EnesAyaz/WPTMotor/Thesis/Visio/chapter-3/MotorDrive.pptx

Drive

Sensor

Electrical
Source

Power
Converter

Controller

Load

## Slide 2

Motor Drive

Measurement Unit

DC
Source

Converter
(DC/DC) (DC/AC)

Controller

Load

## Slide 3

+

DC

DC/DC
Converter

ωref

+

Speed Controller

+

Current Controller

D

Load

IA

ω

+-

## Slide 4

Voltage
Source

DC/DC
Converter

ωref

+

Speed Controller

+

Current Controller

D

Load

IA

ω

## Slide 5

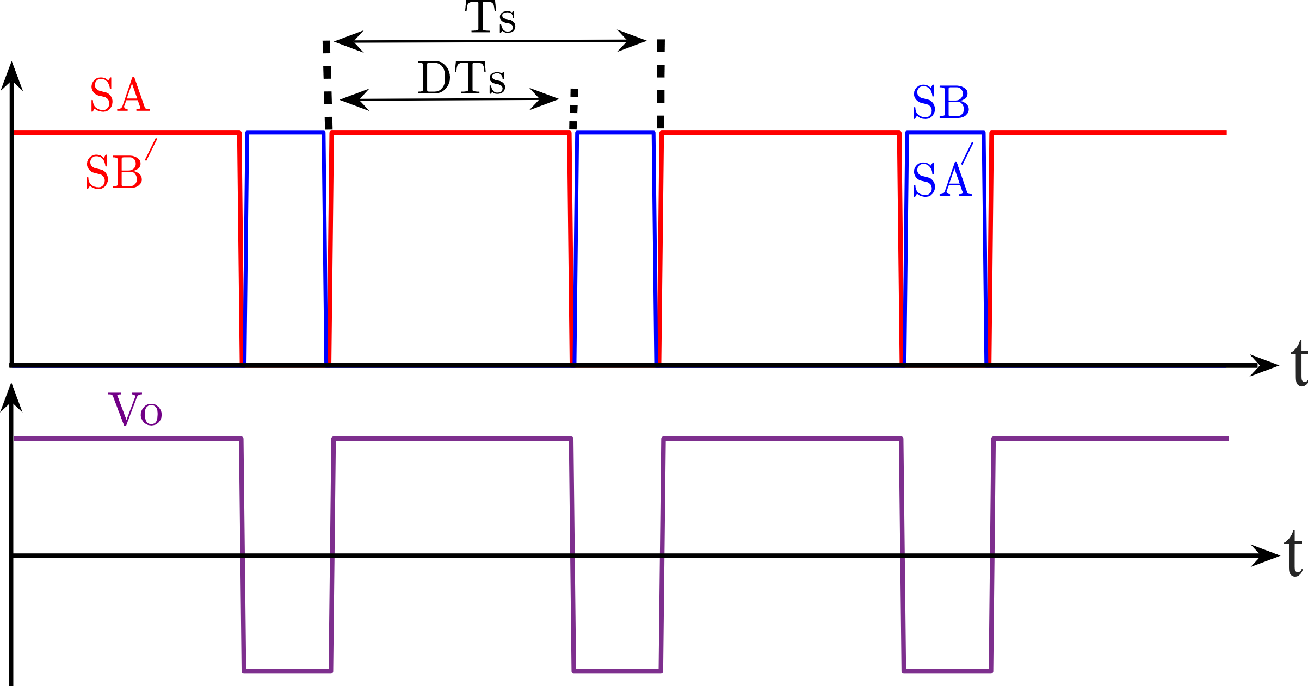
[picture p9: figure]

## Slide 6

Idref

+

Iqref

DC

DC/AC
Converter

ωeref

+

Speed Controller

+

Current Controller

Modulator

Load

Id

Iq

abc/dq

Ia

Ib

d/dt

Ic

ωe

θe

p

θm

## Slide 7

Idref

+

Iqref

Voltage
Source

ωeref

+

Speed Controller

+

Current Controller

Modulator

DC/AC
Converter

Load

Id

Iq

abc/dq

Ia

Ib

d/dt

Ic

ωe

θe

p

θm

## Slide 8

Constant T

T

Constant P

P

ωbase

ωmax

[rad/sec]

## Slide 9

T

T

Constant T

Constant P

P

ωs

[rad/sec]

## Slide 10

T

T

Constant T

Constant P

Increasing ωs

P

[rad/sec]

## Slide 11

[kW]

[kHz]

## Slide 12

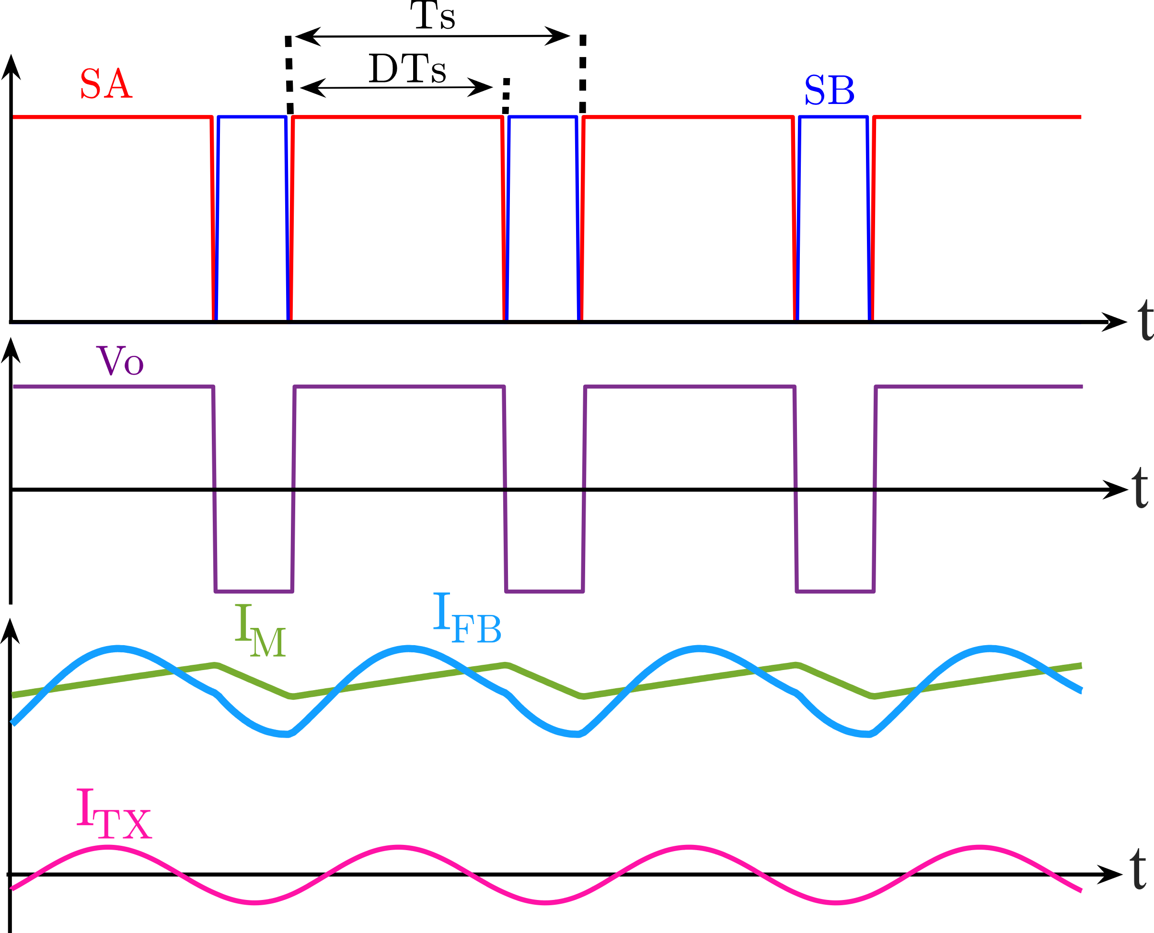
[picture p10: figure]

Switching
States

Output Voltage

Currents
