EnesAyaz/WPTMotor/Monthly-Presentation/2023.01.09.pptx

A set of Wireless and Wired Power Transfer Systems
Studies

Enes Ayaz
10/01/2023

## Previously on the 30-min Presentation

Motor drives have more than 2 wires
Conventional WPT systems have 2 wires input

Multi-phase WPT systems

Motivations:
1. To increase DC-link utilization rate
2. To increase power
3. To break the restrictions

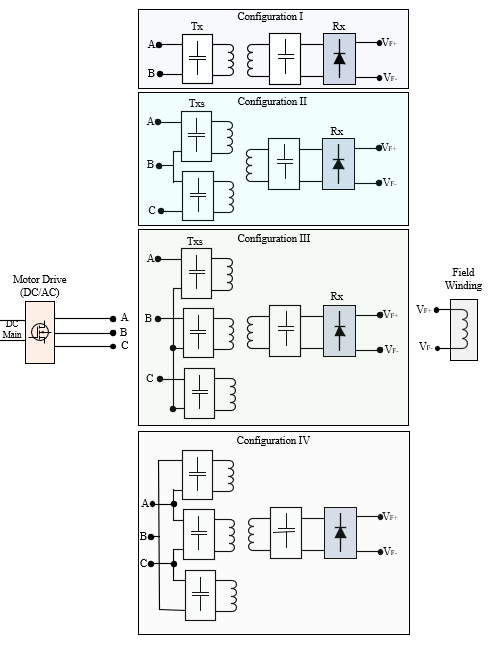
[picture p46: figure]

Notes: The WPT system is connected between phase-A and phase B.

By carrier phase shift to phase B, we achieve this contour of the magnitude of the switching frequency.

We can observe that we can have a constant gain for any modulation.

The constant gain is between 0.25 and 0.45 over a DC-link voltage.

The control diagram is shown.

We adjust the carrier phase shift according to modulation to control the WPT power.

## Future Works

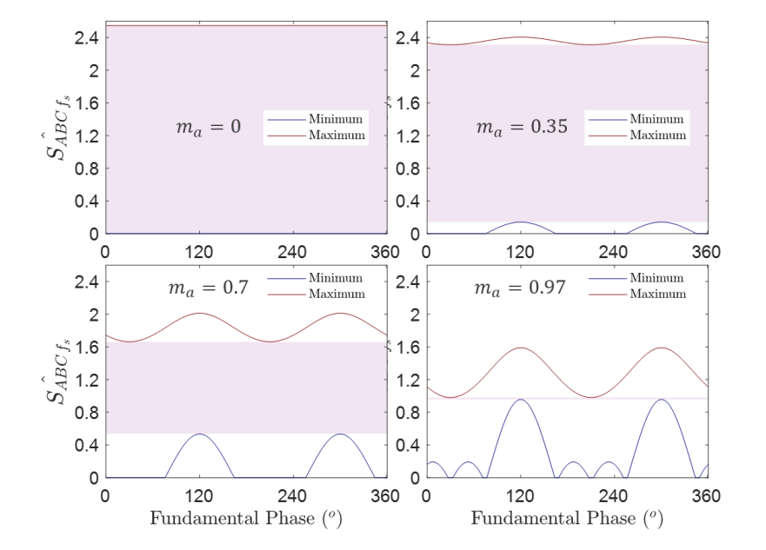
[picture p47: figure]
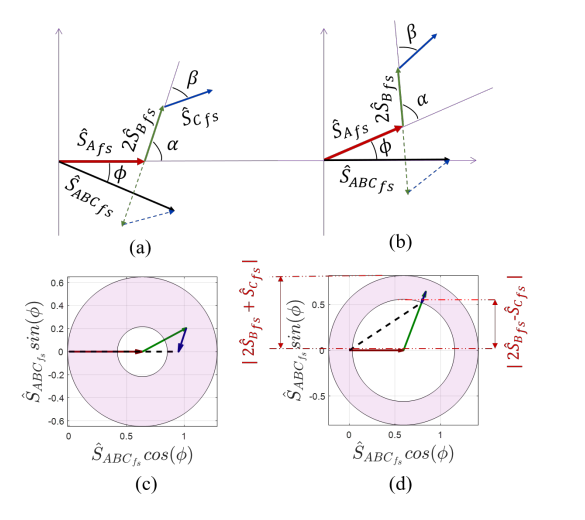
[picture p48: figure]

Notes: The WPT system is connected between phase-A and phase B.

By carrier phase shift to phase B, we achieve this contour of the magnitude of the switching frequency.

We can observe that we can have a constant gain for any modulation.

The constant gain is between 0.25 and 0.45 over a DC-link voltage.

The control diagram is shown.

We adjust the carrier phase shift according to modulation to control the WPT power.

## Challenge- Calculation Burden!

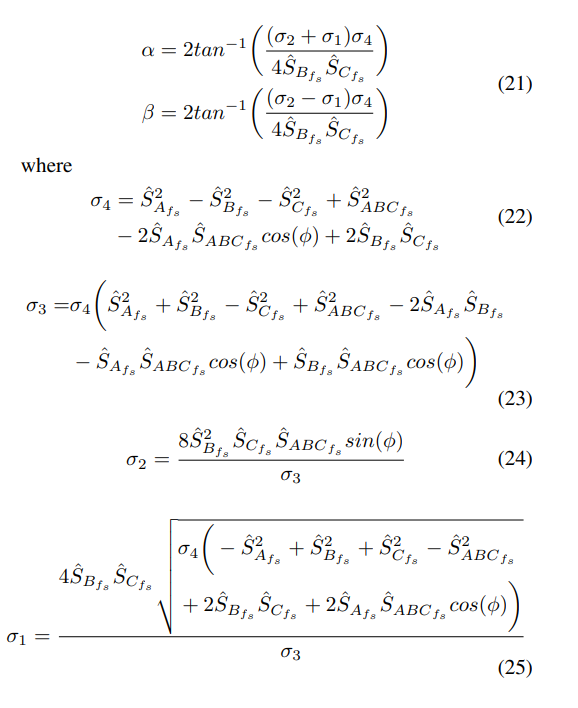
[picture p49: figure]
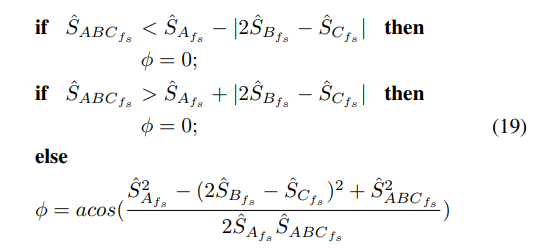
[picture p50: figure]

Notes: The WPT system is connected between phase-A and phase B.

By carrier phase shift to phase B, we achieve this contour of the magnitude of the switching frequency.

We can observe that we can have a constant gain for any modulation.

The constant gain is between 0.25 and 0.45 over a DC-link voltage.

The control diagram is shown.

We adjust the carrier phase shift according to modulation to control the WPT power.

## Variable Carrier Phase Shift Method for Integrated Contactless Field Excitation System of Electrically Excited Synchronous Motors

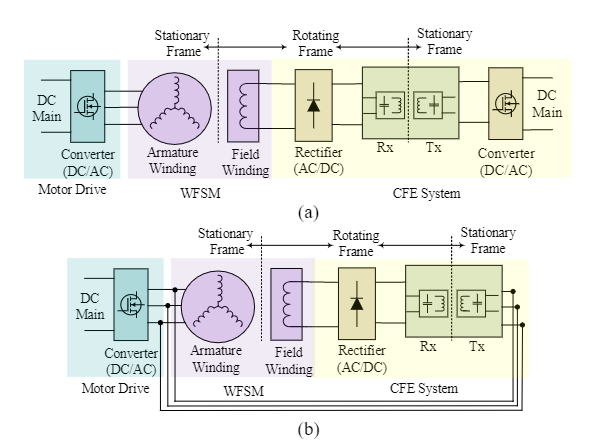
[picture p51: figure]

The circuit diagram of a conventional and proposed CFE based on a WPT system for EESMs.
a) The conventional system. b) The proposed system.

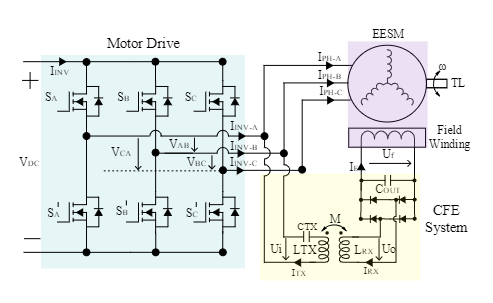
[picture p52: figure]

The circuit diagram of the proposed system

Notes: The WPT system is connected between phase-A and phase B.

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

We can observe that we can have a constant gain for any modulation.

The constant gain is between 0.25 and 0.45 over a DC-link voltage.

The control diagram is shown.

We adjust the carrier phase shift according to modulation to control the WPT power.

## Variable Carrier Phase Shift- Time Domain Analysis

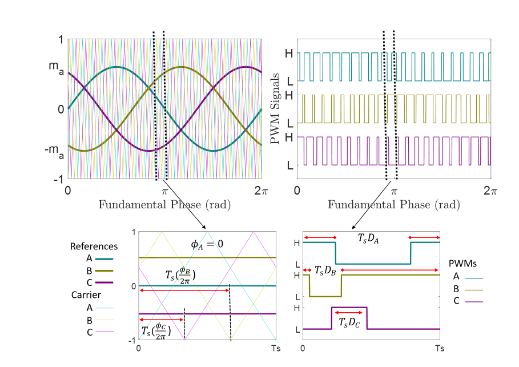
[picture p53: figure]
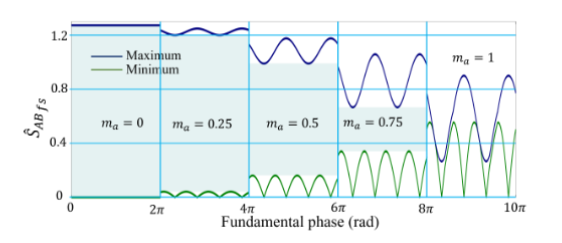
[picture p54: figure]
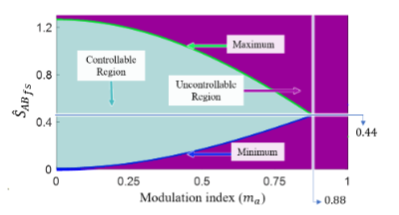
[picture p55: figure]
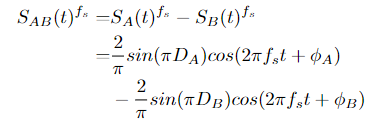
[picture p56: figure]

## Multifrequency IPT Systems

Standards:
- Wireless Power Consortium (WPC)
- Power Matters Alliance (PMA)
- Alliance for Wireless Power (A4WP)

100 - 205/300 kHz for magnetic resonant and induction technology for mobile devices; WPT systems for consumer devices, power transfer typically < 200 W; plan to be used worldwide

6765 - 6795 kHz for magnetic resonant technology for mobile devices; WPT systems for consumer devices, power transfer typically < 30 W; plan to be used.

300 - 500 kHz: WPT systems for consumer devices, power transfer typically < 5 W; plan to be used for smaller devices.

900 - 1 000 kHz: WPT systems for consumer devices, power transfer typically < 5 W; plan to be used for smaller devices.

Motivations:
1. To Increase power
2. To reduce switching components
3. To increase DC-link utilization rate
4. To provide operation for more than one standards
Some Topologies:
1. Multi-converter and multi-resonant
2. Single-converter and multi-resonant
3. Single-converter and multi-load

Notes: The WPT system is connected between phase-A and phase B.

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

We can observe that we can have a constant gain for any modulation.

The constant gain is between 0.25 and 0.45 over a DC-link voltage.

The control diagram is shown.

We adjust the carrier phase shift according to modulation to control the WPT power.

## Narrowband Concurrent Wireless Power Transfer (For use of single standard range)

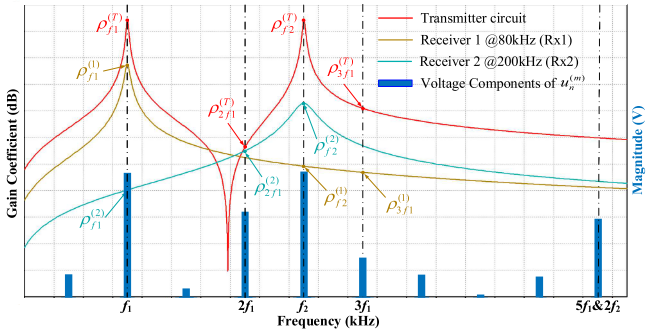
[picture p57: figure]
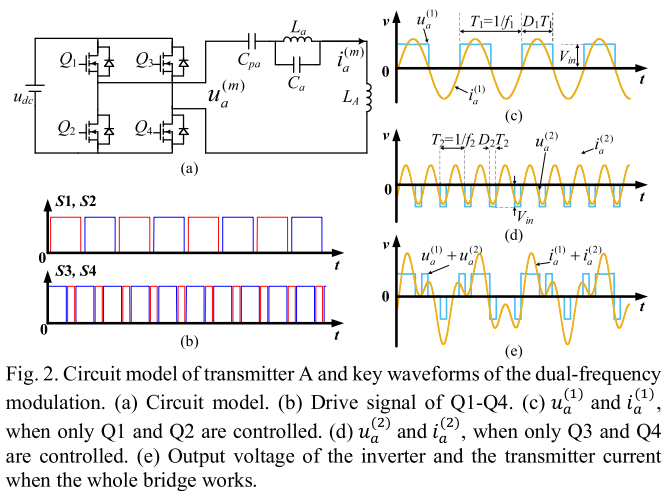
[picture p58: figure]

A Dual-Frequency Three-Dimensional WPT System with Directional Power Transfer
Capability at Two Separately Regulated Outputs

Notes: The WPT system is connected between phase-A and phase B.

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

We can observe that we can have a constant gain for any modulation.

The constant gain is between 0.25 and 0.45 over a DC-link voltage.

The control diagram is shown.

We adjust the carrier phase shift according to modulation to control the WPT power.

## Narrowband Concurrent Wireless Power Transfer (For use of single standard range)

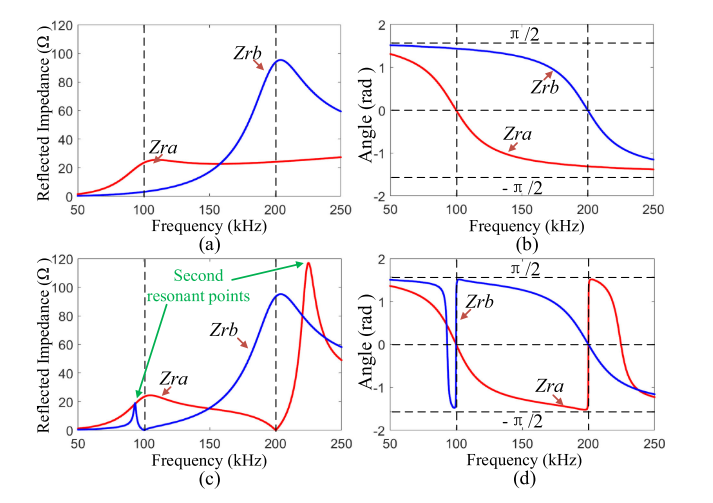
[picture p59: figure]
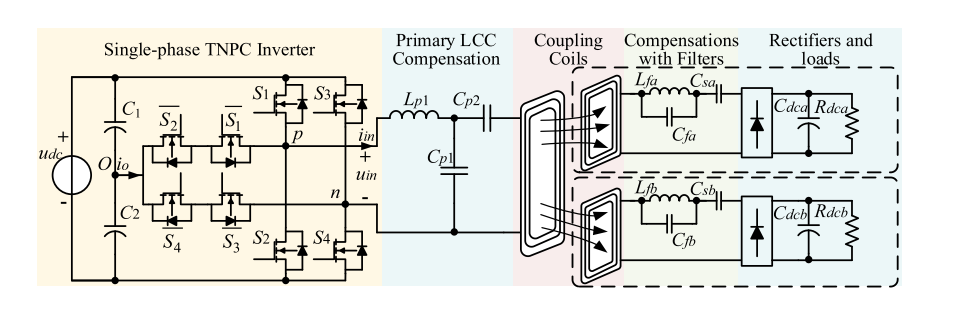
[picture p60: figure]

Design and Control of a Decoupled Multichannel Wireless Power Transfer System Based on Multilevel Inverters

## Narrowband Concurrent Wireless Power Transfer

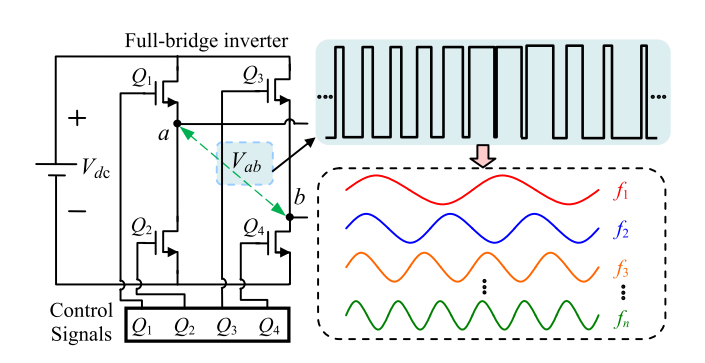
[picture p61: figure]

Multi-Frequency Multi-Amplitude Superposition Modulation Method With Phase Shift Optimization for Single Inverter of Wireless Power Transfer System

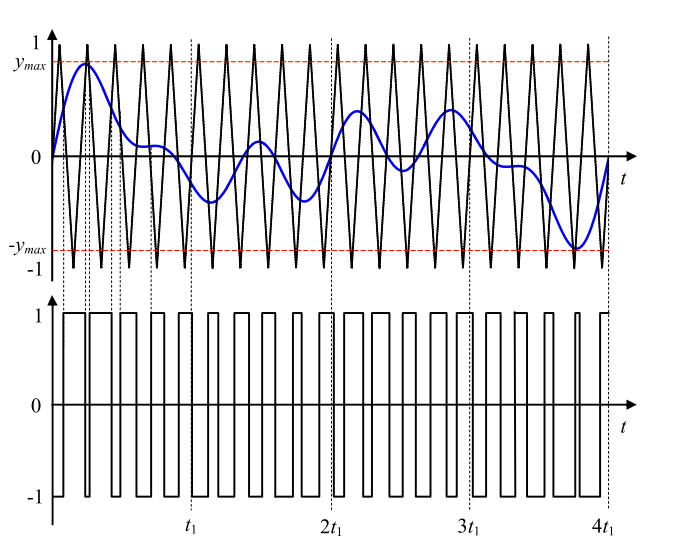
[picture p62: figure]

## Wideband Concurrent Wireless Power Transfer

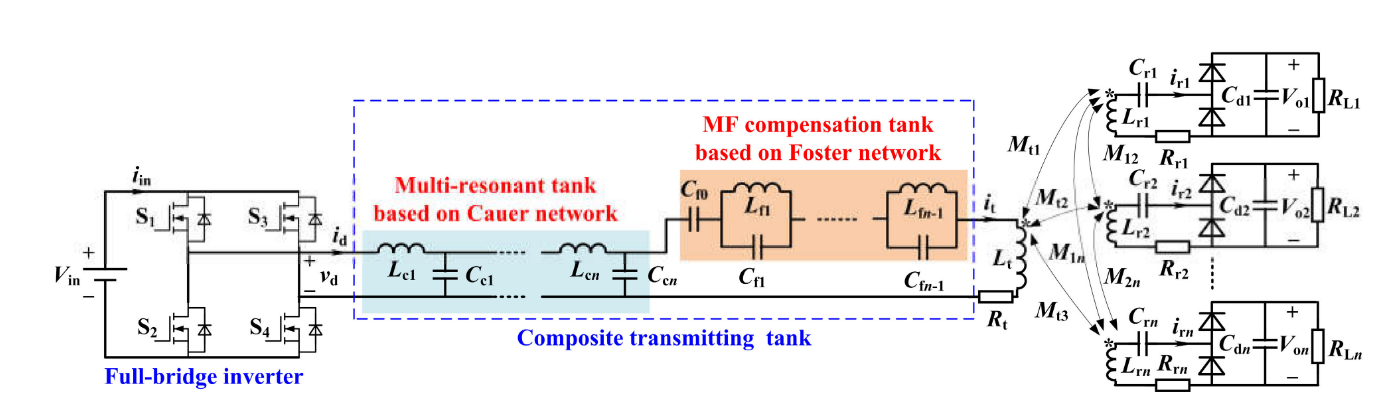
[picture p63: figure]

Multi-Frequency Multi-Amplitude Superposition Modulation Method With Phase Shift Optimization for Single Inverter of Wireless Power Transfer System

## Narrowband / Wideband Concurrent Wireless Power Transfer

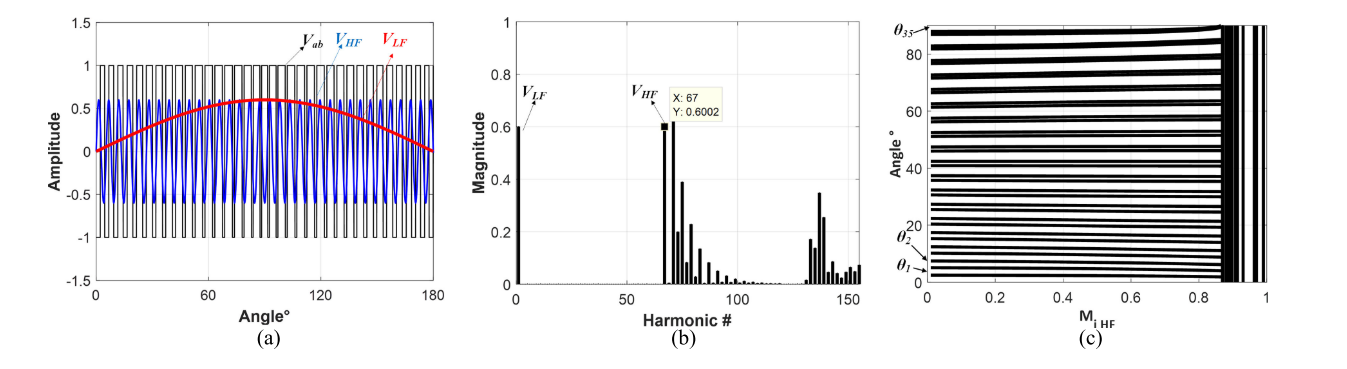
[picture p64: figure]
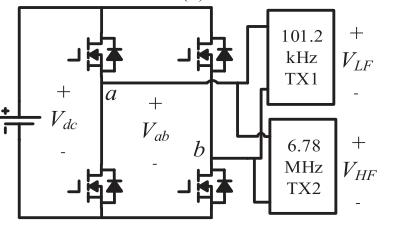
[picture p65: figure]
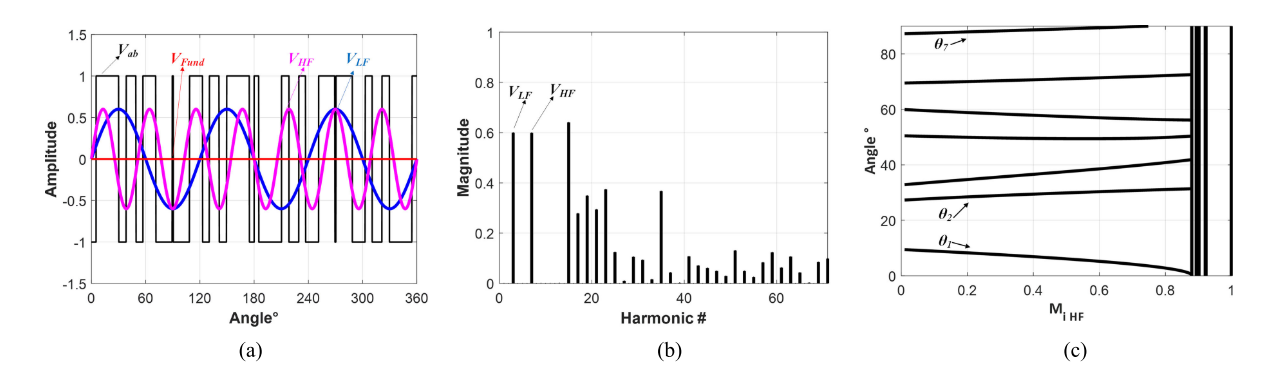
[picture p66: figure]

GaN-Based Dual-Mode Wireless Power Transfer Using Multifrequency Programmed Pulse Width Modulation

## Narrowband and Wideband Concurrent Wireless Power Transfer using a Single Transmitter

SPWM

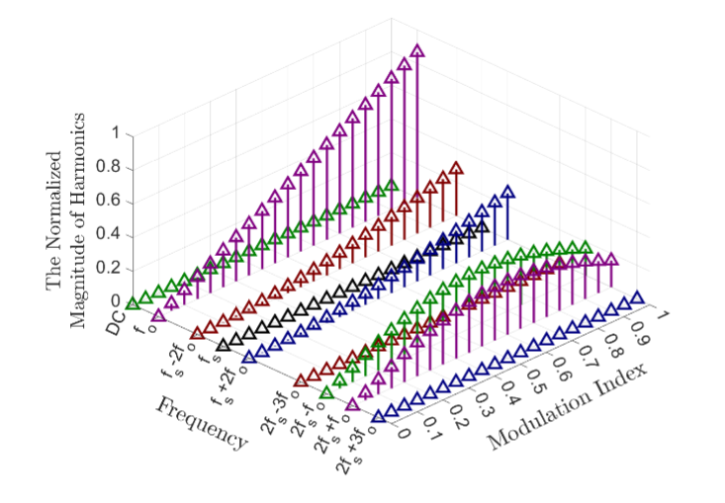
[picture p67: figure]
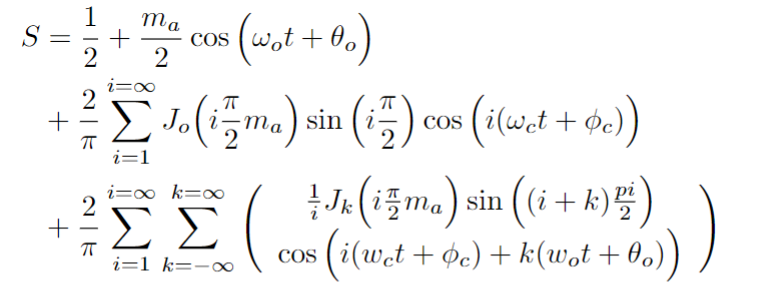
[picture p68: figure]

Notes: The WPT system is connected between phase-A and phase B.

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

We can observe that we can have a constant gain for any modulation.

The constant gain is between 0.25 and 0.45 over a DC-link voltage.

The control diagram is shown.

We adjust the carrier phase shift according to modulation to control the WPT power.

## Slide 14

Wideband Concurrent Wireless Power

f_(sh) =6980 kHz

f_(sl) =6580 kHz

f_(sw) =6780 kHz

Control parameters :
- Modulation index
- Carrier phase shift

f_o =100 kHz

f_0

f_(sl)

f_(sw)

f_(sh)

V_(f_0) =m_a

V_(f_(sw)) =2/πJ_o ((m_a π)/2)√(1−cos⁡(Δφ_(carrier) ))

## Slide 15

Narrowband Concurrent Wireless Power

f_o =120 kHz

f_o =80 kHz

f_o =160 kHz

Control parameters :
- Modulation index
- Carrier phase shift
- Fundamental phase shift

f_o =20 kHz

f_0

f_(sl)

f_(sw)

f_(sh)

f_0 =20 kHz

f_(sh) =160 kHz

V_(f_(sw)) =2/πJ_o ((m_a π)/2)√(1−cos⁡(Δφ_(carrier) ))

V_(f_(sl)) =2/πJ_o ((m_a π)/2)√(1−cos⁡(Δφ_(carrier) +Δφ_(fundamental) ))

f_(sl) =80 kHz

f_(sw) =120 kHz

## Slide 16

Additional Narrowband/Wideband Concurrent Wireless Power for HB configuration

f_0

f_(sw)

120
kHz

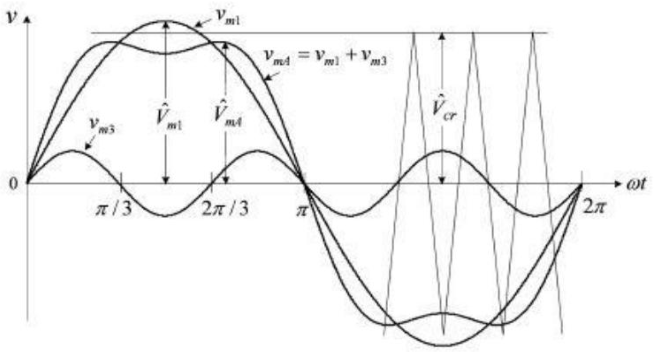
[picture p69: figure]

3f_0

60
kHz

f_(sl)

80
kHz

f_(sh)

160
kHz

20
kHz

Narrow Band

HB:
It is not possible to introduce carrier or fundamental phase shifts

Control parameters :
- Fundamental modulation index
- Harmonic modulation index (3rd , 5th , 7th )

100
kHz

300
kHz

6680
kHz

6780
kHz

6880
kHz

Wide Band

## Balancing with Soft-Magnetic Material based Inductors

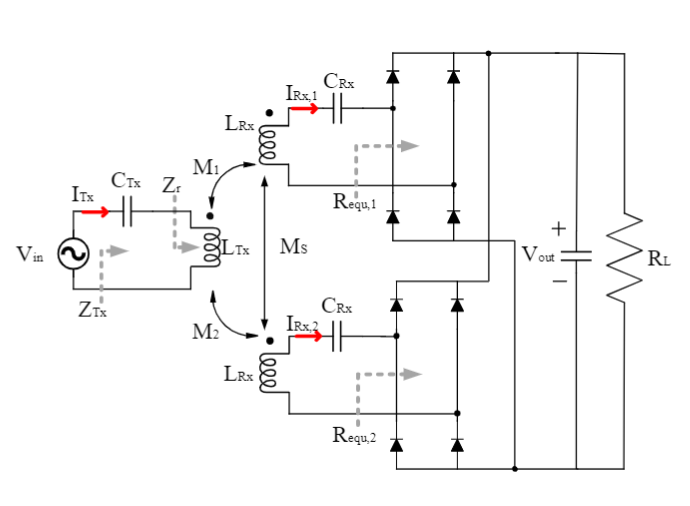
[picture p70: figure]
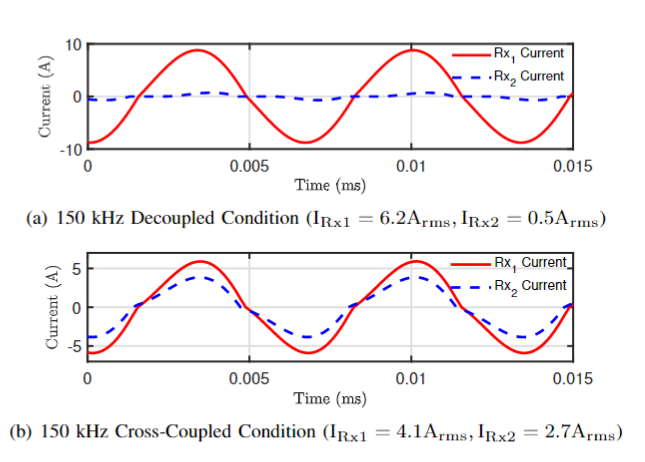
[picture p71: figure]
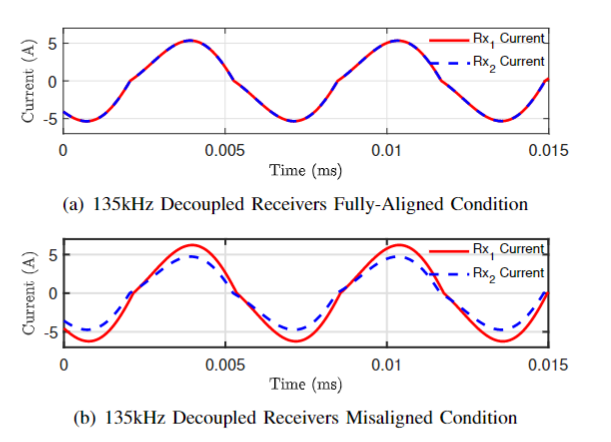
[picture p72: figure]

Intentional de-tuning of the receiver resonant tank for unbalanced modules

Notes: The WPT system is connected between phase-A and phase B.

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

We can observe that we can have a constant gain for any modulation.

The constant gain is between 0.25 and 0.45 over a DC-link voltage.

The control diagram is shown.

We adjust the carrier phase shift according to modulation to control the WPT power.

## Balancing with Soft-Magnetic Material based Inductors

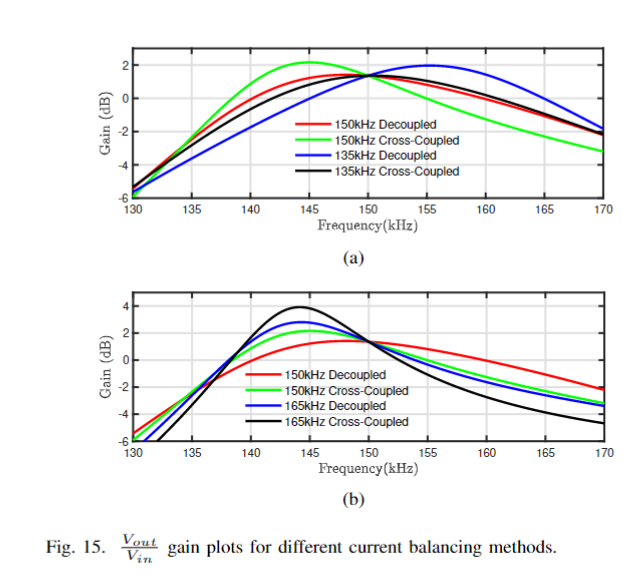
[picture p73: figure]
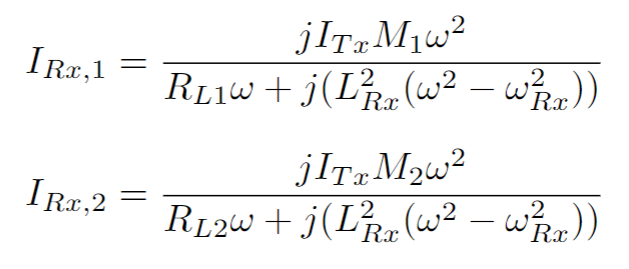
[picture p74: figure]

Notes: The WPT system is connected between phase-A and phase B.

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

We can observe that we can have a constant gain for any modulation.

The constant gain is between 0.25 and 0.45 over a DC-link voltage.

The control diagram is shown.

We adjust the carrier phase shift according to modulation to control the WPT power.

## Slide 19

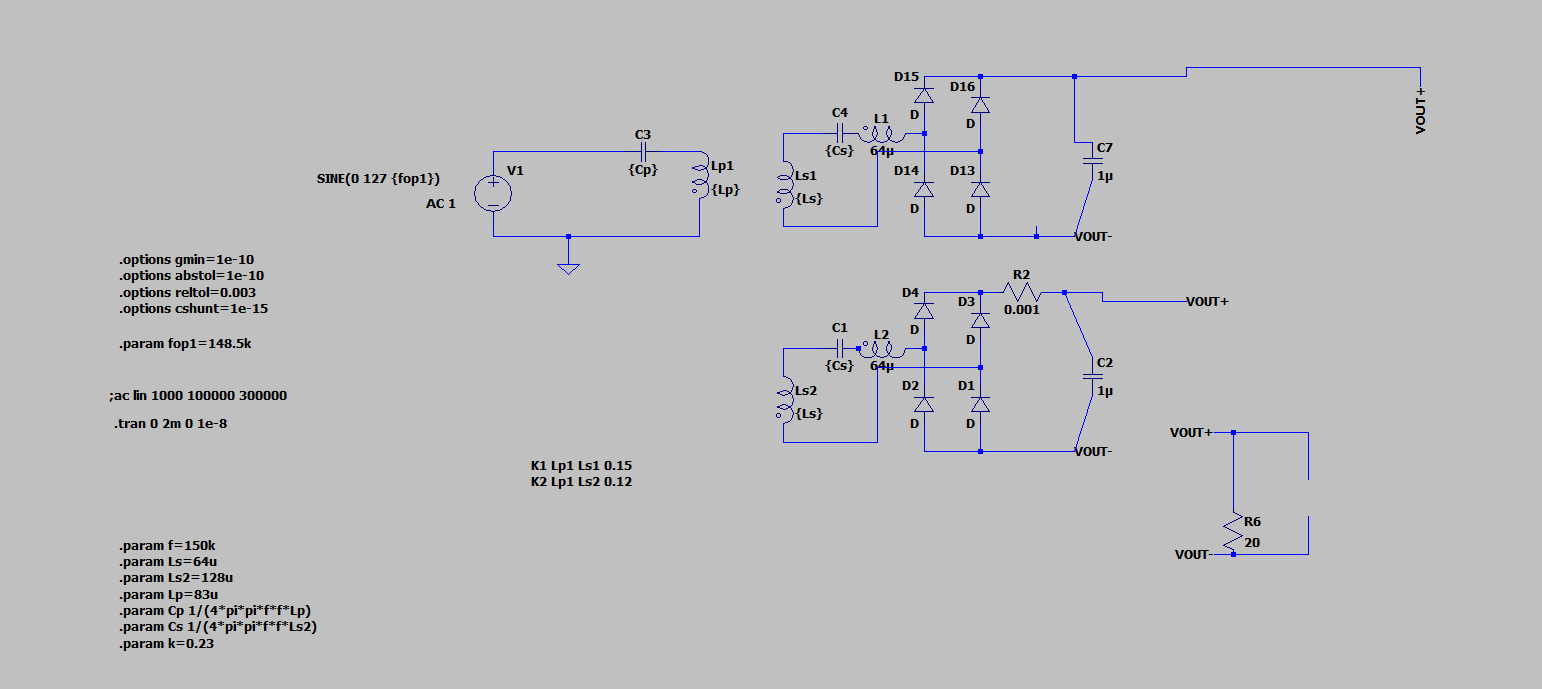
[picture p75: figure]
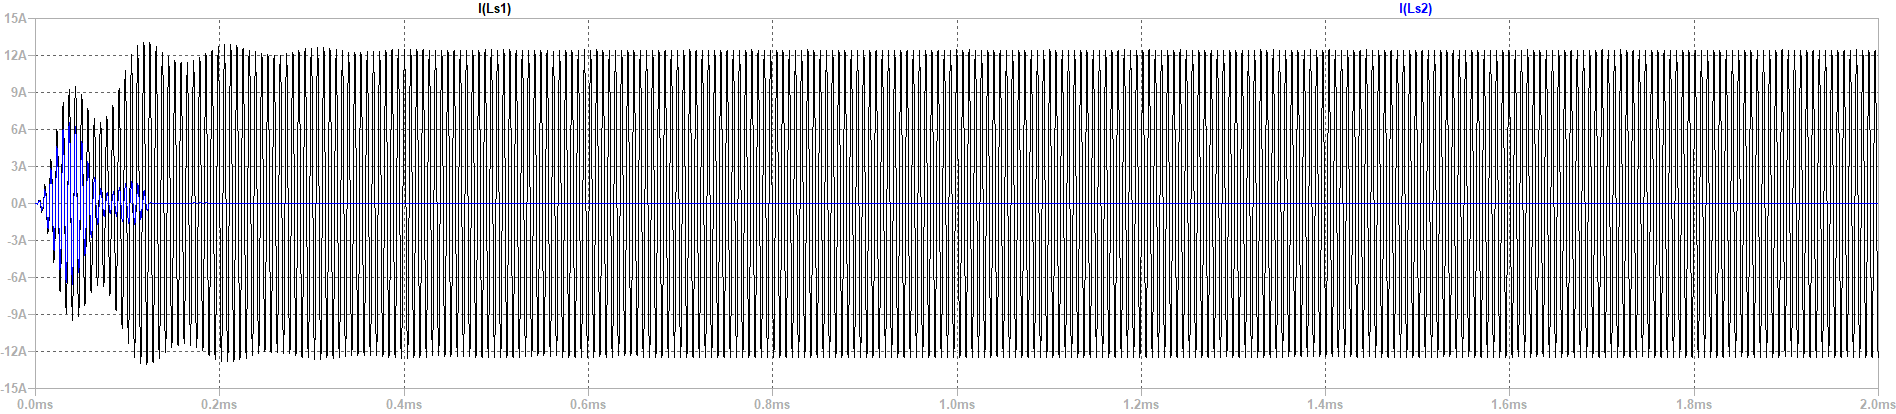
[picture p76: figure]

## Slide 20

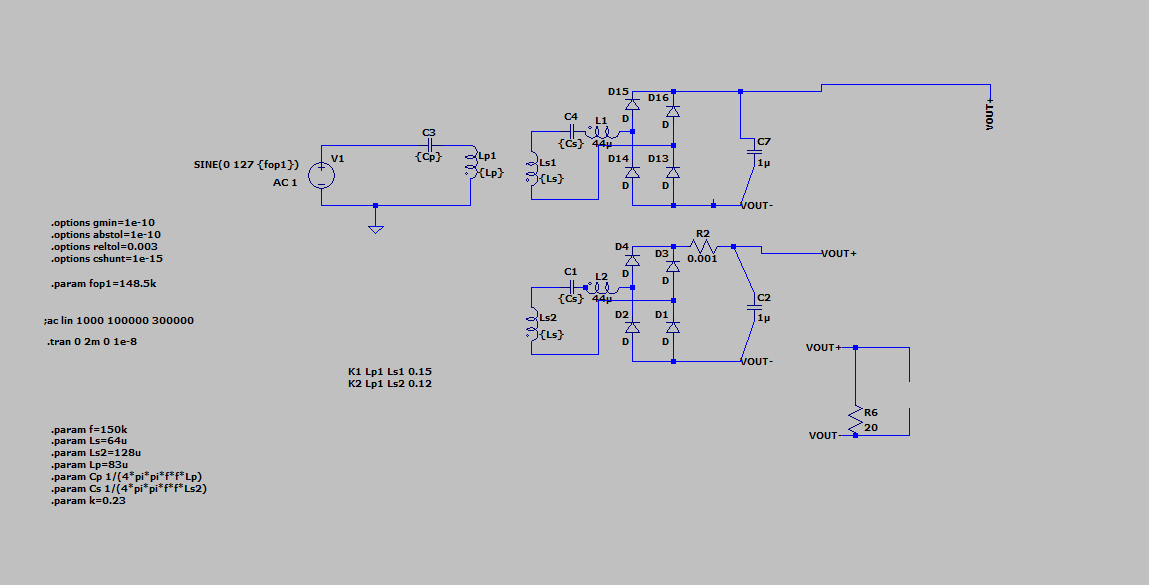
[picture p77: figure]
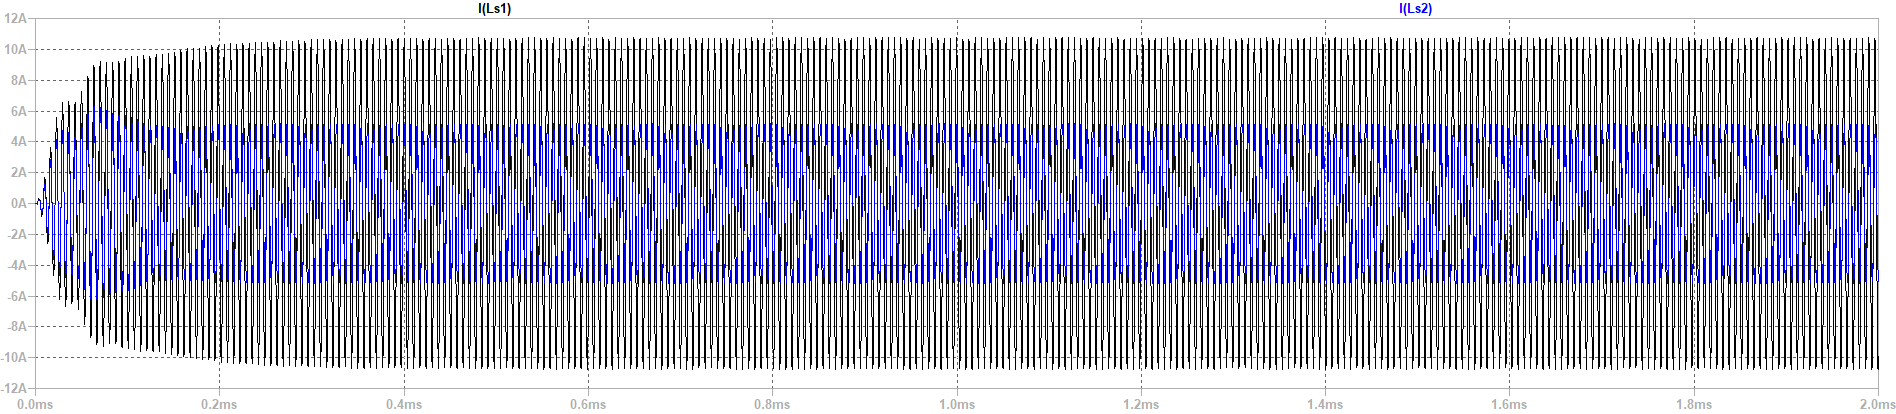
[picture p78: figure]

## Soft-Magnetic Material based Inductors

Requirement
  - Saturable Core
  - Excitation Circuit
  - Trap Filter

Cost, Size comparison

Notes: The WPT system is connected between phase-A and phase B.

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

We can observe that we can have a constant gain for any modulation.

The constant gain is between 0.25 and 0.45 over a DC-link voltage.

The control diagram is shown.

We adjust the carrier phase shift according to modulation to control the WPT power.

## Slide 22

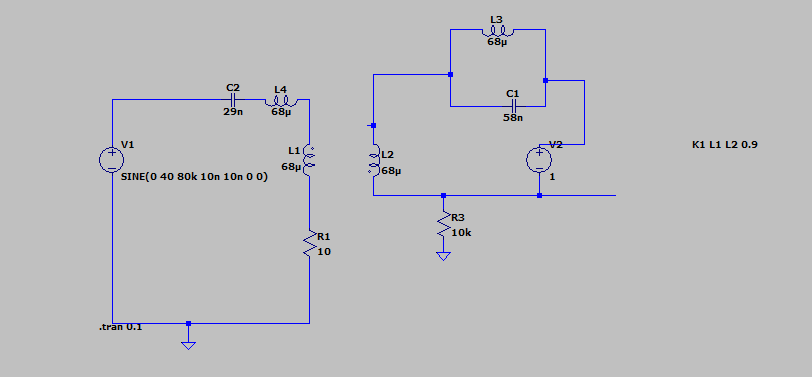
[picture p79: figure]
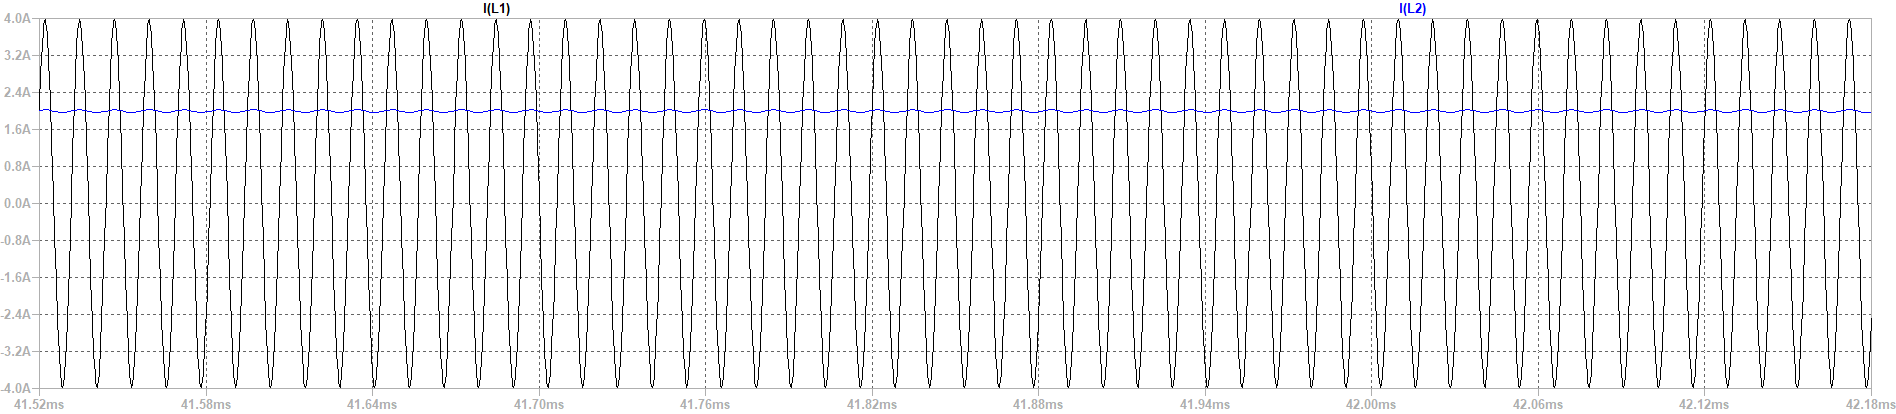
[picture p80: figure]

## Soft-Magnetic Material based Inductors without additional converter

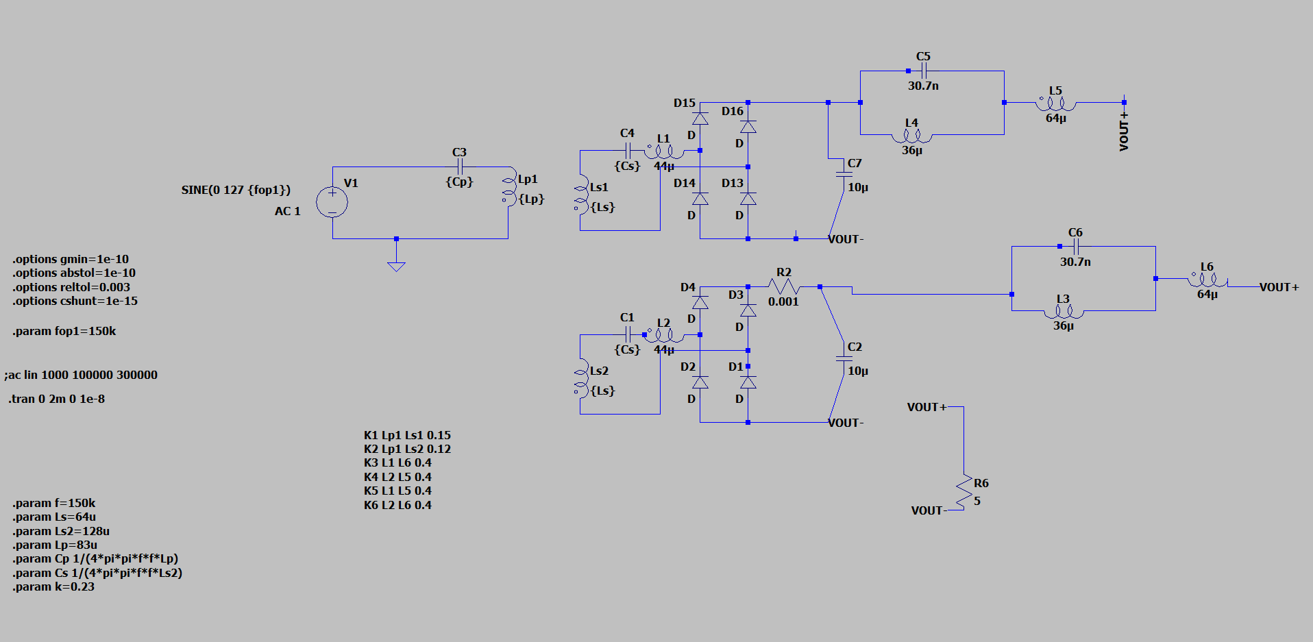
[picture p81: figure]

## Slide 24

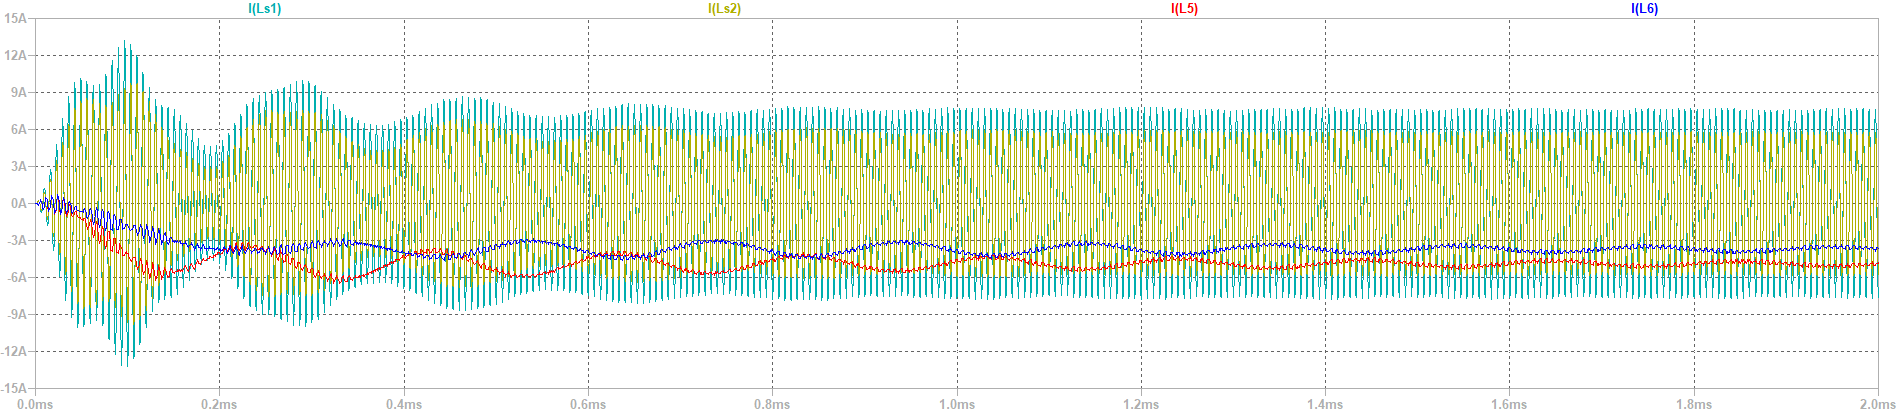
[picture p82: figure]

## Future Works

1- Synchronous motor journal : Written, but some experimental results are needed.
2- Preparing Wide/narrow bandgap wireless power transfer journal draft :
  - Literature Review (almost made)
  - Analytic modelling :
    - SPWM is ready
    - SPWM with additional harmonic is standing
  - Experimental setup:
    - Find Of-the-shelf inductance for the story
    - Power is about 30W to 5W
    - 6.78 MHz with 80kHz-200kHz or 900kHz-1000kHz with 80kHz-200KHz
3-Preparing Balancing journal draft ( we can focus TPEL special section about high power and misalingment)
- Discussions to get into focus
    - High power, series/parallel connection
    - Cost and feasibility

Notes: The WPT system is connected between phase-A and phase B.

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

We can observe that we can have a constant gain for any modulation.

The constant gain is between 0.25 and 0.45 over a DC-link voltage.

The control diagram is shown.

We adjust the carrier phase shift according to modulation to control the WPT power.

## Slide 26

Thanks!
