EnesAyaz/WPTMotor/Presentation/New Microsoft PowerPoint Presentation.pptx

Wireless Power Transfer Embedded in motor drives for contactless slip ring applications

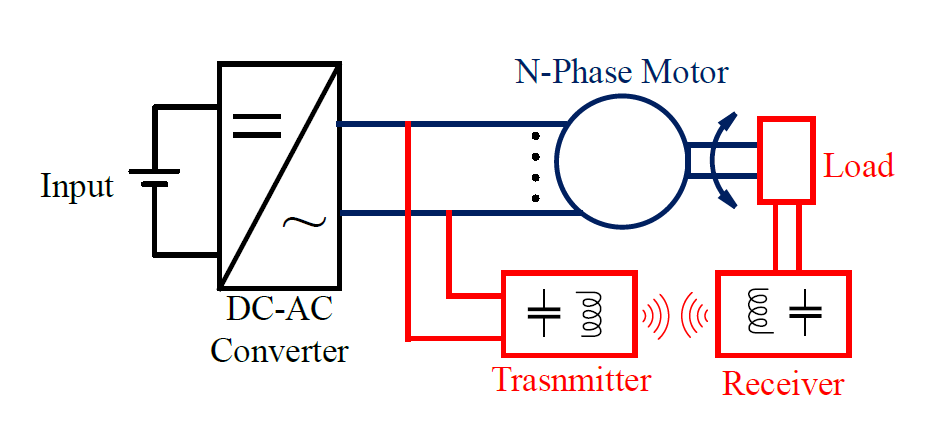
[picture p83: figure]

## Slide 2

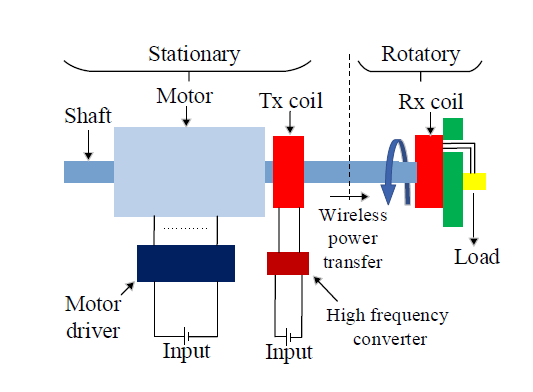
[picture p84: figure]
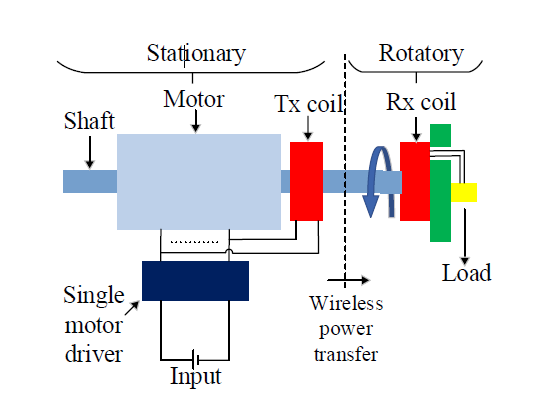
[picture p85: figure]

Advantages
- Aa
- Aaa
- Aaa
- Aaa
- aaa

Trade-offs
- Aa
- Aaa
- Aaa
- Aaa
- aaa

## Slide 3

Literature

Simultaneous
power transfer

1. Simultaneous Wireless Information and Power Transfer (SWIPT): Recent Advances and Future Challenges (2018)
2. Integrated Resonant Structure for Simultaneous Wireless Power Transfer and Data Telemetry(2012)
3. A Generalized Methodology to Generate, Amplify and Compensate Multi-Frequency Power for a Single-Inverter-Based MF-MR-S-WPT System(2020)
4. A Simultaneous Wireless Power and Data Transmission Method for Multi-Output WPT Systems: Analysis, Design, and Experimental Verification (2020)
5. Single-Inductor Multiple-Output (SIMO) Buck Hybrid Converter for Simultaneous Wireless and Wired Power Transfer(2020)
6. Cross Interference Minimization and Simultaneous Wireless Power Transfer to Multiple Frequency Loads Using Frequency Bifurcation Approach(2019)

Selective
Power Transfer

1. Selective Omnidirectional Magnetic Resonant Coupling Wireless Power Transfer With Multiple-Receiver System(2018)
2. Design and Analysis of Wireless Switched Reluctance Motor Drives(2019)
3. Frequency Splitting-Based Wireless Power Transfer and Simultaneous Propulsion Generation to Multiple Micro-Robots(2018)
4. Comparative Analysis of Frequency-Selective Wireless Power Transfer for Multiple-Rx Systems(2020)
5. A Frequency-Selective EMI Reduction Method for Tightly Coupled Wireless Power Transfer Systems Using Resonant Frequency Control of a Shielding Coil in Smartphone Application(2020)
6. Selective Wireless Power Transfer for Smart Power Distribution in a Miniature-Sized Multiple-Receiver System(2016)
7. A Multifrequency Superposition Methodology to Achieve High Efficiency and Targeted Power Distribution for a Multiload MCRWPT System(2018)
8. Cross Interference Minimization and Simultaneous Wireless Power Transfer to Multiple Frequency Loads Using Frequency Bifurcation Approach

Look at Mendeley : PowerLab/Enes/WPT-Motor

Slip-Ring Applications

1. A Primary-Side Control Method of Wireless Power Transfer for Motor Electric Excitation(2019)
2. Wireless DC Motor Drives with Selectability and Controllability(2017)
3. An Airborne Radar Power Supply With Contactless Transfer of Energy—Part I: Rotating Transformer (2007)
4. Aerodynamic Fluid Bearings for Translational and Rotating Capacitors in Noncontact Capacitive Power Transfer Systems(2014)
5. Synchronous Generator Brushless Field Excitation and Voltage Regulation via Capacitive Coupling Through Journal Bearings(2017)
6. Operation of an Electrical Excited Synchronous Machine by Contactless Energy Transfer to the Rotor(2018)
7. A Rotation-Lightweight Wireless Power Transfer System for Solar Wing Driving(2019)
8. Wireless Power Transfer for Smart Industrial and Home Applications(2019)

Single-Stage
Power Transfers

1. A High-Efficiency GaN-Based Single-Stage 6.78 MHz Transmitter for Wireless Power Transfer Applications(2019)
2. Cooperative Integration of RF Energy Harvesting and Dedicated WPT for Wireless Sensor Networks(2019)
3. A Three-Phase Single-Stage AC–DC Wireless-Power-Transfer Converter With Power Factor Correction and Bus Voltage Control(2020)
4. Individually Regulated Multiple-Output WPT System With a Single PWM and Single Transformer (2020)

## Slide 4
