EnesAyaz/WPTMotor/Presentation/2021.10.04.pptx

## Slide 2

## Slide 3

| Comments
[1] (2014) | Multiple frequency, Inverter losses and emitted field strength comparison Increasing power of load using 1st and 3rd harmonic Dual frequency system : cauer

## Slide 4

- [1] Multifrequency Inductive Power Transfer
