EnesAyaz/WPTMotor/Presentation/2021.03.14.pptx

Fundamental
Component

Bessel function ( 0 order)

Switching
Harmonics

Parameters:
M => modulation index
ω_o => output(fundamental) frequency
ω_c => carrier(switching) frequency
θ_o => output phase
θ_c => carrier phase

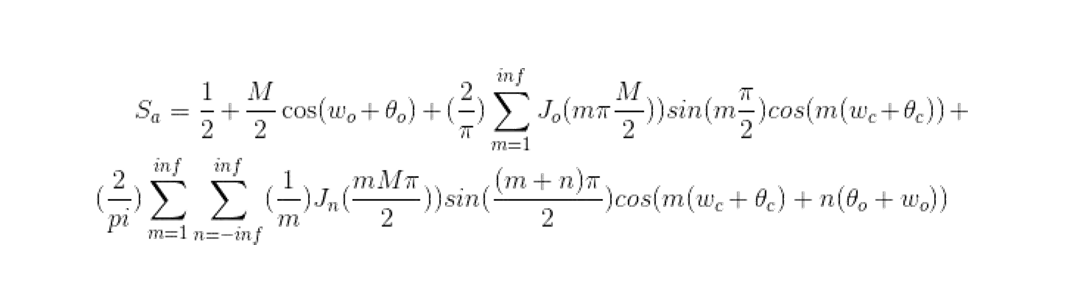
[picture p93: figure]

Side Band harmonics

Bessel function ( n^(th) order)

Deductions
- Fundamental component is independent from carrier(switching) frequency and phase
- There is no even harmonics of the switching and the sign of the odd harmonics is alternated.
- The switching harmonics are independent from fundamental frequency and phase.
- The side band harmonics are affected by all fundamental and carrier frequency and phases.

## Slide 2

Sequences of the Switching Harmonics and Side Bands

Frequency | Phase A | Phase B | Phase C
f_o | θ_o =0^o | θ_o =120^o | θ_o =−120^o
f_s −4f_o | 0^o | 240^o | 120^o
f_s −2f_o | 180^o | 300^o | 60^o
f_s | 0^o | 0^o | 0^o
f_s +2f_o | 180^o | 60^o | 300^o
f_s +4f_o | 0^o | 120^o | 240^o

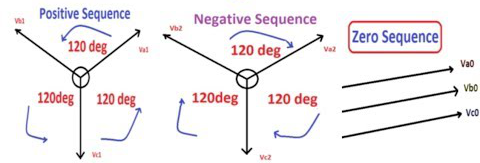
[picture p94: figure]
Positive sequence Negative sequence Zero sequence Symmetrical components in tamil - YouTube

If the fundamental is positive sequences

## Slide 3

Switching Harmonics

Max = 0.6366 (ma=0 for 1st)
Min = 0.3005 (ma=1 for 1st)

It is very promising if we think the duty cycle control of DC motor

## Slide 4

Side Band Harmonics

0.075

## Slide 5

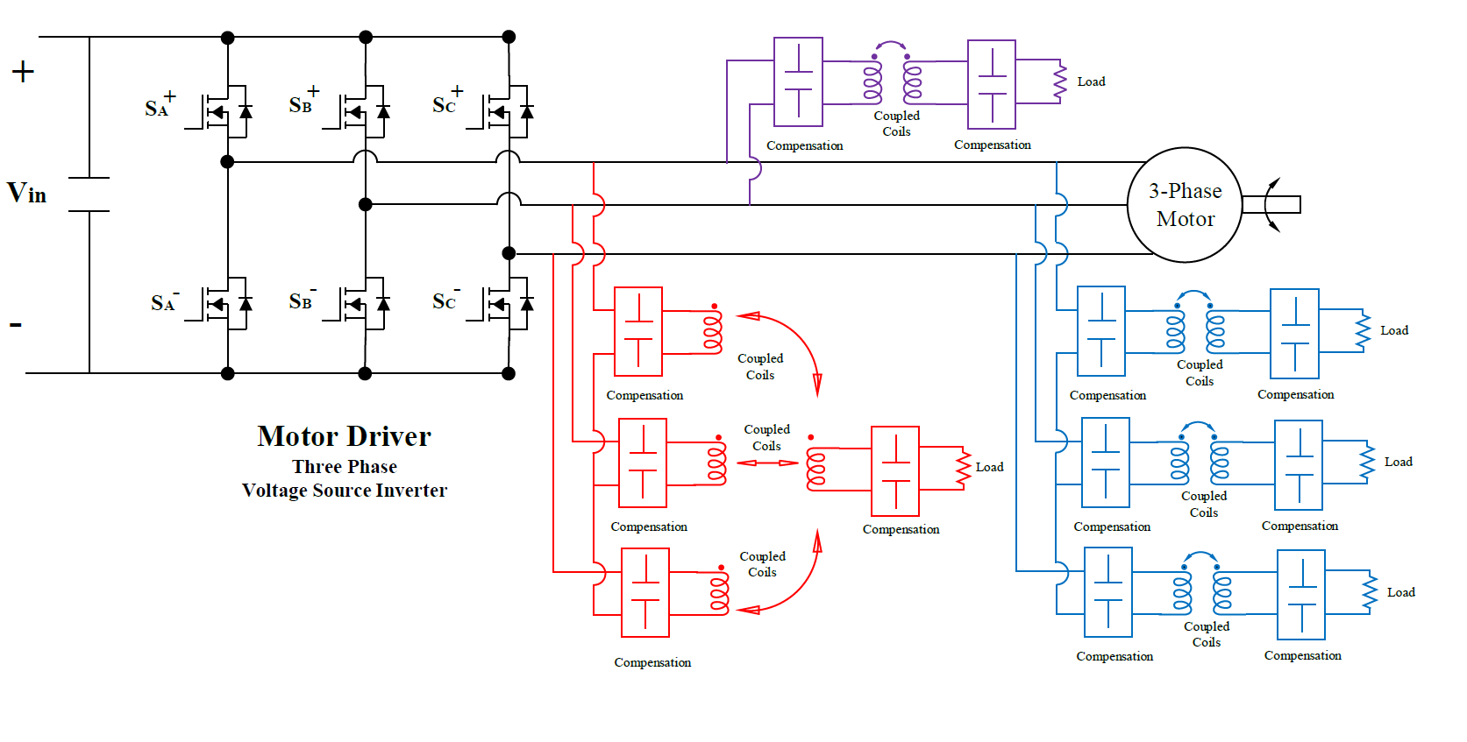
[picture p95: figure]

Single Leg having higher switching frequency

Removed side-bands (positive, negative sequences)

Having side-bands

## Slide 6

ma=0.5

ma=0.9

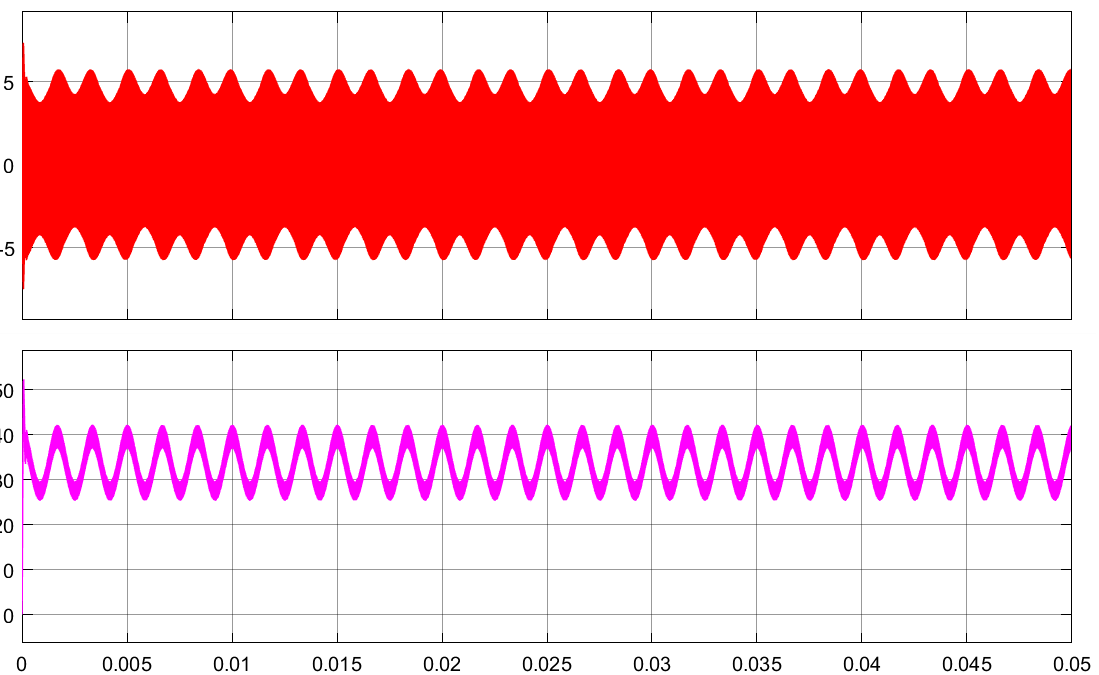
[picture p96: figure]
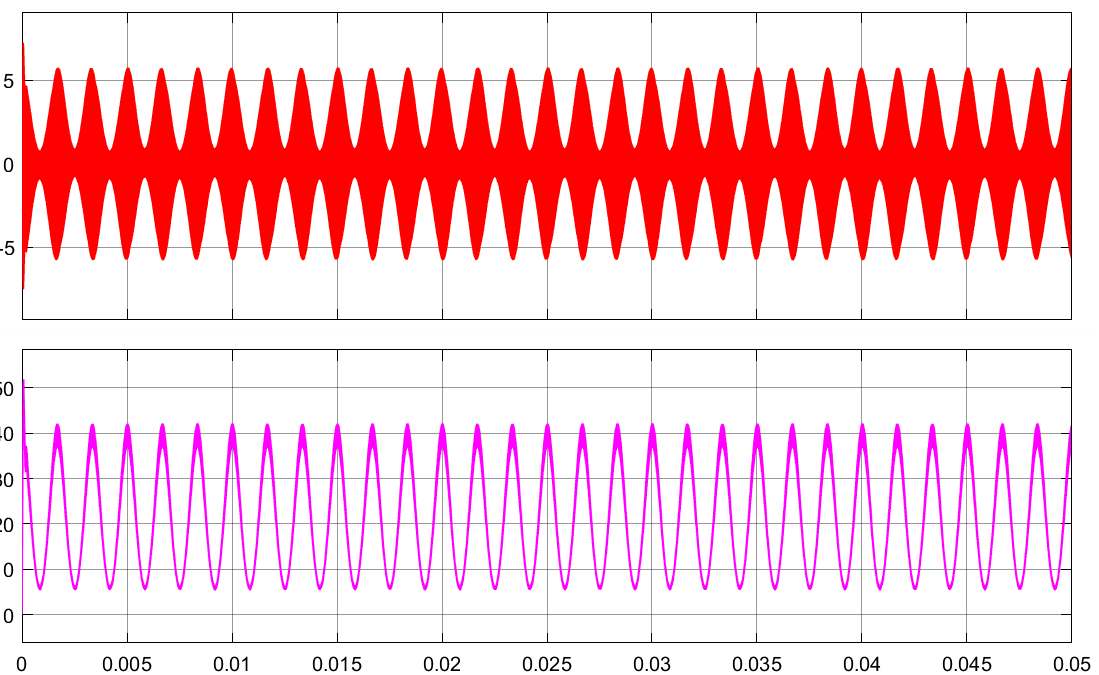
[picture p97: figure]

## Slide 7

Side-Bands create the envelopes

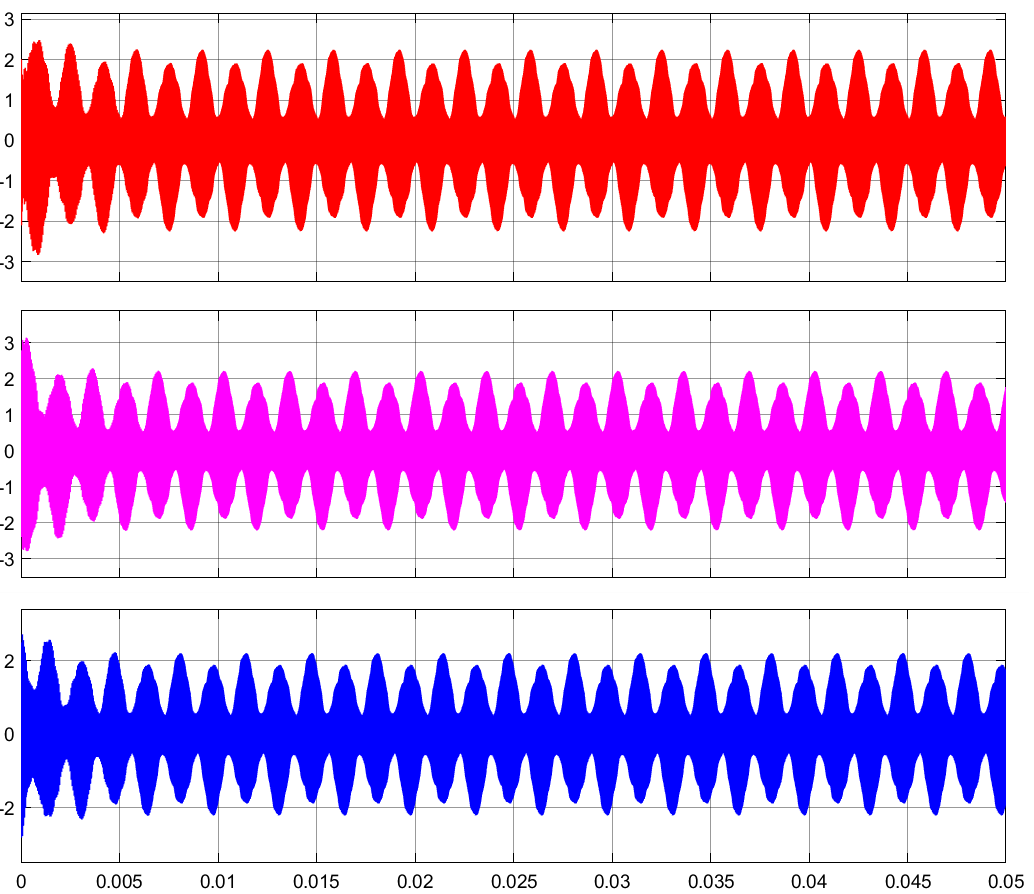
[picture p98: figure]
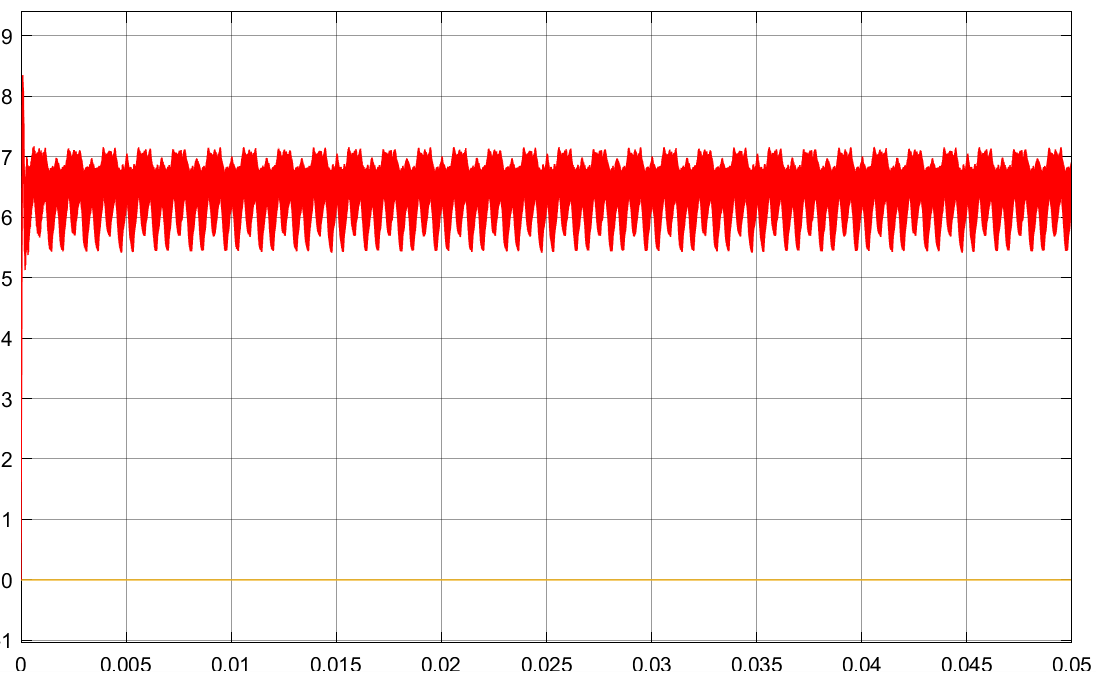
[picture p99: figure]

Tx Currents

Output has only switching harmonics

## Slide 8

Side-Bands create the envelopes

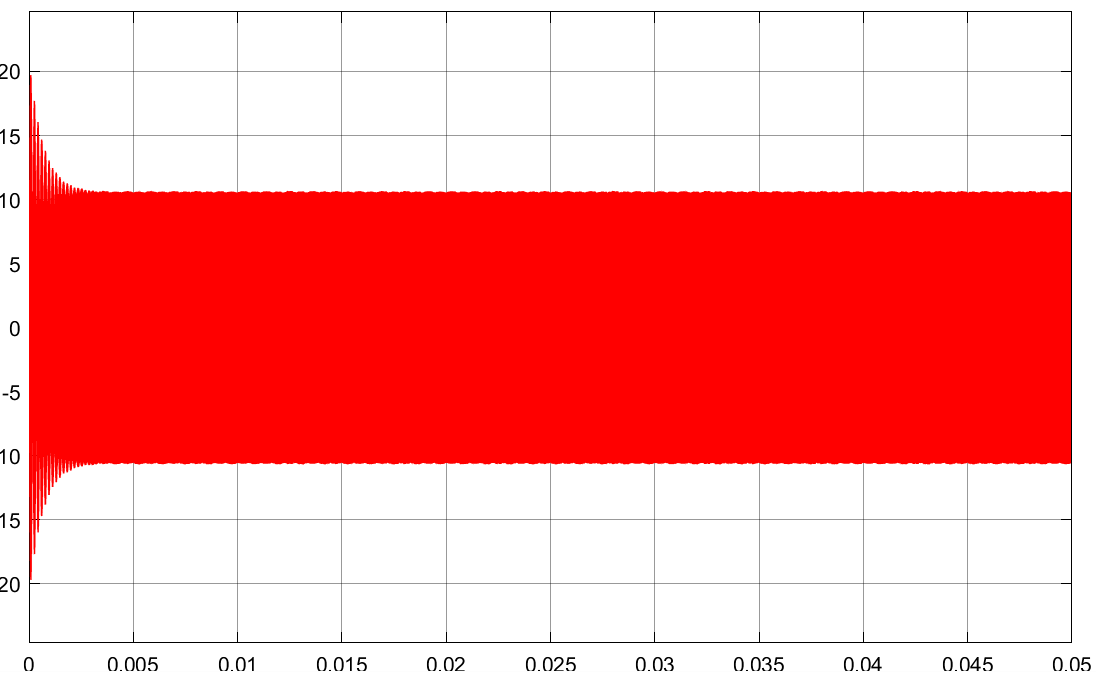
[picture p100: figure]
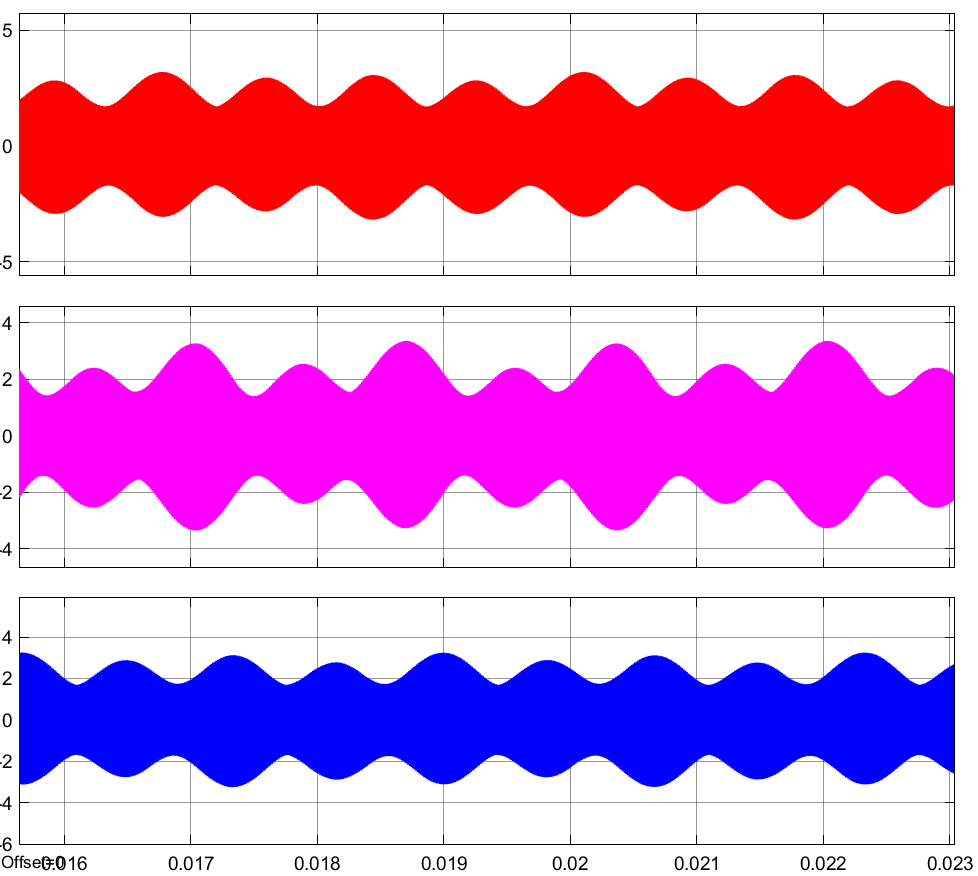
[picture p101: figure]

Output has only switching harmonics

Tx Currents
