EnesAyaz/WPTMotor/Presentation/2021.07.06.pptx

Fundamental
Component

Bessel function ( 0 order)

Switching
Harmonics

Parameters:
M => modulation index
ω_o => output(fundamental) frequency
ω_c => carrier(switching) frequency
θ_o => output phase
θ_c => carrier phase


Side Band harmonics

Bessel function ( n^(th) order)

Deductions
- Fundamental component is independent from carrier(switching) frequency and phase
- There is no even harmonics of the switching and the sign of the odd harmonics is alternated.
- The switching harmonics are independent from fundamental frequency and phase.
- The side band harmonics are affected by all fundamental and carrier frequency and phases.

## Slide 2

Sequences of the Switching Harmonics and Side Bands

Frequency | Phase A | Phase B | Phase C
f_o | θ_o =0^o | θ_o =120^o | θ_o =−120^o
f_s −4f_o | 0^o | 240^o | 120^o
f_s −2f_o | 180^o | 300^o | 60^o
f_s | 0^o | 0^o | 0^o
f_s +2f_o | 180^o | 60^o | 300^o
f_s +4f_o | 0^o | 120^o | 240^o

Positive sequence Negative sequence Zero sequence Symmetrical components in tamil - YouTube

If the fundamental is positive sequences

## Slide 3


Single Leg having higher switching frequency

Removed side-bands (positive, negative sequences)

Having side-bands

## Slide 4

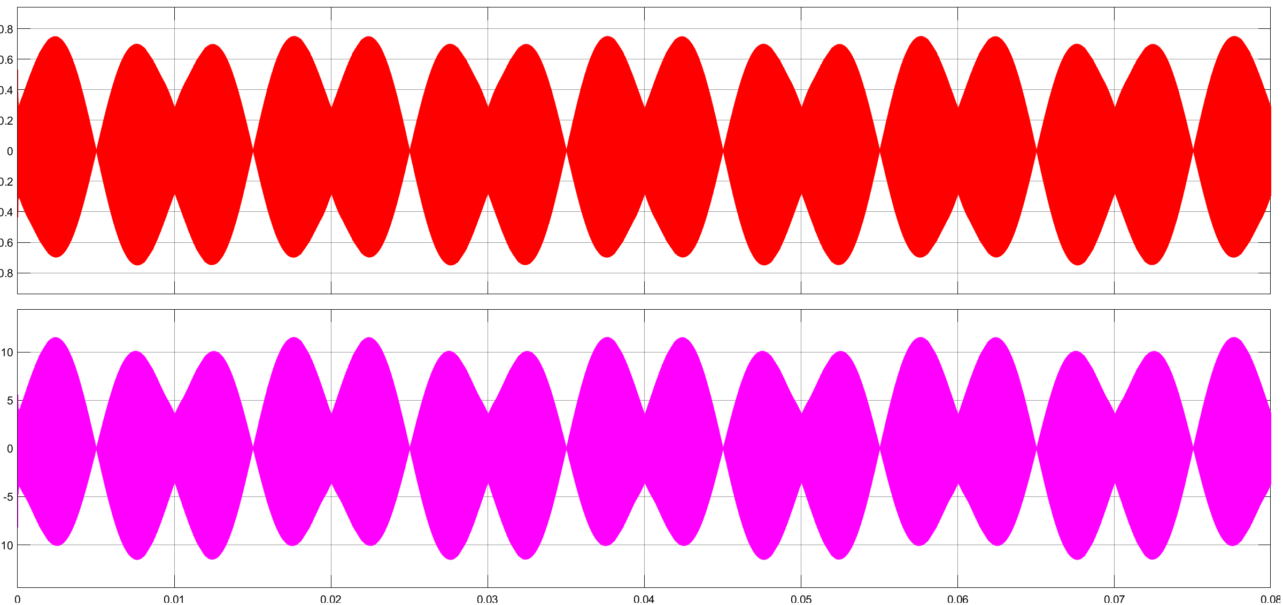
[picture p102: figure]
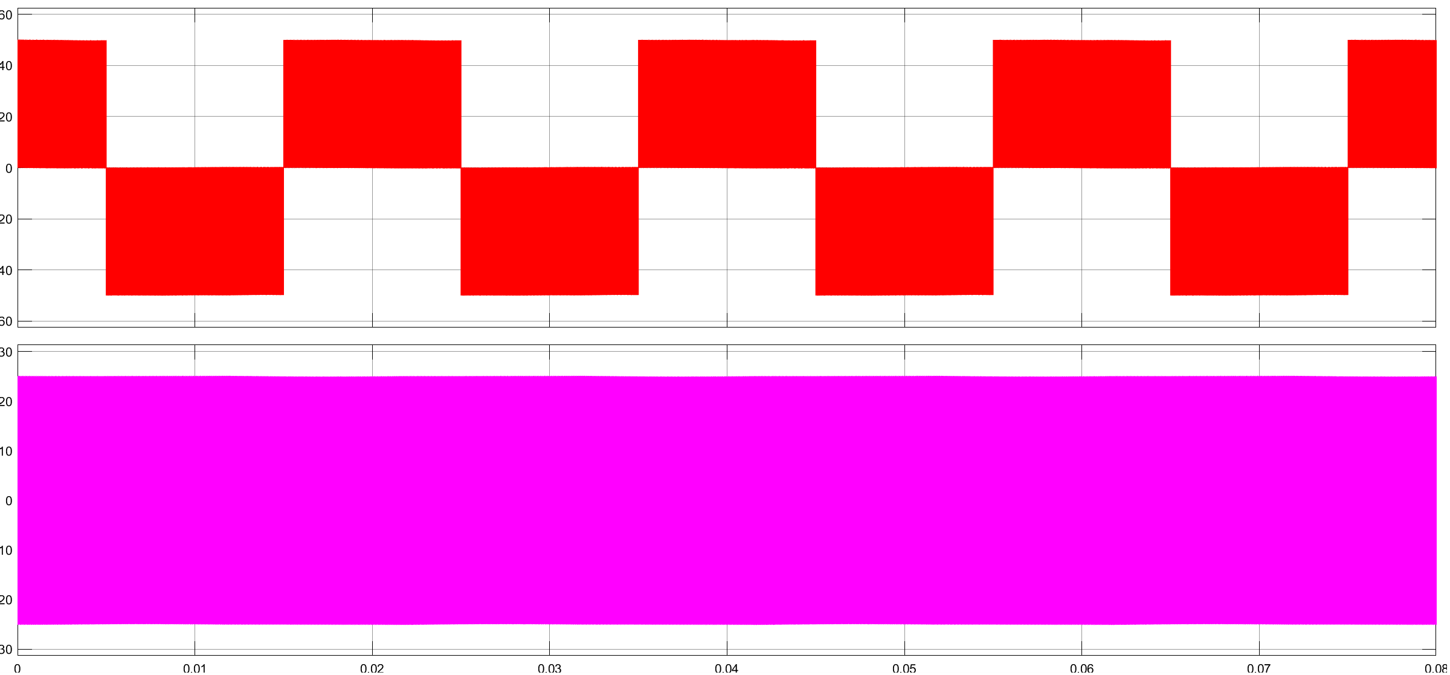
[picture p103: figure]

## Slide 5

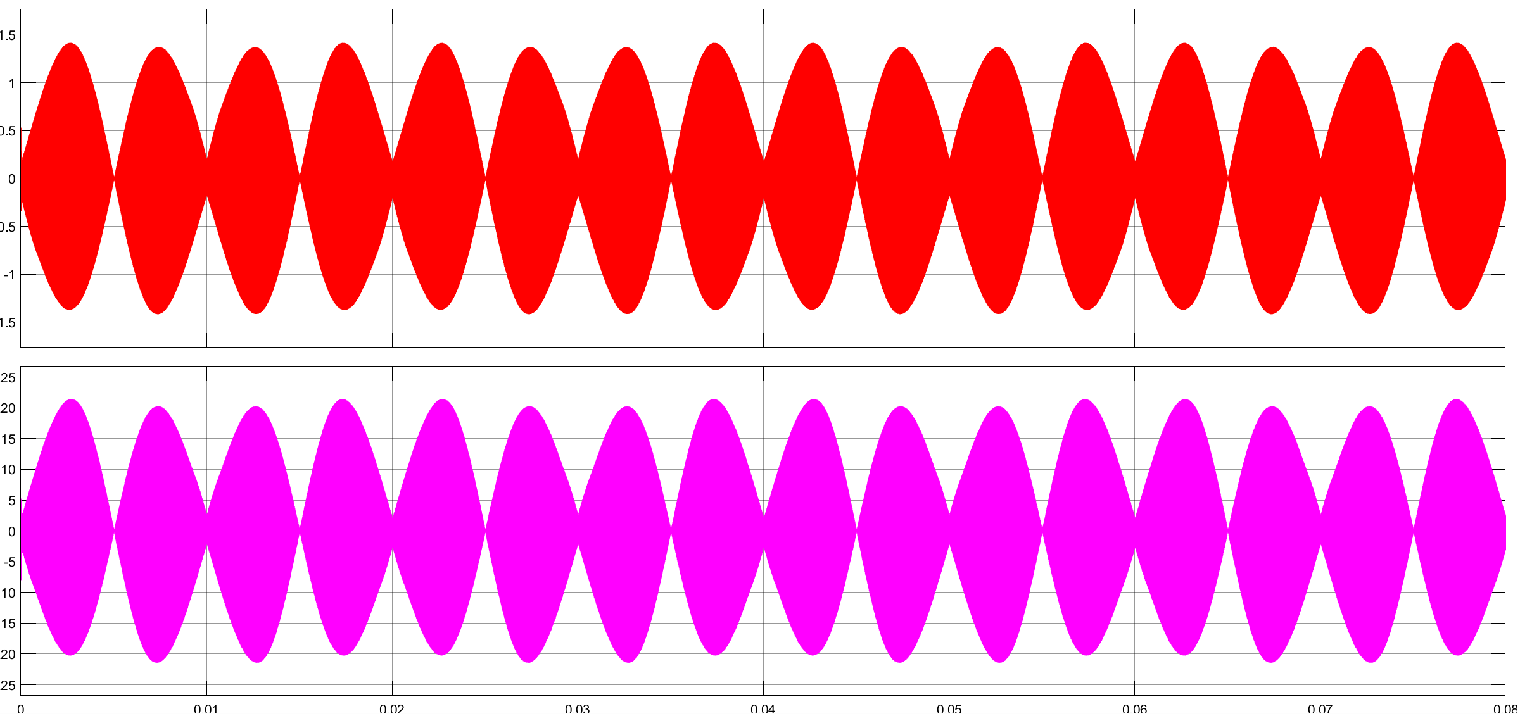
[picture p104: figure]

## Slide 6

Sequences of the Switching Harmonics and Side Bands

Frequency | Phase A | Phase B | Phase C
f_o | θ_o =0^o | θ_o =120^o | θ_o =−120^o
f_s −4f_o | 0^o | 0^o | 0^o
f_s −2f_o | 0^o | −120^o | 120^o
f_s | 0^o | 120^o | −120^o
f_s +2f_o | 0^o | 0^o | 0^o
f_s +4f_o | 0^o | −120^o | 120^o

If the fundamental is positive sequences

## Slide 7

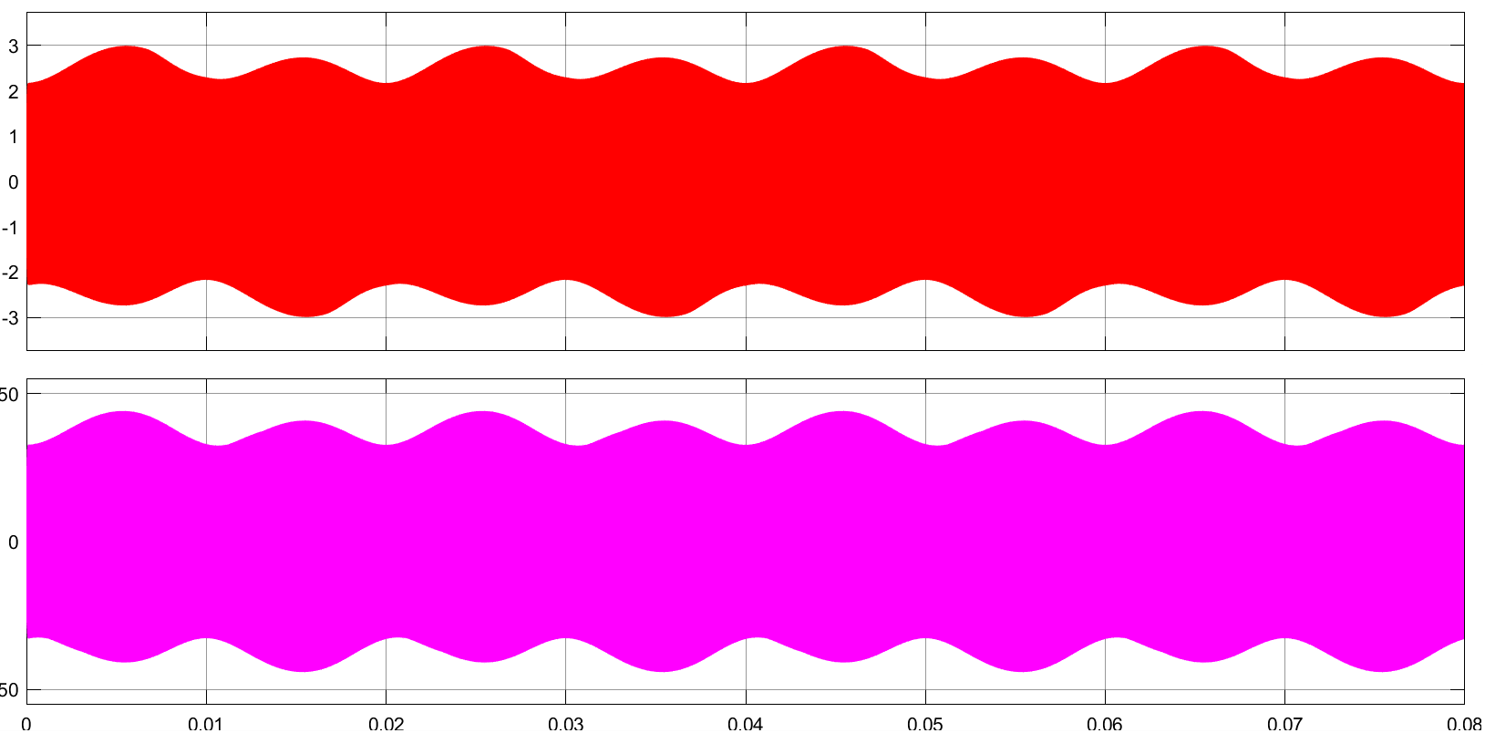
[picture p105: figure]
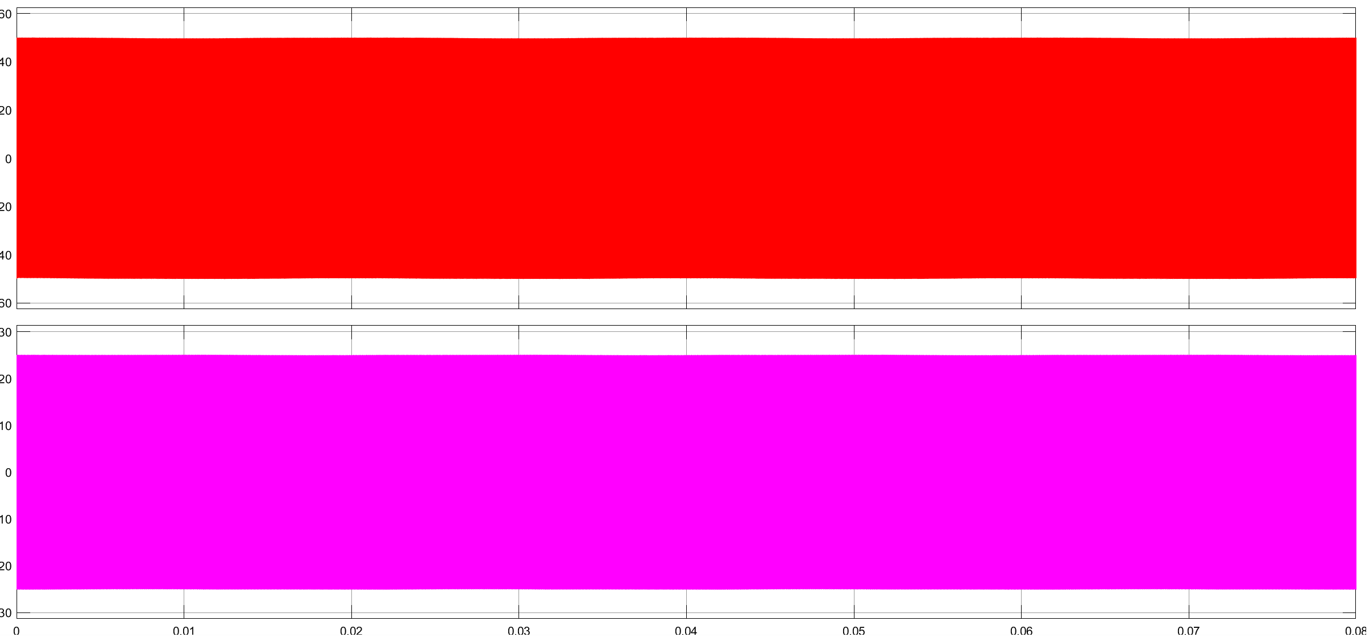
[picture p106: figure]

## Slide 8

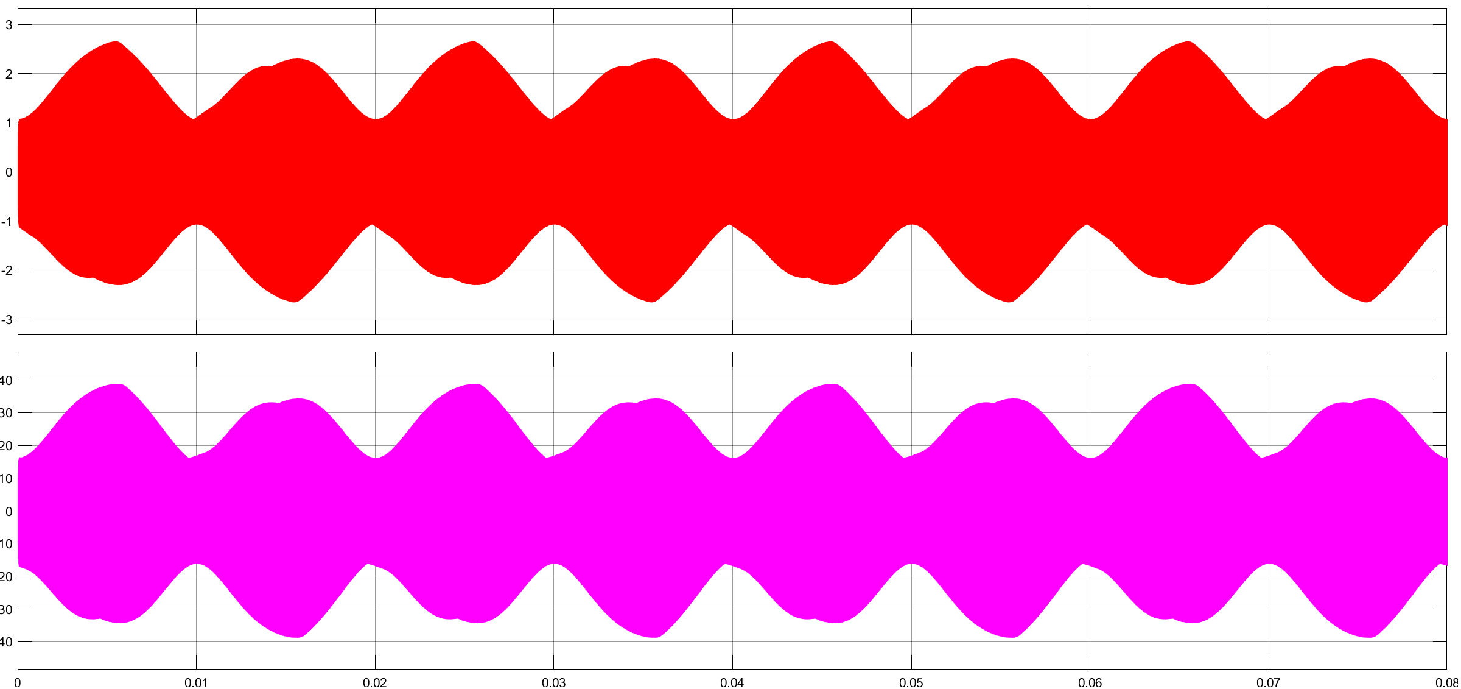
[picture p107: figure]
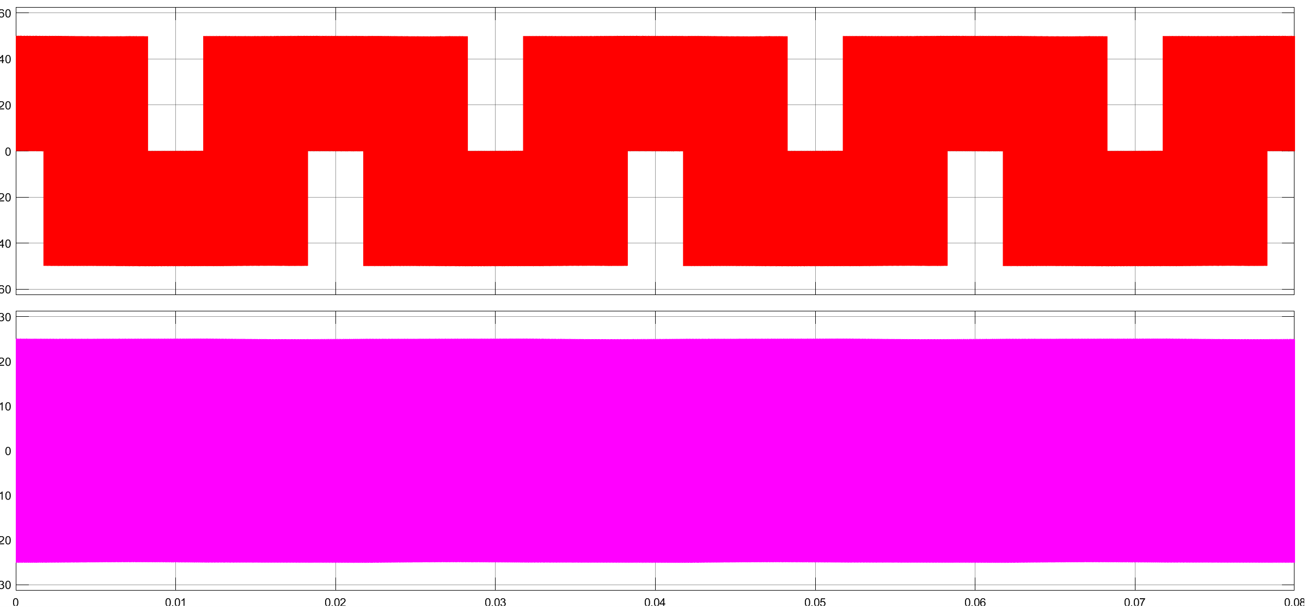
[picture p108: figure]
