EnesAyaz/WPTMotor/Presentation/2021.04.05.pptx

## Slide 2

Frequency | Phase A | Phase B | Phase C | For A-C
f_o | θ_o =0^o | θ_o =120^o | θ_o =−120^o | V √3 (30^o )
f_s −4f_o | 0^o | 240^o | 120^o | V √3 (−30^o )
f_s −2f_o | 180^o | 300^o | 60^o | V √3 (210^o )
f_s | 0^o | 0^o | 0^o | 0
f_s +2f_o | 180^o | 60^o | 300^o | V √3 (−210^o )
f_s +4f_o | 0^o | 120^o | 240^o | V √3 (30^o )

## Slide 3

WPT

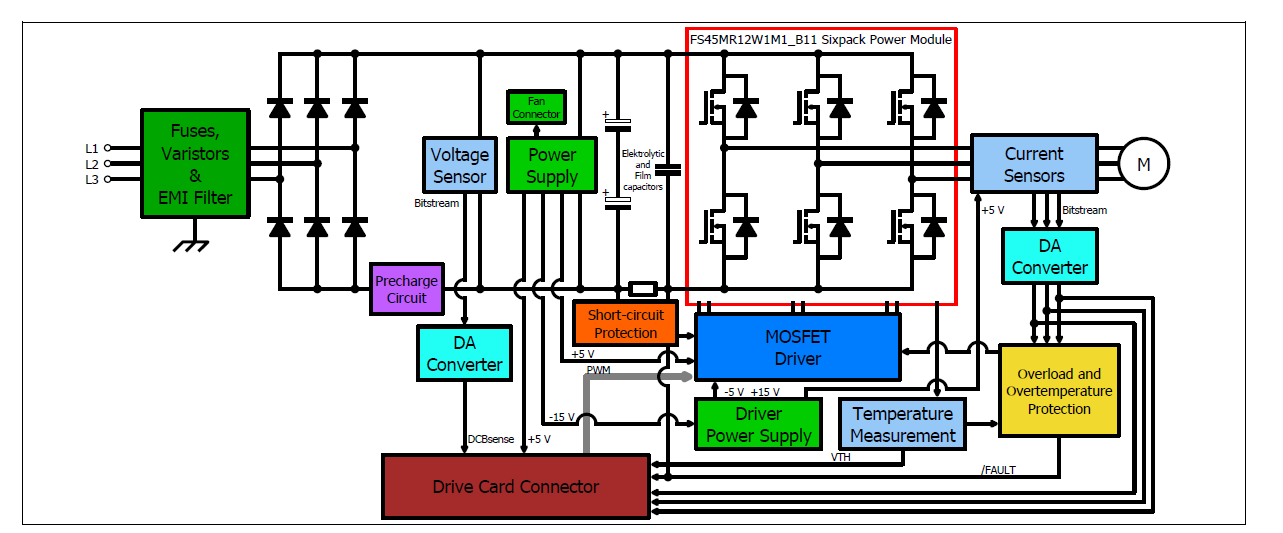
[picture p109: figure]

## Slide 4

Converter currents

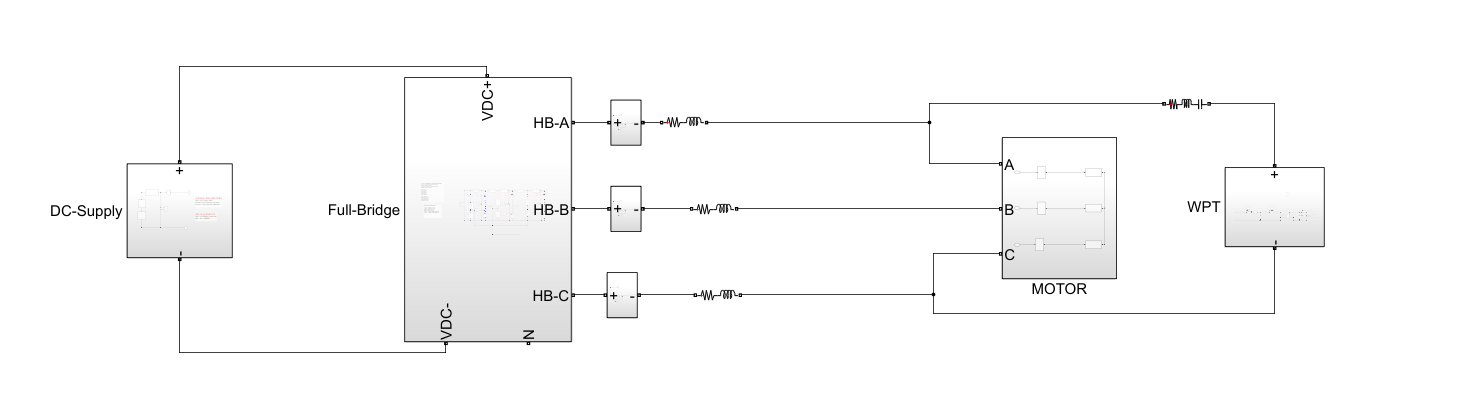
[picture p110: figure]
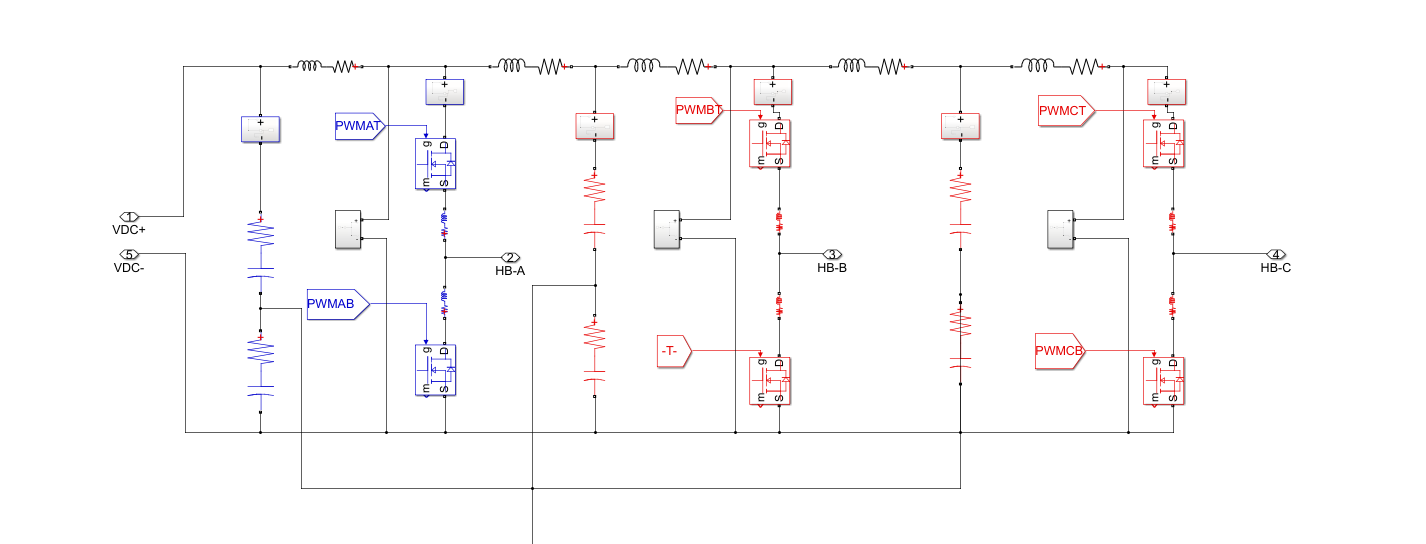
[picture p111: figure]

Problems
- Uneven current distribution
- Uneven DC link capacitor ripple distribution

## Slide 5

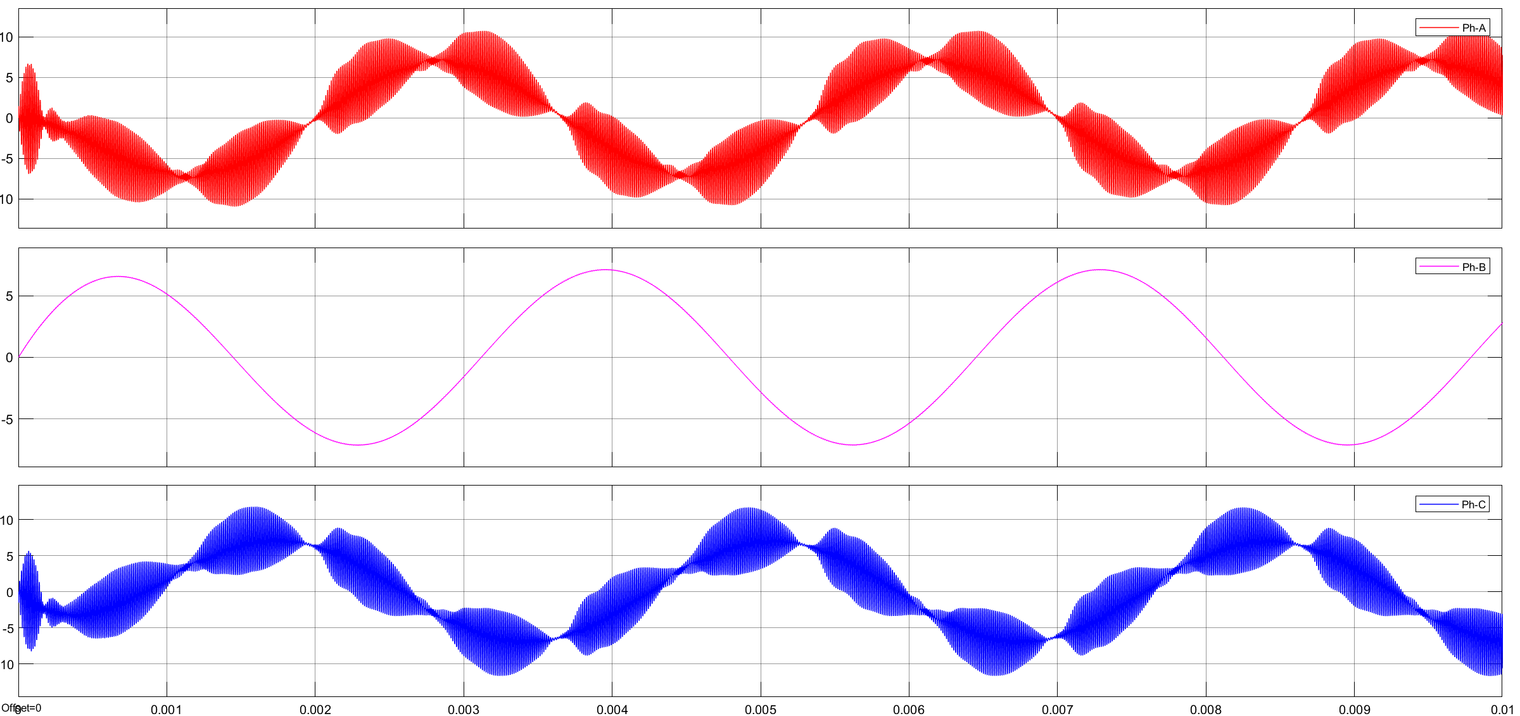
[picture p112: figure]

## Slide 6

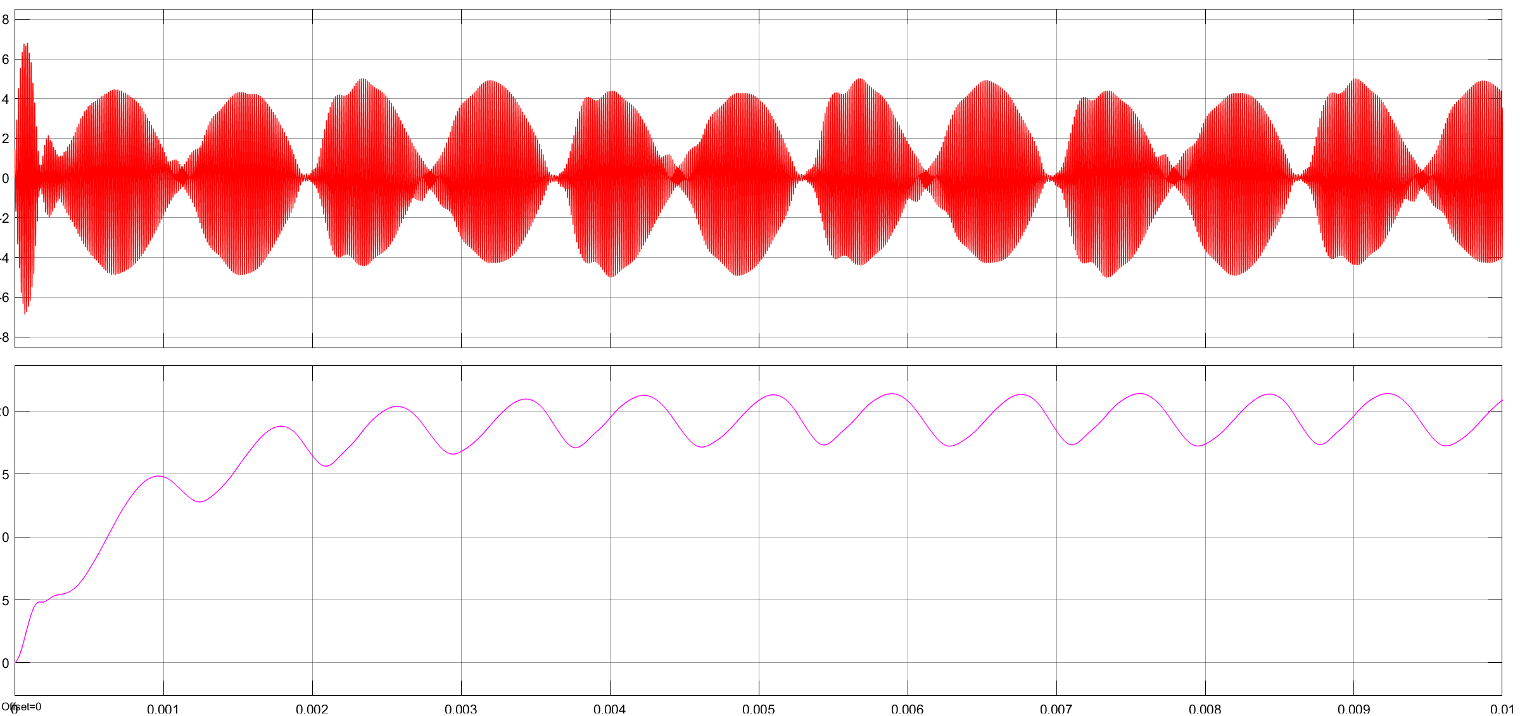
[picture p113: figure]

## Slide 7

80kHz

## Slide 8

Side-band

10 kHz sampling

harmonic

## Slide 9

Fundemental

Bu dq frame de sorun çıkarmaz
- hatta Tx akımı da daha switching frequeny de bir dq ya sokulabilir

Side Band

## Slide 10

Double fundamental ???

Bu motor controlünü kötü etkilemez mi?
