EnesAyaz/WPTMotor/Presentation/2021.02.21.pptx

Tests

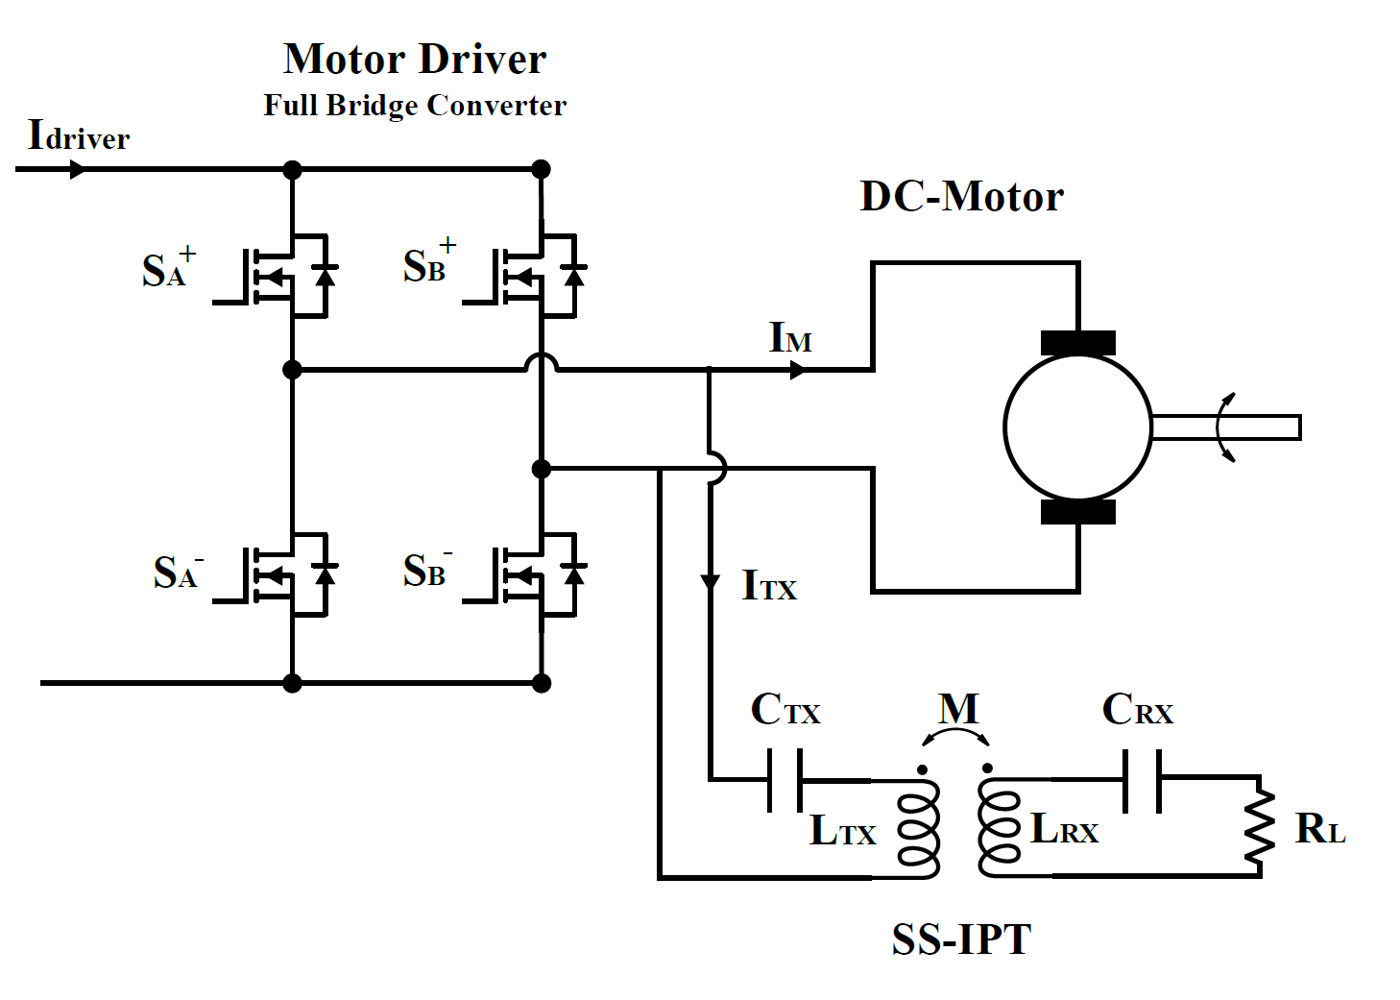
[picture p119: figure]

- Only SS-IPT Tests
  - Frequency Control
  - Duty Cycle Control
- Only motor Tests
  - Duty Cycle Control
  - Frequency ripple control
- IPT and Motor Tests
  - Isohips line

## Slide 2

Parameters | Values
L_p | 205 μH
L_s | 51 μH
M | 37.5 μH
C_p | 28nF
C_s | 116.5nF
R_L | 8.554 Ω

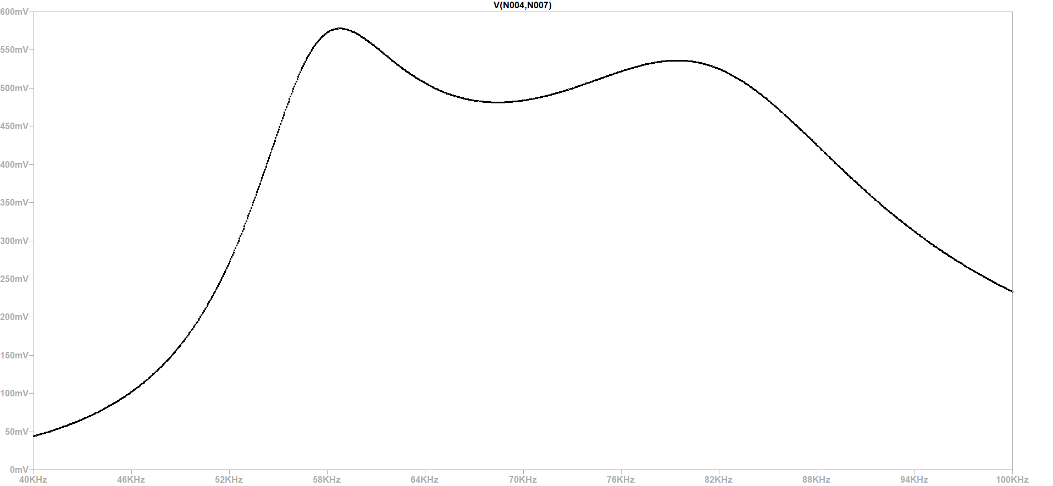
[picture p120: figure]

Frequency

Duty

## Slide 3

IPT-Tests

Frequency

Duty

## Slide 4

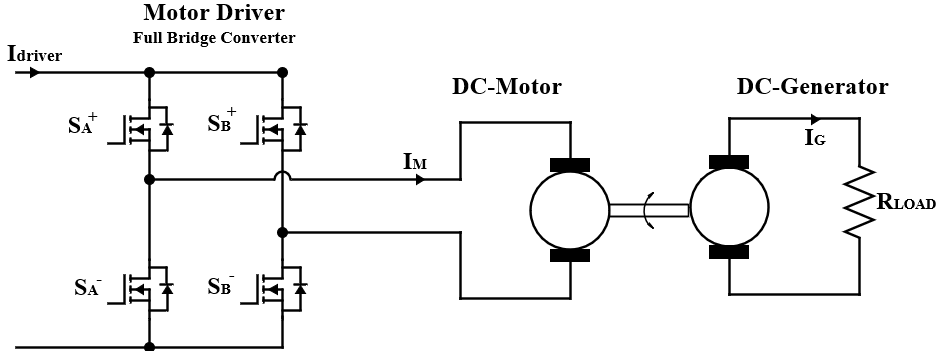
[picture p121: figure]
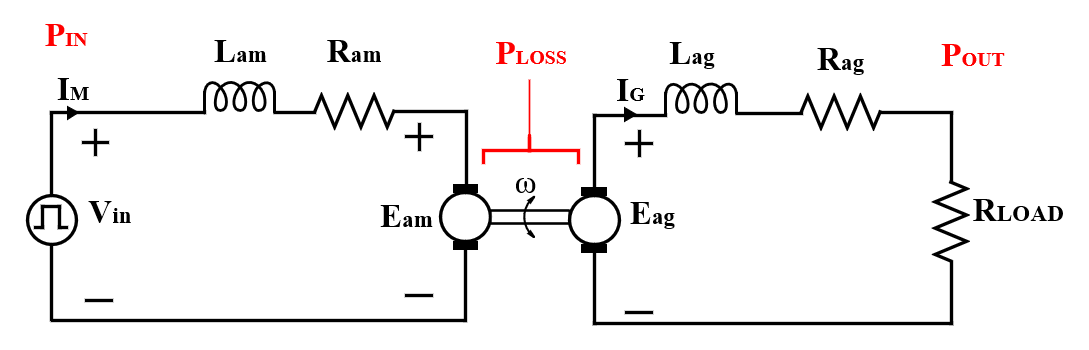
[picture p122: figure]

## Slide 5

Motor and Generator Parameters | Values
Ram | 2 Ω
Lam | 7 mH
Kam | 0.1173 V/rpm
Rag
Lag
Kag

No Interpole

## Slide 6

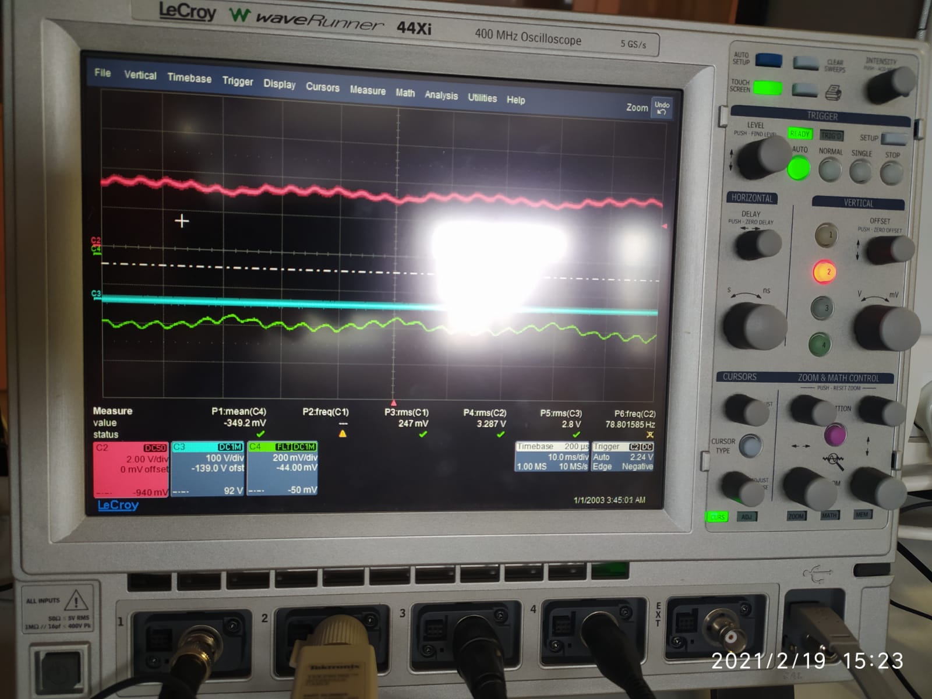
[picture p123: figure]

Agilent, No driver

Commutator number 80-90
Brush ?

375 rpm → 180 Hz
503 rpm → 250 Hz

## Slide 7

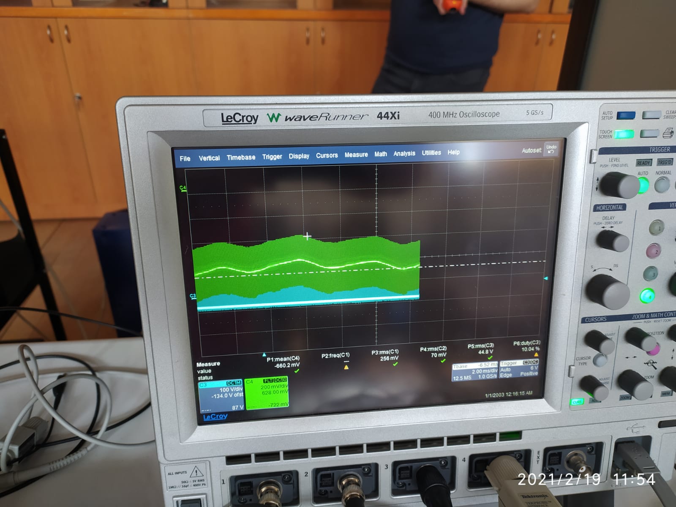
[picture p124: figure]

Low frequency are still present.

Also, we observe switching harmonics ?? Why
