EnesAyaz/WPTMotor/Presentation/2020.02.01.pptx

- Input Voltage: 50
- Duty Cycle : 0.5
- Switching Frequency: 80kHz
- WPT-Load: 8.4 Ω

x1.27=63.66V

Output Power: 74 W

## Slide 2

D=0.8
- DC= 0.6
- 1st =0.75
- 2nd =0.60
- 3rd = 0.40
- 4th =0.18

- Input Voltage: 70
- Duty Cycle : 0.8
- Switching Frequency: 80kHz
- WPT-Load: 8.4 Ω
- RL-Load= 14.5 Ω
- RL-Inductance: 5mH

Primary Side having 2nd harmonic

RL-Load Filters ??

## Slide 3

- Input Voltage: 100
- Duty Cycle : 0.8
- Switching Frequency: 80kHz
- WPT-Load: 8.4 Ω
- Motor-Load
