EnesAyaz/WPTMotor/Synhronous motor/Matlab/Time_Domain_Carrier_phase_shift/CPS.pptx

| 2S_B _(fs) +S_C _(fs) |

| 2S_B _(fs) - S_C _(fs) |

S_(ABC) _(fs)

2S_B _(fs)

φ

α

S_A _(fs)

β

S_C _(fs)

(a)

(b)

(c)

β=φ_(C−C) −φ_(C−B)

α=φ_(C−B) −φ_(C−A)

## Slide 2

m_a =0

m_a =0.3

m_a =0.6

m_a =0.9

## Slide 3

m_a =0

m_a =0.3

m_a =0.6

m_a =0.9

m_a =0.95

m_a =1

## Slide 4

(a)

(b)

## Slide 5

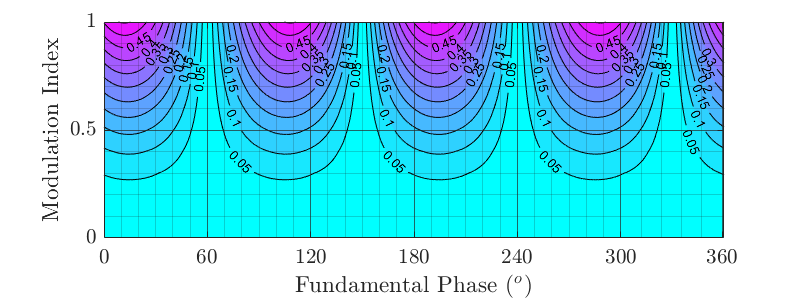
[picture p132: figure]

(a)

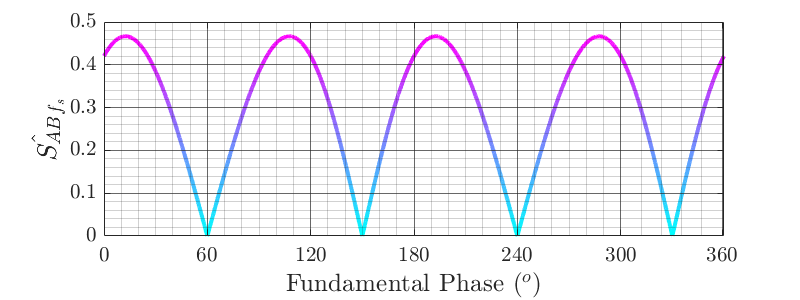
[picture p133: figure]

m_a =0.9

(b)

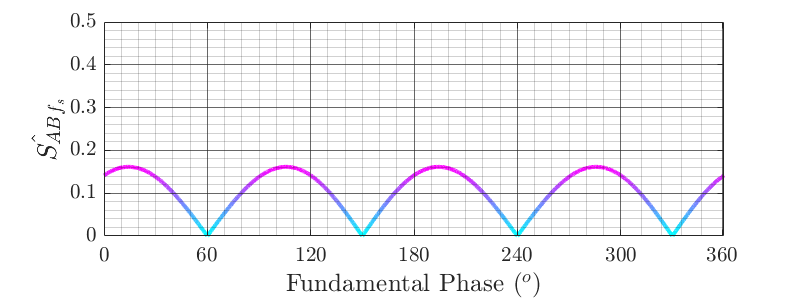
[picture p134: figure]

(c)

m_a =0.5

## Slide 6

Q_A

Q_B

## Slide 7

V_(Ref_A) =m_a sin(θ_f )

V_(Ref_B) =m_a sin(θ_f −120^o )

V_(Ref_C) =m_a sin(θ_f +120^o )

Q_A

Q_B

Fundamental Phase (° )

Fundamental Phase (° )

Modulation Index

Digital Gate Signals

Notes: Fundamental Phase

## Slide 8

V_(Ref_A) =0.8660 m_a = 0.5196

V_(Ref_B) =0

V_(Ref_C) =−0.8660 m_a =0.5196

Q_B =(θ_f =180^o )

V_(Ref_A) =0 m_a = 0

V_(Ref_B) =1 m_a =0.6

V_(Ref_C) =−0.8660 m_a =0.5196

Q_A (θ_f =120^o )

## Slide 9

V_(Ref_A) =0.8660 m_a = 0.5196

V_(Ref_B) =0

V_(Ref_C) =−0.8660 m_a =0.5196

Q_A

Q_B

V_(Ref_A) =0 m_a = 0

V_(Ref_B) =1 m_a =0.6

V_(Ref_C) =−0.8660 m_a =0.5196

## Slide 10

Q_A (θ_f =120^o )

Q_B =(θ_f =180^o )

## Slide 11

## Slide 12

## Slide 13

A WPT system is connected between leg-A and leg-B, and the WPT system is supposed to be excited by the switching harmonic.
For each switching interval, the duty cycle of leg-A and leg-B varies, and their average values equal the corresponding reference voltages at each time interval.
Thus, varying duty cycles follow a sinusoidal reference signal, which drives the motor. However, the changing duty cycles cause a fluctuation in the magnitude of the switching component.
The fluctuation can also be analyzed in the frequency domain and modeled as sideband harmonics.
Due to this fluctuation, the input voltage of the WPT system changes over the fundamental period.
This input voltage fluctuation also echoes the output voltage of the WPT system, and it should be mitigated.
The first solution is using an active converter at the output side, which increases the cost and complexity of the system.
Besides, it increases the weight of the rotating side.
The second solution is connecting bulky capacitance to the output in parallel, increasing the weight and creating a point of failure.
The third solution is using a control method such as frequency detuning. However, the output current is measured and controlled in the field excitation system.
A lag exists due to the high inductance of the field, and the frequency control cannot deal with the fluctuation if phase compensation circuits or algorithms are not applied.
Instead of solving this fluctuation on the output side, the input side solutions can be proposed.
However, these solutions should not affect the average value, which follows the reference signal.
