EnesAyaz/WPTMotor/Thesis/Visio/chapter-3/Controller3AC_v2.pdf

# VRX(ref) ω(ref) T(ref)

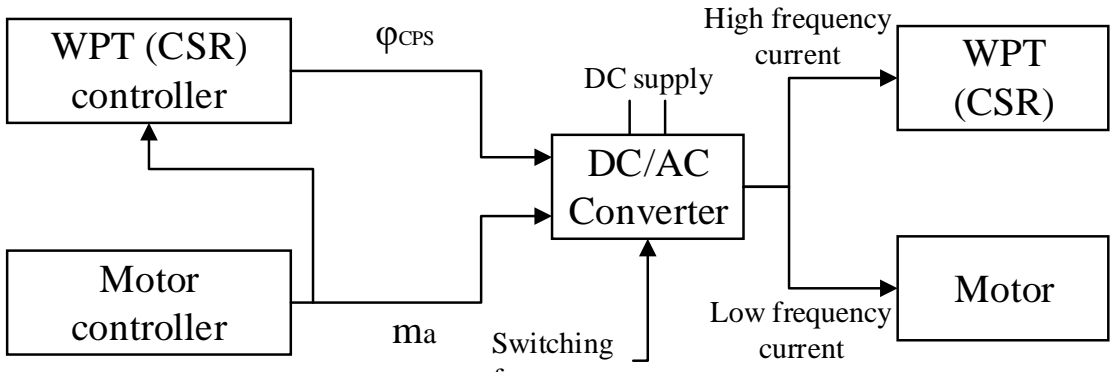
[picture p135: figure]
WPT (CSR) controller; Motor controller; DC/AC Converter; WPT (CSR); Motor; High frequency current; Low frequency current; φCPS; Switching; DC supply

frequency
