EnesAyaz/WPTMotor/Thesis/Visio/chapter-3/Controller3DC_v2.pdf

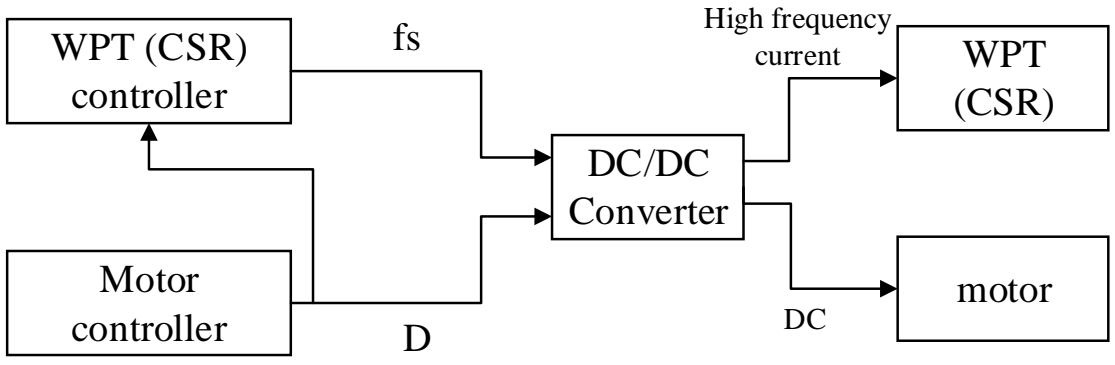
[picture p136: figure]
WPT (CSR) controller; Motor controller; DC/DC Converter; WPT (CSR); motor; High frequency; current

# VRX(ref) ω(ref) T(ref)
