EnesAyaz/WPTMotor/Monthly-Presentation/2022.10.19.pdf

METU | G. Cakal, September 2020 | 0/24

# Concurrent Operation of Wireless and Wired Power Transfer System with a Single Converter/Inverter

# Enes Ayaz

20/10/2022

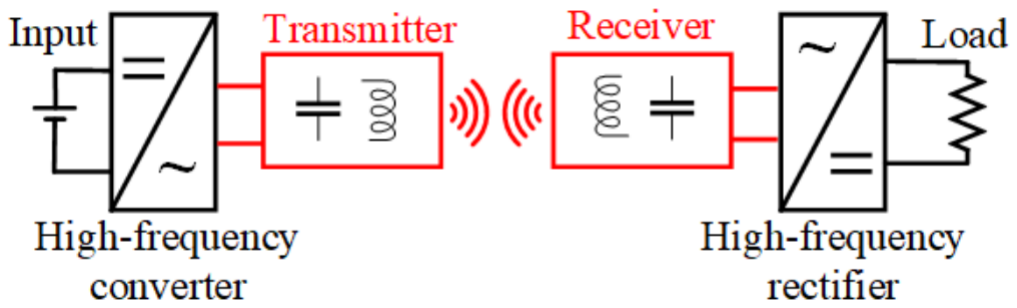
[picture p137: figure]
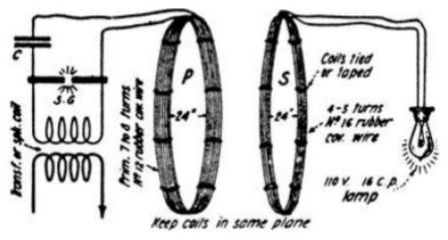
[picture p138: figure]

METU | 1 | E. Ayaz, 2022

# Wireless Power Transfer

# 1. DC/AC Converter 2. Compensation Circuits 3. Transmitter/Receiver Coils 4. AC/DC Rectifiers

# Tesla’s WPT System

| Inductive Power Transfer | Capacitive Power Transfer
Transfer Type | Varying MF | Varying EF
Power Ratings | High | Low
Frequencies | Low | High
Efficiency | High | High
Distance | Moderate | Low

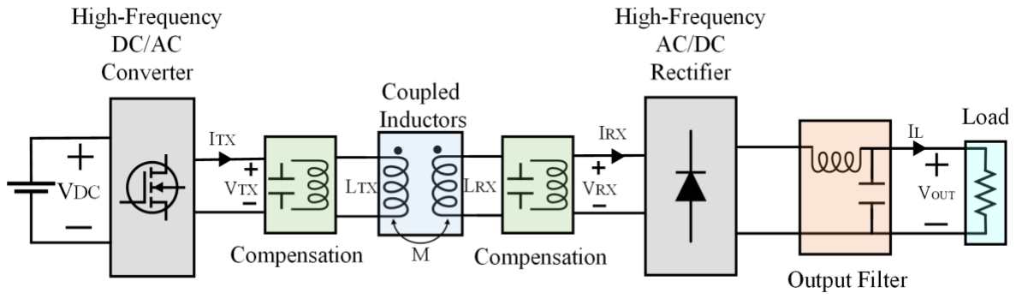
[picture p139: figure]

METU | 2 | E. Ayaz, 2022

# Inductive Power Transfer System

METU | 3 | E. Ayaz, 2022

# Simultaneous Information/ Power Transfer

# Selective Power Transfer

# Slip-Ring Applications

# Single-Stage Power Transfers

### Look at Mendeley : PowerLab/Enes/WPT-Motor

1. Simultaneous Wireless
Information and Power Transfer (SWIPT): Recent Advances and Future Challenges (2018)
2. Integrated Resonant Structure for Simultaneous Wireless
Power Transfer and Data
Telemetry(2012)
3. A Simultaneous Wireless Power and Data Transmission Method for Multi-Output WPT Systems: Analysis, Design, and
Experimental Verification
(2020)
1. Selective Omnidirectional Magnetic Resonant Coupling Wireless Power Transfer With Multiple-Receiver System(2018)
2. Design and Analysis of Wireless Switched Reluctance Motor
Drives(2019)
3. Frequency Splitting-Based Wireless Power Transfer and Simultaneous Propulsion Generation to Multiple Micro-Robots(2018)
4. Comparative Analysis of Frequency-Selective Wireless Power Transfer for Multiple-Rx Systems(2020)
5. A Frequency-Selective EMI Reduction Method for Tightly Coupled Wireless Power Transfer Systems Using Resonant Frequency Control of a Shielding Coil in Smartphone Application(2020)
6. Selective Wireless Power Transfer for Smart Power Distribution in a Miniature-Sized Multiple-Receiver System(2016)
7. A Multifrequency Superposition Methodology to Achieve High Efficiency and Targeted Power Distribution for a Multiload
MCRWPT System(2018)
8. Cross Interference Minimization and Simultaneous Wireless Power Transfer to Multiple Frequency Loads Using Frequency Bifurcation Approach
1. A Primary-Side Control Method of Wireless Power Transfer for Motor Electric Excitation(2019)
2. Wireless DC Motor Drives with Selectability and
Controllability(2017)
3. An Airborne Radar Power Supply With Contactless Transfer of Energy—Part I: Rotating
Transformer (2007)
4. Aerodynamic Fluid Bearings for Translational and Rotating Capacitors in Noncontact
Capacitive Power Transfer
Systems(2014)
5. Synchronous Generator Brushless Field Excitation and Voltage Regulation via Capacitive Coupling Through Journal Bearings(2017)
6. Operation of an Electrical Excited Synchronous Machine by
Contactless Energy Transfer to the Rotor(2018)
7. A Rotation-Lightweight Wireless Power Transfer System for Solar Wing Driving(2019)
8. Wireless Power Transfer for Smart Industrial and Home
Applications(2019)
9. Use of the Rotating Rectifier Board as a Capacitive Power Coupler for Brushless Wound Field Synchronous
Machines(2022)
1. A High-Efficiency GaN-Based Single-Stage 6.78 MHz Transmitter for Wireless Power Transfer Applications(2019)
2. Cooperative Integration of RF Energy Harvesting and Dedicated WPT for Wireless Sensor
Networks(2019)
3. A Three-Phase Single-Stage AC–DC Wireless-Power-Transfer Converter With Power Factor Correction and Bus Voltage Control(2020)
4. Individually Regulated Multiple-Output WPT System With a Single PWM and Single Transformer (2020)

# Concurrent Power Transfer

1. Multifrequency Inductive Power Transfer(2014)
2. Wireless Power Transfer With Concurrent 200-kHz and 6.78-MHz Operation in a Single-Transmitter Device (2016)
3. Gan-Based Dual-Mode Wireless Power Transfer Using Multifrequency Programmed Pulse Width Modulation (2017)
4. A Multifrequency Superposition Methodology to Achieve High Efficiency and Targeted Power Distribution for a Multiload MCRWPT System (2018)
5. Cross Interference Minimization and Simultaneous Wireless Power Transfer to Multiple Frequency Loads Using Frequency Bifurcation Approach(2019)
6. A Gallium Nitride (GaN)-Based Single-Inductor Multiple-Output (SIMO) Inverter With Multi-Frequency AC Outputs (2019)
7. Single-Inductor Multiple-Output (SIMO) Buck Hybrid Converter for Simultaneous Wireless and Wired Power Transfer(2020)
8. Generalized methodology to generate, amplify and compensate multi-frequency power for a single-inverter-based MF-MR-S-WPT system (2020)
9. Concurrent Wireless Power Transfer to Multiple Receivers With Additional Resonant Frequencies and Reduced Power Switches (2020)
10. Multifrequency and Multiload MCR-WPT System Using Hybrid Modulation Waves SPWM Control Method (2021)
11. Multi-Frequency Multi-Amplitude Superposition Modulation Method With Phase Shift Optimization for Single Inverter of Wireless Power Transfer System (2021)
12. Design and Control of a Decoupled Multichannel Wireless Power Transfer System Based on Multilevel Inverters (2022)
13. A Dual-Frequency Three-Dimensional WPT System with Directional Power Transfer Capability at Two Separately Regulated Outputs (2022)

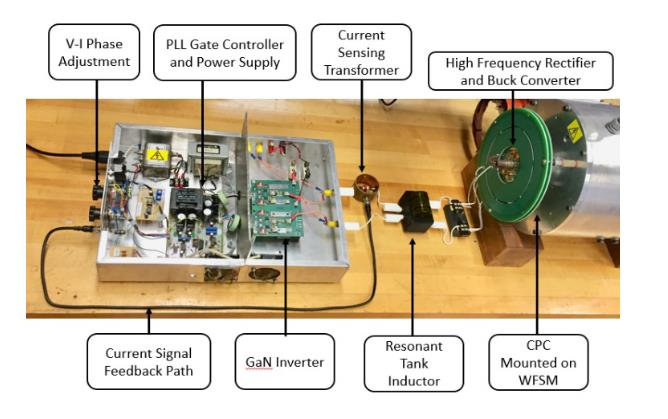
[picture p140: figure]

METU | 4 | E. Ayaz, 2022

# Topologies:

# 1. Multi-converter and multi-resonant 2. Single-converter and multi-resonant

# 3. Single-converter and multi-load

# Contactless Slip Rings

# Motivations:

# 1. To increase power 2. To reduce switching components

# 3. To increase DC-link utilization rate

# 4. To provide operation for more than one standards

# Aim : Merging Concurrent Power Transfer System with Slip Ring Applications

# Concurrent Power Transfer

# Motivations: 1. To eliminate carbon brushes requiring periodic maintenance

# 2. To eliminate brushless exciters that are not suitable for variable speed drives

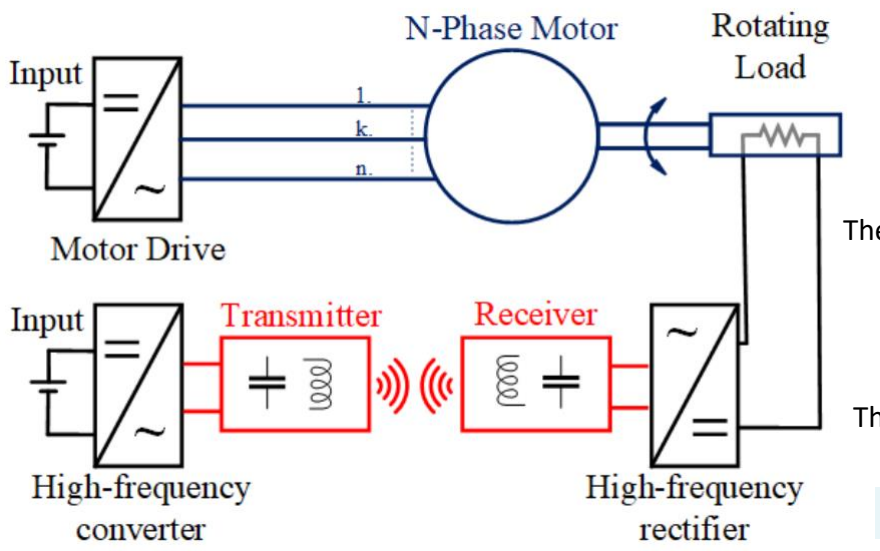
[picture p141: figure]
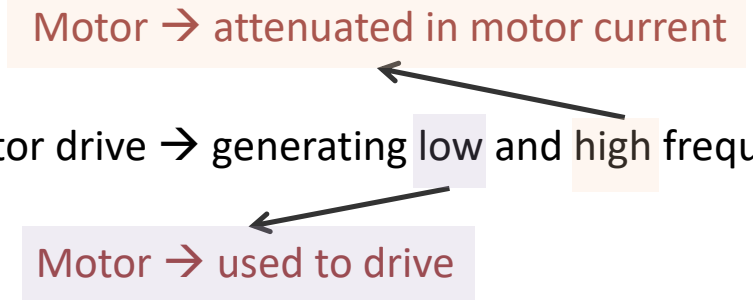
[picture p142: figure]
Motor → attenuated in motor current; Motor → used to drive

METU | 5 | E. Ayaz, 2022

# Conventional Inductive Power Transfer Based Contactless Slip Ring

# Two converters: 1. To drive the motor 2. To excite the Tx coil

# The WPT converter → generating high frequency

# The motor drive → generating low and high frequencies

# The WPT system →behaves like band-pass filter

# Proposed Inductive Power Transfer Based Contactless Slip Ring

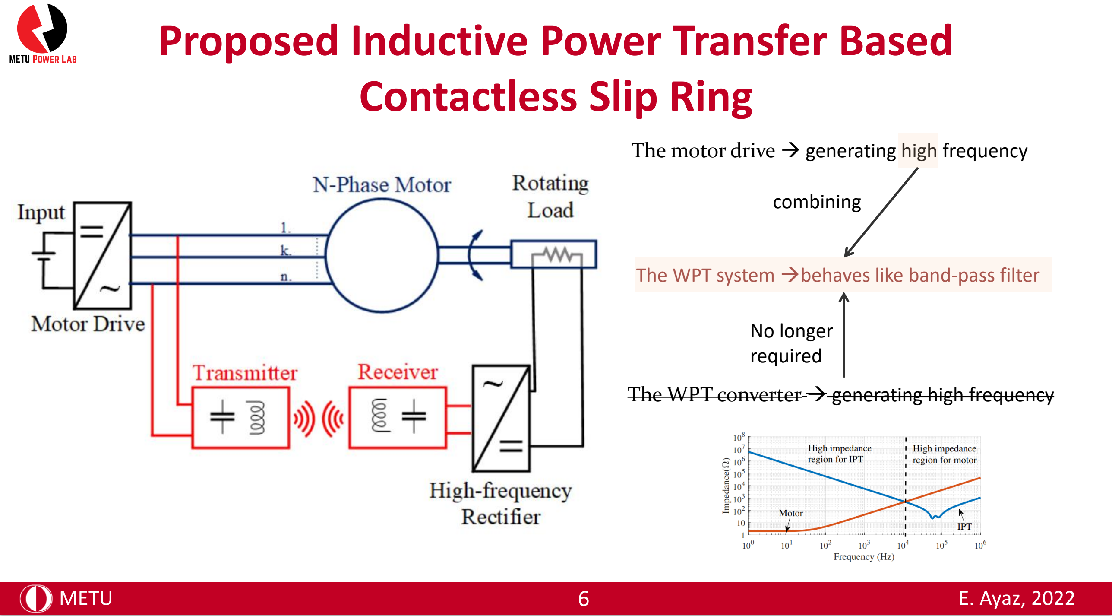
[picture p143: page 7]

METU | 6 | E. Ayaz, 2022

# The WPT converter → generating high frequency

# The motor drive → generating high frequency

# The WPT system →behaves like band-pass filter

# combining

# No longer required

# Challenge: Independent Control of Motor and Contactless Slip Ring Power

# Motor:

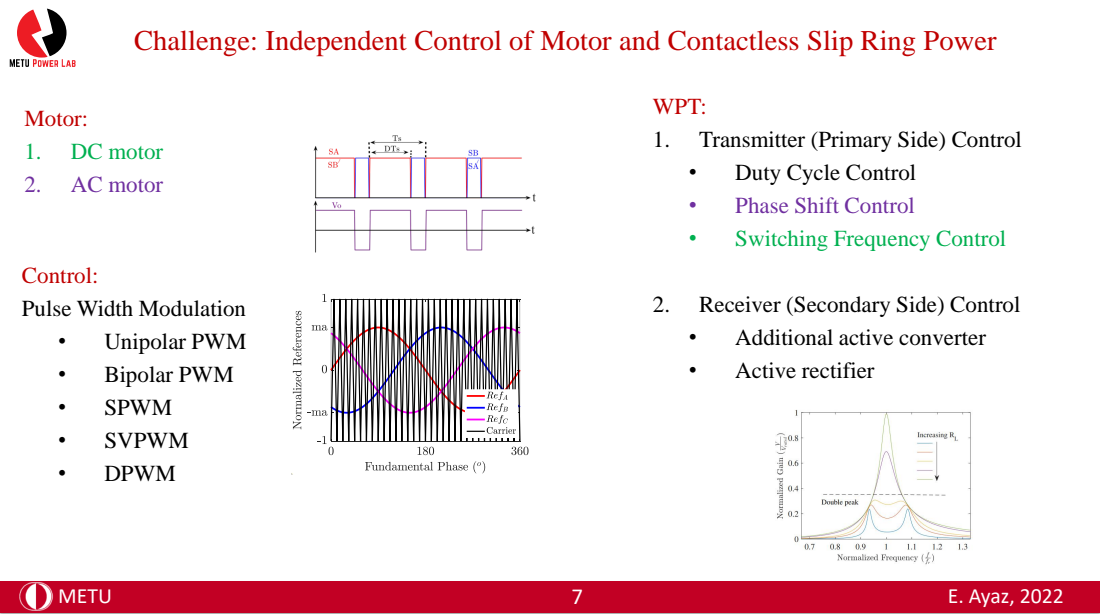
[picture p144: page 8]
METU; E. Ayaz, 2022; 1. DC motor; 2. AC motor

WPT:
1. Transmitter (Primary Side) Control
• Duty Cycle Control
• Phase Shift Control
• Switching Frequency Control

Control:
Pulse Width Modulation
• Unipolar PWM
• Bipolar PWM
• SPWM
• SVPWM
• DPWM

2. Receiver (Secondary Side) Control
• Additional active converter
• Active rectifier

# DC Motor Drives

# SA = SB

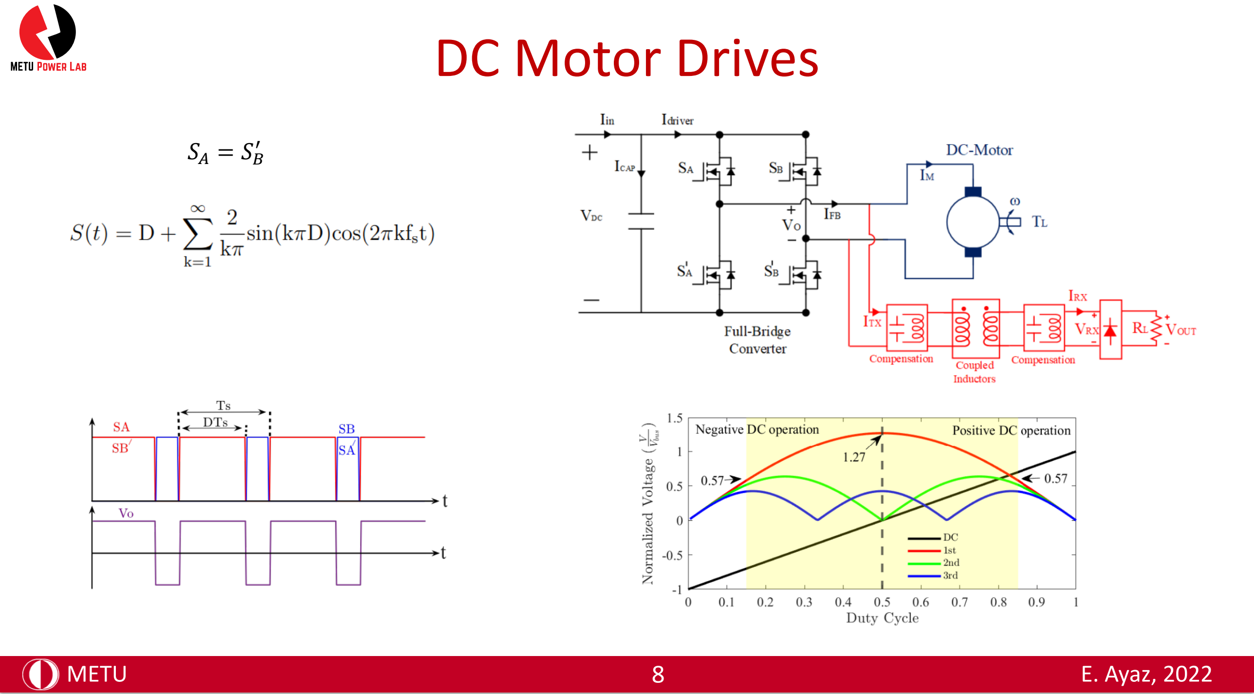
[picture p145: page 9]

METU | 8 | E. Ayaz, 2022

′

# Control Method

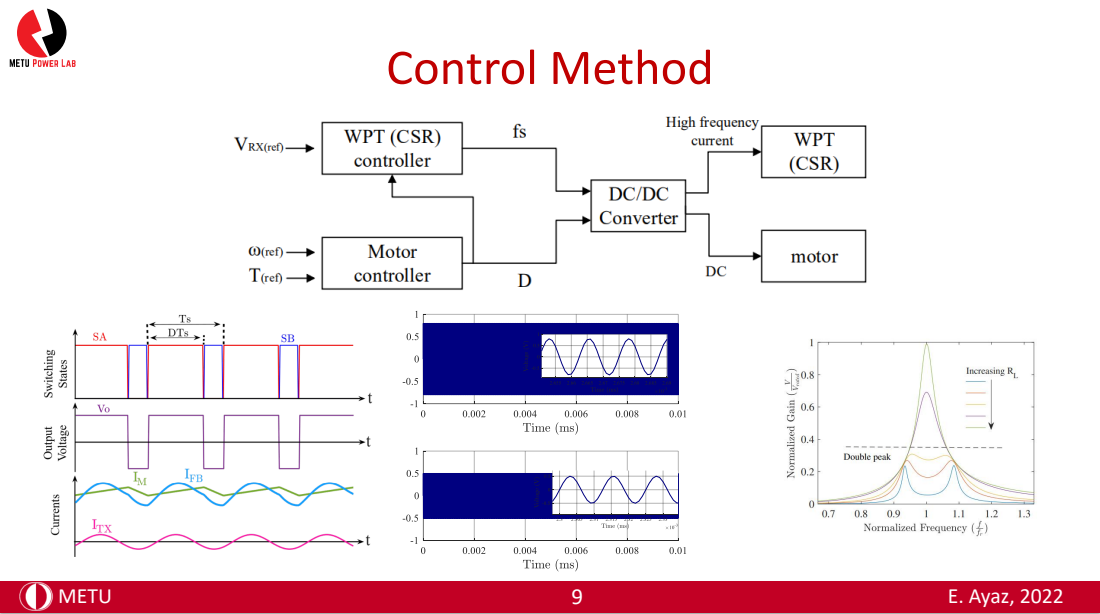
[picture p146: page 10]
METU; E. Ayaz, 2022

# Concurrent Operation

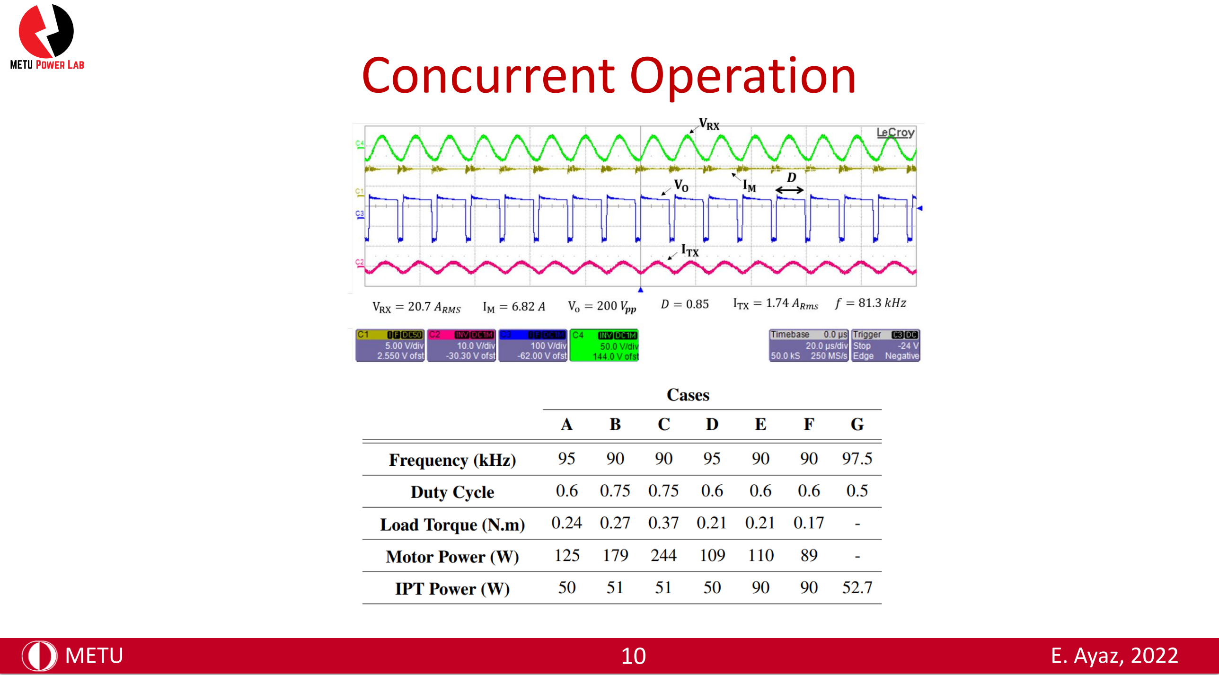
[picture p147: page 11]

METU | 10 | E. Ayaz, 2022

# AC Motor Drives

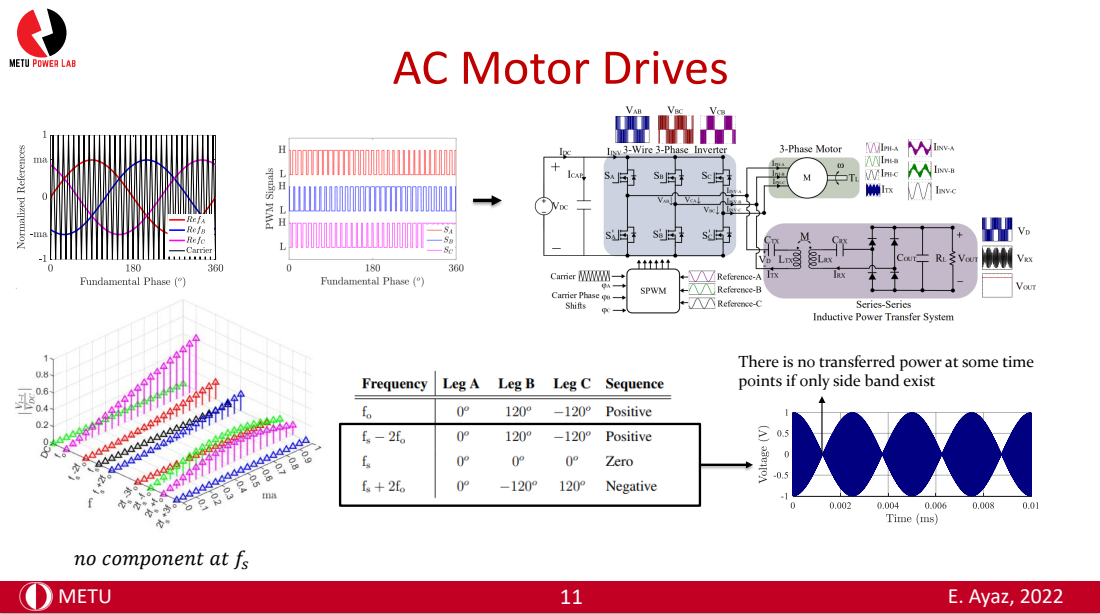
[picture p148: page 12]
METU; E. Ayaz, 2022

There is no transferred power at some time
points if only side band exist

no component at fs

# Carrier Phase Shift

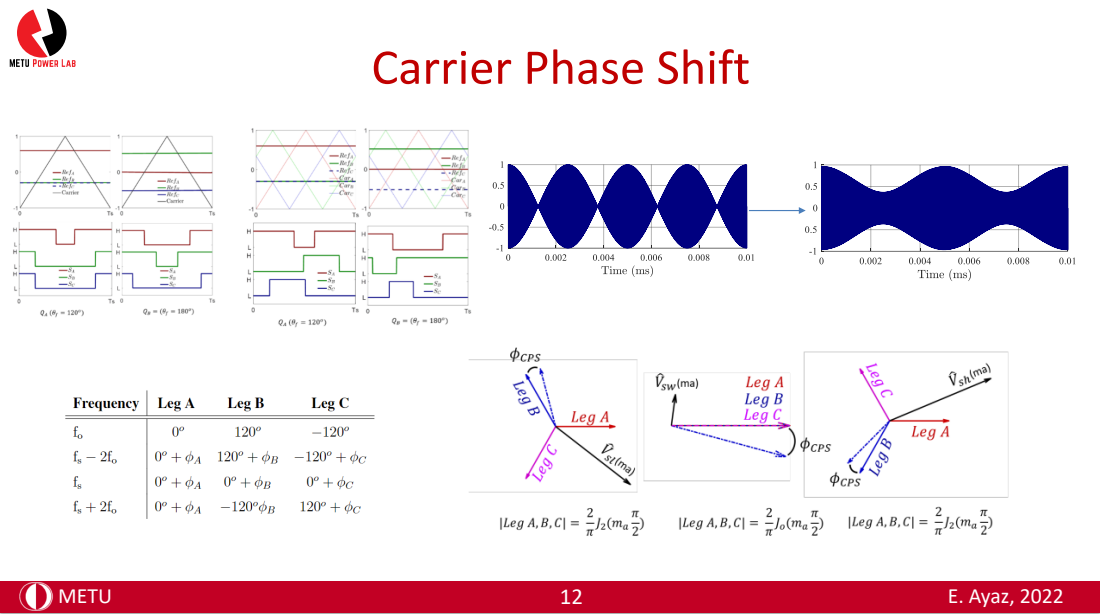
[picture p149: page 13]
METU; E. Ayaz, 2022

# Primary Side Voltage Control

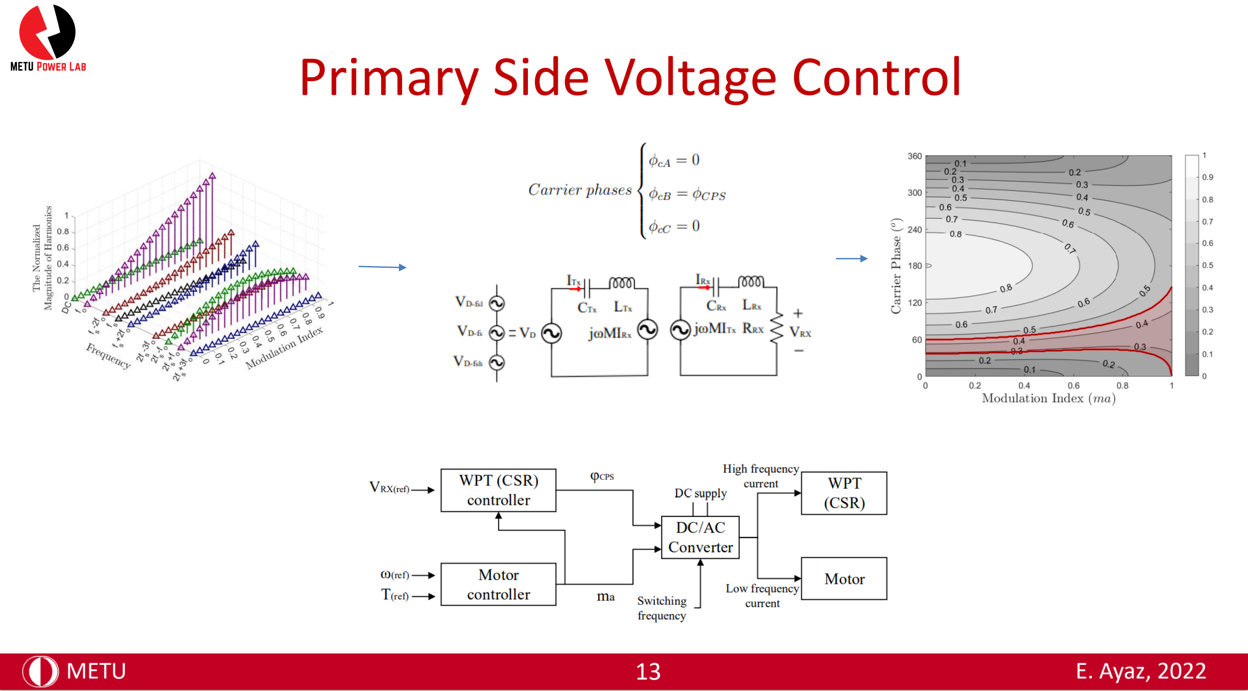
[picture p150: page 14]

METU | 13 | E. Ayaz, 2022

# Output Voltage Regulation

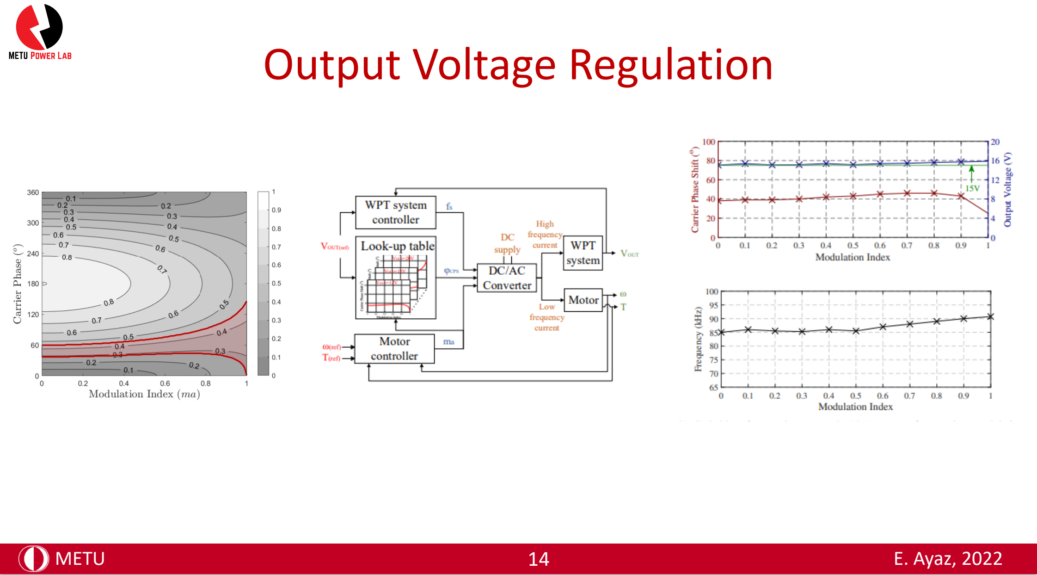
[picture p151: page 15]

METU | 14 | E. Ayaz, 2022

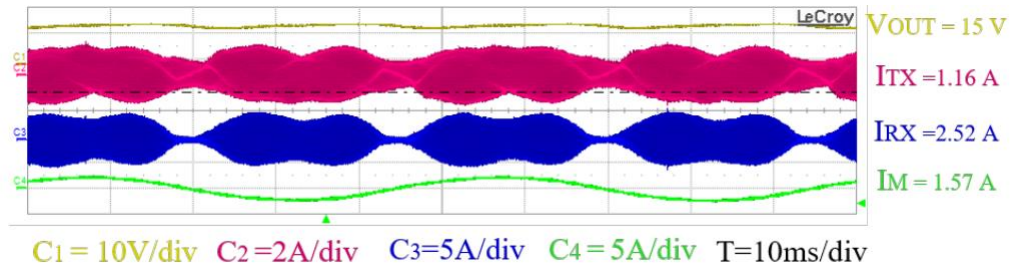
[picture p152: figure]
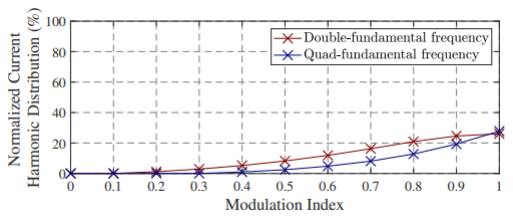
[picture p153: figure]

METU | 15 | E. Ayaz, 2022

# Low-frequency Ripple at the Output Voltage

# Real-time algorithm

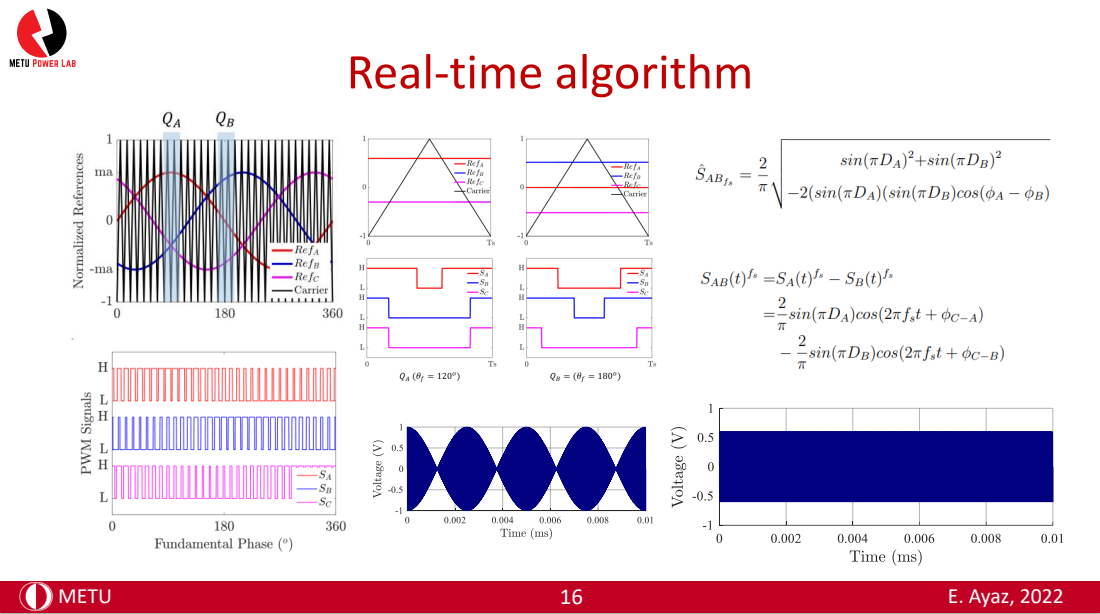
[picture p154: page 17]
METU; E. Ayaz, 2022

# Restrictions

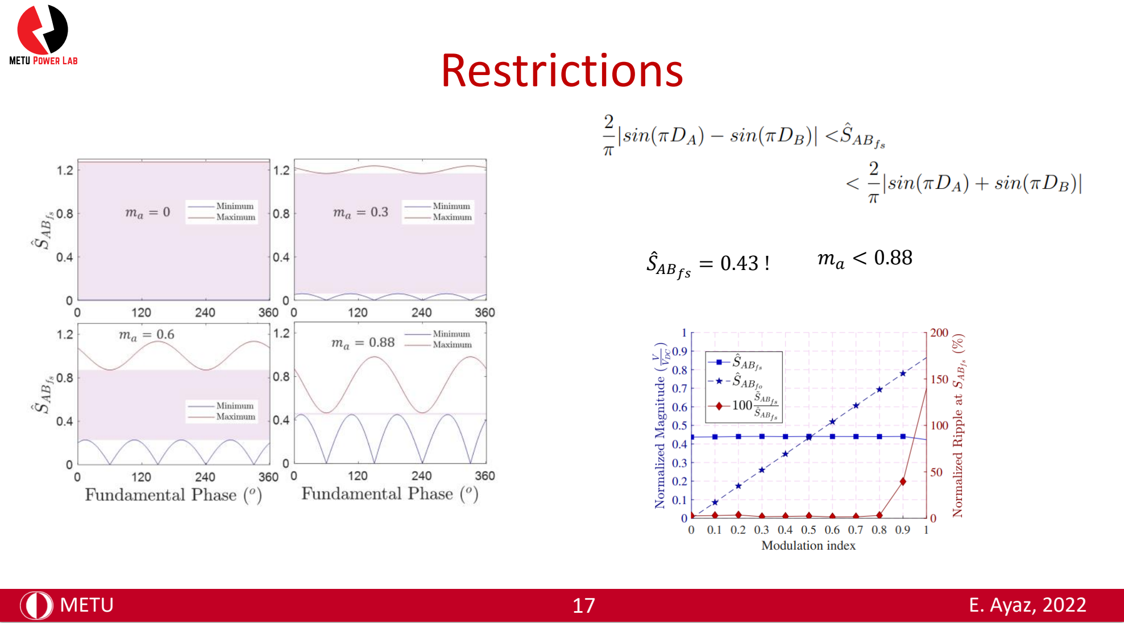
[picture p155: page 18]

METU | 17 | E. Ayaz, 2022

Sመ

## ABfs

= 0.43 ! ma < 0.88

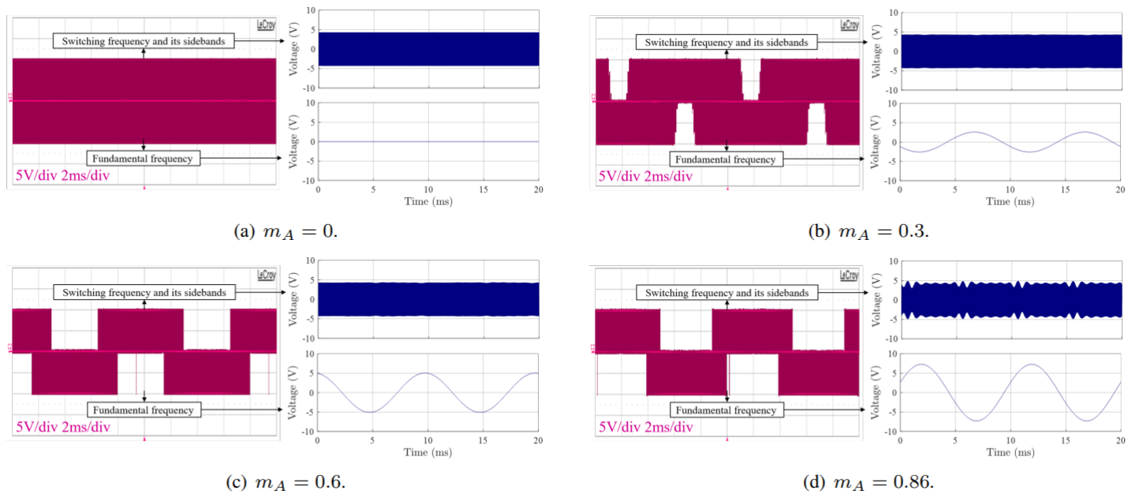
[picture p156: figure]

METU | 18 | E. Ayaz, 2022

# Experimental Validation

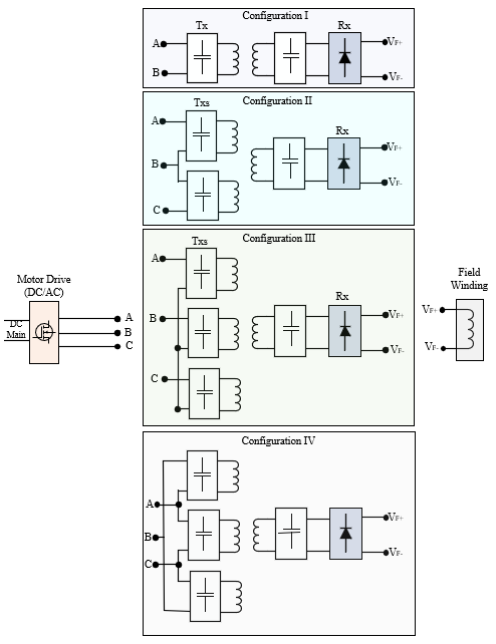
[picture p157: figure]

METU | 19 | E. Ayaz, 2022

# Future Works

# Motivations:

# 1. To increase DC-link utilization rate

# 2. To increase power 3. To break the restrictions

# - Motor drives have more than 2 wires - Conventional WPT systems have 2 wires input

# - Multi-phase WPT systems

# Future Works

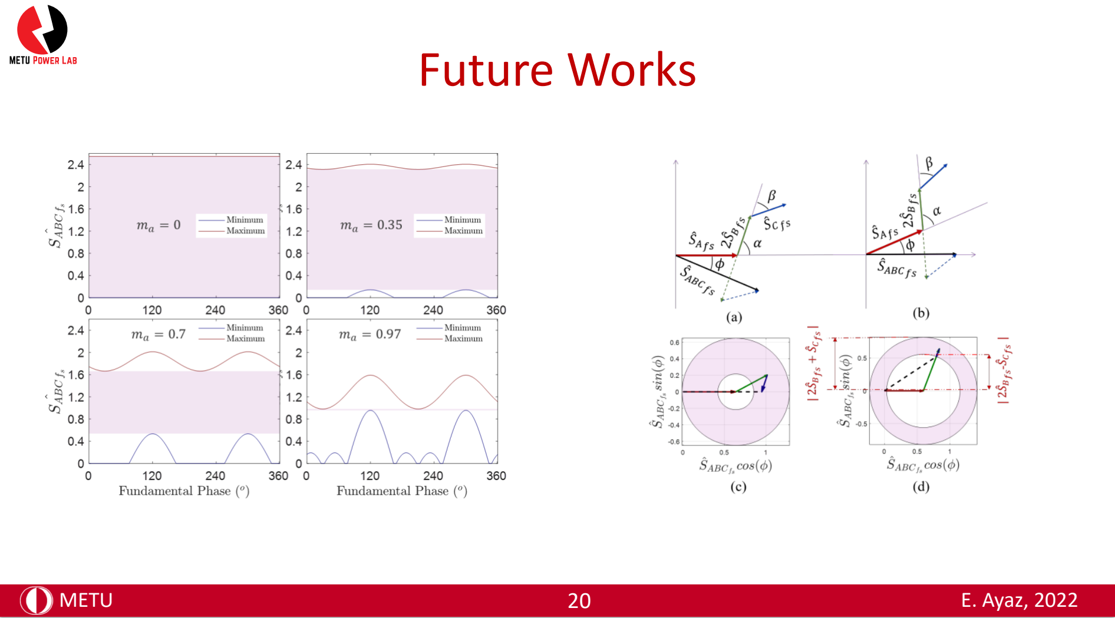
[picture p158: page 21]

METU | 20 | E. Ayaz, 2022

# Challenge- Calculation Burden!

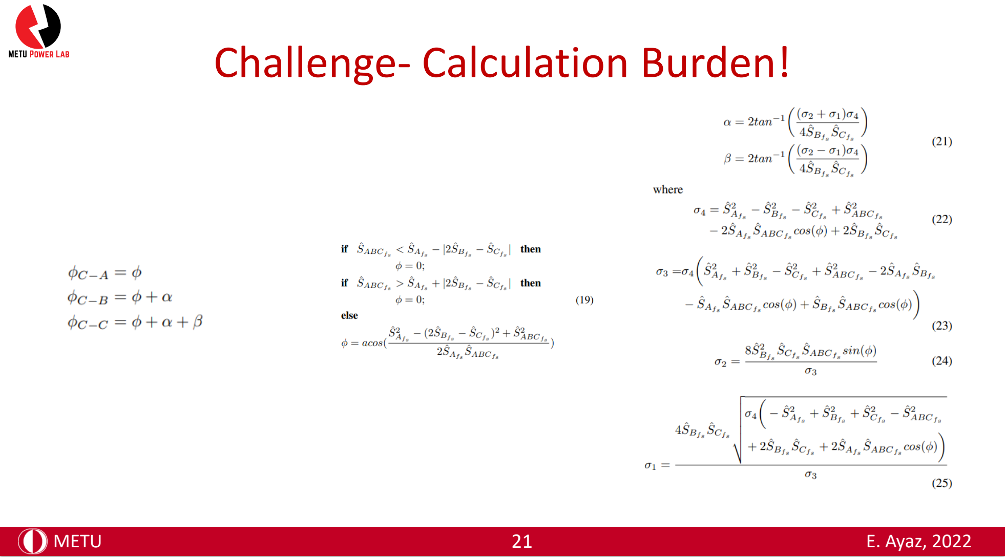
[picture p159: page 22]

METU | 21 | E. Ayaz, 2022

METU | 22 | E. Ayaz, 2022

# Thanks!

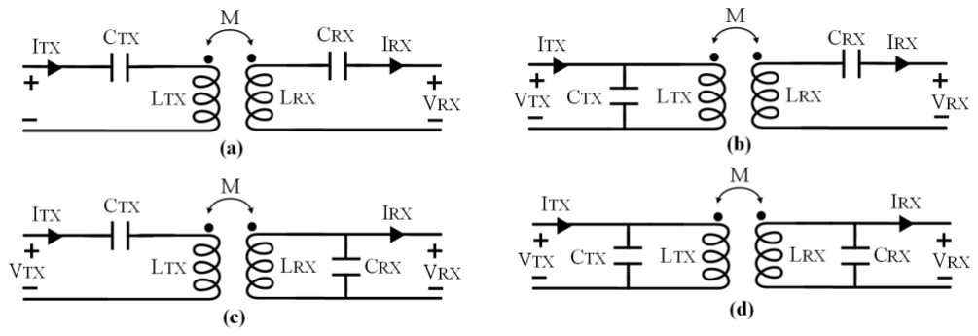
[picture p160: figure]

METU | 23 | E. Ayaz, 2022

# Compensation Topologies

# a) Series-series b) Parallel-series c) Series-parallel d) Parallel-parallel

# Series-Series Compensation

Source Type | Voltage Source
Resonant frequency | Load Independent
Resonant frequency | Coupling Independent
No load operation | Short Circuit
Capacitor Size | Large

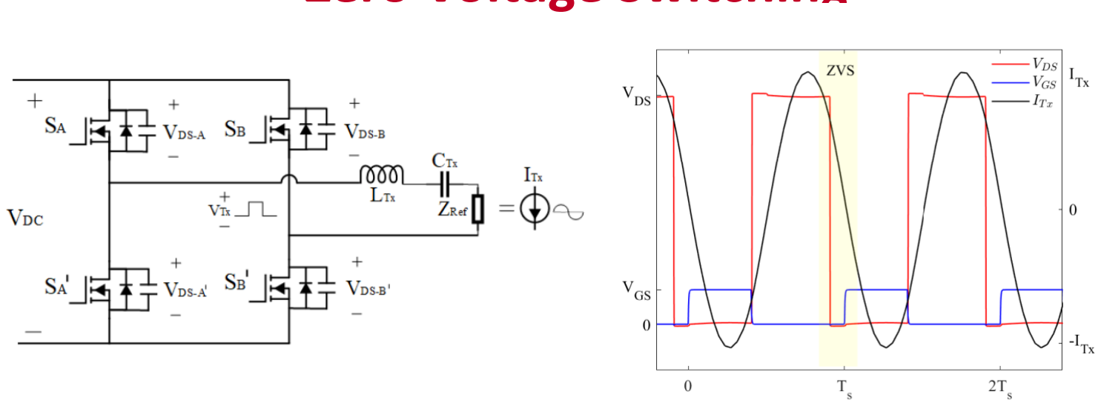
[picture p161: figure]

METU | 24 | E. Ayaz, 2022

# Zero Voltage Switching

Inductive region → The capacitance of the switches discharges by the load current during dead time.

# Bifurcation Phenomenon

# Double-peak

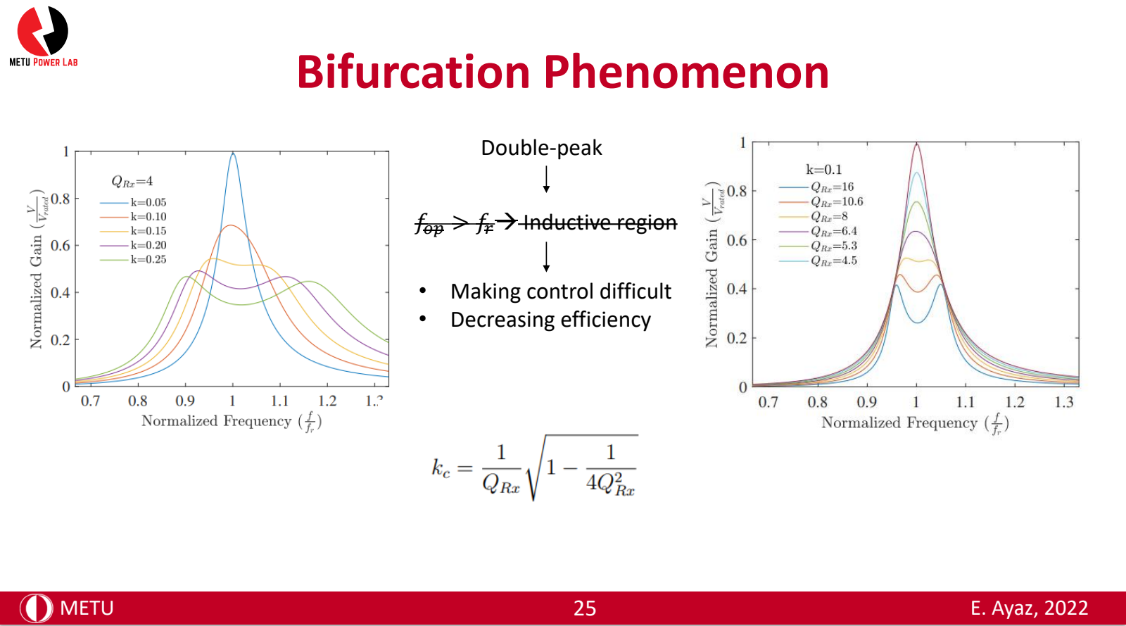
[picture p162: page 26]

METU | 25 | E. Ayaz, 2022

# - Making control difficult - Decreasing efficiency

# fop > fr→ Inductive region

# Wireless Power Transfer System Design Procedure

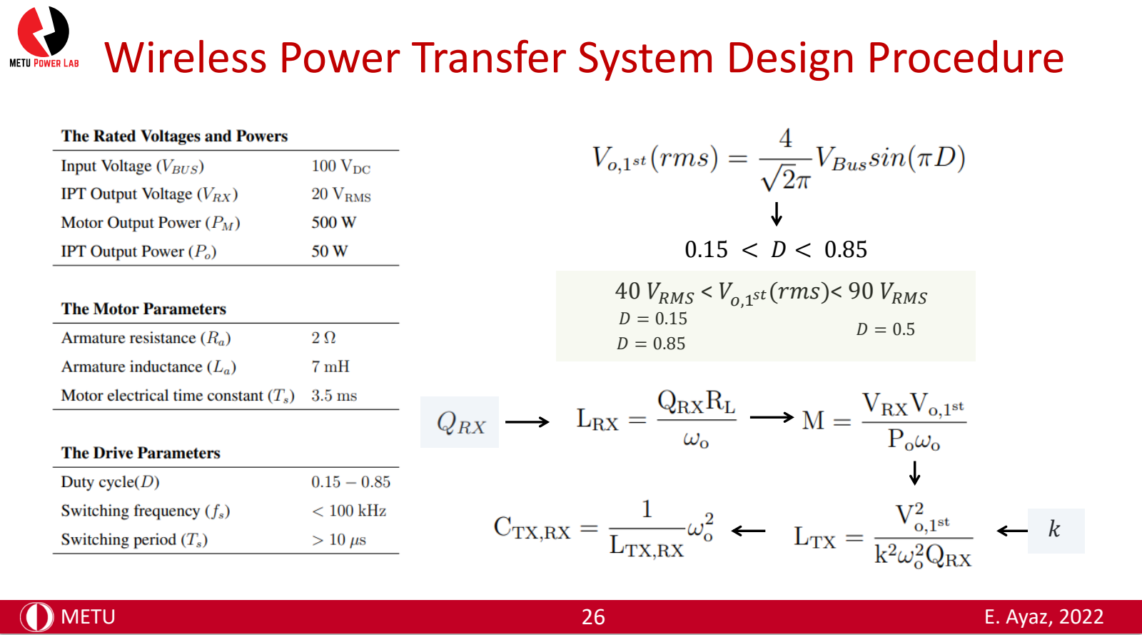
[picture p163: page 27]

METU | 26 | E. Ayaz, 2022

0.15 < D < 0.85

## 40 VRMS < Vo,1

# st(rms)< 90 VRMS

k

D = 0.15
D = 0.85

D = 0.5

# Wireless Power Transfer System Design

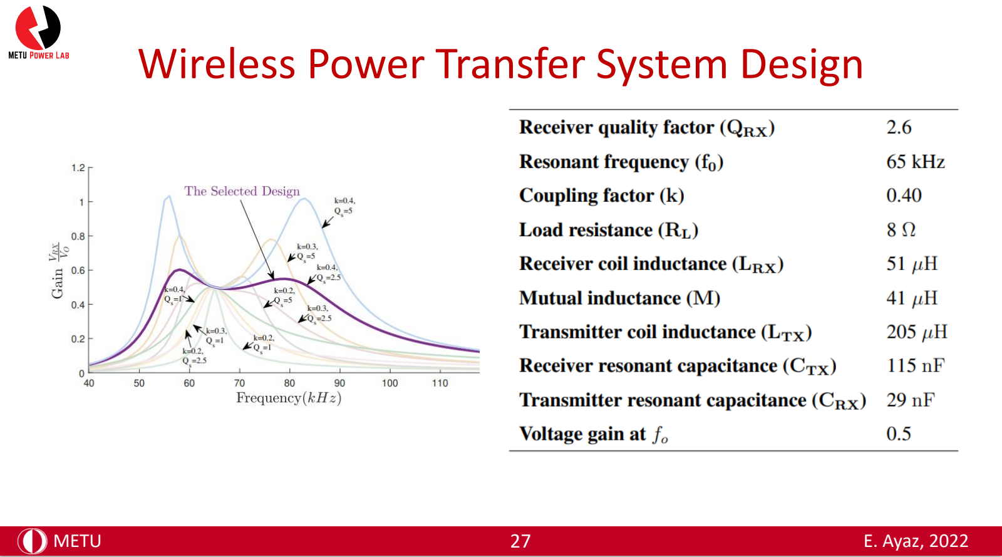
[picture p164: page 28]

METU | 27 | E. Ayaz, 2022

# Wireless Power Transfer System Design

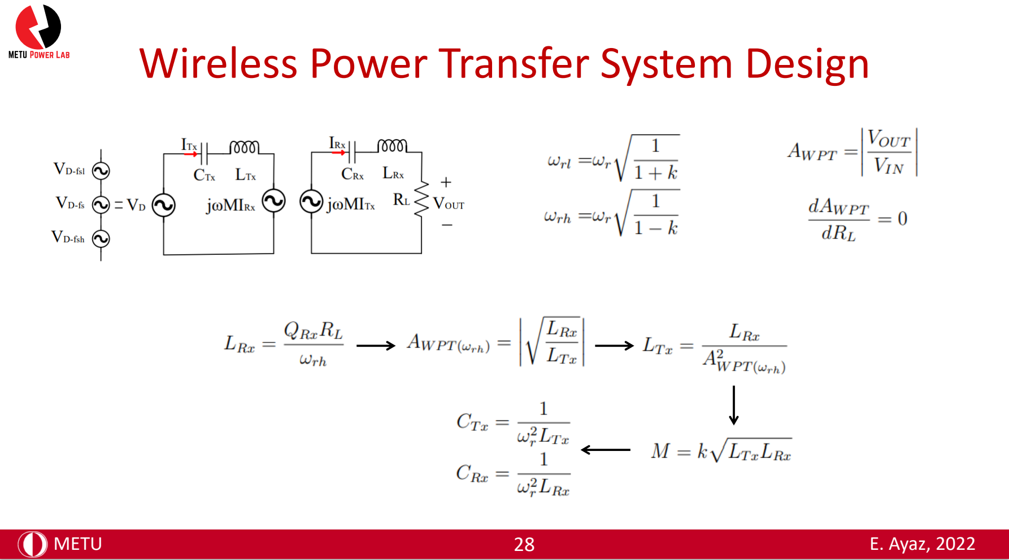
[picture p165: page 29]

METU | 28 | E. Ayaz, 2022

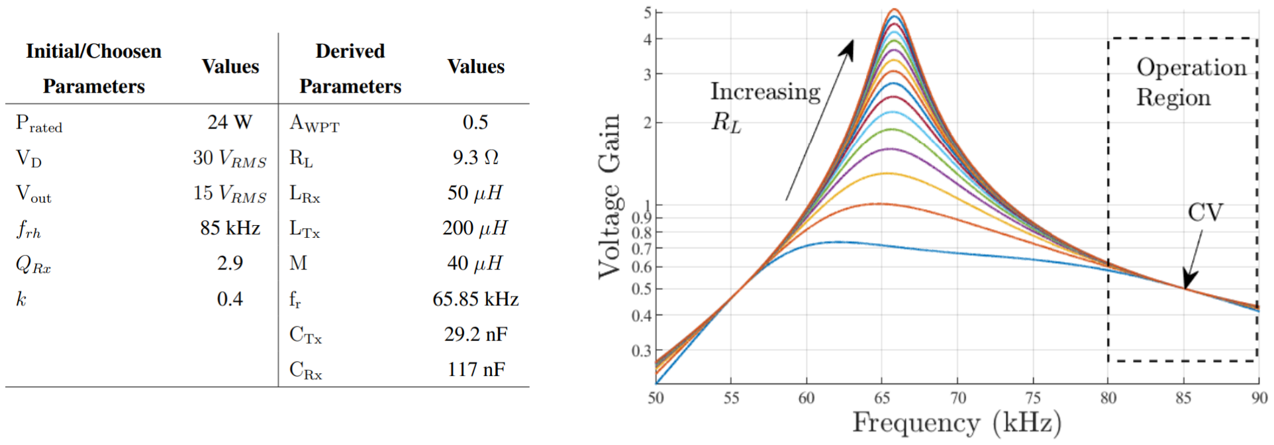
[picture p166: figure]

METU | 29 | E. Ayaz, 2022

# Wireless Power Transfer System Design

# Experimental Results- WPT System Validation

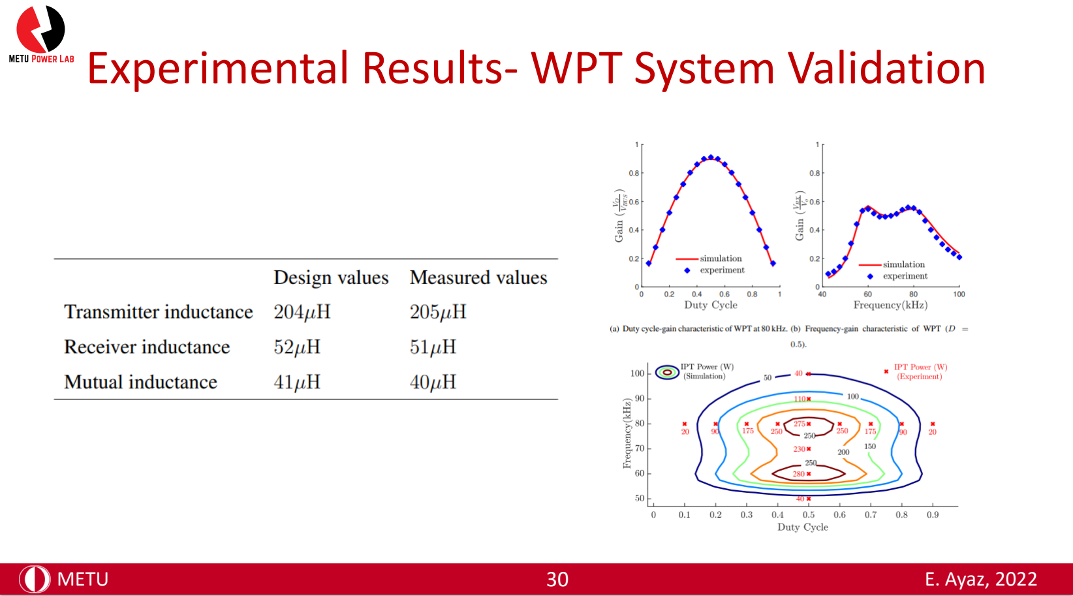
[picture p167: page 31]

METU | 30 | E. Ayaz, 2022

# Wireless Power Transfer System Design

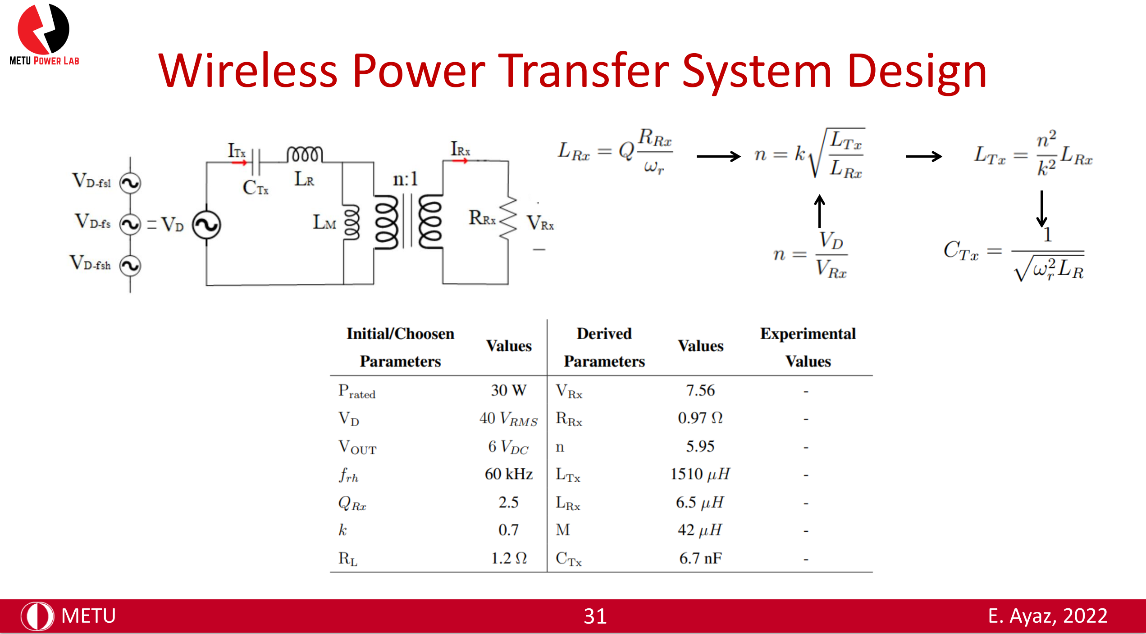
[picture p168: page 32]

METU | 31 | E. Ayaz, 2022
