EnesAyaz/WPTMotor/Presentation/2020.02.08-v2.pdf

Parameters:

M => modulation index
ωo=> output(fundamental) frequency ωc => carrier(switching) frequency θo => output phase
θc => carrier phase

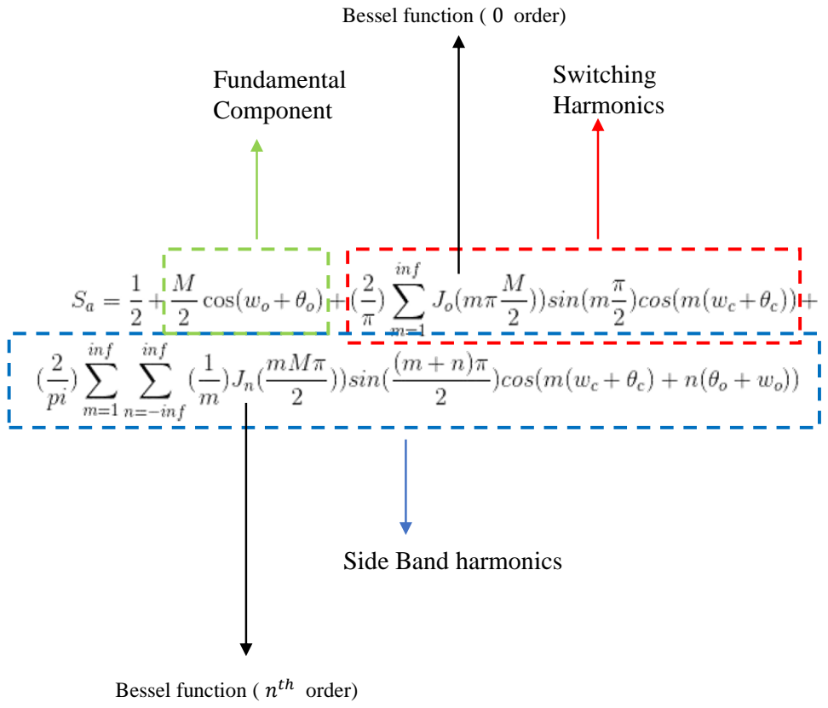
[picture p169: figure]
Side Band harmonics; Fundamental Component; Switching Harmonics; Bessel function ( n; tℎ order); Bessel function ( 0 order)

### Deductions

- Fundamental component is independent from carrier(switching) frequency and phase
- There is no even harmonics of the switching and the sign of the odd harmonics is alternated.
- The switching harmonics are independent from fundamental frequency and phase.
- The side band harmonics are affected by all fundamental and carrier frequency and phases.

## Sequences of the Switching Harmonics and Side Bands

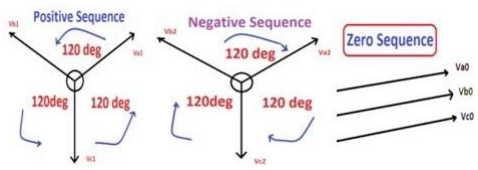
[picture p170: figure]

## If the fundamental is positive sequences

Frequency | Phase A | Phase B | Phase C
fo | o θo = 0 | θo= 120 o | θo = −120 o
fs − 4fo | o 0 | 240o | 120o
fs − 2fo | 180o | 300o | 60o
fs | o 0 | 0 o | 0 o
fs + 2fo | 180o | 60o | 300o
fs + 4fo | o 0 | 120o | 240o

## Switching Harmonics

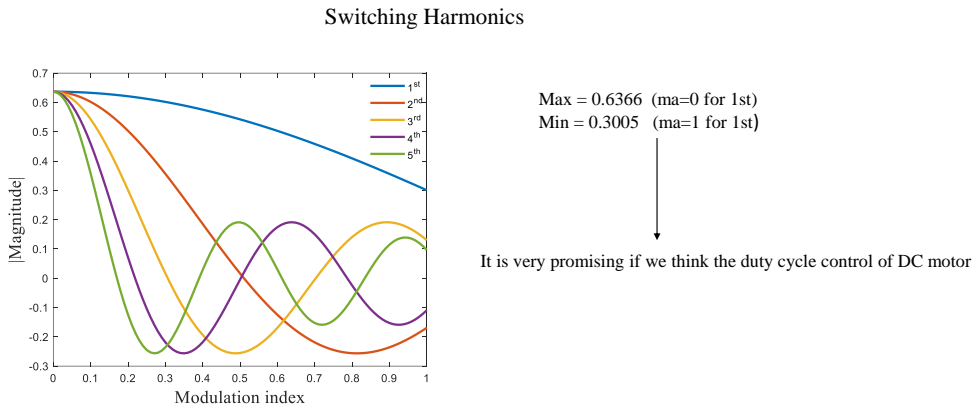
[picture p171: page 3]

Max = 0.6366 (ma=0 for 1st)
Min = 0.3005 (ma=1 for 1st)

It is very promising if we think the duty cycle control of DC motor

## Side Band Harmonics

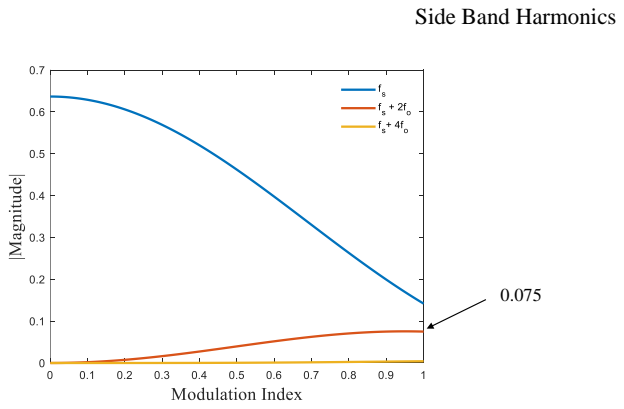
[picture p172: page 4]

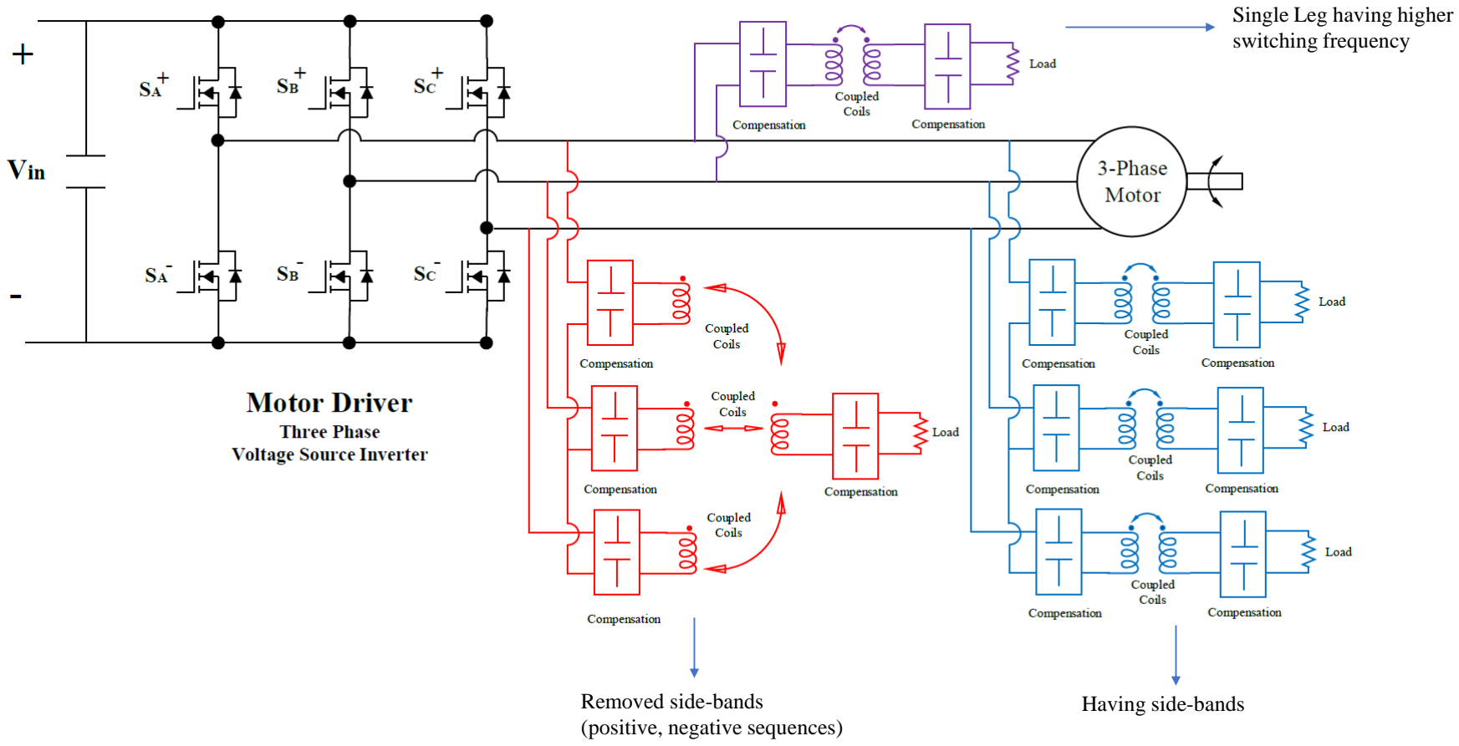
[picture p173: page 5]

Single Leg having higher
switching frequency
Removed side-bands | Having side-bands
(positive, negative sequences)

ma=0.5 | ma=0.9

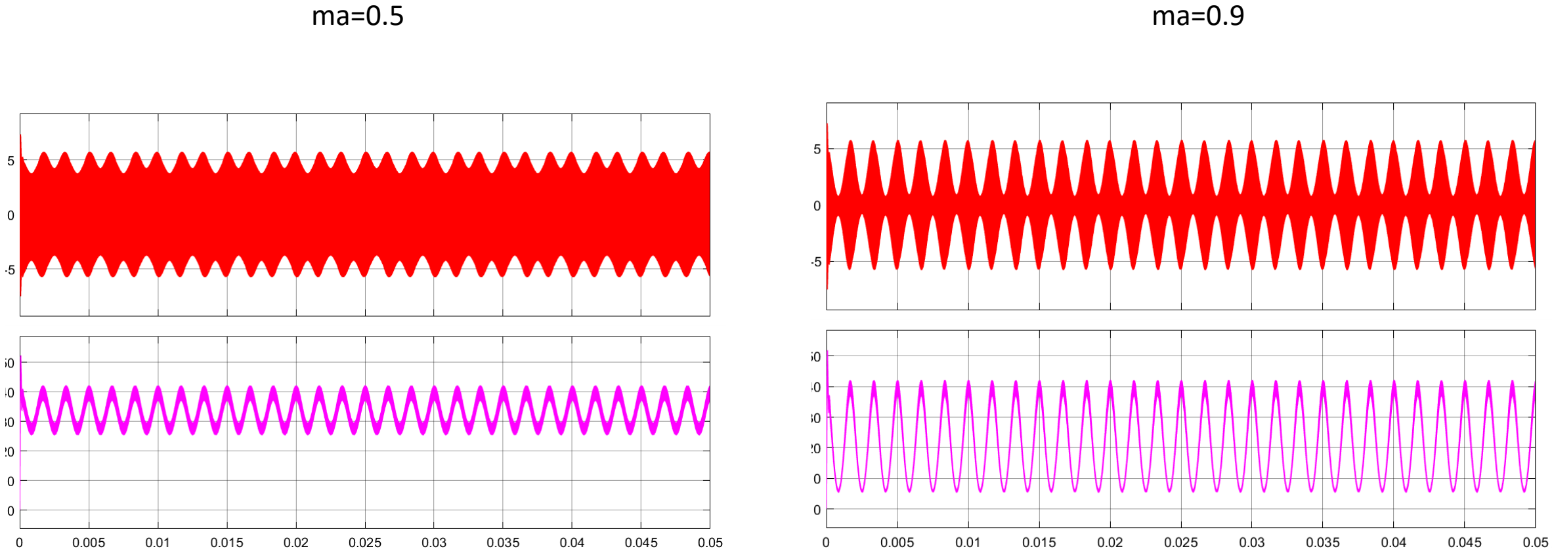
[picture p174: page 6]
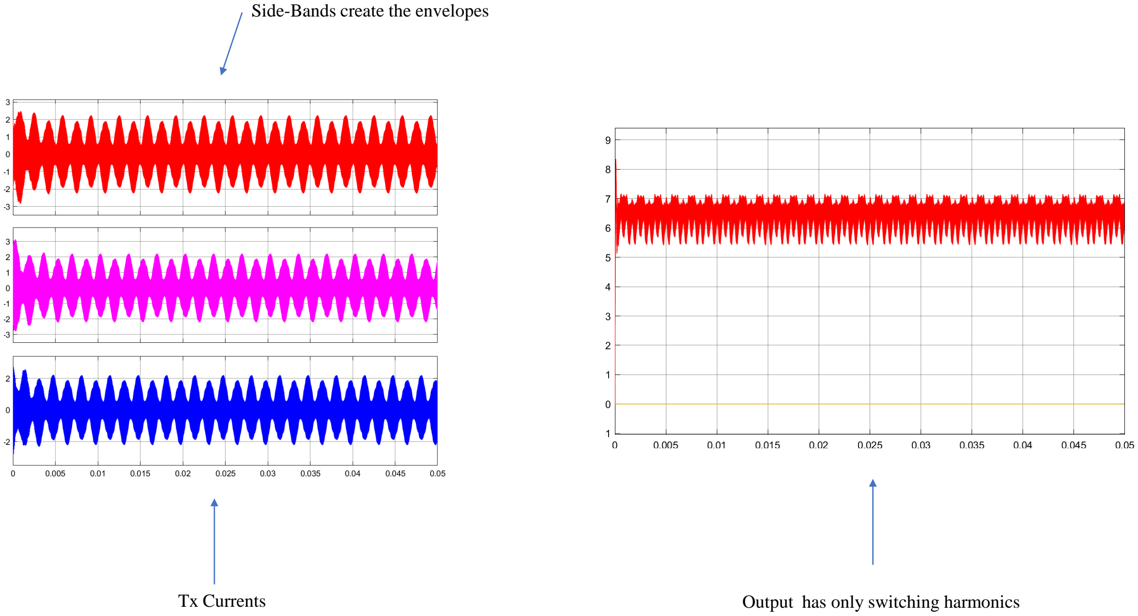
[picture p175: page 7]

Tx Currents

Side-Bands create the envelopes

Output has only switching harmonics

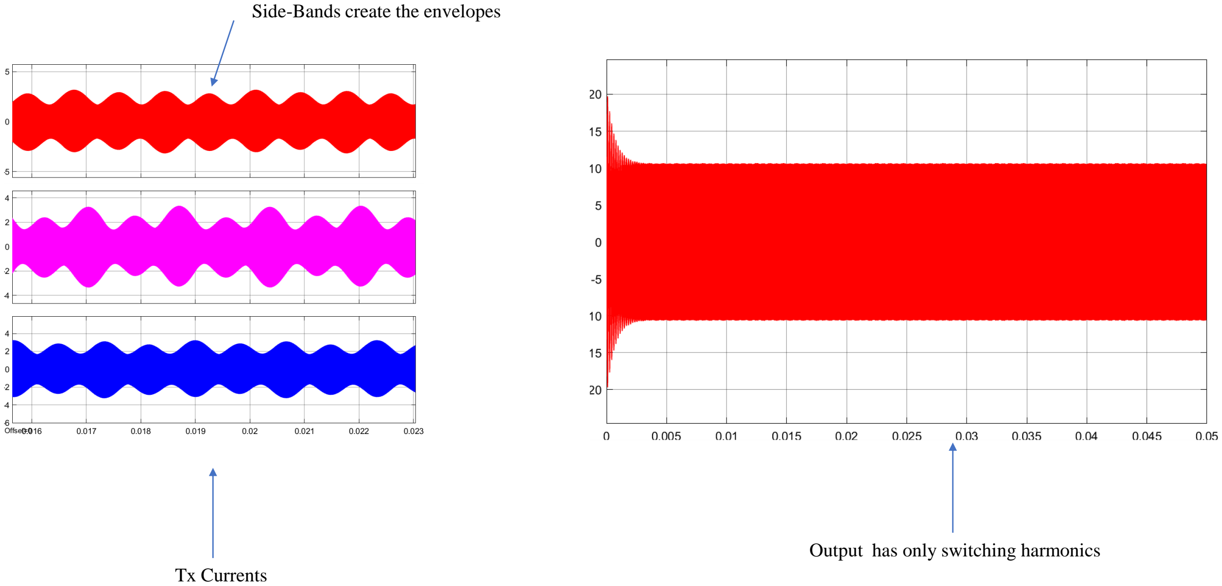
[picture p176: page 8]

Tx Currents

Side-Bands create the envelopes

Output has only switching harmonics
