EnesAyaz/WPTMotor/Narrowband-Wideband/Drawings/SPWM-first.pdf

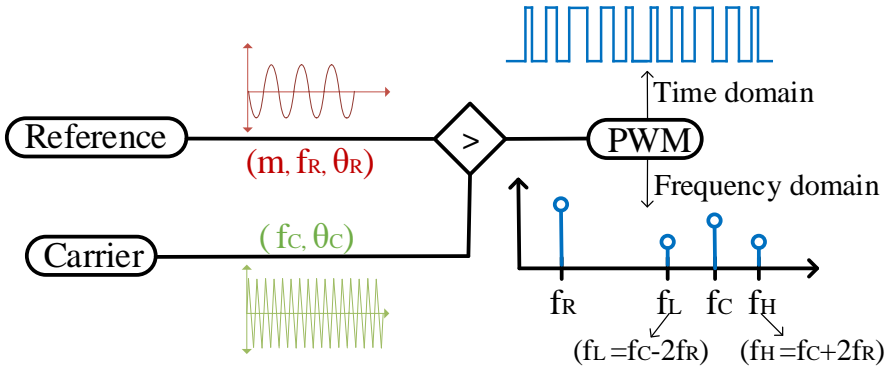
[picture p177: figure]
Time domain; Frequency domain; Reference; PWM; Carrier
