EnesAyaz/WPTMotor/Synhronous motor/TPEL-Journal-version-2/Time-domain-problem definitions/New Microsoft PowerPoint Presentation.pptx

m_a =0

U_i

Zero
Excitation

U_i^f

m_a =0.25

m_a =0.50

m_a =0.75

m_a =1

U_i / U_i^f (p.u)

Fundamental phase (rad)

## Slide 2

φ_B =41^o

m_a =0

m_a =0.25

φ_B =43^o

m_a =0.50

φ_B =48^o

m_a =0.75

φ_B =53^o

φ_B =50^o

m_a =1

U_i

U_i / U_i^f (p.u)

U_i^f

Fundamental phase (rad)

## Slide 3

U_i

Zero
Excitation

U_i^f

m_a =0

m_a =0.25

m_a =0.50

m_a =0.75

m_a =1

## Slide 4

φ_B =46^o

U_i^f

φ_B =48^o

φ_B =53^o

φ_B =62^o

φ_B =74^o

U_i

m_a =0

m_a =0.25

m_a =0.50

m_a =0.75

m_a =1

## Slide 5

φ_B =41^o

U_i^f

φ_B =43^o

φ_B =48^o

φ_B =53^o

φ_B =50^o

U_i

m_a =0

m_a =0.25

m_a =0.50

m_a =0.75

m_a =1

## Slide 6

Zero excitation

Zero excitation

Zero excitation

Zero excitation

Zero excitation

Zero excitation

m_a =0.25

Zero excitation

m_a =0.50

Zero excitation

m_a =0.75

Zero excitation

m_a =1

m_a =0

## Slide 7
