EnesAyaz/WPTMotor/Thesis/Visio/chapter4/Ansys.pptx

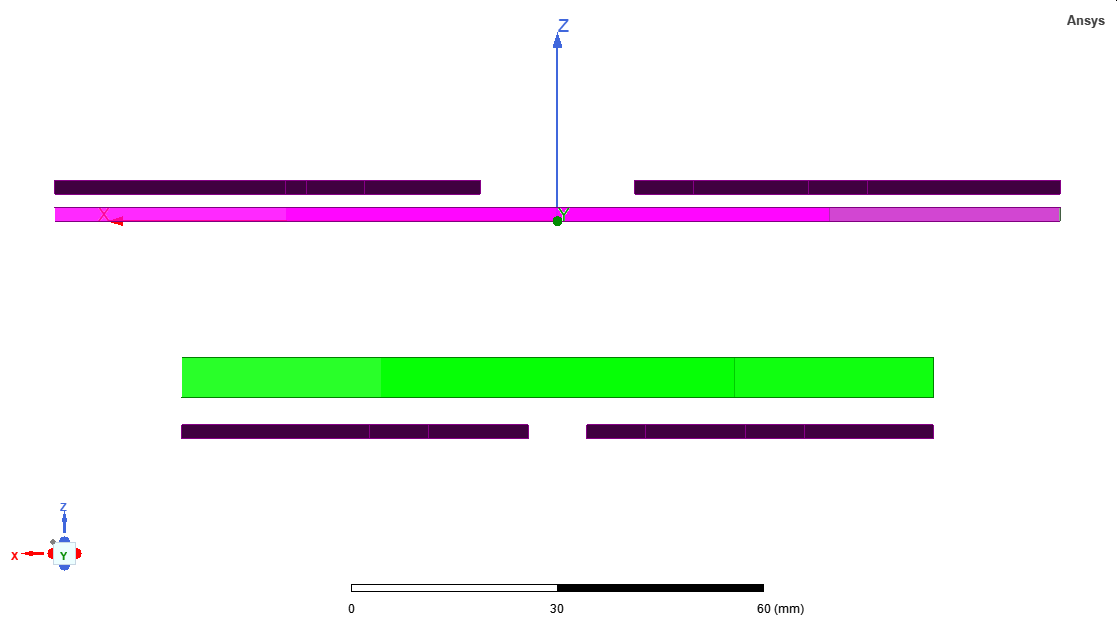
[picture p191: figure]
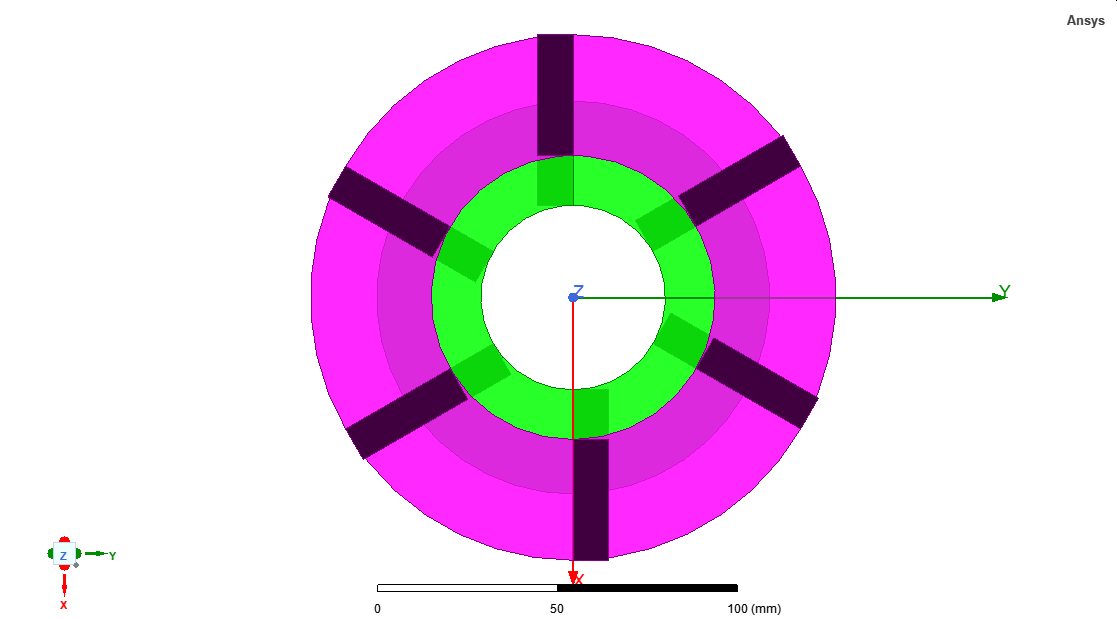
[picture p192: figure]
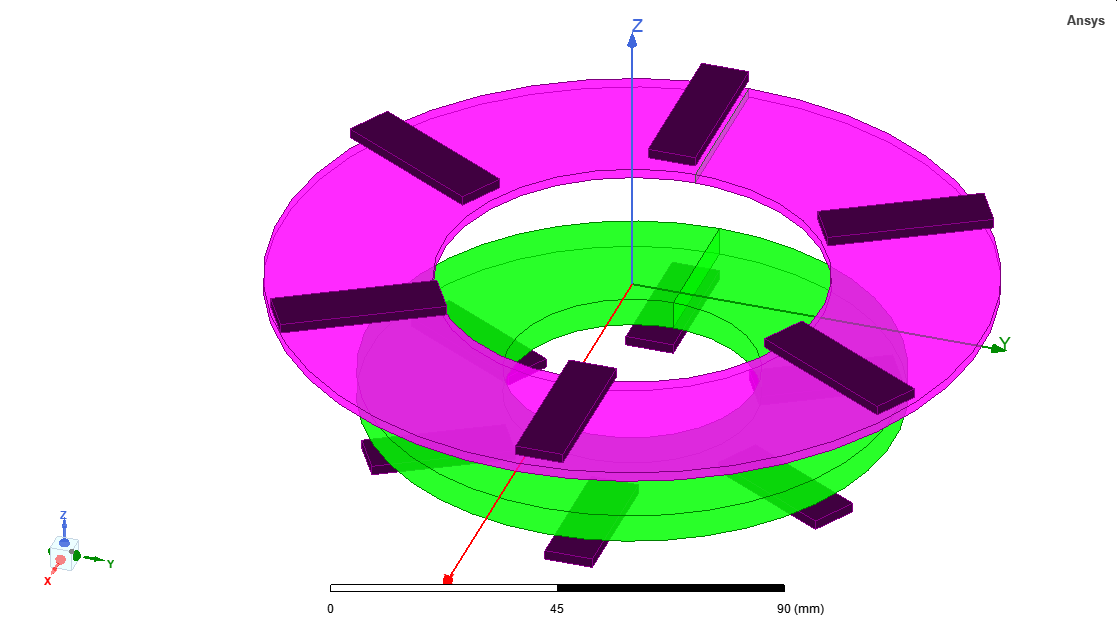
[picture p193: figure]

## Slide 2

## Slide 3

## Slide 4

## Slide 5

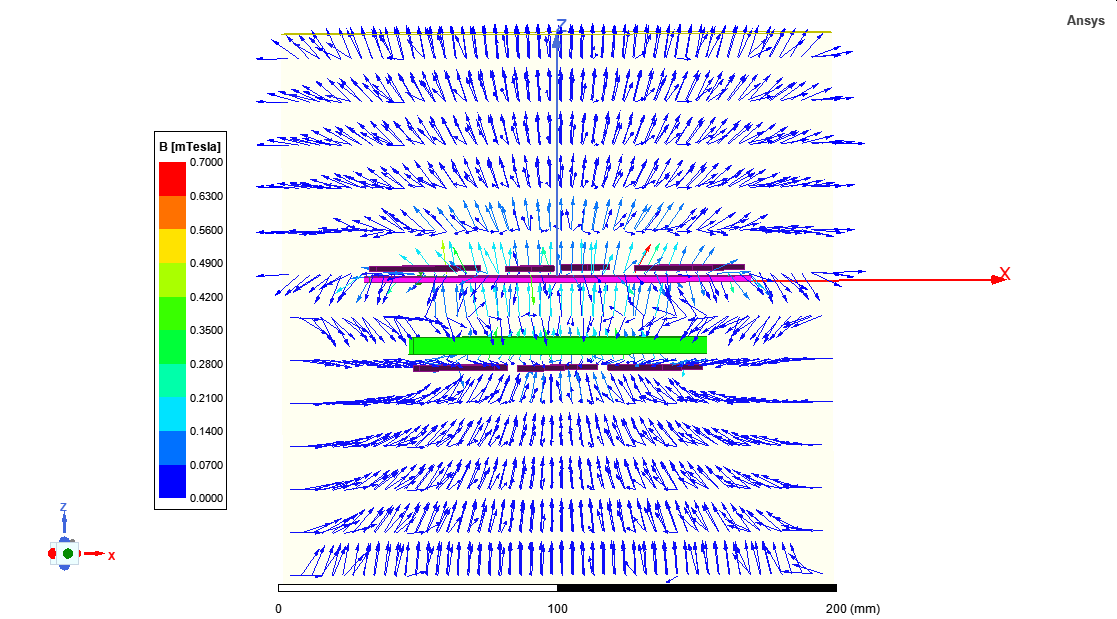
[picture p194: figure]
