EnesAyaz/WPTMotor/Presentation/2020.01.25.pptx

The same phenomena for load change

Bifurcation → 0.39

Lp= 1.9 mH
Lp=0.84 mH
Lp=0.47 mH
Lp=0.36 mH
Lp=0.21 mH
Lp=0.11 mH
Lp=0.07 mH
