EnesAyaz/WPTMotor/Narrowband-Wideband/Matlab/New Microsoft PowerPoint Presentation.pptx

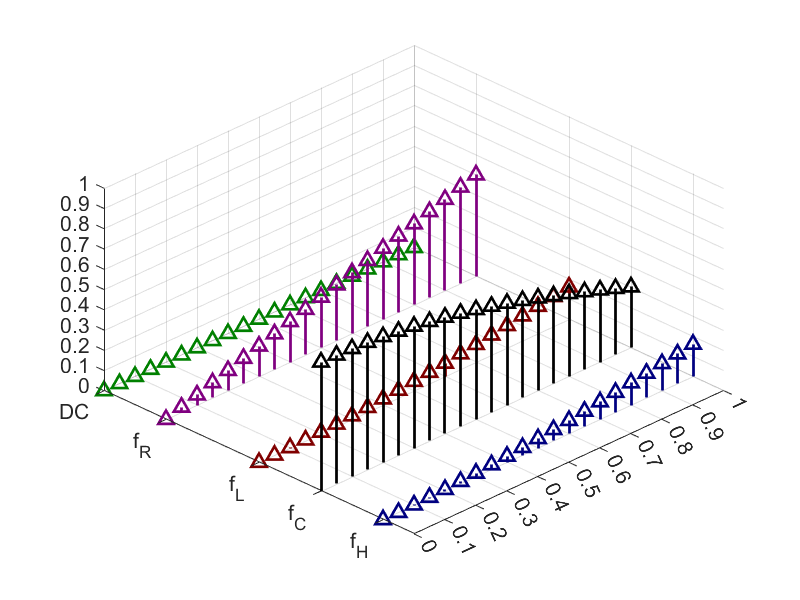
[picture p195: figure]
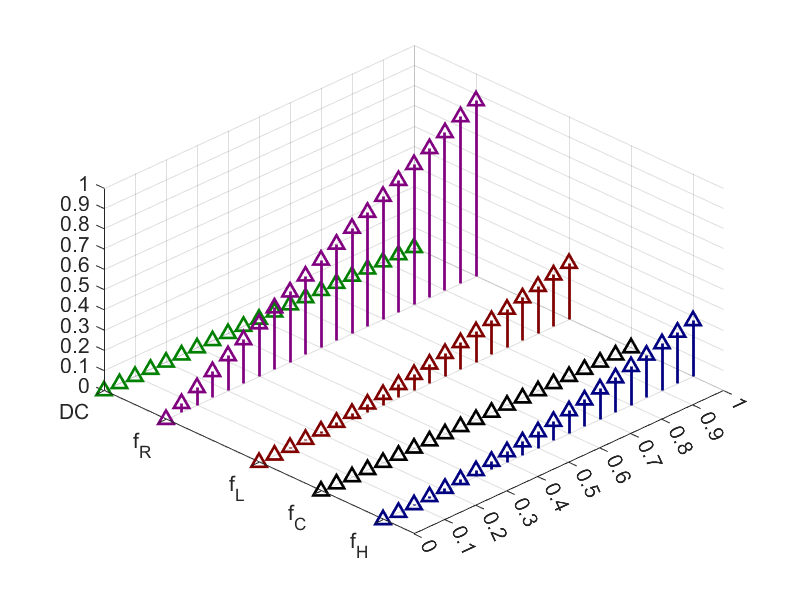
[picture p196: figure]

Modulation Index

Frequency

Modulation Index

Frequency

(a)

(b)

## Slide 2

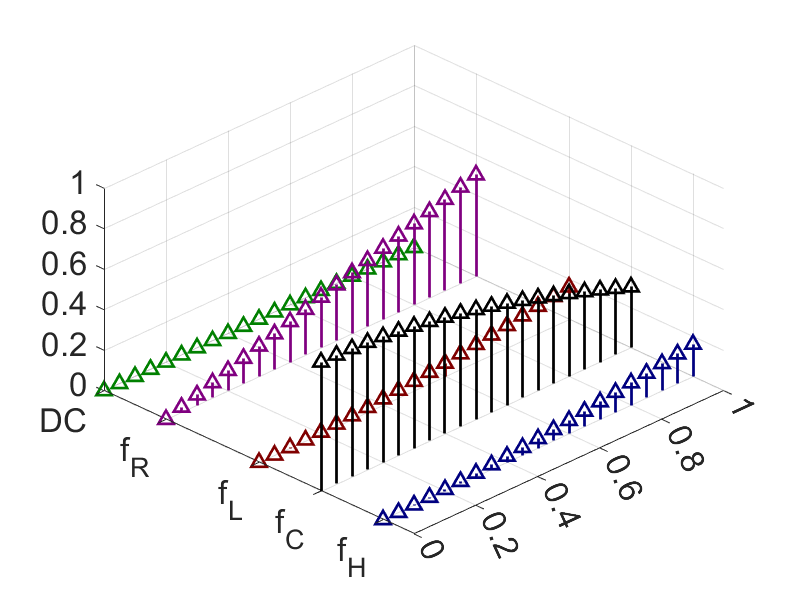
[picture p197: figure]
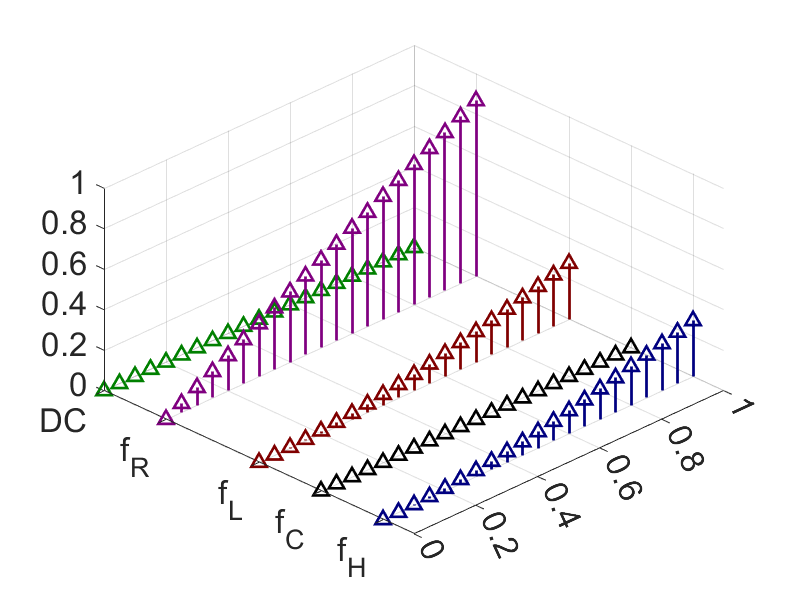
[picture p198: figure]

Modulation
Index

Modulation
Index

Frequency

(a)

Frequency

(b)
