EnesAyaz/WPTMotor/Narrowband-Wideband/Figures-pptx/Narrow-Wide.pptx

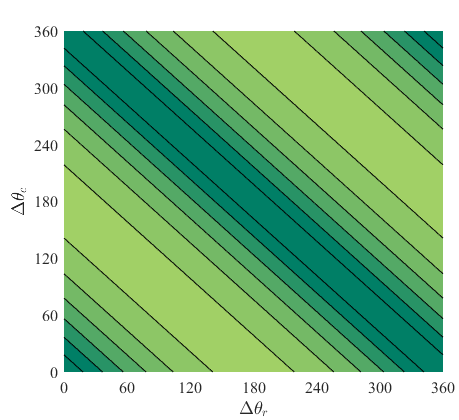
[picture p199: figure]

(a)

(b)

## Slide 2

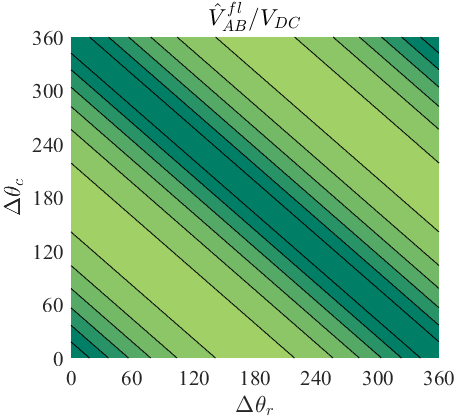
[picture p200: figure]

(a)

(b)

## Slide 3

(a)

(b)

## Slide 4

(a)

(b)
