EnesAyaz/WPTMotor/Synhronous motor/Matlab/New Microsoft PowerPoint Presentation.pptx

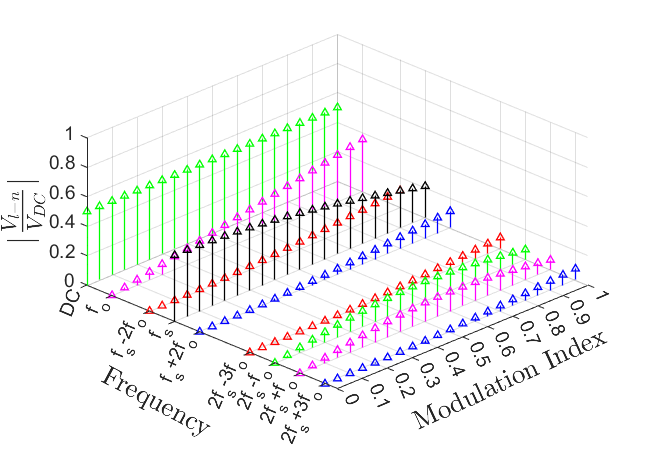
[picture p201: figure]
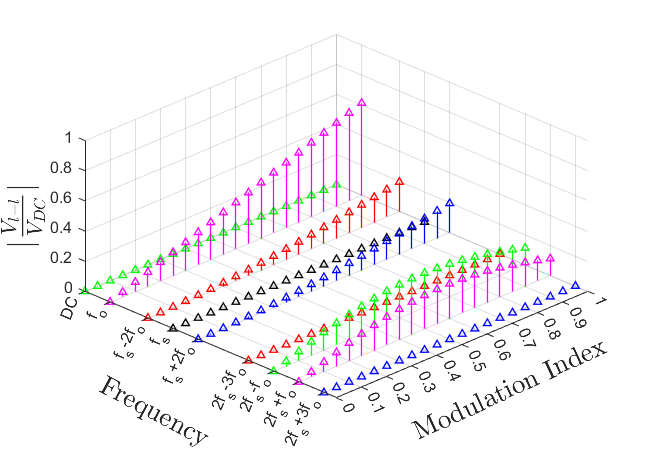
[picture p202: figure]

(a)

(b)

## Slide 2

(a)

(b)
