EnesAyaz/WPTMotor/Synhronous motor/TPEL-Journal-version-2/WPT-Design/FHA.pdf

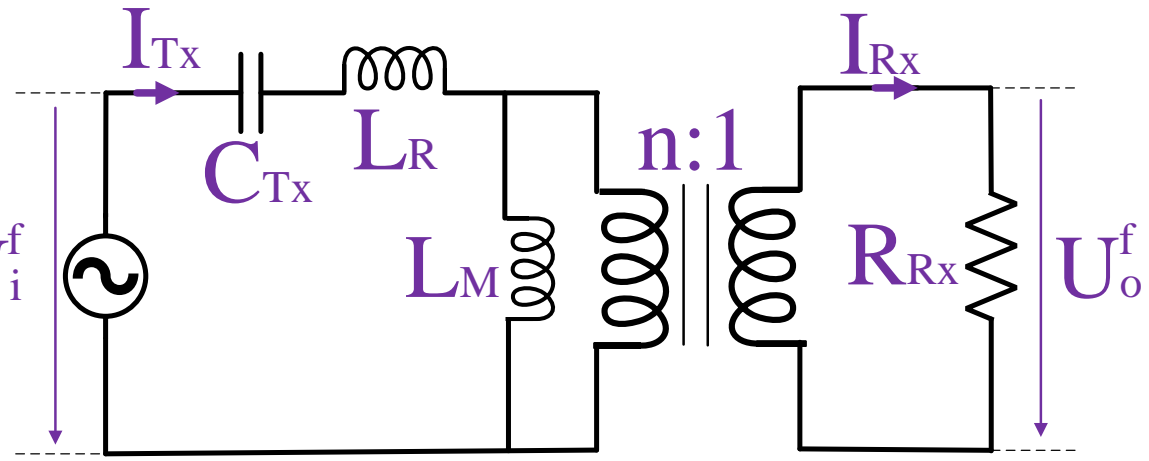
[picture p203: figure]
RRx; CTx; ITx; IRx

U
