EnesAyaz/WPTMotor/Thesis/Visio/chapter-3/SM_electric_circuit_v2.pdf

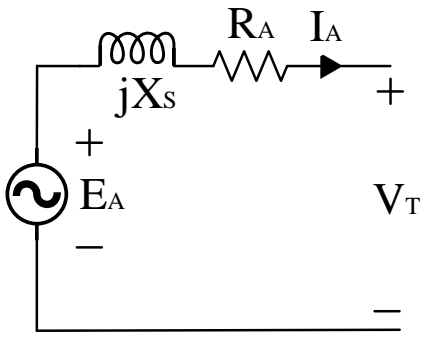
[picture p204: figure]
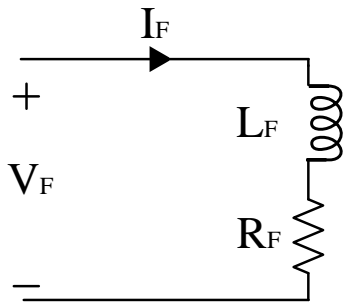
[picture p205: figure]
