EnesAyaz/WPTMotor/Journal-DC-Motor/v1.0/Design_consideration/gain.pptx

## Slide 2

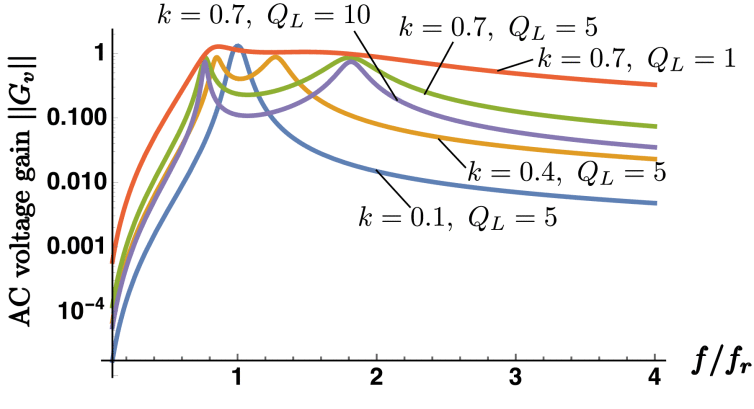
[picture p209: figure]
