EnesAyaz/WPTMotor/Journal-DC-Motor/v1.0/Design_consideration/Capacitor_current.xlsx

 | Duty
 | 0.5 |  | 0.6 |  | 0.7 |  | 0.8 |  | 0.9
Harmonic | Im | Itx | Im | Itx | Im | Itx | Im | Itx | Im | Itx
1 | 6.366 | 0 | 6.055 | 0.0968 | 5.198 | 0.4765495 | 3.742 | 1.51 | 1.967 | 3.07
2 | 0 | 2.150829 | 1.870995 | 2.404875 | 2.999246 | 2.88267 | 3.027278 | 2.869 | 1.86865 | 1.838623
3 | 2.10078 | 0 | 1.24733 | 0.18755 | 0.576978 | 1.002442 | 2.016938 | 1.9781 | 1.715224 | 1.6885
4 | 0 | 0.435249 | 1.51375 | 0.62315 | 1.000615 | 0.347998 | 0.9355 | 1.01019 | 1.5122296 | 1.491406
5 | 1.2732 | 0 | 0 | 0.255915 | 1.27351 | 0.7791 | 0 | 0.162778 | 1.2714688 | 1.258086
6 | 0 | 0.193797 | 1.011185 | 0.2662 | 0.556186 | 0.457072 | 0.624914 | 0.43488 | 1.007104 | 1.001434
7 | 0.910338 | 0 | 0.5370785 | 0.27225 | 0.3576224 | 0.114268 | 0.8692666 | 0.692788 | 0.7338877 | 0.735879
8 | 0 | 0.1127835 | 0.471079 | 0.0741125 | 0.7828188 | 0.44149 | 0.7618712 | 0.6342 | 0.466179 | 0.475543
0 |  | 3.177 |  | 3.025 |  | 2.597
