EnesAyaz/WPTMotor/BLDC-whatever/system_proposal_3VSC2.png

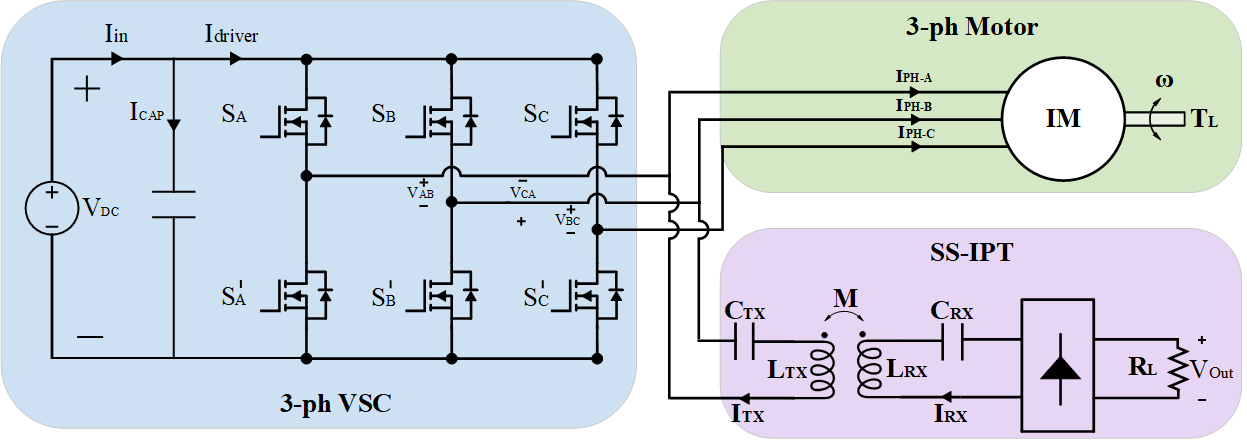
BLDC-whatever/system_proposal_3VSC2.png
