EnesAyaz/WPTMotor/BLDC-whatever/system_proposal_3VSC.png

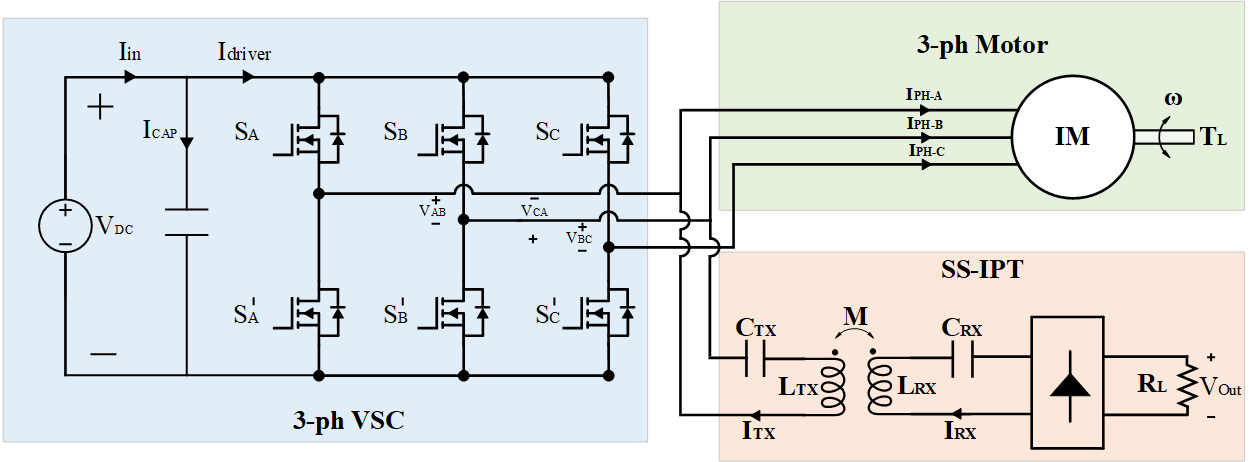
BLDC-whatever/system_proposal_3VSC.png
