EnesAyaz/WPTMotor/Journal-3-phase/eski/System Proposal/system_proposal_3VSC2.png

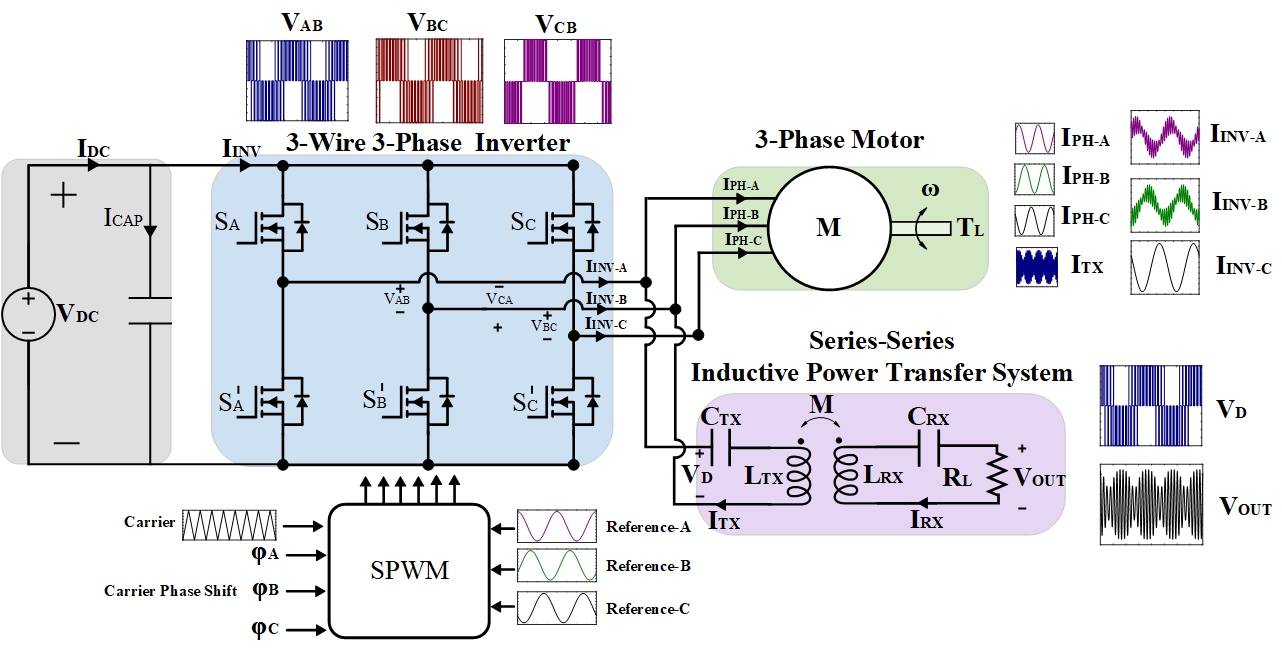
Journal-3-phase/eski/System Proposal/system_proposal_3VSC2.png
