EnesAyaz/WPTMotor/Narrowband-Wideband/Figures-pptx/narrow_band_control.png

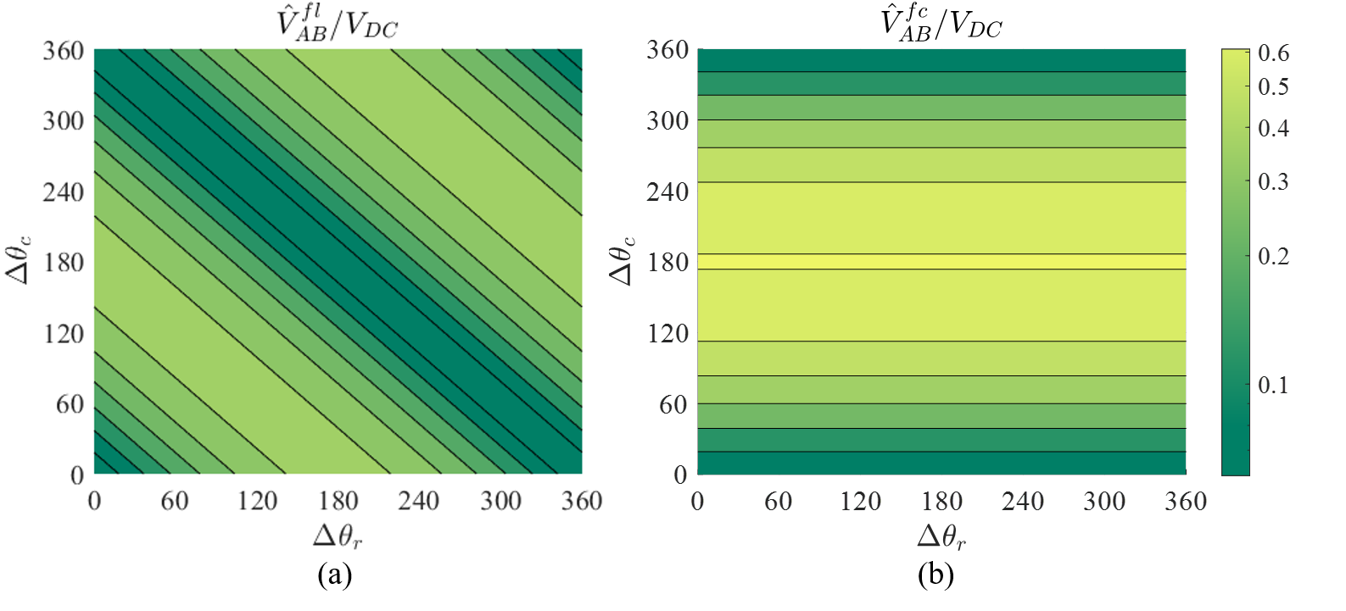
Narrowband-Wideband/Figures-pptx/narrow_band_control.png
