EnesAyaz/WPTMotor/Narrowband-Wideband/Figures-pptx/wide_band_control.png

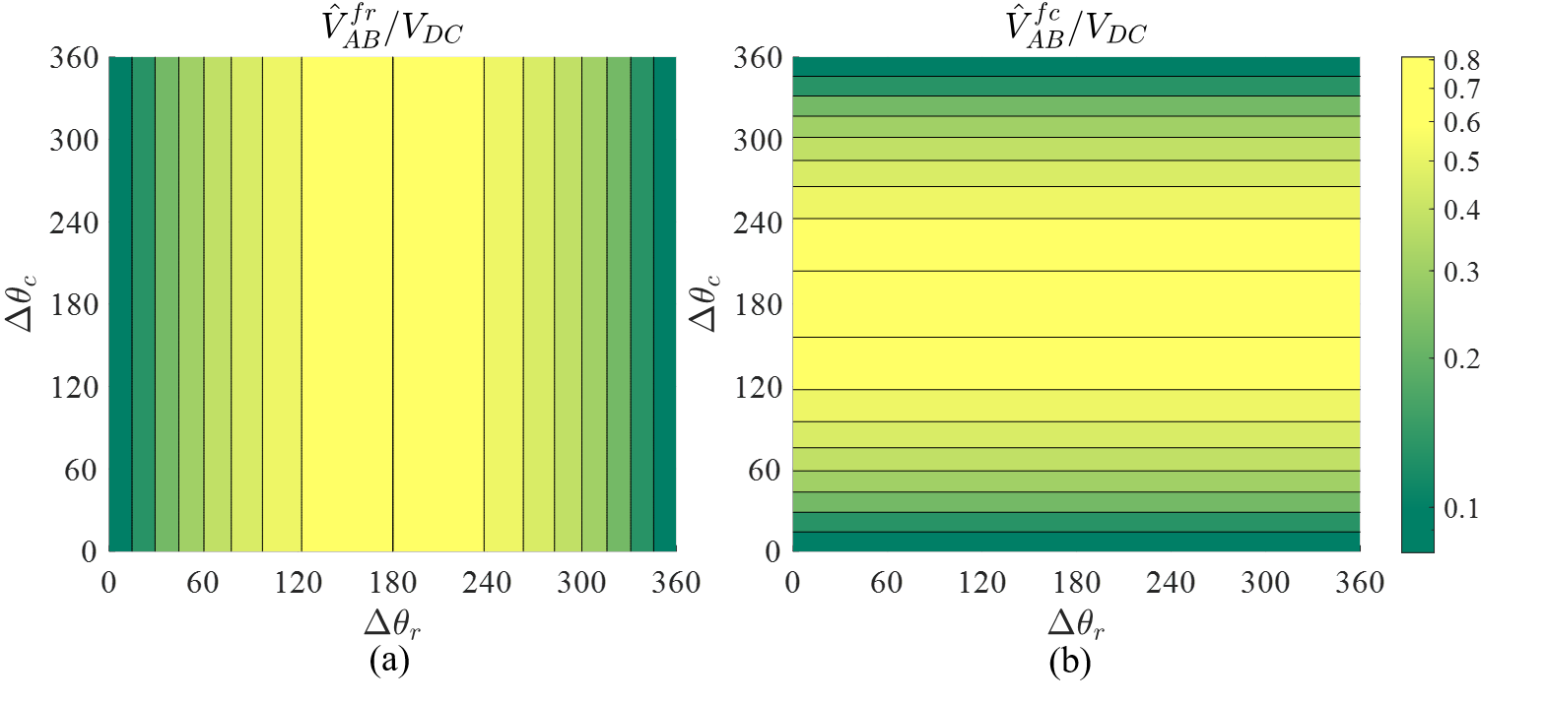
Narrowband-Wideband/Figures-pptx/wide_band_control.png
