EnesAyaz/WPTMotor/Narrowband-Wideband/Matlab/harmonic_dist_inv.png

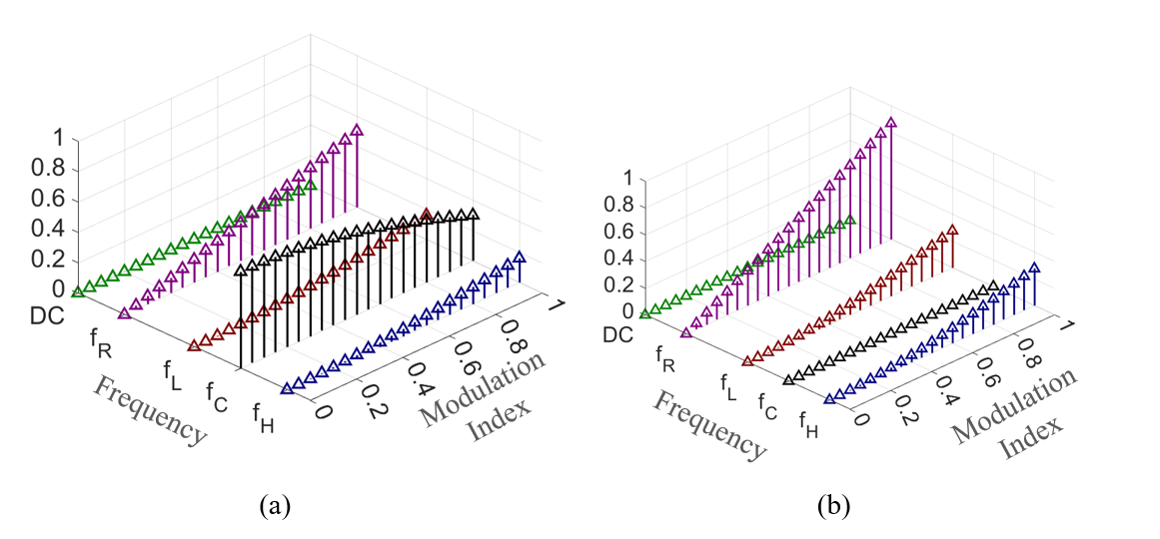
Narrowband-Wideband/Matlab/harmonic_dist_inv.png
