EnesAyaz/WPTMotor/Synhronous motor/Matlab/line-to-nl.PNG

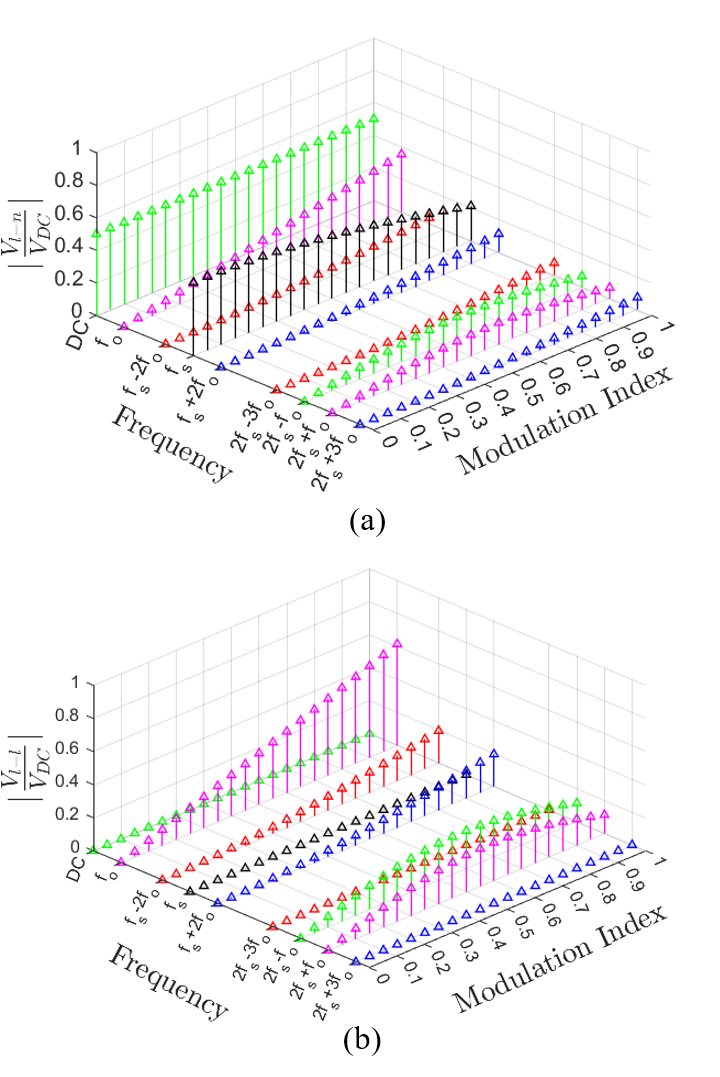
Synhronous motor/Matlab/line-to-nl.PNG
