EnesAyaz/WPTMotor/Synhronous motor/Matlab/SVPWM.PNG

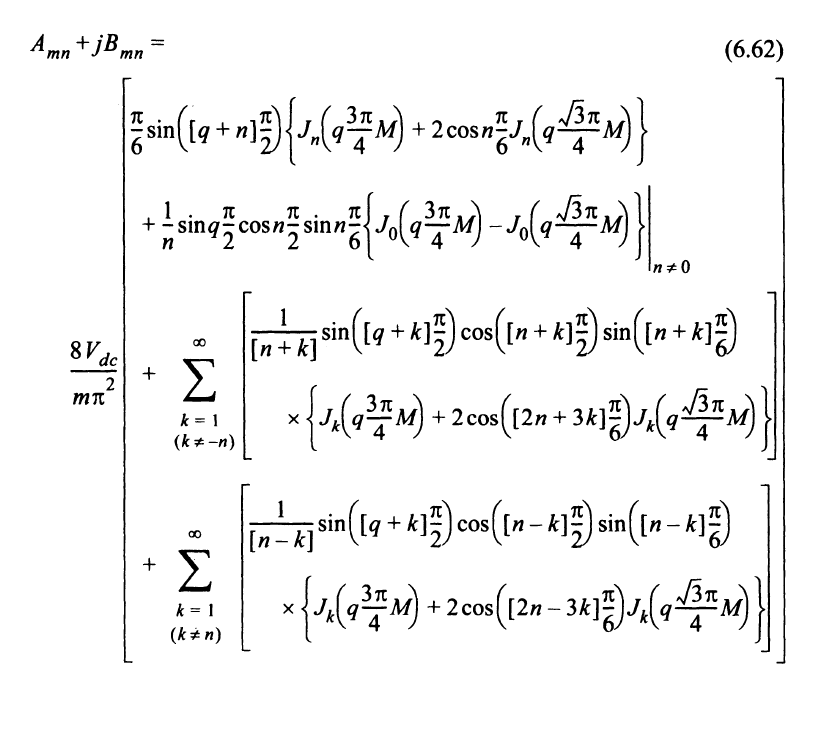
Synhronous motor/Matlab/SVPWM.PNG
