EnesAyaz/WPTMotor/Synhronous motor/TPEL-Journal-version-2/Time-domain-problem definitions/constant_carrier_modulation_sweep.png

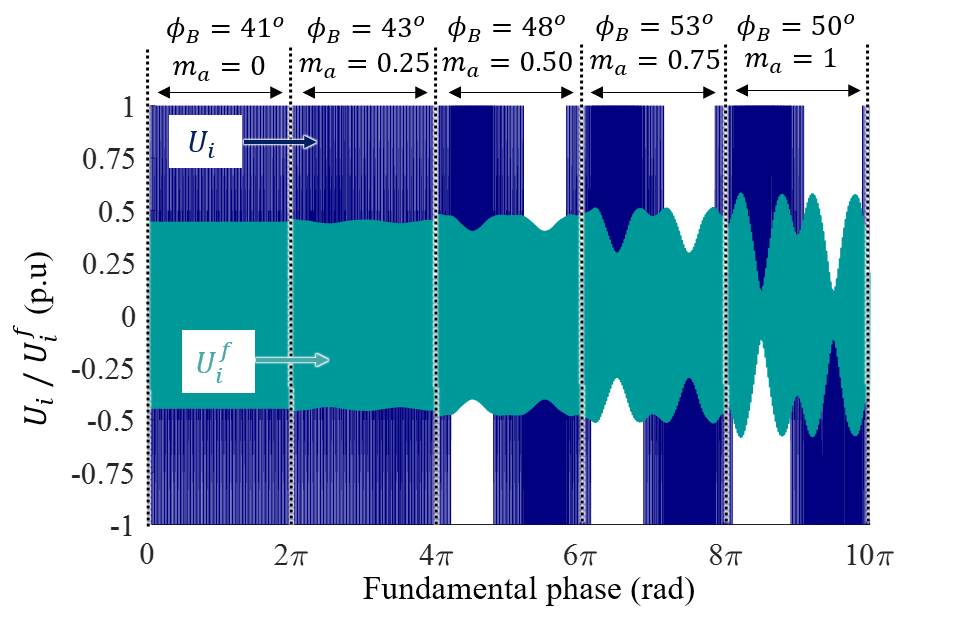
Synhronous motor/TPEL-Journal-version-2/Time-domain-problem definitions/constant_carrier_modulation_sweep.png
