EnesAyaz/WPTMotor/Synhronous motor/TPEL-Journal-version-2/Time-domain-problem definitions/without_carrier_modulation_sweep.png

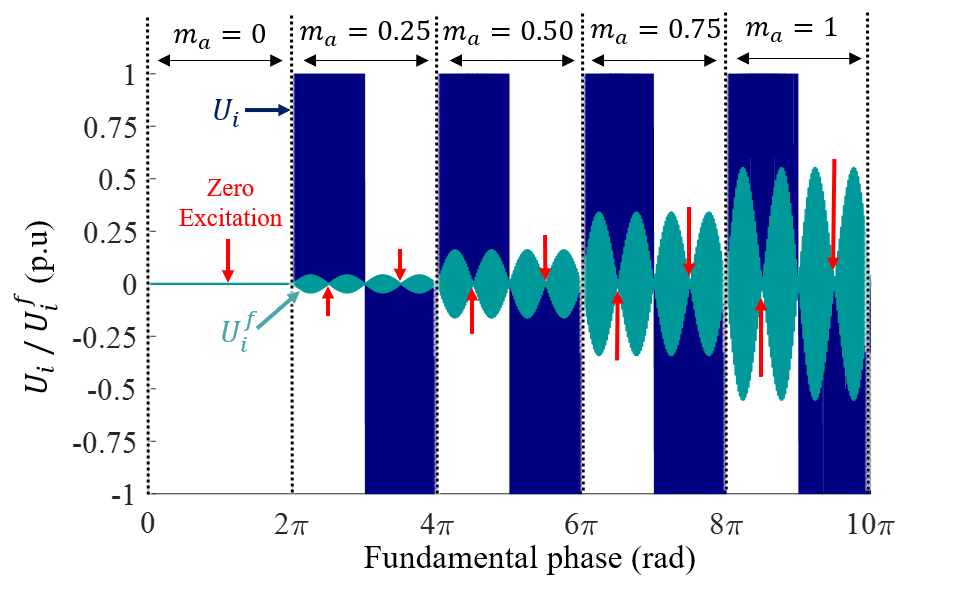
Synhronous motor/TPEL-Journal-version-2/Time-domain-problem definitions/without_carrier_modulation_sweep.png
