EnesAyaz/WPTMotor/Synhronous motor/TPEL-Journal-version-2/WPT-Design/FHA -SN - Copy.png

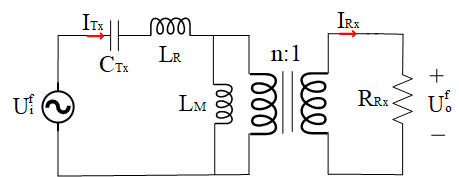
Synhronous motor/TPEL-Journal-version-2/WPT-Design/FHA -SN - Copy.png
