EnesAyaz/WPTMotor/Synhronous motor/TPEL-major-revision/Figures/SN-WPT/capacitance.png

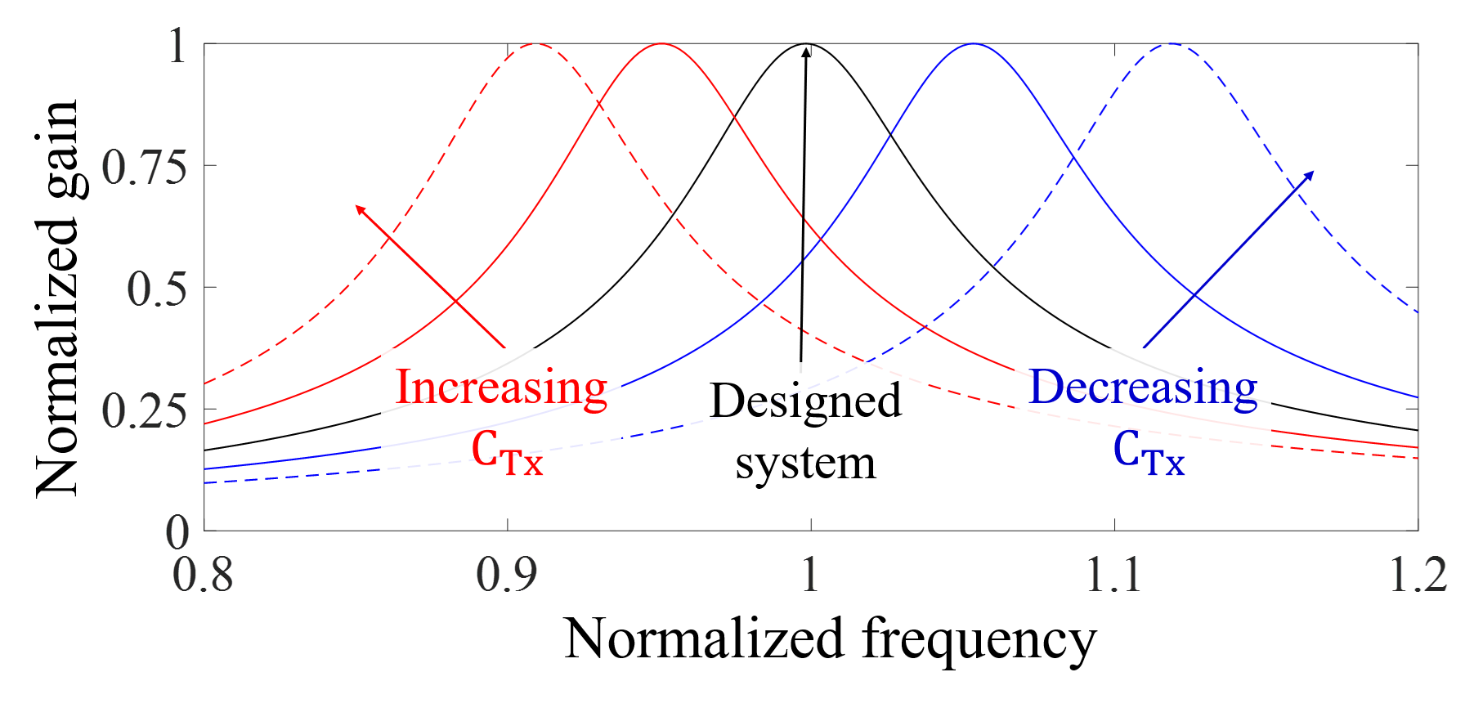
Synhronous motor/TPEL-major-revision/Figures/SN-WPT/capacitance.png
