EnesAyaz/WPTMotor/Synhronous motor/Visio/block_combined.PNG

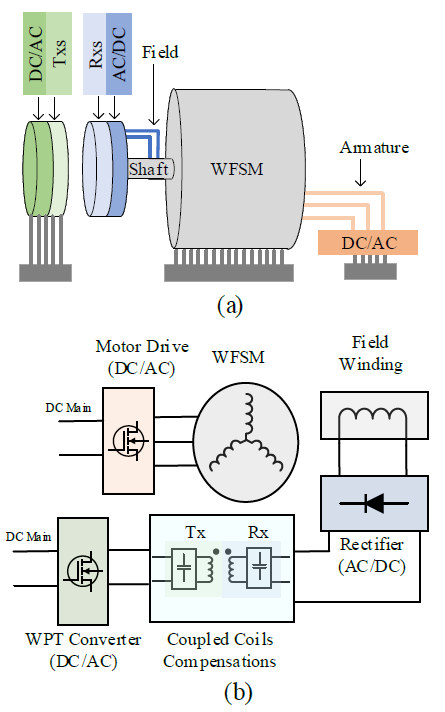
Synhronous motor/Visio/block_combined.PNG
