EnesAyaz/WPTMotor/Synhronous motor/Visio/block_conventional_combined.png

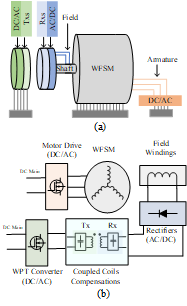
Synhronous motor/Visio/block_conventional_combined.png
