EnesAyaz/WPTMotor/Synhronous motor/Visio/block_diagram_v2.PNG

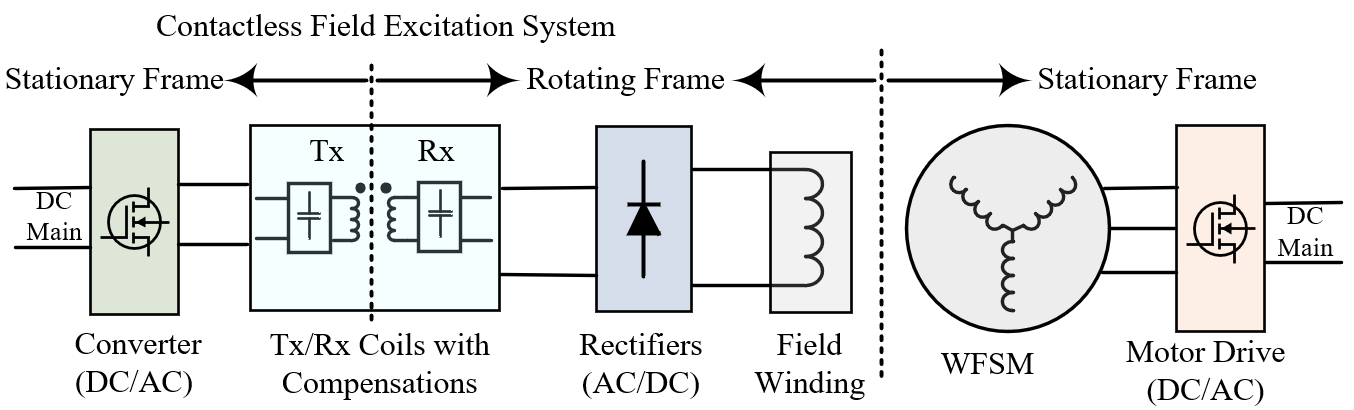
Synhronous motor/Visio/block_diagram_v2.PNG
