EnesAyaz/WPTMotor/Synhronous motor/Visio/block_proposed.PNG

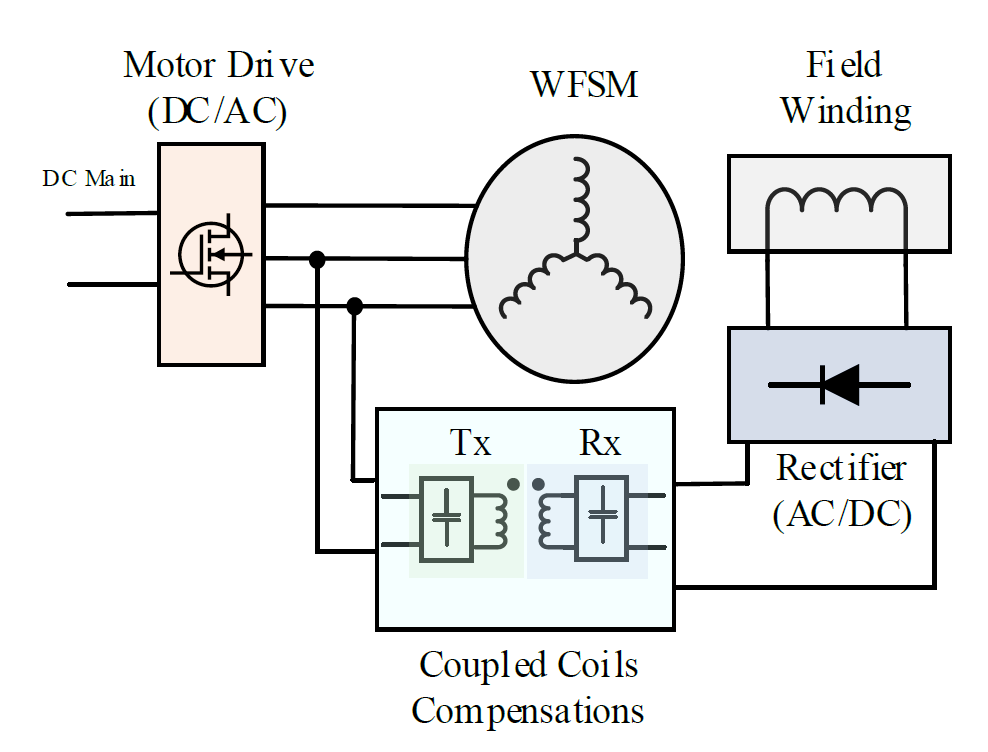
Synhronous motor/Visio/block_proposed.PNG
