EnesAyaz/WPTMotor/Synhronous motor/Visio/block_proposed_v2.PNG

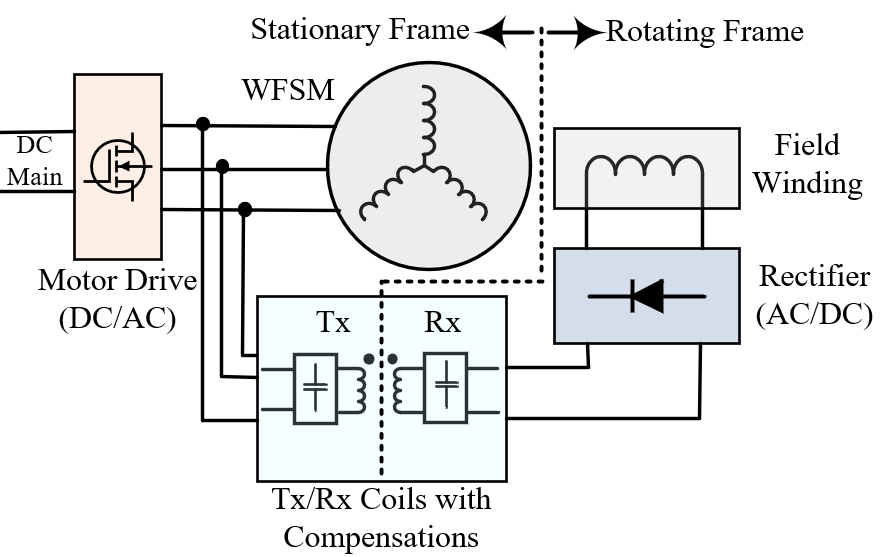
Synhronous motor/Visio/block_proposed_v2.PNG
