EnesAyaz/WPTMotor/Synhronous motor/Visio/carrier_phase_0.png

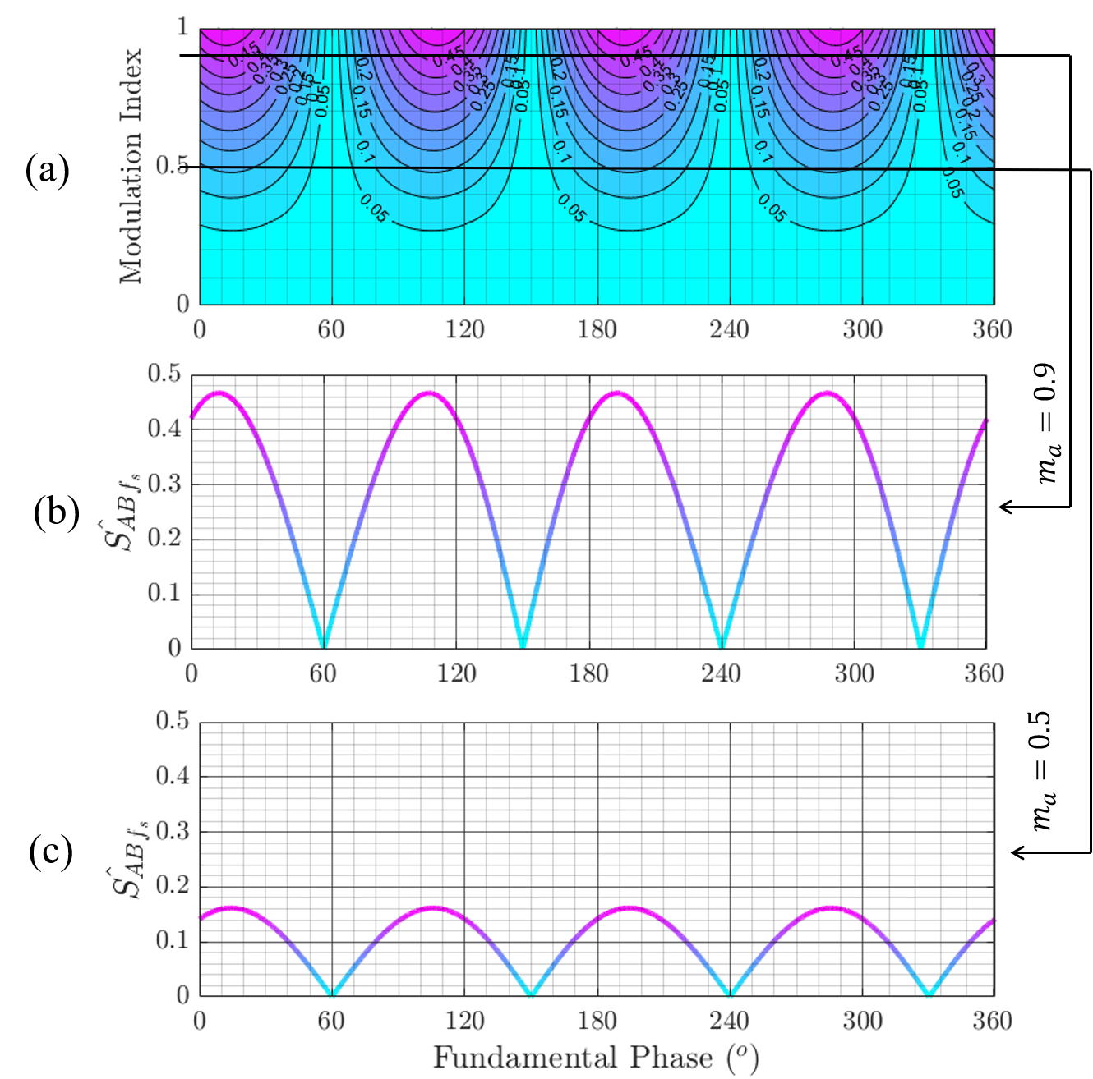
Synhronous motor/Visio/carrier_phase_0.png
