EnesAyaz/WPTMotor/Synhronous motor/Visio/carrier_phase_doubleTx.png

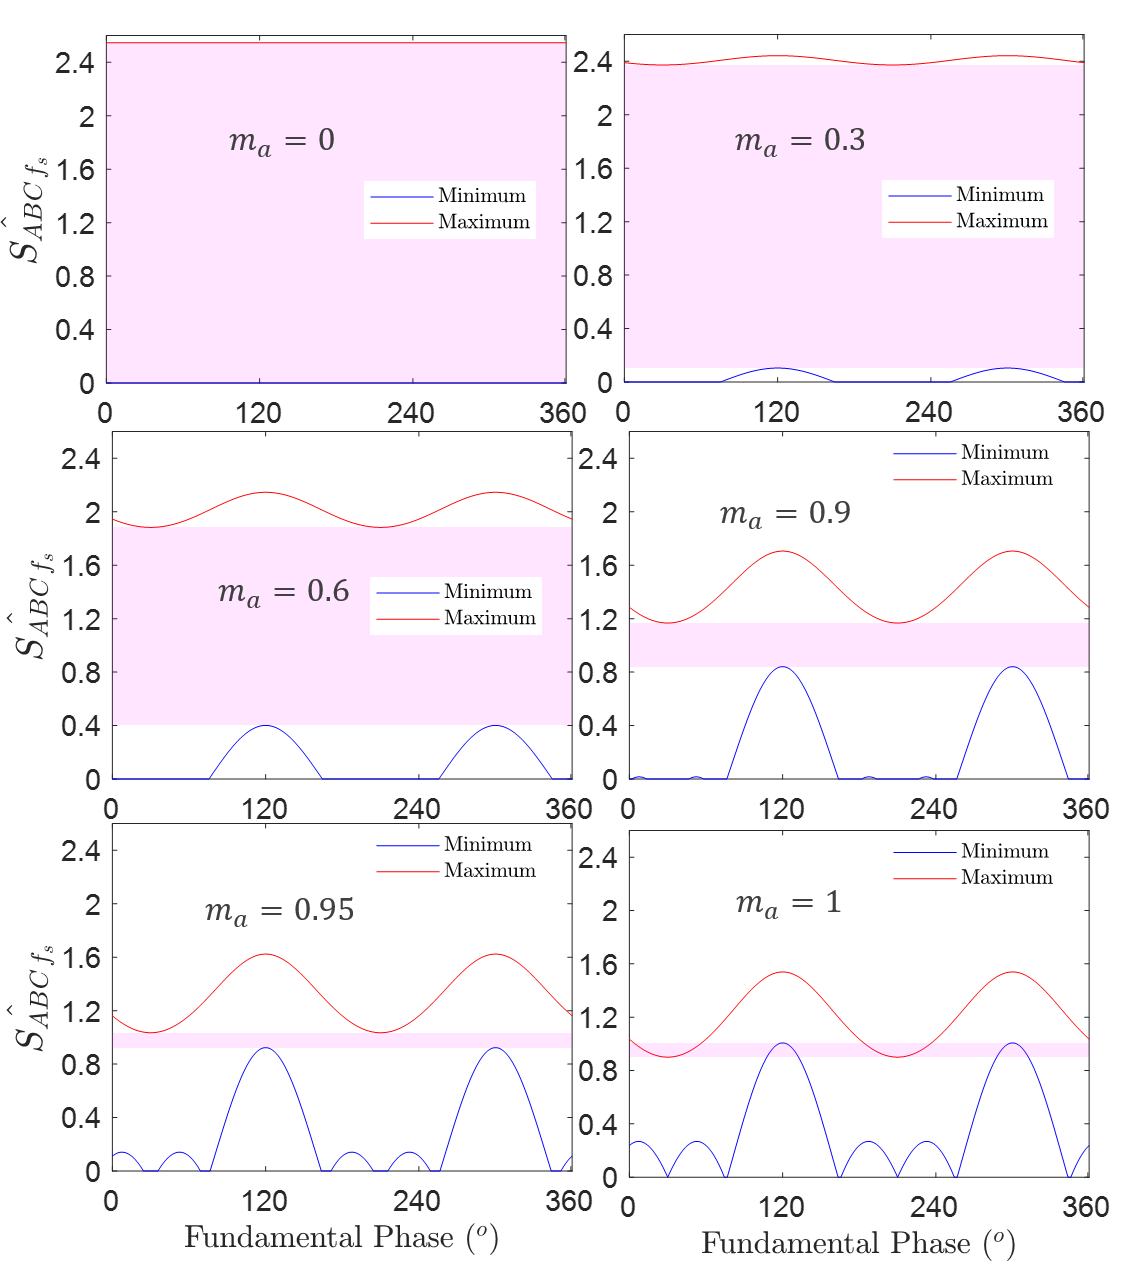
Synhronous motor/Visio/carrier_phase_doubleTx.png
