EnesAyaz/WPTMotor/Synhronous motor/Visio/carrier_phase_m0.9.png

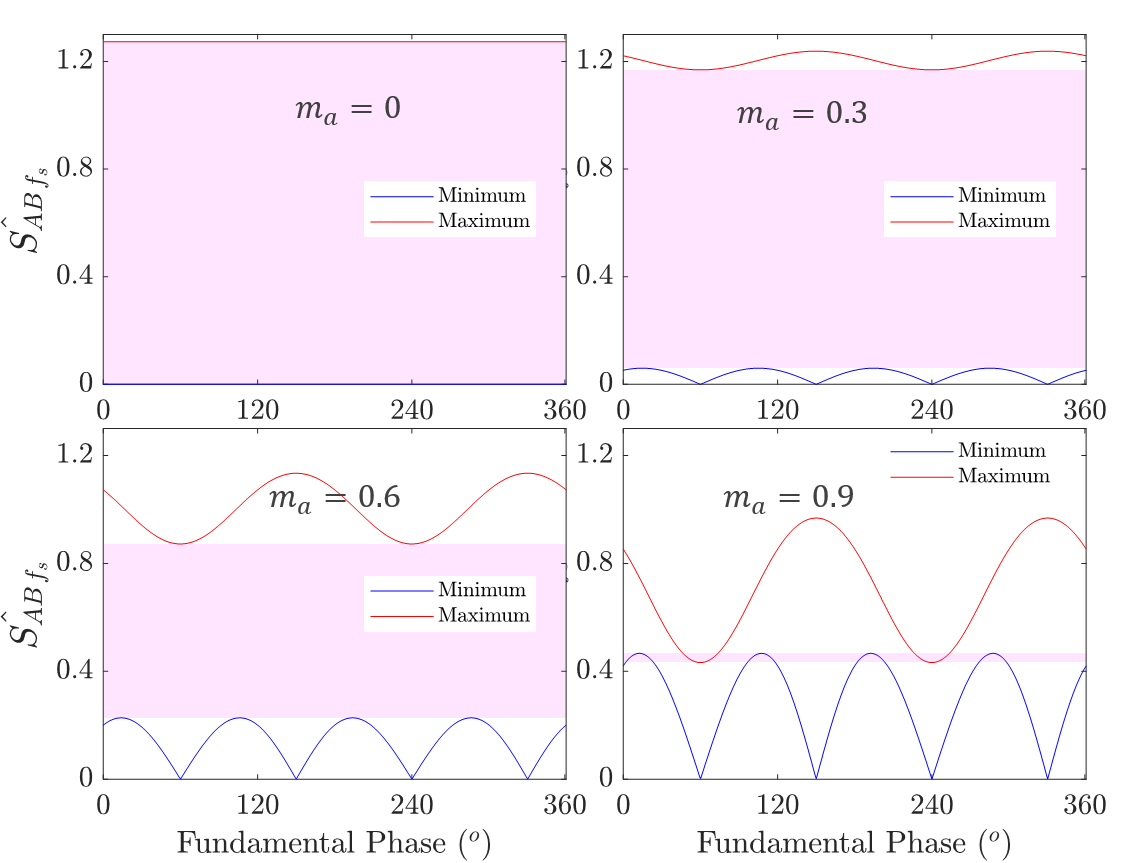
Synhronous motor/Visio/carrier_phase_m0.9.png
