EnesAyaz/WPTMotor/Synhronous motor/Visio/Double_Tx_konu_anlatim.png

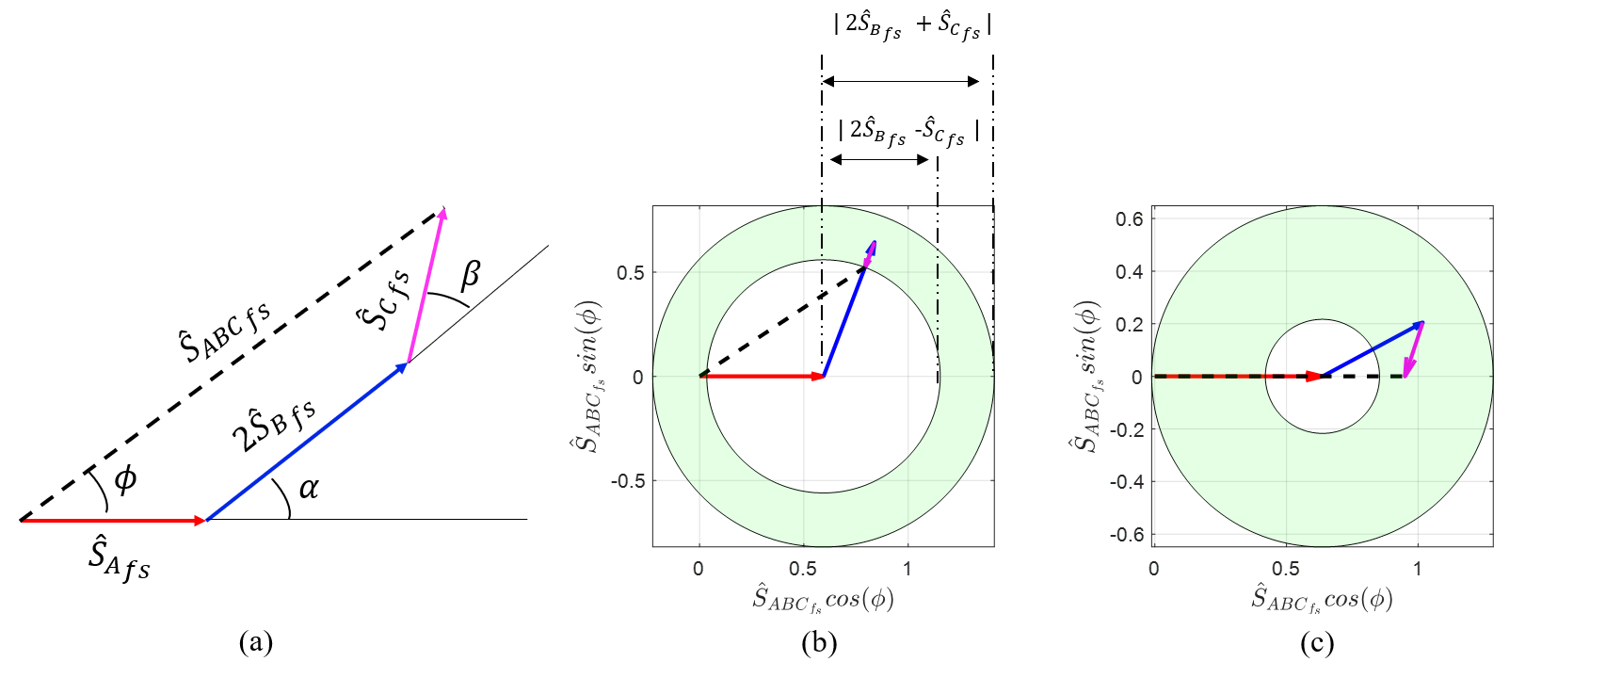
Synhronous motor/Visio/Double_Tx_konu_anlatim.png
