EnesAyaz/WPTMotor/Synhronous motor/Visio/PhaseABC_two_Tx.png

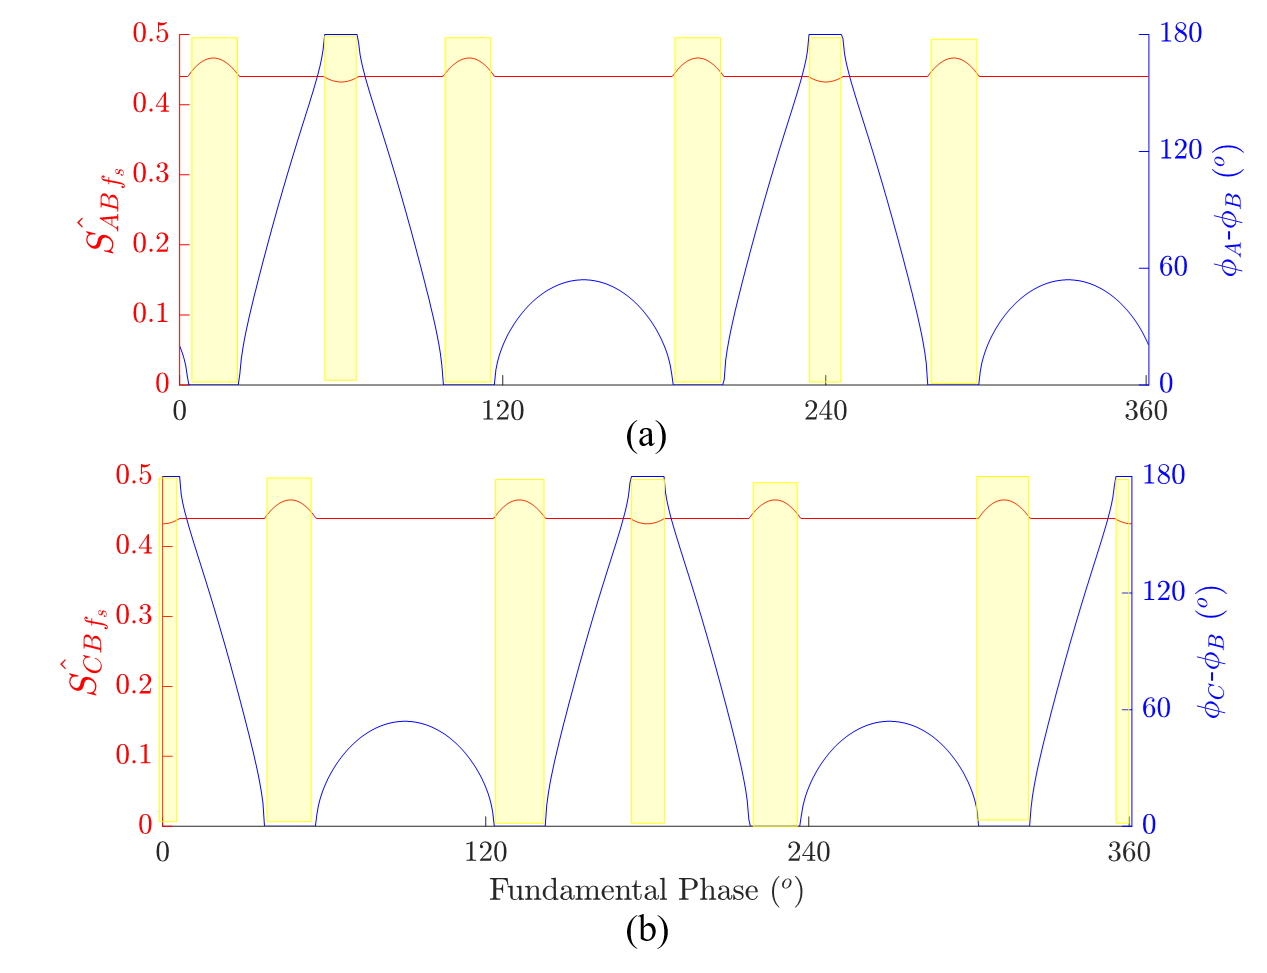
Synhronous motor/Visio/PhaseABC_two_Tx.png
