EnesAyaz/WPTMotor/Synhronous motor/Visio/Reference_Signals.png

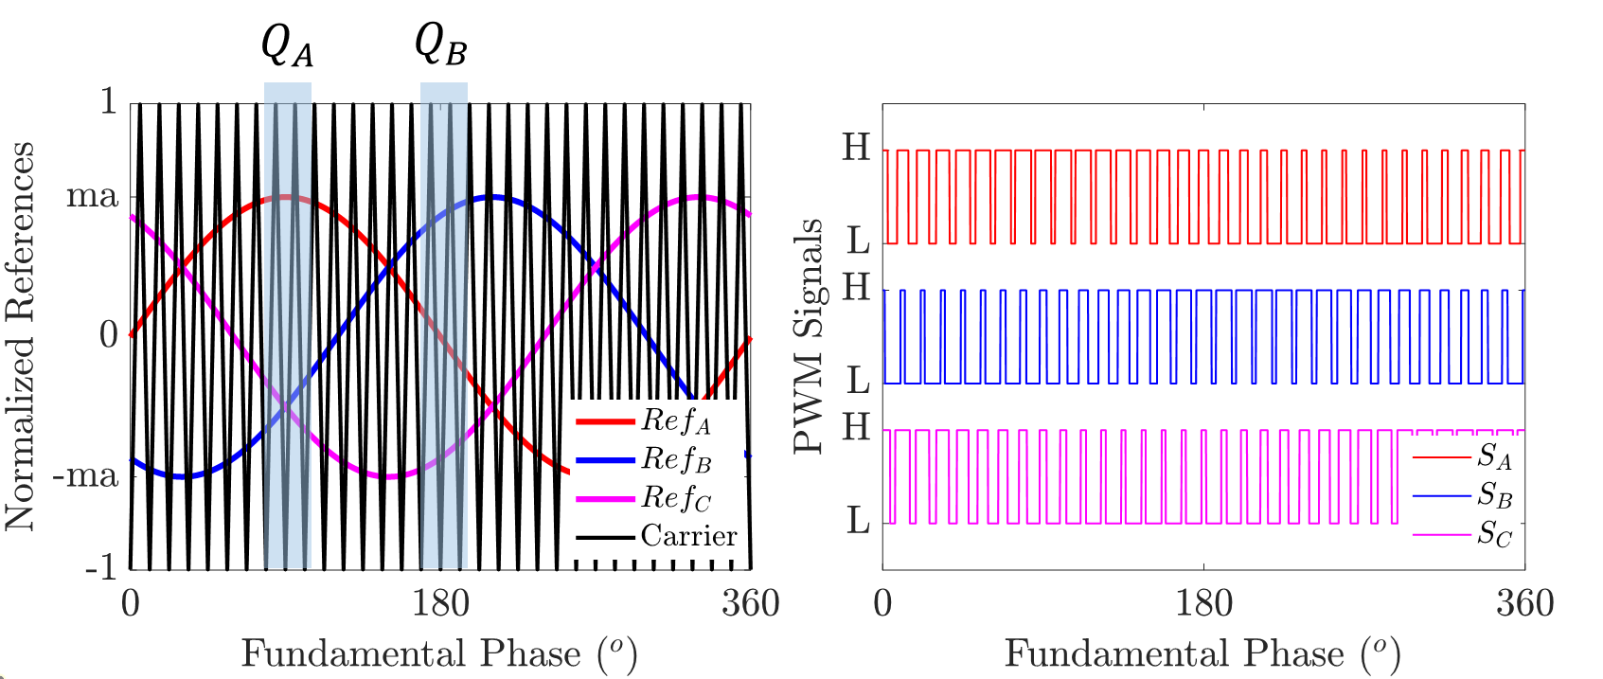
Synhronous motor/Visio/Reference_Signals.png
