EnesAyaz/WPTMotor/Synhronous motor/Visio/Swtitching_Interval.png

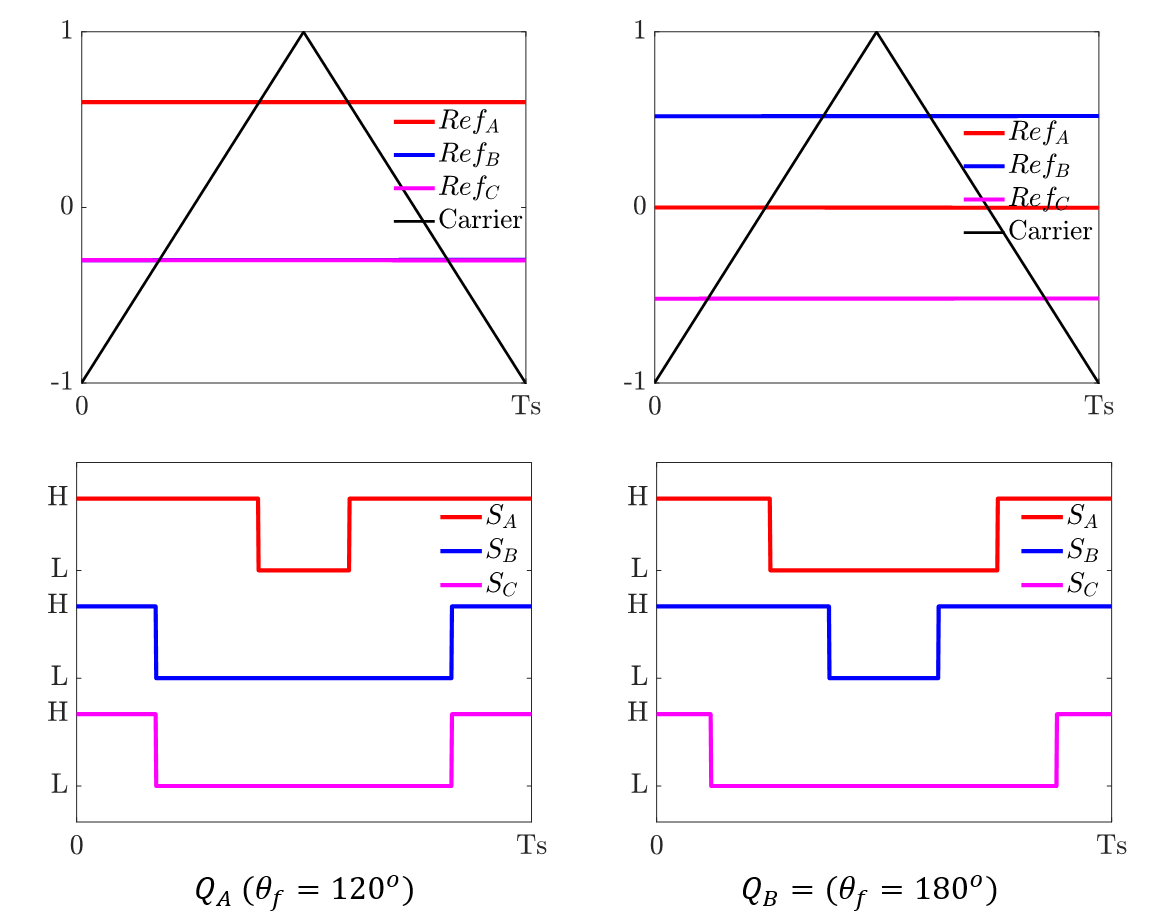
Synhronous motor/Visio/Swtitching_Interval.png
