EnesAyaz/WPTMotor/Thesis/Visio/chapter4/coaxial_SR.PNG

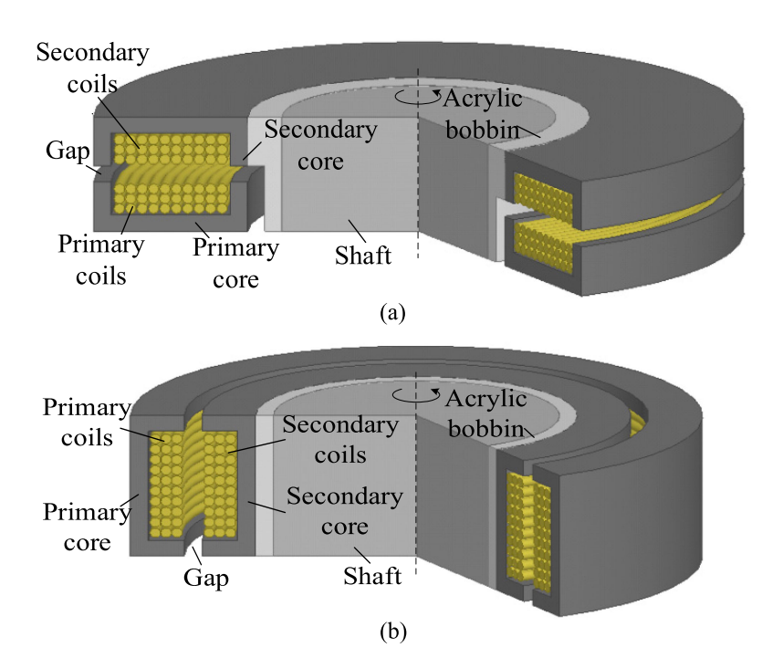
Thesis/Visio/chapter4/coaxial_SR.PNG
