EnesAyaz/WPTMotor/Thesis/Visio/chapter4/system_proposal_FB.png

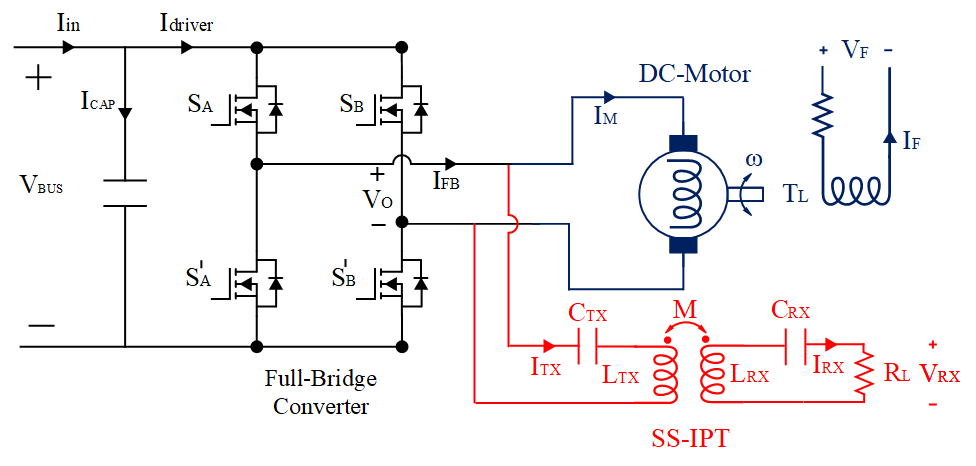
Thesis/Visio/chapter4/system_proposal_FB.png
