EnesAyaz/WPTMotor/Thesis/Visio/chapter5/FHA -SN.png

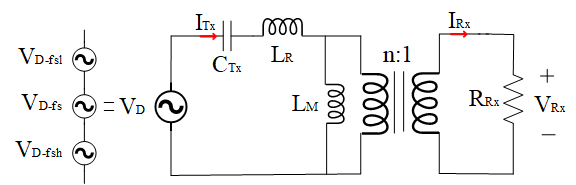
Thesis/Visio/chapter5/FHA -SN.png
