EnesAyaz/WPTMotor/Thesis/Visio/chapter5/proposed_block_WFSM.png

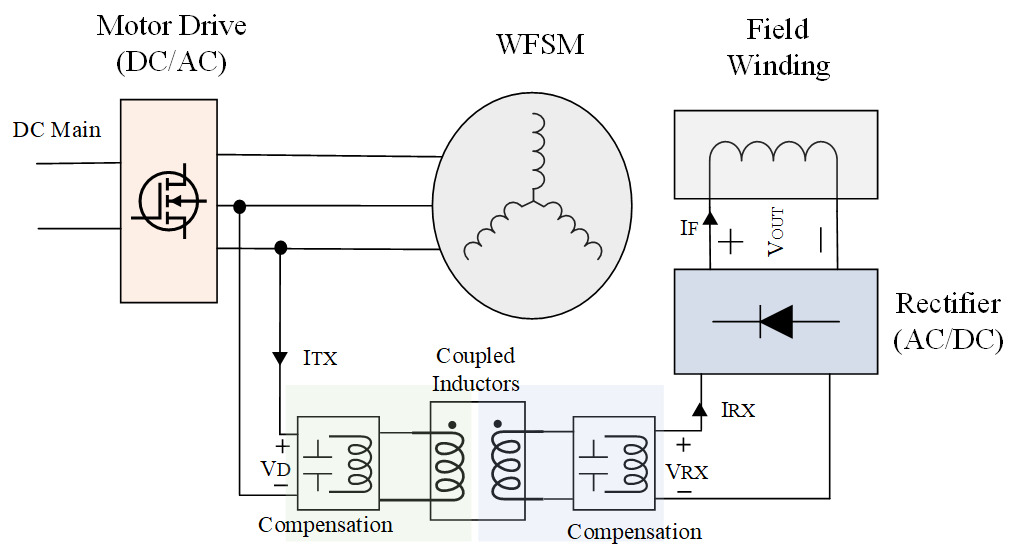
Thesis/Visio/chapter5/proposed_block_WFSM.png
