EnesAyaz/WPTMotor/Thesis/Visio/chapter-1/CSR-1.PNG

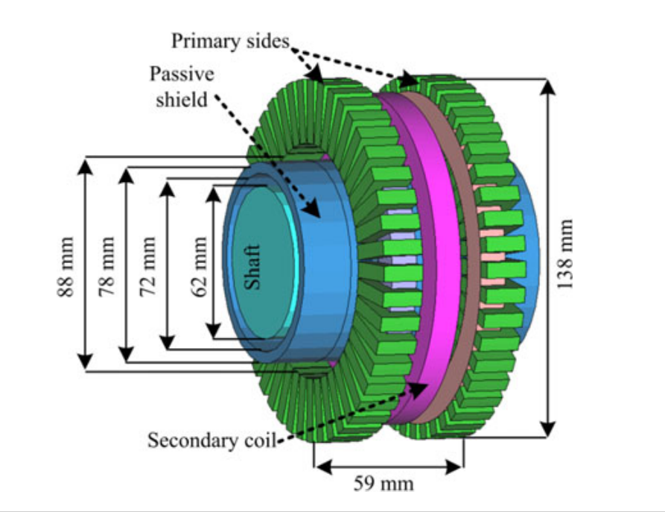
Thesis/Visio/chapter-1/CSR-1.PNG
