EnesAyaz/WPTMotor/Thesis/Visio/chapter-1/proposed-WPT-CSR.png

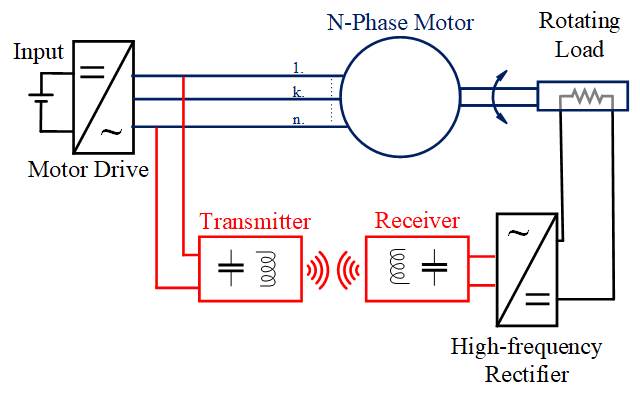
Thesis/Visio/chapter-1/proposed-WPT-CSR.png
