EnesAyaz/WPTMotor/Thesis/Visio/chapter-1/rotating_WPT_diagram.png

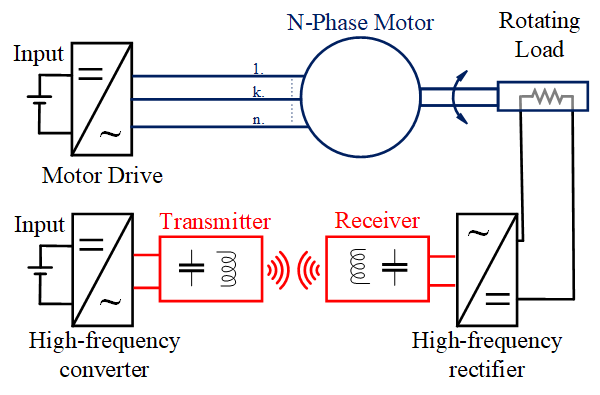
Thesis/Visio/chapter-1/rotating_WPT_diagram.png
