EnesAyaz/WPTMotor/Thesis/Visio/chapter-1/WPT-system_block_diagram.png

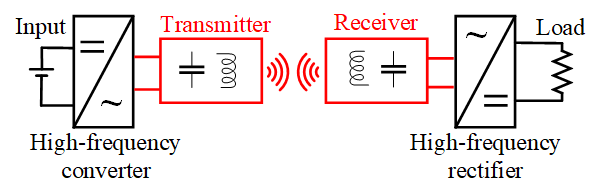
Thesis/Visio/chapter-1/WPT-system_block_diagram.png
