EnesAyaz/WPTMotor/Thesis/Visio/chapter-2/conventionalIPT.png

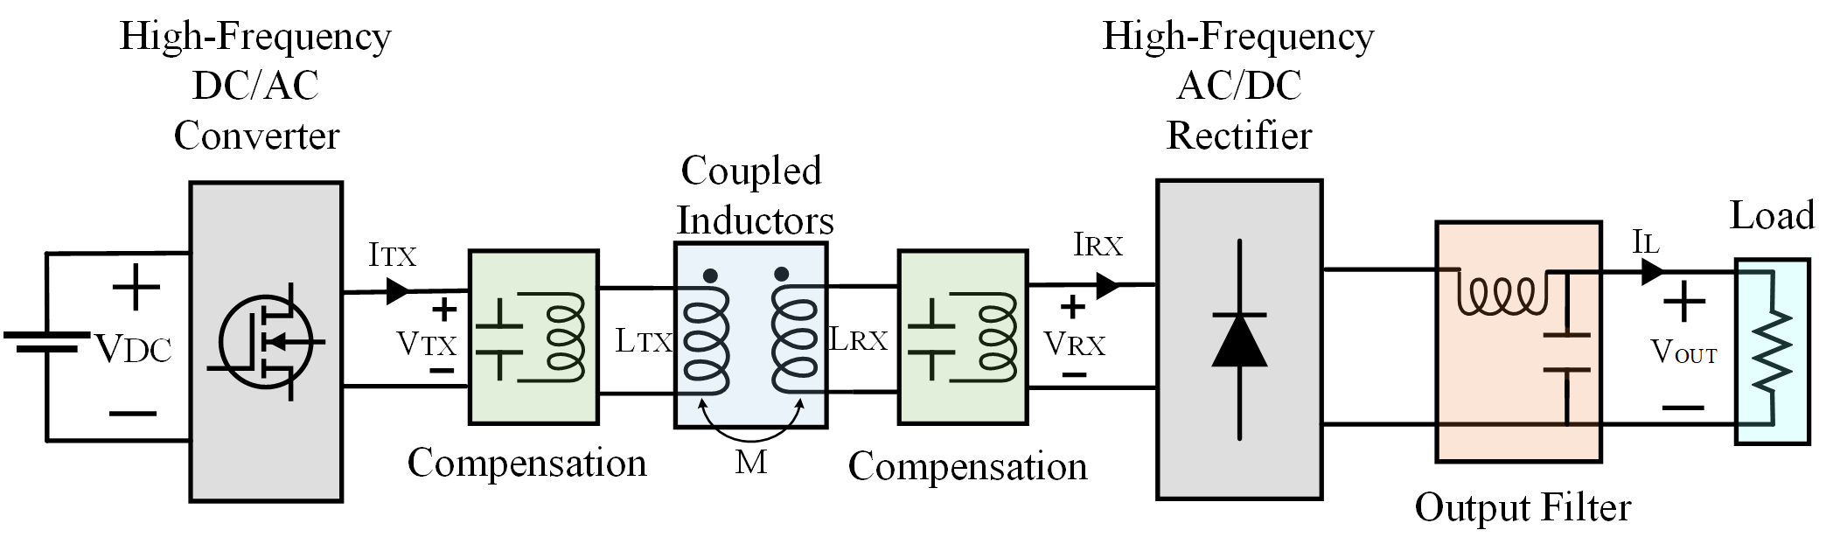
Thesis/Visio/chapter-2/conventionalIPT.png
