EnesAyaz/WPTMotor/Thesis/Visio/chapter-2/FHA_SSIPT.png

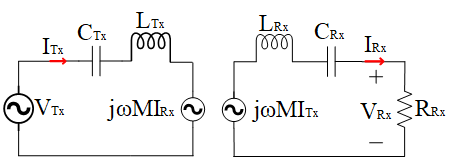
Thesis/Visio/chapter-2/FHA_SSIPT.png
