EnesAyaz/WPTMotor/Thesis/Visio/chapter-2/soft_switch.png

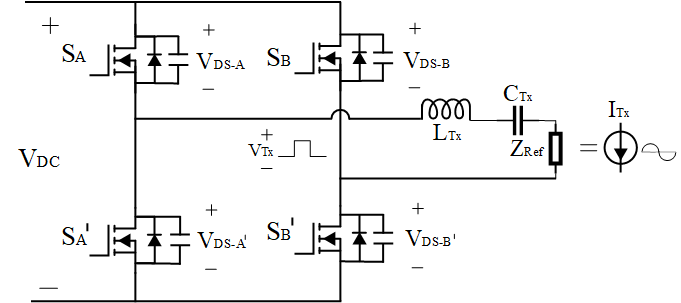
Thesis/Visio/chapter-2/soft_switch.png
