EnesAyaz/WPTMotor/Thesis/Visio/chapter-2/SS-IPT.png

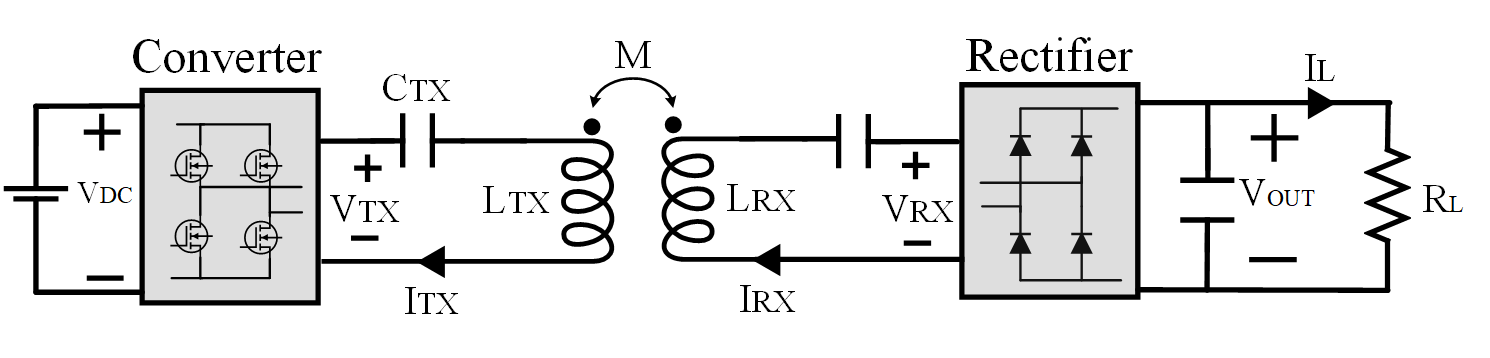
Thesis/Visio/chapter-2/SS-IPT.png
