EnesAyaz/WPTMotor/Thesis/Visio/chapter-2/Two-element-compensation.png

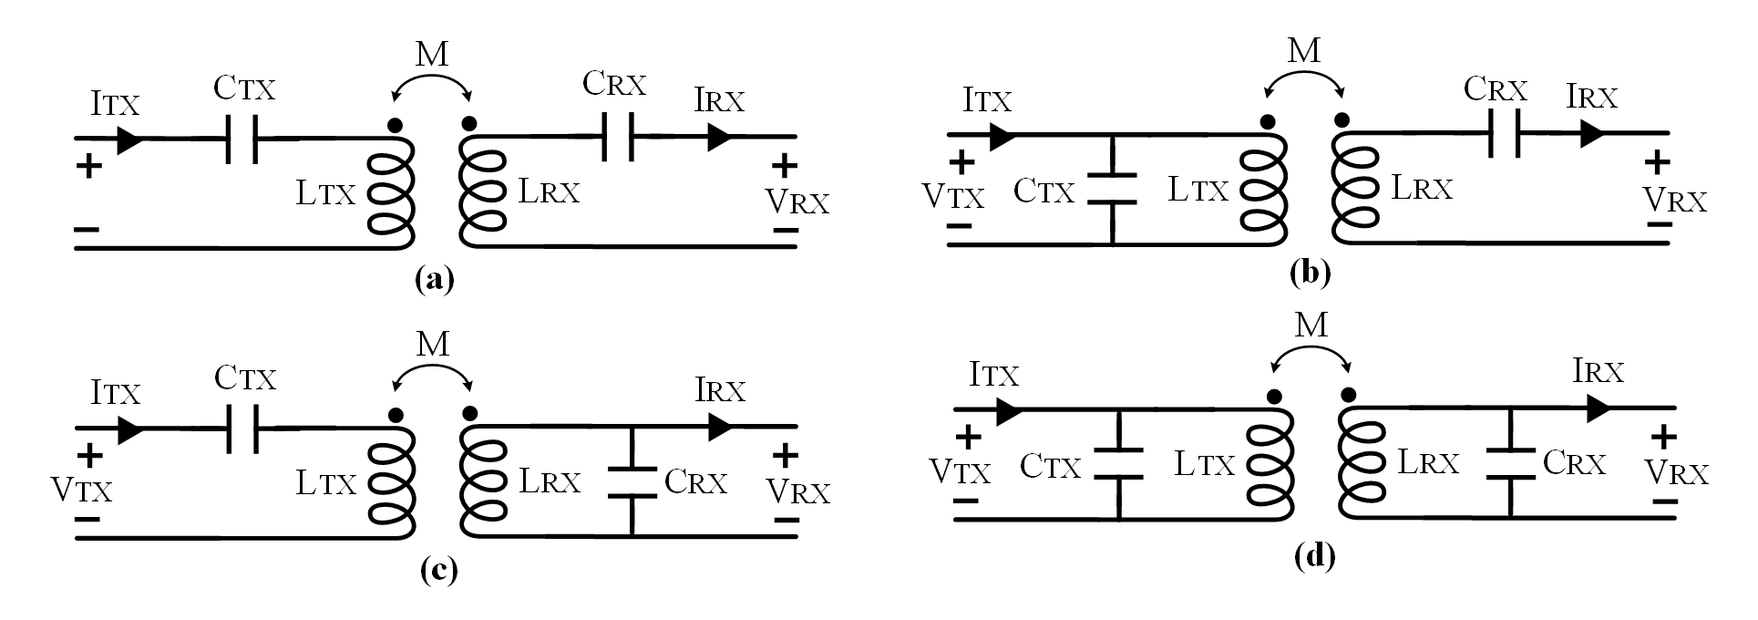
Thesis/Visio/chapter-2/Two-element-compensation.png
