EnesAyaz/WPTMotor/Thesis/Visio/chapter-3/ACmotorCircuit.png

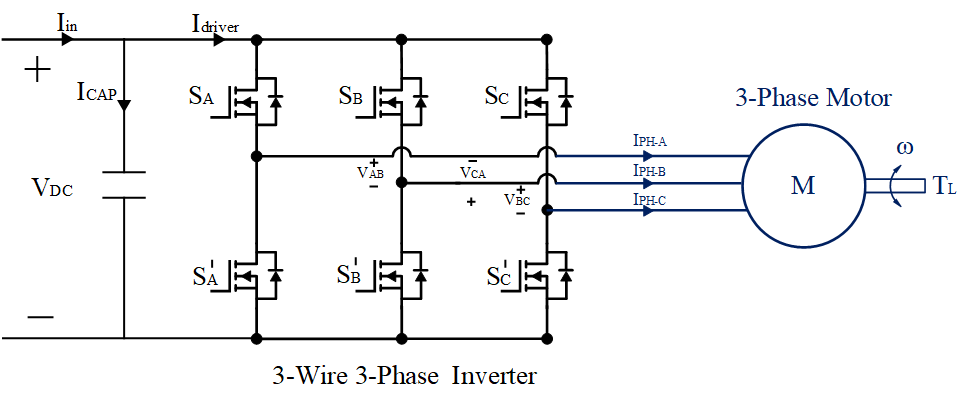
Thesis/Visio/chapter-3/ACmotorCircuit.png
