EnesAyaz/WPTMotor/Thesis/Visio/chapter-3/control_AC.png

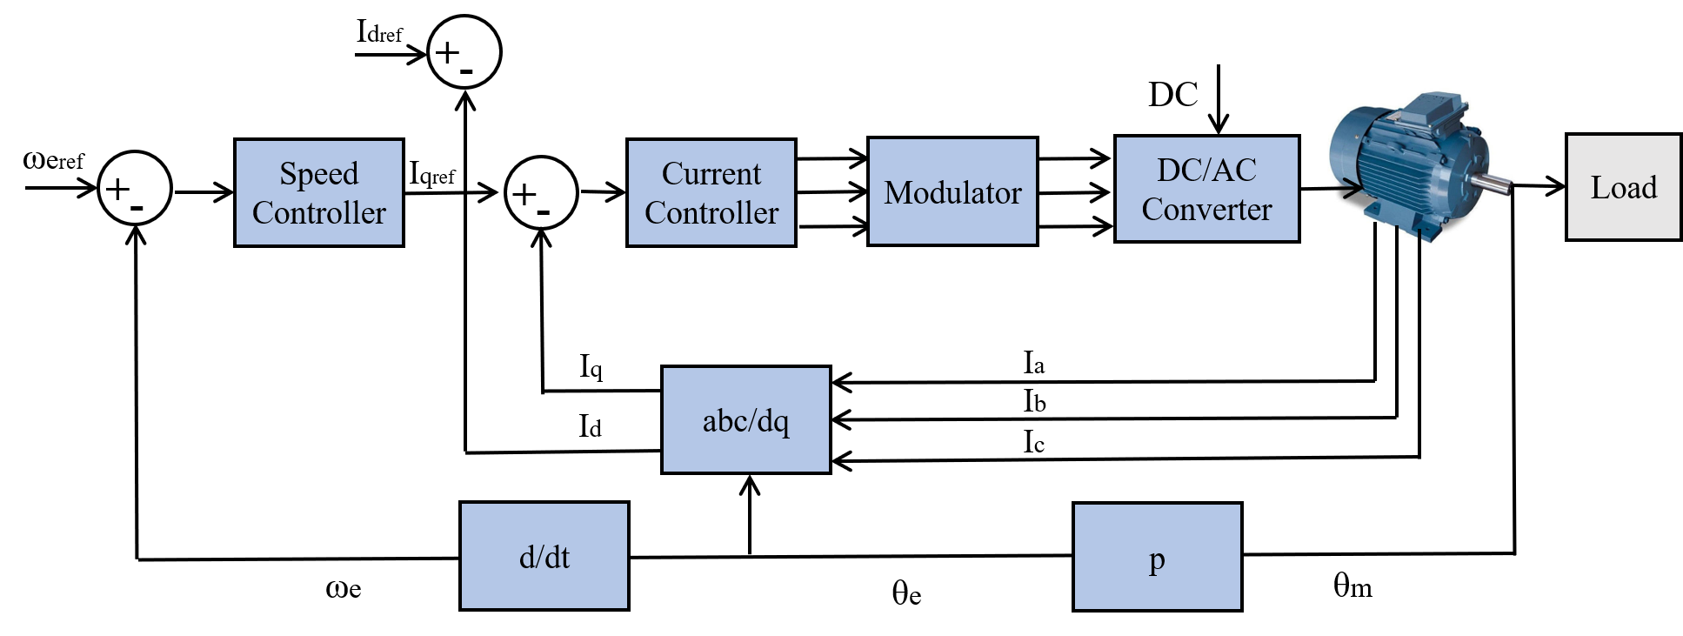
Thesis/Visio/chapter-3/control_AC.png
