EnesAyaz/WPTMotor/Thesis/Visio/chapter-3/control_DC.png

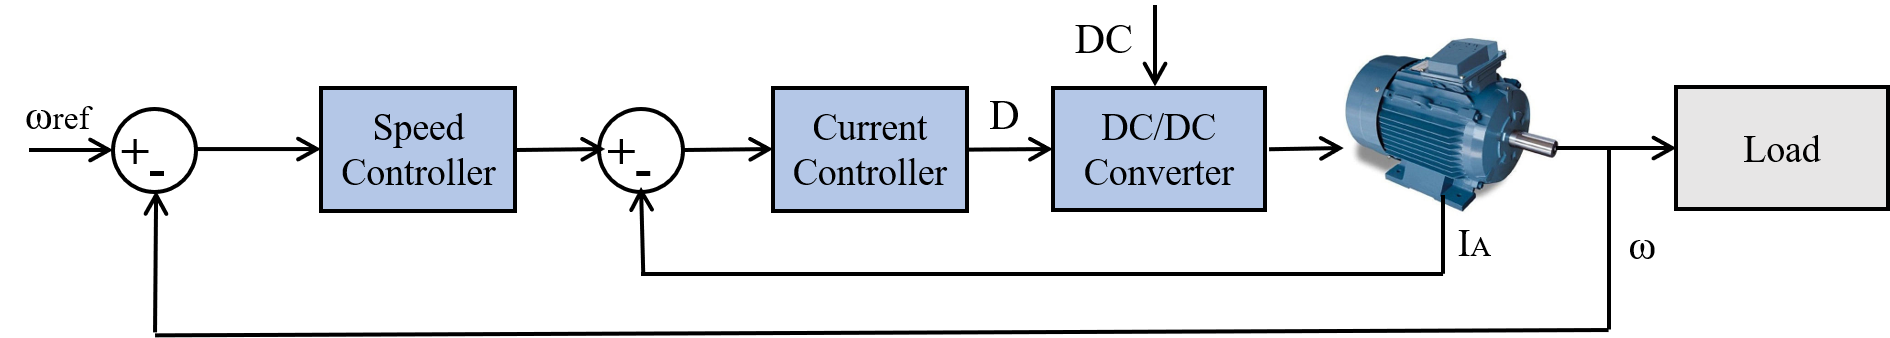
Thesis/Visio/chapter-3/control_DC.png
