EnesAyaz/WPTMotor/Thesis/Visio/chapter-3/control_DC_v2.png

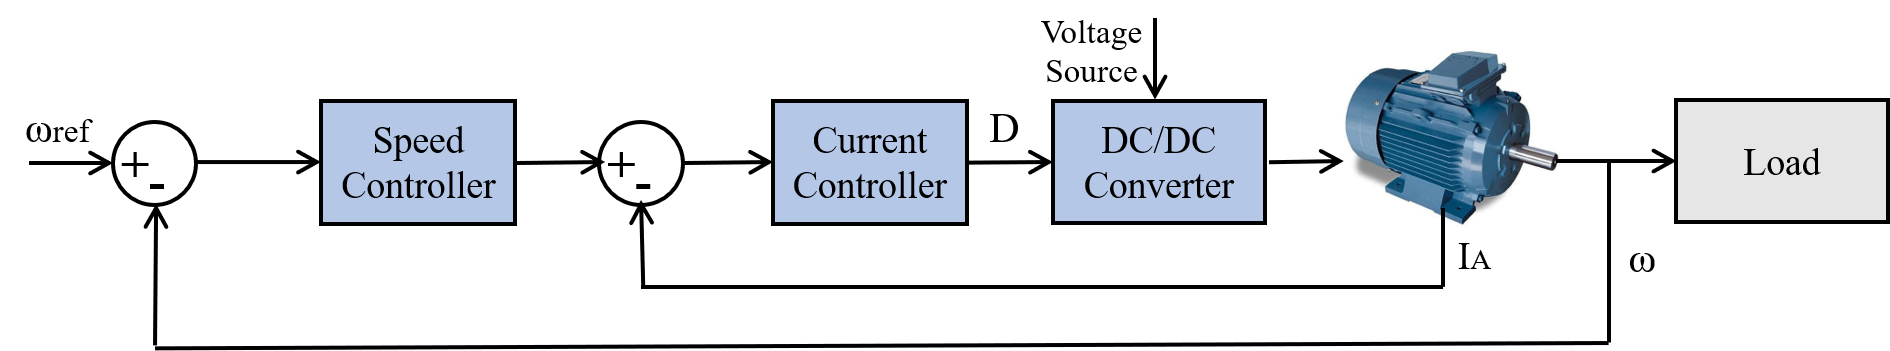
Thesis/Visio/chapter-3/control_DC_v2.png
