EnesAyaz/WPTMotor/Thesis/Visio/chapter-3/Controller3AC.png

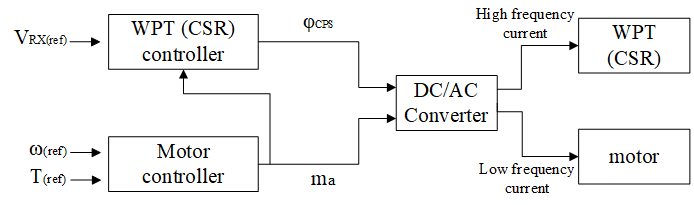
Thesis/Visio/chapter-3/Controller3AC.png
