EnesAyaz/WPTMotor/Thesis/Visio/chapter-3/ControllerSPWM.png

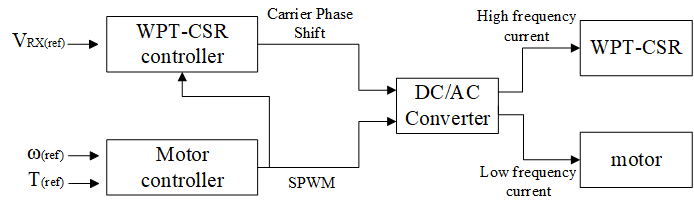
Thesis/Visio/chapter-3/ControllerSPWM.png
