EnesAyaz/WPTMotor/Thesis/Visio/chapter-3/DC_motor_system_proposal.png

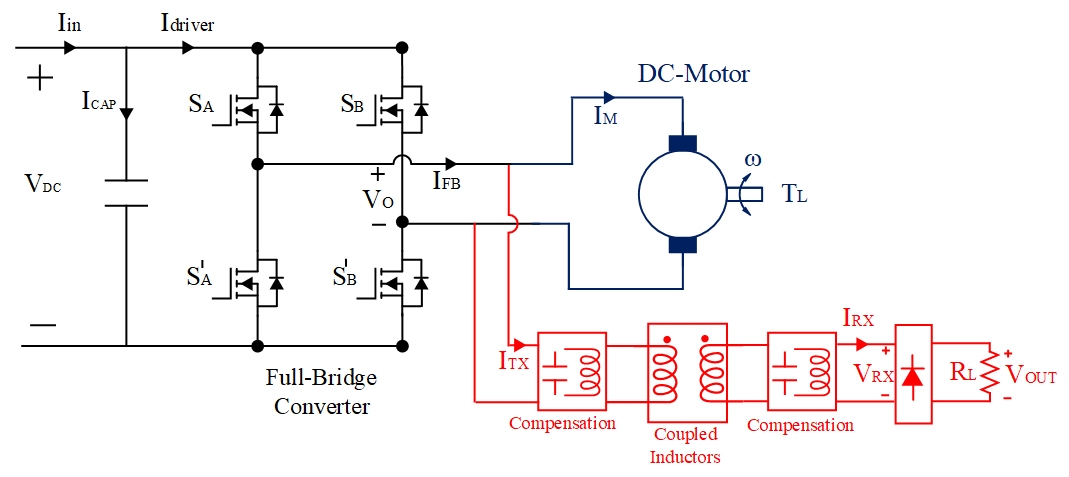
Thesis/Visio/chapter-3/DC_motor_system_proposal.png
