EnesAyaz/WPTMotor/Thesis/Visio/chapter-3/DCmotorCircuitFullBridge.png

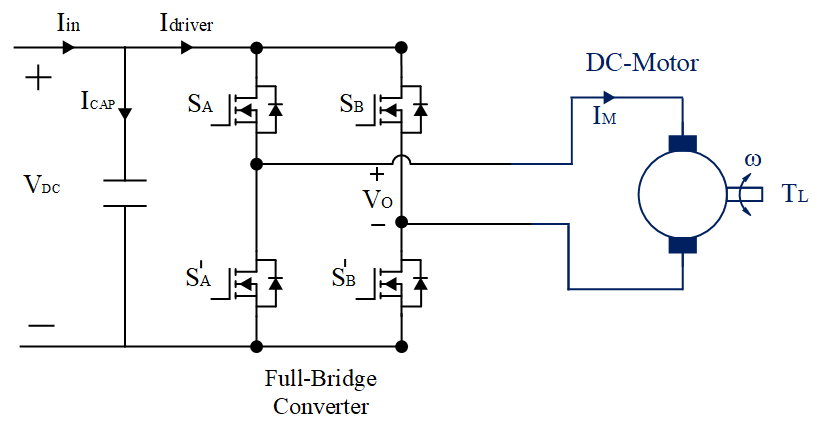
Thesis/Visio/chapter-3/DCmotorCircuitFullBridge.png
