EnesAyaz/WPTMotor/Thesis/Visio/chapter-3/ElectricalEquivalentDCmotor.png

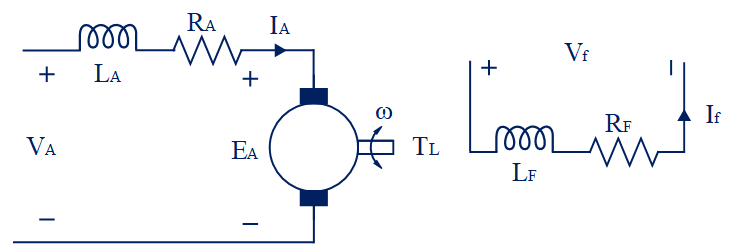
Thesis/Visio/chapter-3/ElectricalEquivalentDCmotor.png
