EnesAyaz/WPTMotor/Thesis/Visio/chapter-3/filterSize.png

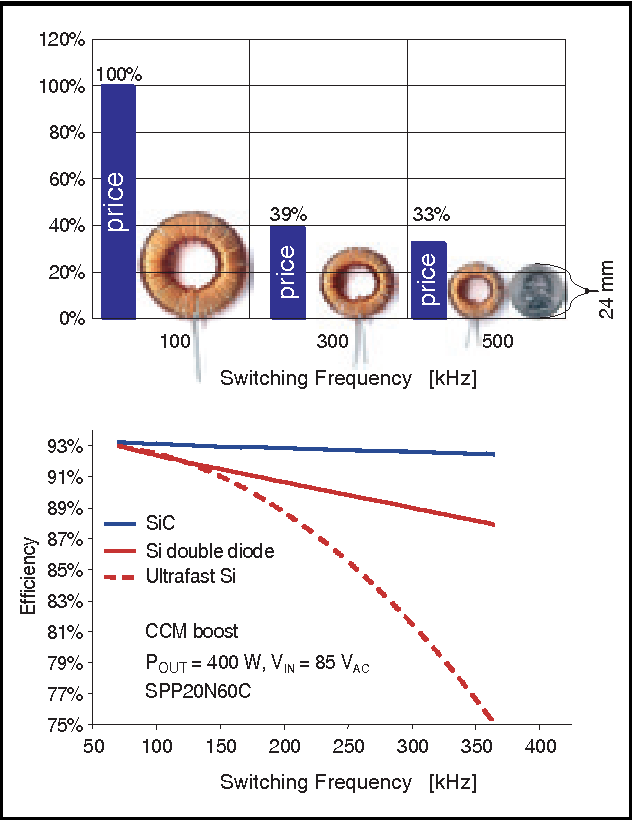
Thesis/Visio/chapter-3/filterSize.png
