EnesAyaz/WPTMotor/Thesis/Visio/chapter-3/Induction_machine_electrical_curcuit.png

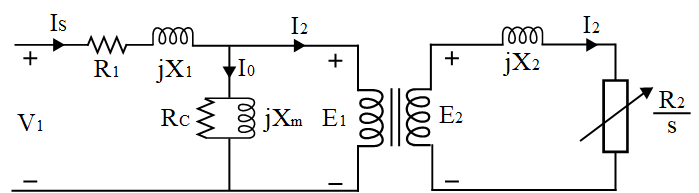
Thesis/Visio/chapter-3/Induction_machine_electrical_curcuit.png
