EnesAyaz/WPTMotor/Thesis/Visio/chapter-3/motor_drive_block_diagram.png

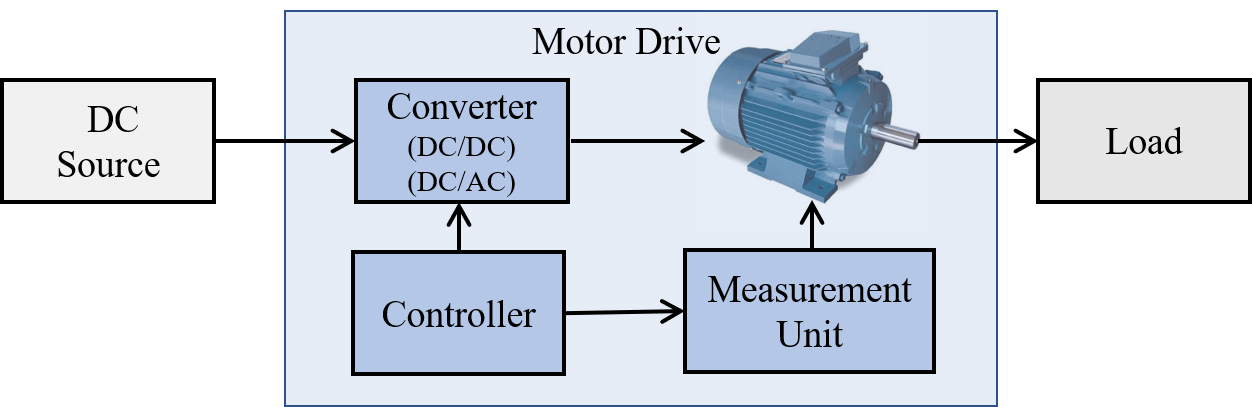
Thesis/Visio/chapter-3/motor_drive_block_diagram.png
