EnesAyaz/WPTMotor/Thesis/Visio/chapter-3/SM_electric_circuit.png

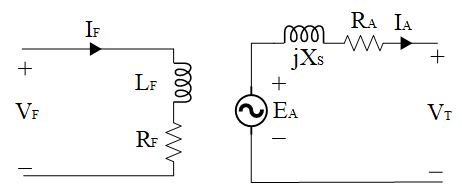
Thesis/Visio/chapter-3/SM_electric_circuit.png
