EnesAyaz/WPTMotor/Thesis/Visio/chapter-3/switching6_v2.png

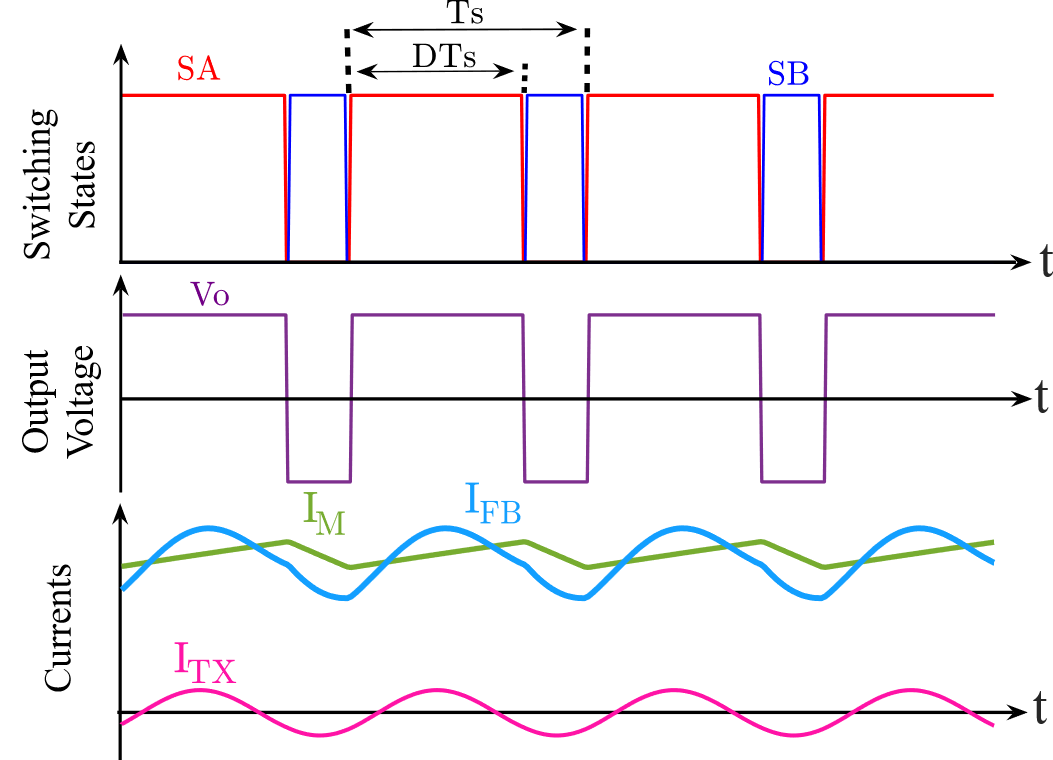
Thesis/Visio/chapter-3/switching6_v2.png
