EnesAyaz/WPTMotor/Thesis/Visio/chapter-3/switchingSASBVAB.png

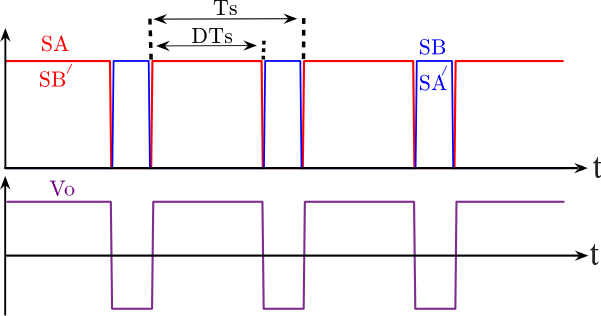
Thesis/Visio/chapter-3/switchingSASBVAB.png
