EnesAyaz/WPTMotor/Thesis/Visio/chapter-3/system_proposal_3VSC - Copy.png

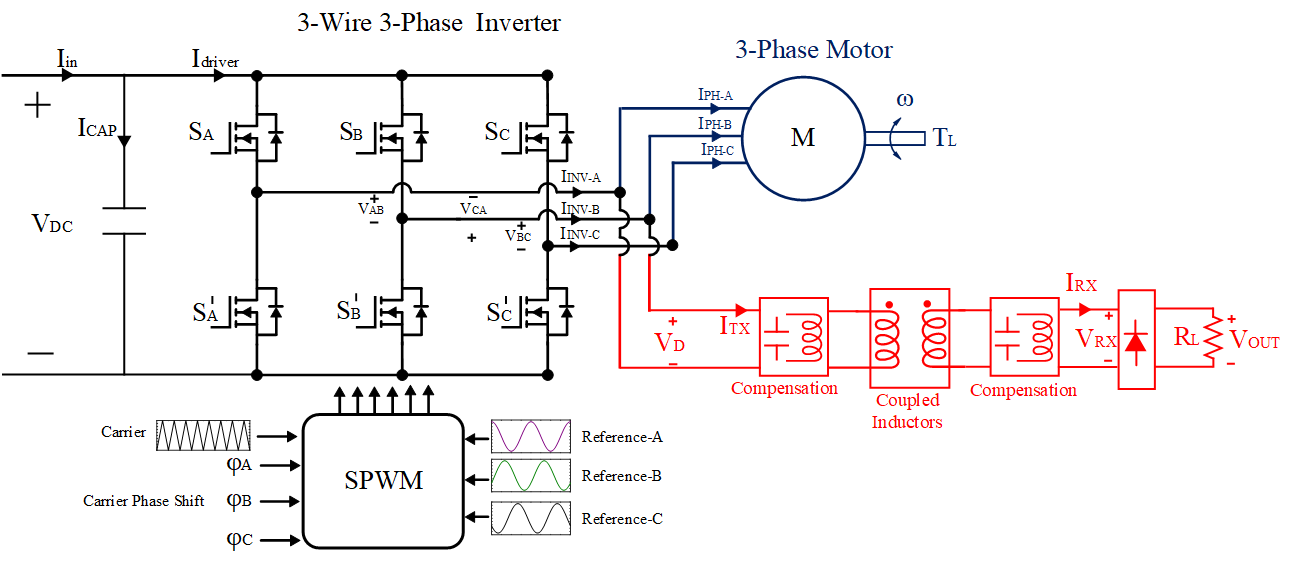
Thesis/Visio/chapter-3/system_proposal_3VSC - Copy.png
