EnesAyaz/WPTMotor/Thesis/Visio/chapter-3/Torque-speed-IM.png

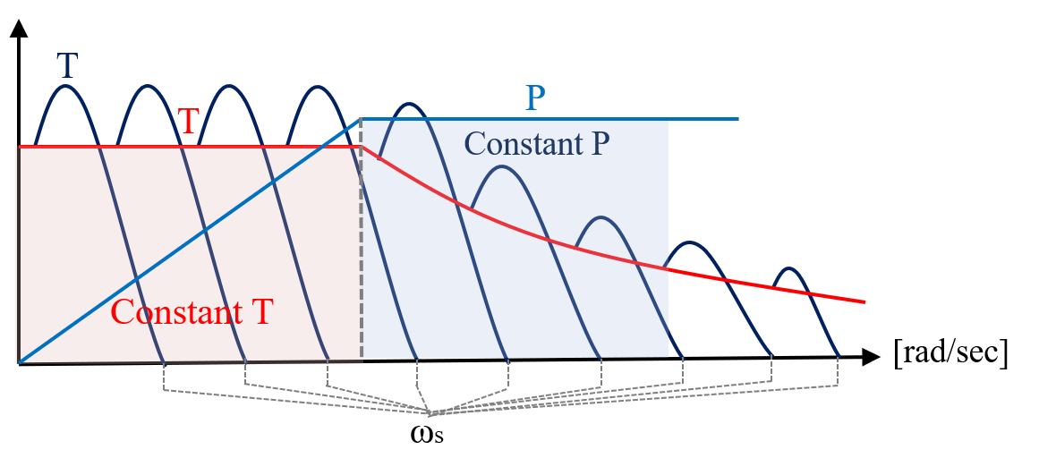
Thesis/Visio/chapter-3/Torque-speed-IM.png
