EnesAyaz/WPTMotor/Thesis/Visio/chapter-3/Torque-speed-IM_v2.png

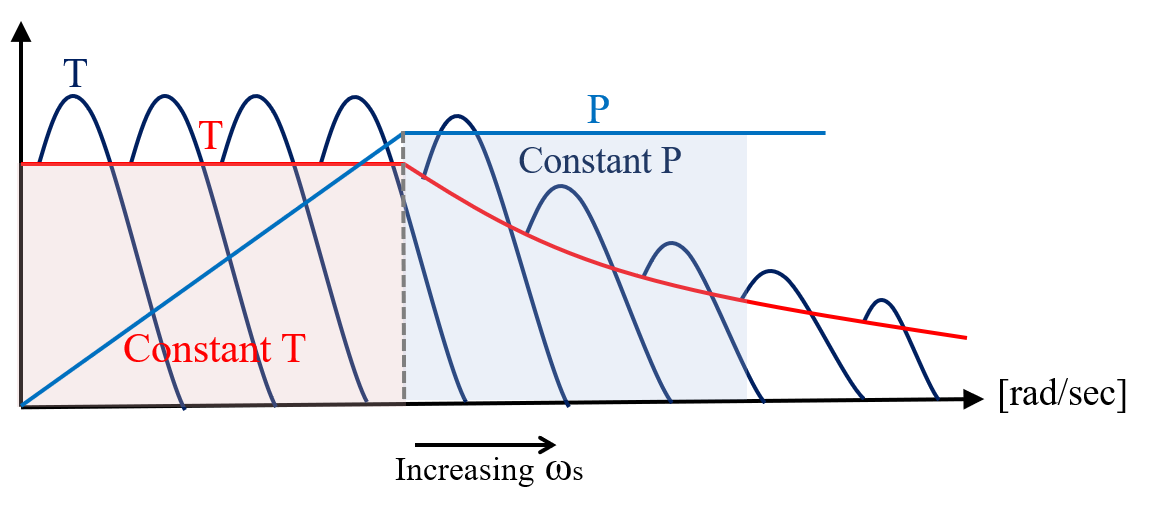
Thesis/Visio/chapter-3/Torque-speed-IM_v2.png
