EnesAyaz/WPTMotor/Thesis/Visio/chapter-3/Torque-speed-SM.png

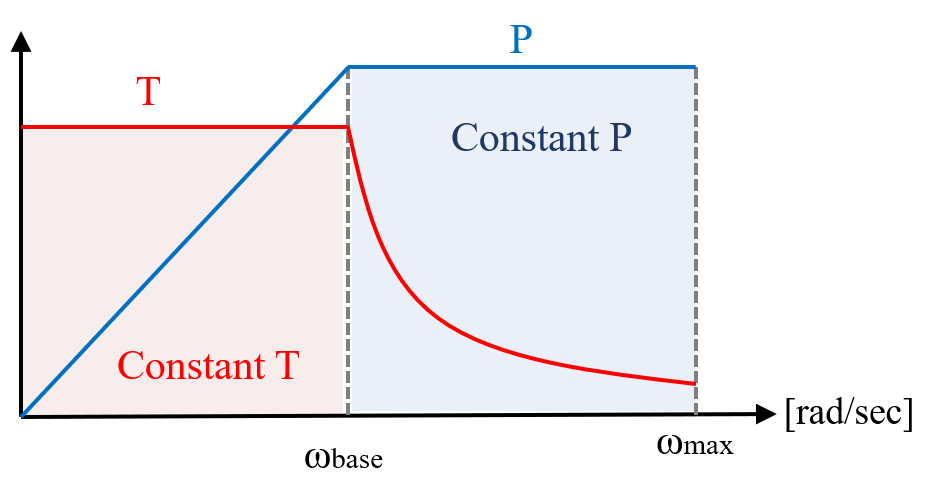
Thesis/Visio/chapter-3/Torque-speed-SM.png
