EnesAyaz/WPTMotor/Synhronous motor/System-Design/Solid/Mechanic Drawings/Assembly.SLDASM

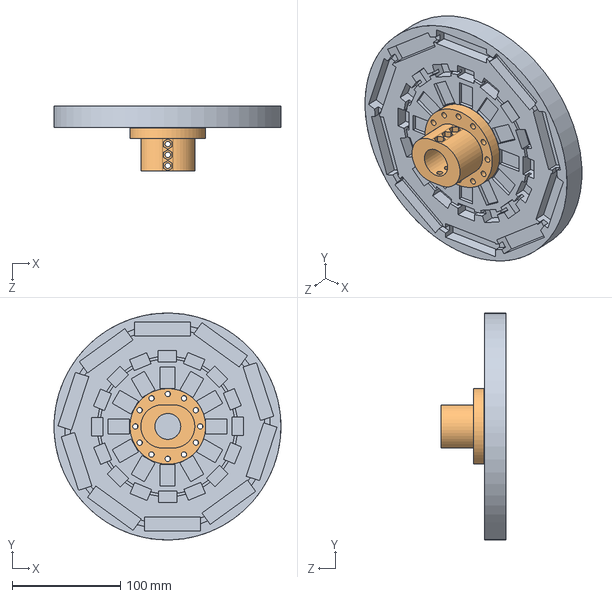
[picture p266: CAD file, 2021-11-02]
Synhronous motor/System-Design/Solid/Mechanic Drawings/Assembly.SLDASM
210.0 x 209.9 x 60.3 mm
FerriteAndLoad
coupling
