EnesAyaz/WPTMotor/Synhronous motor/System-Design/Solid/coil_former_Tx.SLDPRT

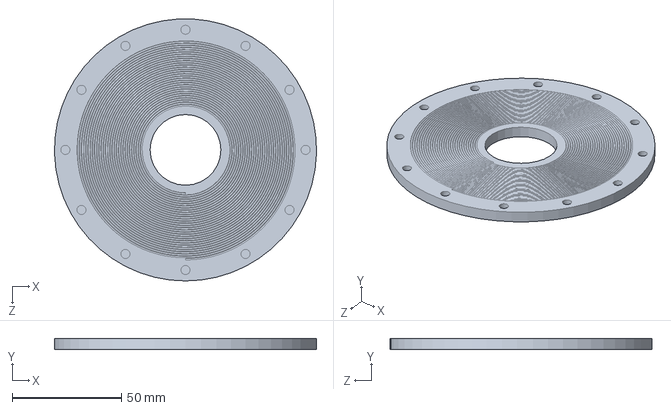
[picture p267: CAD file, 2022-04-23]
Synhronous motor/System-Design/Solid/coil_former_Tx.SLDPRT
119.9 x 5.00 x 119.9 mm
