EnesAyaz/WPTMotor/Synhronous motor/System-Design/Solid/Mechanic Drawings/coupling_v2.SLDPRT

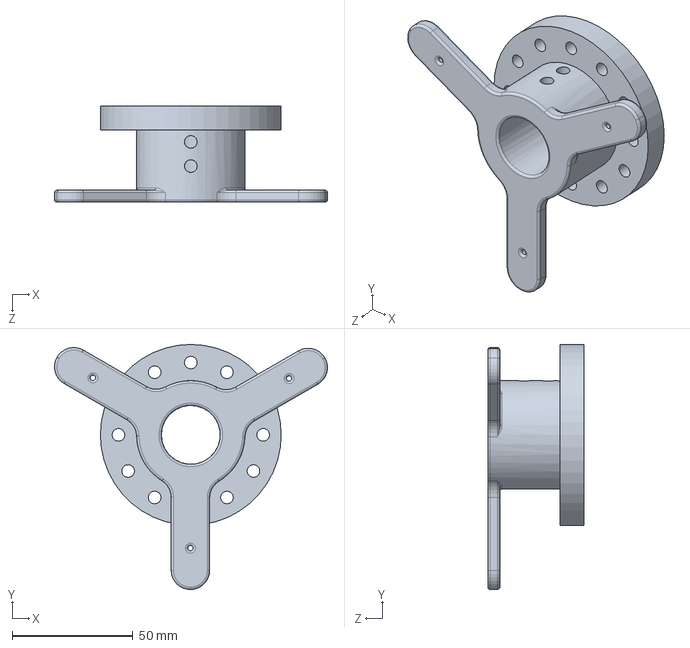
[picture p268: CAD file, 2021-12-11]
Synhronous motor/System-Design/Solid/Mechanic Drawings/coupling_v2.SLDPRT
113.2 x 101.7 x 40.0 mm
