EnesAyaz/WPTMotor/Synhronous motor/System-Design/Solid/Üretim/coupling_v4.SLDPRT

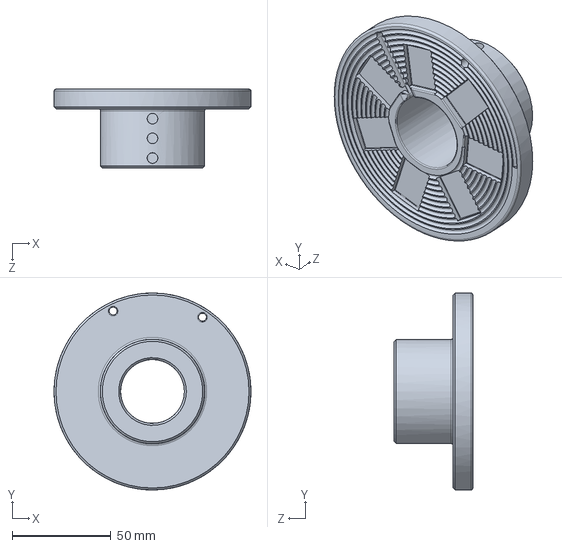
[picture p269: CAD file, 2022-04-23]
Synhronous motor/System-Design/Solid/Üretim/coupling_v4.SLDPRT
100.0 x 100.0 x 40.0 mm
