EnesAyaz/WPTMotor/Synhronous motor/System-Design/Solid/coil_former.SLDPRT

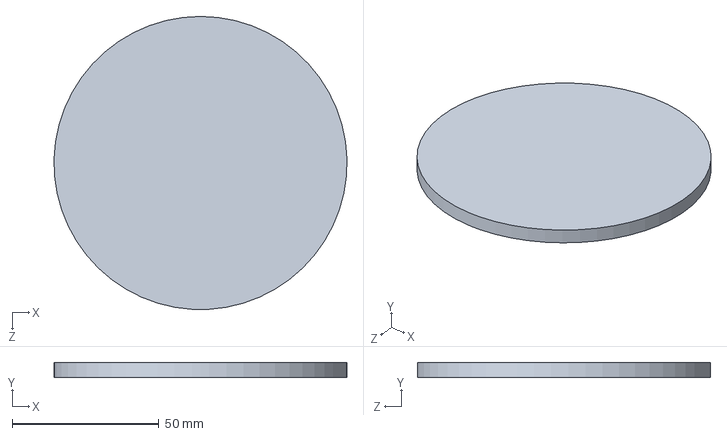
[picture p270: CAD file, 2022-04-23]
Synhronous motor/System-Design/Solid/coil_former.SLDPRT
100.0 x 5.00 x 100.0 mm
