EnesAyaz/WPTMotor/Synhronous motor/System-Design/Solid/Mechanic Drawings/slip_ring_2.SLDPRT

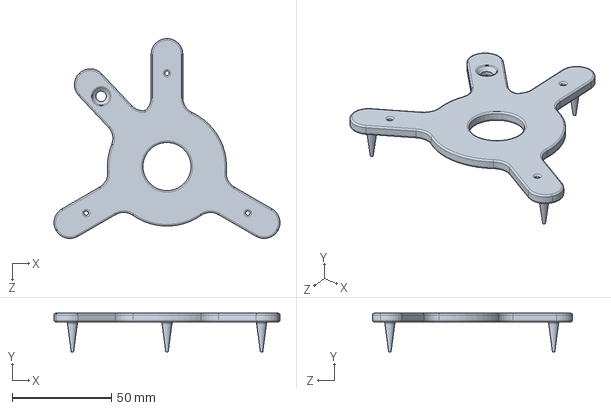
[picture p271: CAD file, 2021-12-11]
Synhronous motor/System-Design/Solid/Mechanic Drawings/slip_ring_2.SLDPRT
113.8 x 19.4 x 100.7 mm
