EnesAyaz/WPTMotor/Synhronous motor/System-Design/Solid/Mechanic Drawings/slice_1o4.SLDPRT

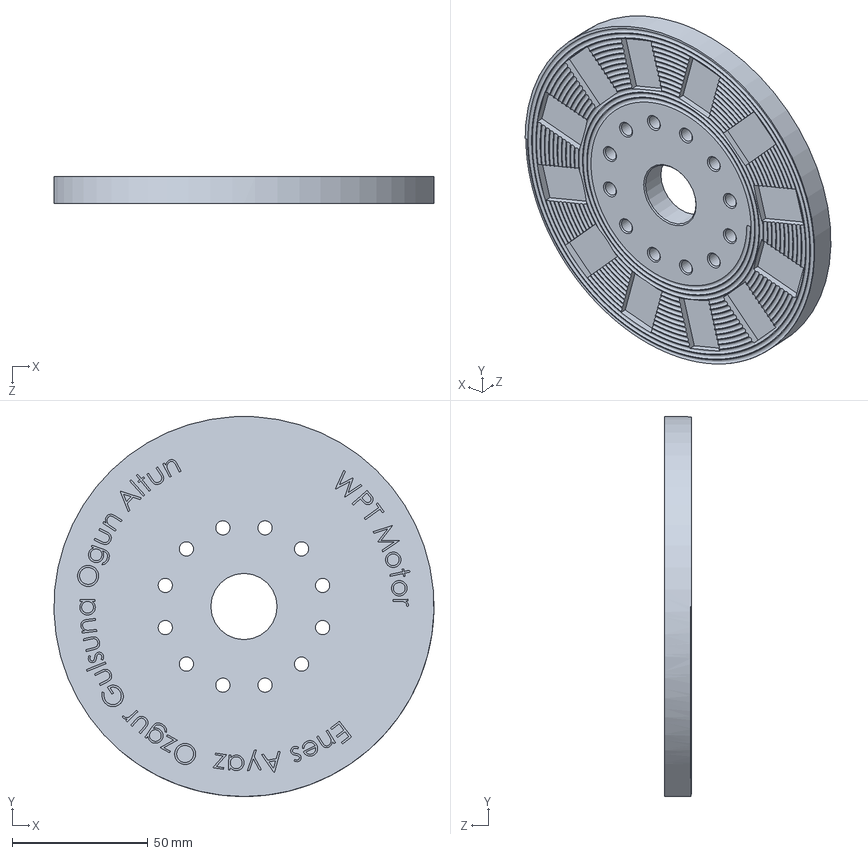
[picture p273: CAD file, 2021-11-17]
Synhronous motor/System-Design/Solid/Mechanic Drawings/slice_1o4.SLDPRT
140.0 x 140.0 x 10.0 mm
