EnesAyaz/WPTMotor/Synhronous motor/System-Design/Solid/Mechanic Drawings/loadAndcapacitor.SLDPRT

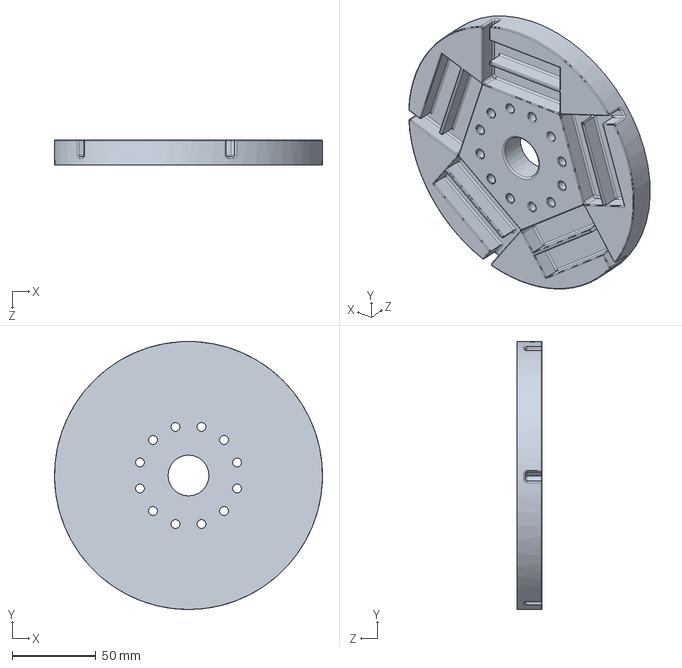
[picture p274: CAD file, 2021-11-17]
Synhronous motor/System-Design/Solid/Mechanic Drawings/loadAndcapacitor.SLDPRT
160.0 x 160.0 x 15.0 mm
