EnesAyaz/WPTMotor/Synhronous motor/System-Design/Solid/coupling_v2.STL

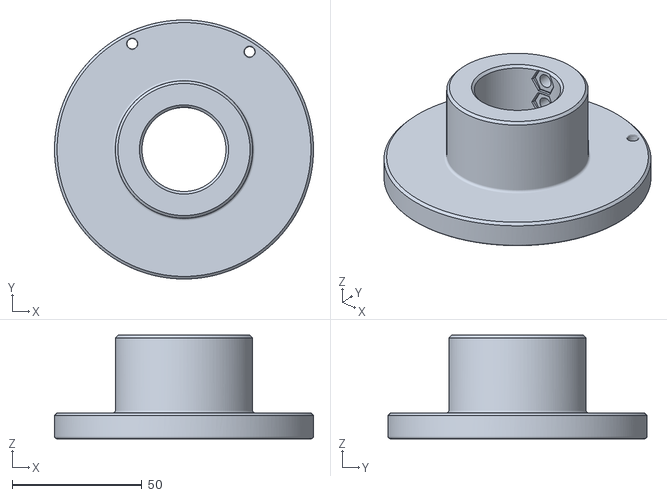
[picture p275: CAD file, 2022-04-20]
Synhronous motor/System-Design/Solid/coupling_v2.STL
100.0 x 100.0 x 40.0
