EnesAyaz/WPTMotor/Synhronous motor/System-Design/Solid/Mechanic Drawings/coupling.STEP

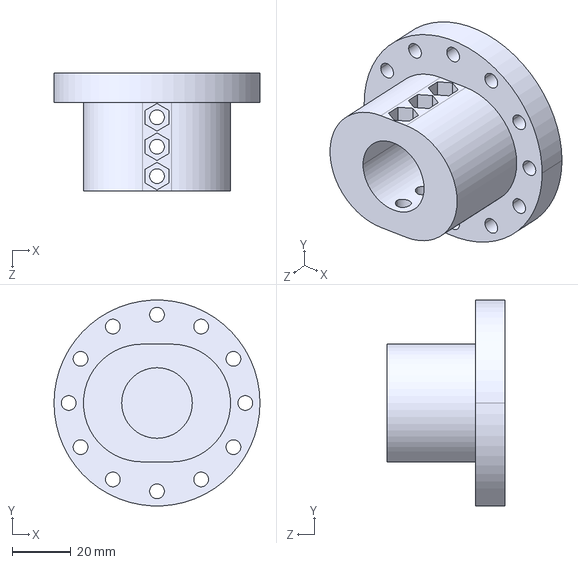
[picture p276: CAD file, 2021-11-02]
Synhronous motor/System-Design/Solid/Mechanic Drawings/coupling.STEP
70.0 x 69.9 x 40.0 mm
