EnesAyaz/WPTMotor/Synhronous motor/System-Design/Solid/part1_v2_deneme.SLDPRT

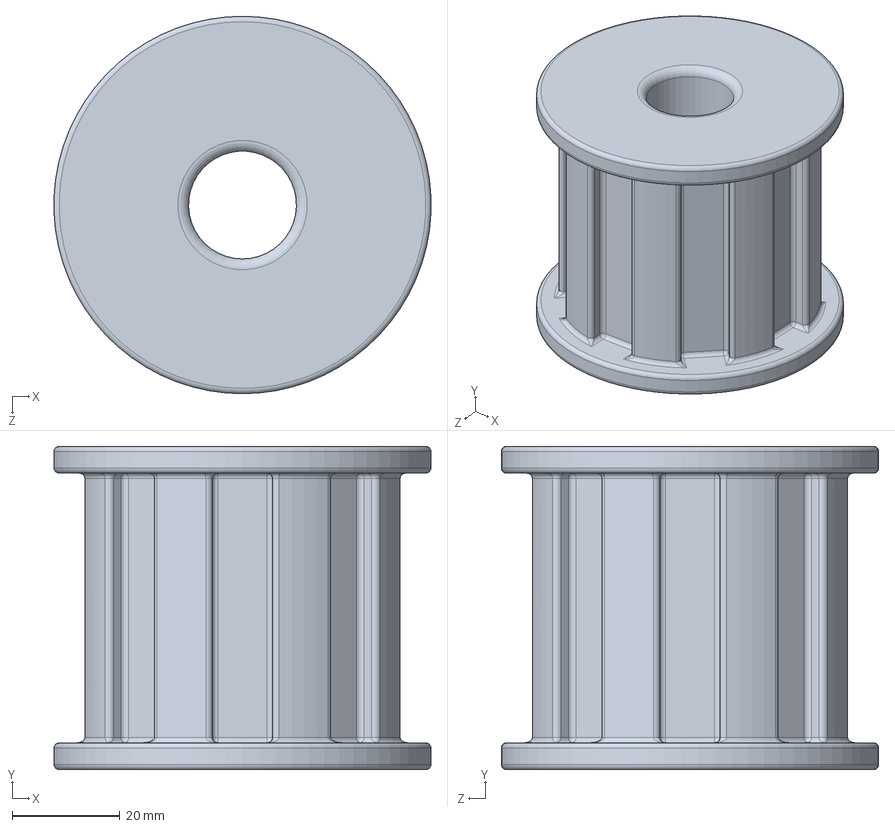
[picture p277: CAD file, 2022-04-18]
Synhronous motor/System-Design/Solid/part1_v2_deneme.SLDPRT
69.9 x 60.0 x 70.0 mm
