EnesAyaz/WPTMotor/Synhronous motor/System-Design/Solid/Mechanic Drawings/coupling_erdem.STL

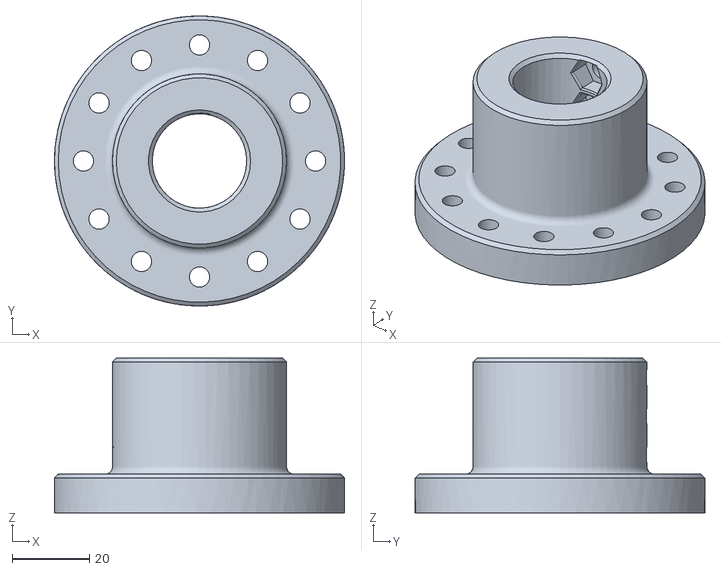
[picture p278: CAD file, 2021-11-02]
Synhronous motor/System-Design/Solid/Mechanic Drawings/coupling_erdem.STL
75.0 x 75.0 x 40.0
