EnesAyaz/WPTMotor/Synhronous motor/System-Design/Solid/part1_v1.SLDPRT

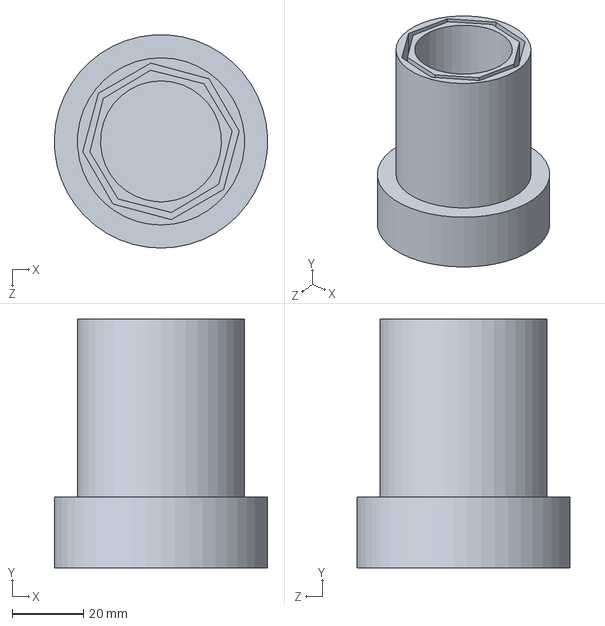
[picture p279: CAD file, 2022-04-07]
Synhronous motor/System-Design/Solid/part1_v1.SLDPRT
60.0 x 70.0 x 59.9 mm
