EnesAyaz/WPTMotor/Synhronous motor/System-Design/Solid/Mechanic Drawings/FerriteAndLoad.SLDPRT

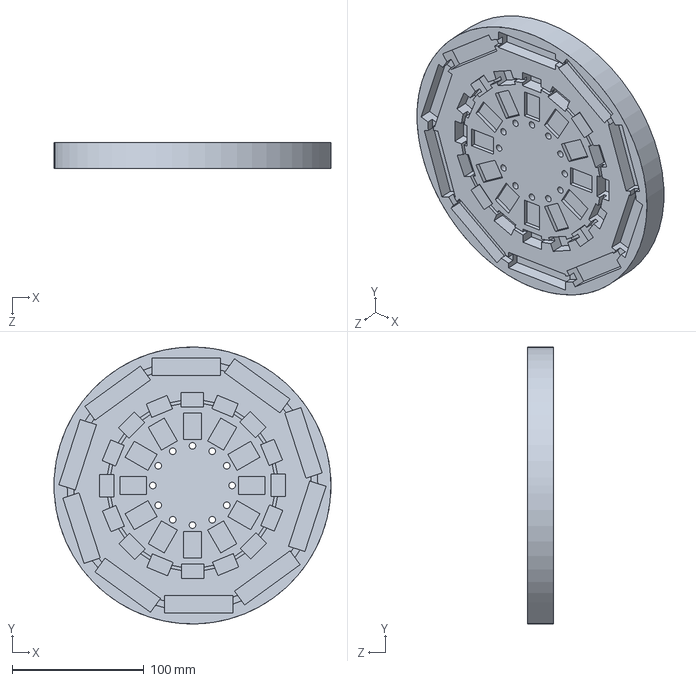
[picture p280: CAD file, 2021-11-02]
Synhronous motor/System-Design/Solid/Mechanic Drawings/FerriteAndLoad.SLDPRT
210.0 x 209.9 x 20.0 mm
