EnesAyaz/WPTMotor/Synhronous motor/System-Design/Solid/Mechanic Drawings/slice_load.SLDPRT

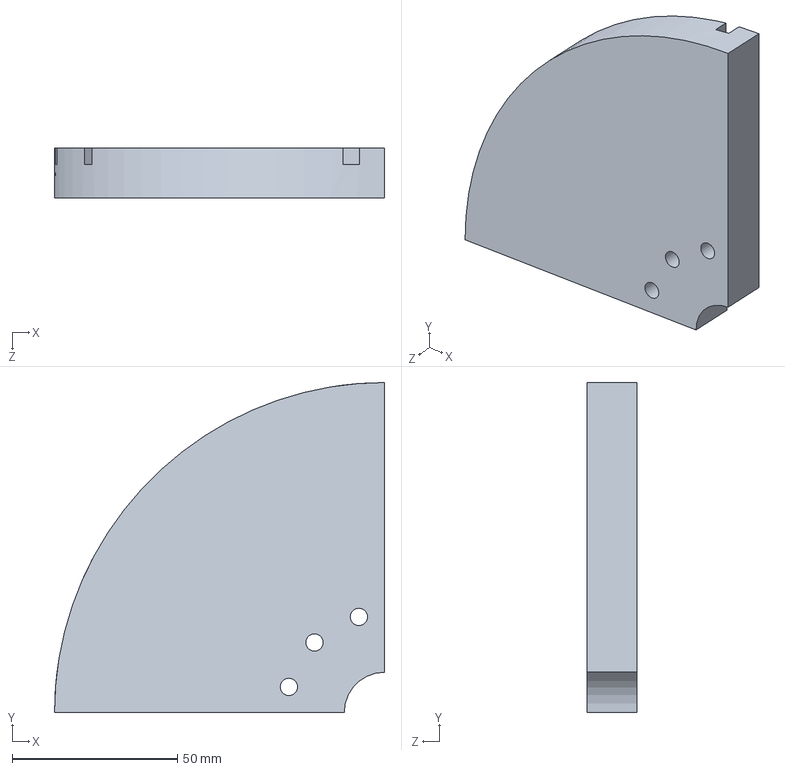
[picture p281: CAD file, 2021-11-02]
Synhronous motor/System-Design/Solid/Mechanic Drawings/slice_load.SLDPRT
100.0 x 100.0 x 15.0 mm
