EnesAyaz/WPTMotor/(list of files, cad)

Other CAD files:
Simulations/MATLAB-SIMULINK/3-Phase-Modelling/three_phase_WPT_grt_rtw/rt_main.obj
Simulations/MATLAB-SIMULINK/3-Phase-Modelling/three_phase_WPT_grt_rtw/rtGetNaN.obj
Simulations/MATLAB-SIMULINK/3-Phase-Modelling/three_phase_WPT_grt_rtw/rt_matrx.obj
Synhronous motor/System-Design/Solid/denemeler.SLDPRT
Simulations/MATLAB-SIMULINK/3-Phase-Modelling/three_phase_WPT_grt_rtw/rt_printf.obj
Synhronous motor/System-Design/Solid/coupling_v3.SLDPRT
Synhronous motor/System-Design/Solid/Mechanic Drawings/winding_erdem.STL
Simulations/MATLAB-SIMULINK/3-Phase-Modelling/three_phase_WPT_grt_rtw/three_phase_WPT_data.obj
Simulations/MATLAB-SIMULINK/3-Phase-Modelling/three_phase_WPT_grt_rtw/three_phase_WPT.obj
Synhronous motor/System-Design/Solid/Mechanic Drawings/loadAndcapacitor_erdem.STL
Simulations/MATLAB-SIMULINK/3-Phase-Modelling/three_phase_WPT_grt_rtw/rt_nonfinite.obj
Simulations/MATLAB-SIMULINK/3-Phase-Modelling/three_phase_WPT_grt_rtw/sfun_spssw_discc_DSS.obj
Simulations/MATLAB-SIMULINK/3-Phase-Modelling/three_phase_WPT_grt_rtw/rtGetInf.obj
Simulations/MATLAB-SIMULINK/3-Phase-Modelling/three_phase_WPT_grt_rtw/DSS_Utils.obj
Simulations/MATLAB-SIMULINK/3-Phase-Modelling/three_phase_WPT_grt_rtw/rt_logging.obj
Synhronous motor/System-Design/Solid/Mechanic Drawings/coupling.SLDPRT
Synhronous motor/System-Design/Solid/Mechanic Drawings/coupling.STL
Synhronous motor/System-Design/Solid/Mechanic Drawings/slip_ring_2.SLDDRW
Synhronous motor/System-Design/Solid/coupling.SLDPRT
