EnesAyaz/WPTMotor/Journal-3-phase/v2/Experimental-Setup/drive.jpeg

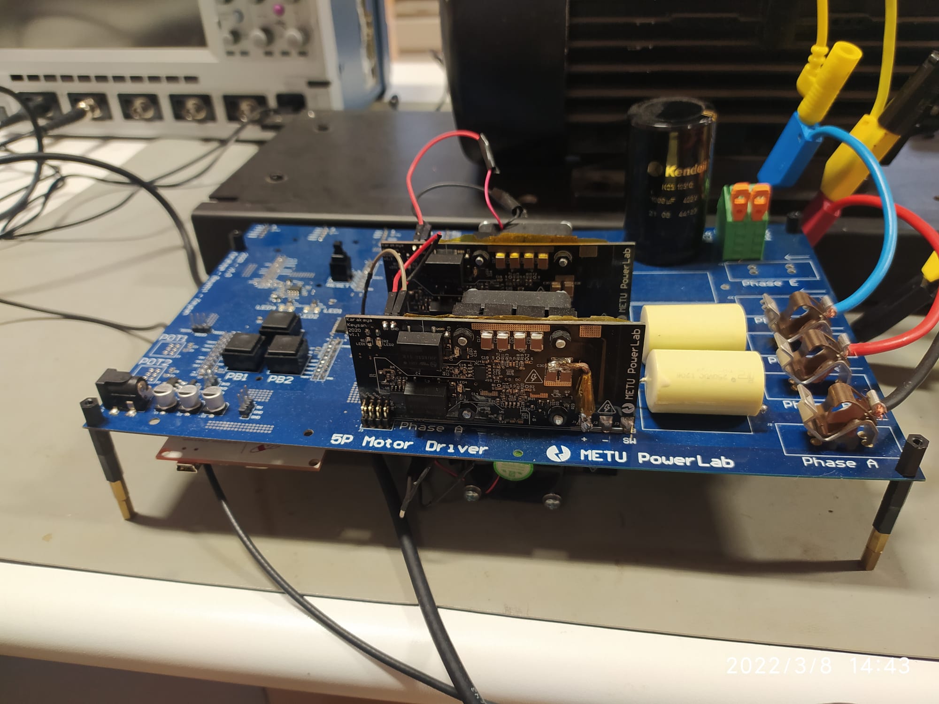
Journal-3-phase/v2/Experimental-Setup/drive.jpeg
