EnesAyaz/WPTMotor/Journal-3-phase/v2/Experimental-Setup/IMG_20230330_151718.jpg

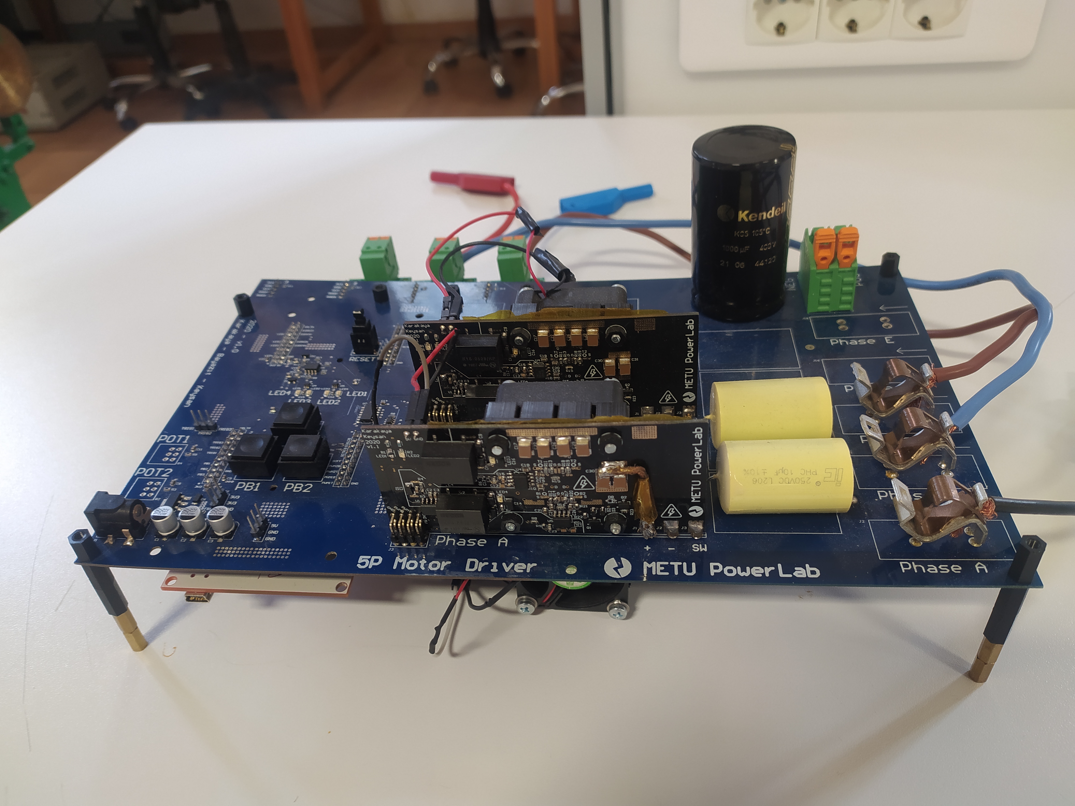
Journal-3-phase/v2/Experimental-Setup/IMG_20230330_151718.jpg
