EnesAyaz/WPTMotor/Journal-3-phase/v2/Experimental-Setup/setup.png

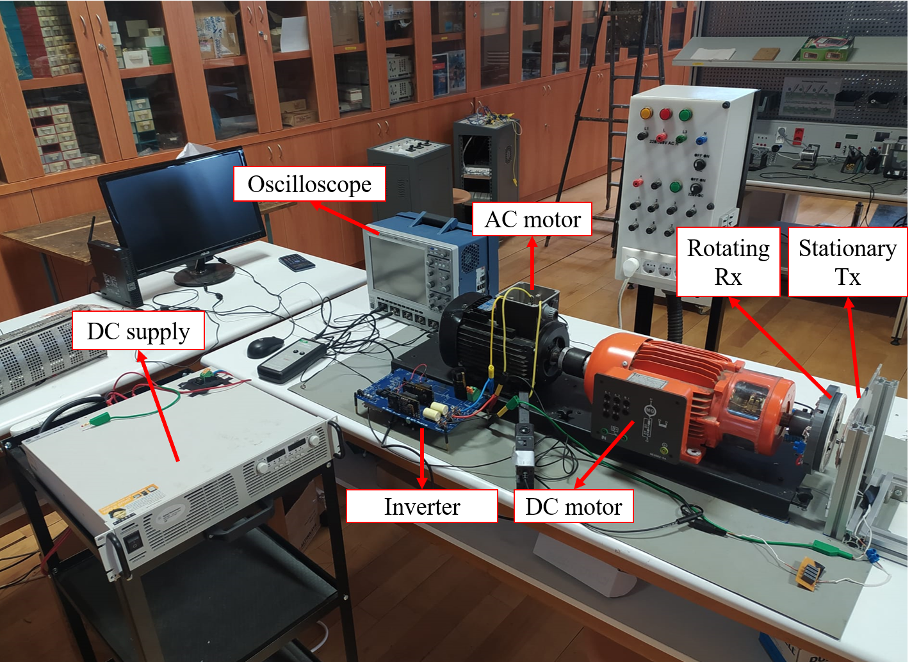
Journal-3-phase/v2/Experimental-Setup/setup.png
