EnesAyaz/WPTMotor/Journal-3-phase/v2/Experimental-Setup/setupall.jpeg

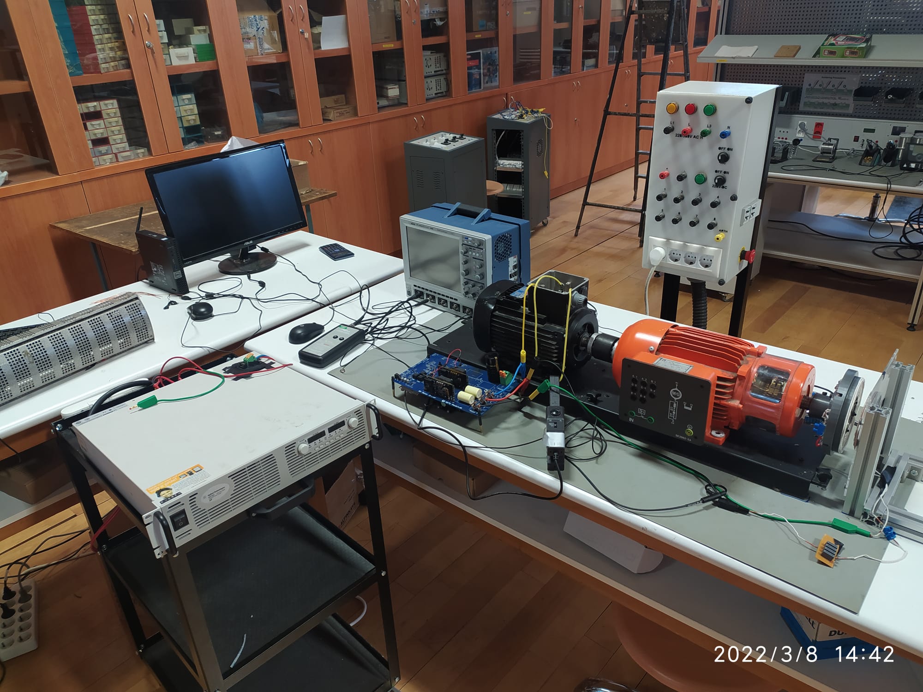
Journal-3-phase/v2/Experimental-Setup/setupall.jpeg
