EnesAyaz/WPTMotor/Journal-3-phase/v2/Experimental-Setup/WPTcoils.jpeg

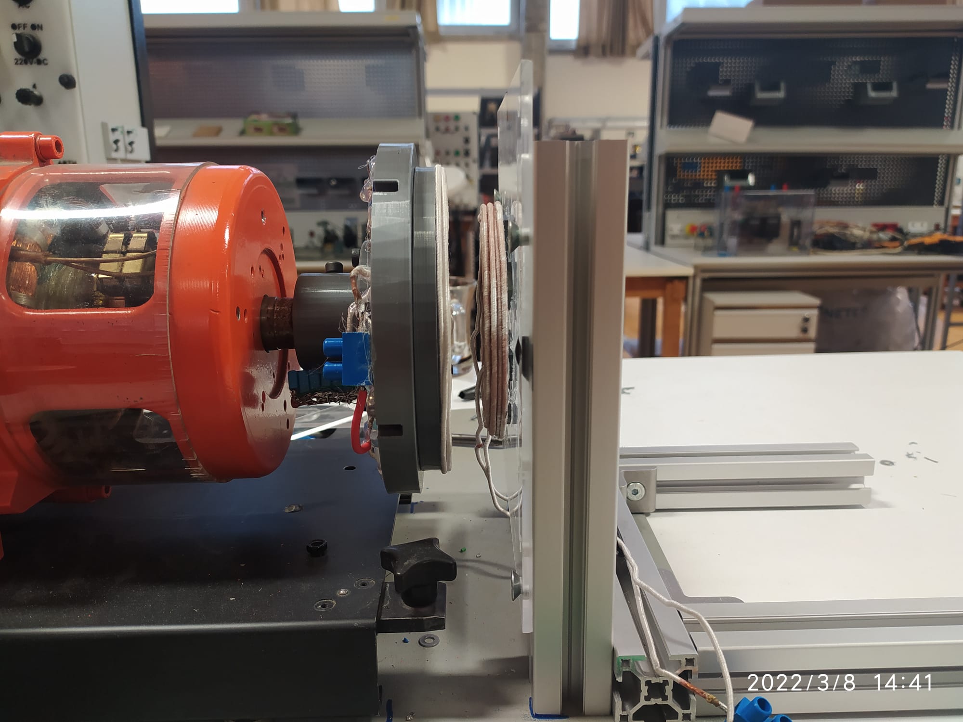
Journal-3-phase/v2/Experimental-Setup/WPTcoils.jpeg
