EnesAyaz/WPTMotor/Test-Result/2022.08.26/New Microsoft PowerPoint Presentation.pptx

Input Power

Motor
Losses

Mechanical
Losses

Mechanical
Power

Drive
Losses

Input Power

Drive
Losses

Motor
Losses

Mechanical
Losses

Mechanical
Power
