EnesAyaz/WPTMotor/Test-Result/2021.02.25/figure_creator3.pptx

D=0.6
F=80
L1

Zoom

Zoom

## Slide 2

D=0.6
F=86
L1

Zoom

Zoom

## Slide 3

D=0.6
F=86
L1

caseA

## Slide 4

D=0.75
F=77
L1

Case B

## Slide 5

D=0.75
F=77
L2
CaseC

## Slide 6

D=0.6
F=86
L2
Case D

## Slide 7

D=0.6
F=80
L2
Case E

## Slide 8

D=0.6
F=80
L1
Case F
