EnesAyaz/WPTMotor/Test-Result/2021.02.25/figure_creator2.pptx

Experimental data will be expended.
Above 100 kHz (102.5 105)

## Slide 2

Initial Operation
( f_(op) =86.5kHz)
( D =0.6)
( T_L = x1)

IPT Power
Control

Constant Motor Power
( f_(op) =80kHz)
( D =0.6)
( T_L = x1)

Motor Load
Changes

Constant Motor Power
( f_(op) =80 kHz)
( D =0.6)
( T_L = x2)

Motor
Speed
Control

Constant IPT Power
( f_(op) =77kHz)
( D =0.75)
( T_L = x1)

Motor Load
Changes

Constant IPT Power
( f_(op) =77kHz)
( D =0.75)
( T_L = x2)

Motor
Speed
Control

Constant IPT Power
( f_(op) =86.5kHz)
( D =0.6)
( T_L = x2)

A

B

F

C

E

IPT Power
Control

D

## Slide 3

## Slide 4

D=0.6
F=80
L1

Zoom

Zoom

## Slide 5

D=0.6
F=86
L1

Zoom

Zoom

## Slide 6

D=0.6
F=86
L1

caseA

Zoom

Zoom

## Slide 7

D=0.75
F=77
L1

Case B

Zoom

Zoom

## Slide 8

D=0.75
F=77
L2
CaseC

Zoom

Zoom

## Slide 9

D=0.6
F=86
L2
Case D

Zoom

Zoom

## Slide 10

D=0.6
F=80
L2
Case E

Zoom

Zoom

## Slide 11

D=0.6
F=80
L1
Case F

Zoom

Zoom
