EnesAyaz/WPTMotor/Test-Result/2023.02.03/major-version/New Microsoft PowerPoint Presentation.pptx

(a)

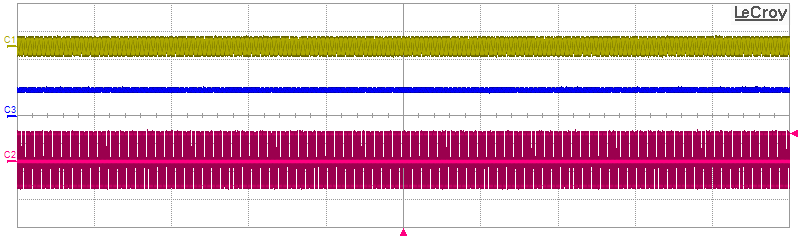
[picture p291: figure]

Current
(A)

Current
(A)

Voltage
(V)

Current
(A)

Current
(A)

Voltage
(V)

(b)

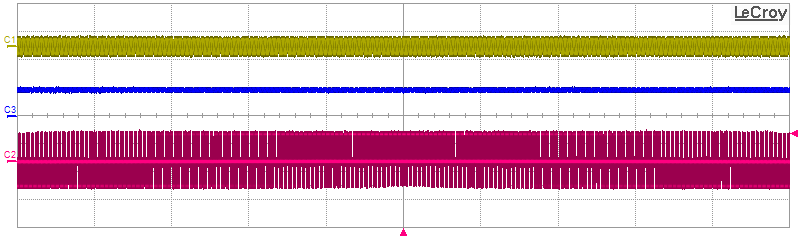
[picture p292: figure]

Current
(A)

Current
(A)

Time (μs)

(c)

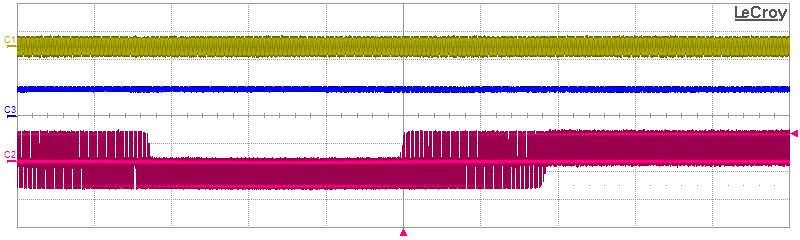
[picture p293: figure]

Voltage
(V)

Current
(A)

Current
(A)

Time (μs)

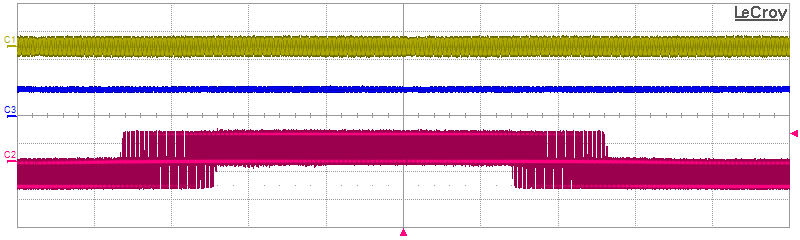
[picture p294: figure]

Current
(A)

Voltage
(V)

Time (μs)

(d)

Current
(A)

Voltage
(V)

Time (μs)

## Slide 2

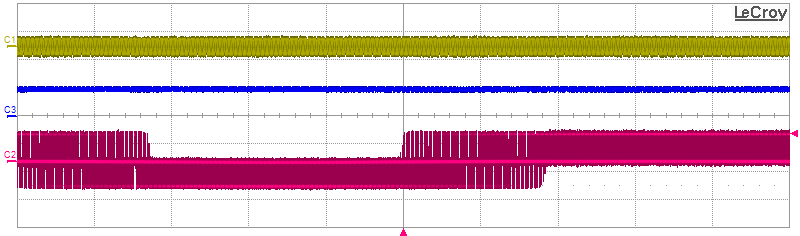
[picture p295: figure]

(a)

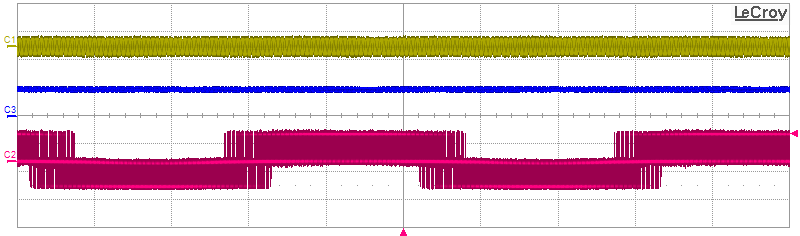
[picture p296: figure]

(b)

## Slide 3

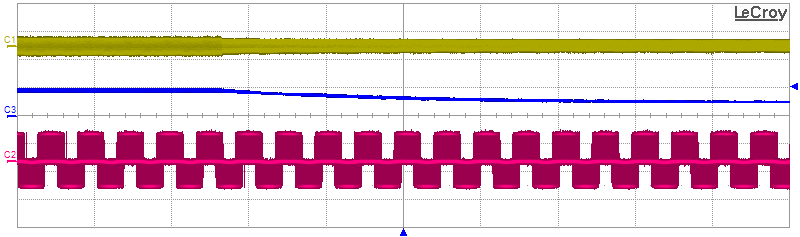
[picture p297: figure]

f_s =60 kHz

f_s =62 kHz

## Slide 4

Motor speed:
52 RPM

I_F =4.7 A

Motor speed
increases

Motor speed:
101 RPM

I_F =4.8 A

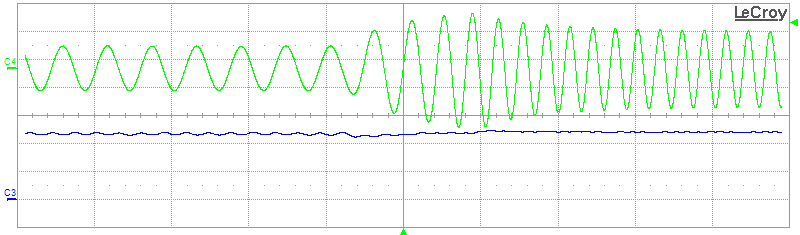
[picture p298: figure]

## Slide 5

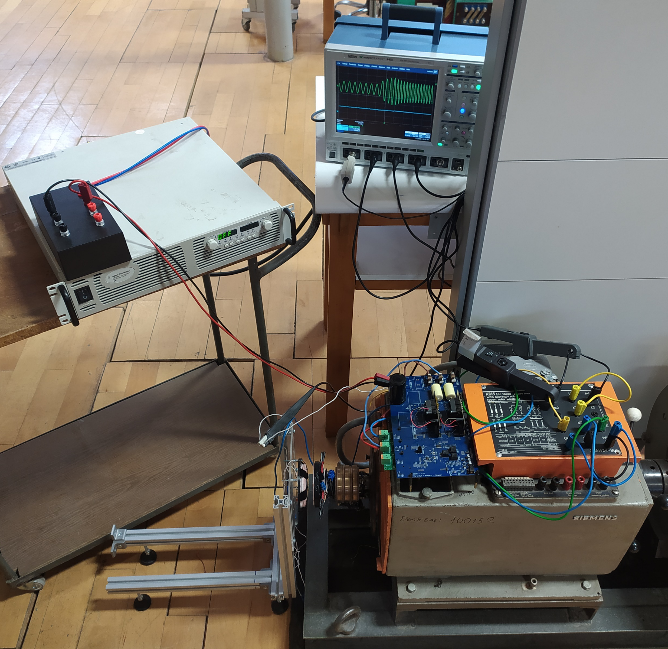
[picture p299: figure]

Oscilloscope

Current probes

Stationary
Tx coil

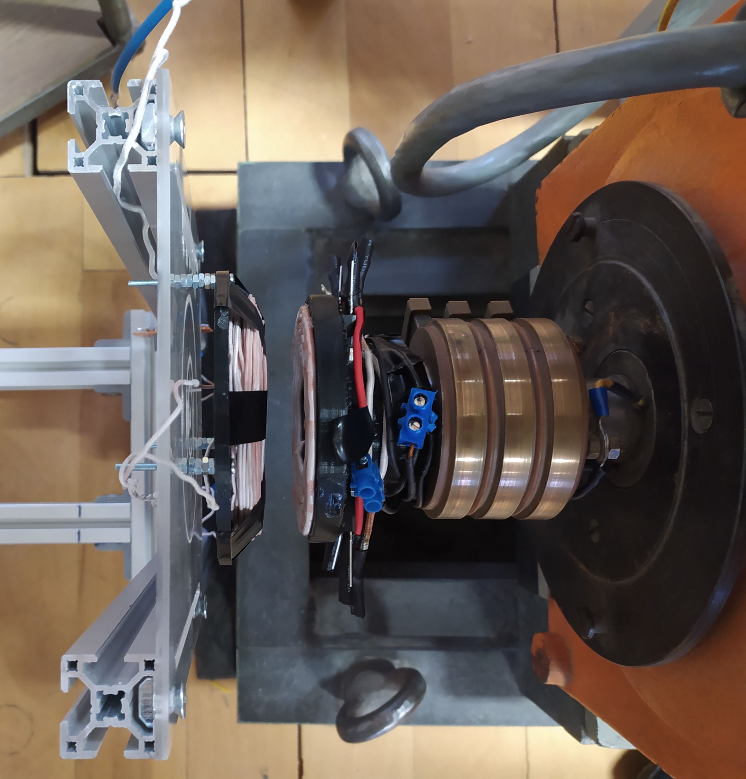
[picture p300: figure]

Rotating Rx coil

Rotating diode rectifier

DC supply

Contactless field excitation system

Current probe

Motor drive

Electrically excited synchronous motor

(b)

(a)
