EnesAyaz/WPTMotor/Test-Result/2021.09/New Microsoft Excel Worksheet.xlsx

Vin=200V |  |  | Kademe-1 |  |  |  | Vin=200V |  |  | Kademe-4
ma | 0 | 0.2 | 0.4 | 0.6 | 0.8 | 1 | ma | 0 | 0.2 | 0.4 | 0.6 | 0.8 | 1
Iin | 0.37 | 0.565 | 1.15 | 2.16 | 3.63 | 5.53 | Iin | 0.37 | 0.45 | 0.68 | 1.07 | 1.67 | 2.5
Iph | 0 | 1.18 | 2.02 | 2.92 | 3.85 | 4.84 | Iph | 0 | 0.9 | 1.13 | 1.42 | 1.73 | 2.05
Itx | 2.13 | 2.1 | 1.98 | 1.87 | 1.89 | 2.09 | Itx | 2.12 | 2.1 | 1.97 | 1.86 | 1.88 | 2.1
Vout | 44.5 | 44 | 42.1 | 40.8 | 41 | 44.7 | Vout | 44.5 | 43.9 | 42 | 40.5 | 40.8 | 44.7
Vin=200V |  |  | Kademe-2 |  |  |  | Vin=200V |  |  | Kademe-5
ma | 0 | 0.2 | 0.4 | 0.6 | 0.8 | 1 | ma | 0 | 0.2 | 0.4 | 0.6 | 0.8 | 1
Iin | 0.37 | 0.53 | 1 | 1.8 | 2.93 | 4.5 | Iin | 0.366 | 0.41 | 0.51 | 0.71 | 1 | 1.42
Iph | 0 | 1.13 | 1.74 | 2.4 | 3.09 | 3.85 | Iph | 0 | 0.8 | 0.88 | 0.96 | 1.07 | 1.2
Itx | 2.12 | 2.1 | 1.97 | 1.87 | 1.89 | 2.09 | Itx | 2.12 | 2.09 | 1.97 | 1.86 | 1.88 | 2.1
Vout | 44.6 | 44.1 | 42 | 40.7 | 41 | 44.7 | Vout | 44.5 | 43.9 | 42 | 40.5 | 40.7 | 44.9
Vin=200V |  |  | Kademe-3
ma | 0 | 0.2 | 0.4 | 0.6 | 0.8 | 1
Iin | 0.37 | 0.49 | 0.84 | 1.45 | 2.32 | 3.49
Iph | 0 | 1 | 1.43 | 1.91 | 2.41 | 2.93
Itx | 2.12 | 2.1 | 1.97 | 1.86 | 1.88 | 2.09
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
