EnesAyaz/WPTMotor/Test-Result/2021.12.01/New Microsoft PowerPoint Presentation.pptx

D:\Github\WPTMotor\Test-Result\2022.12.01

data_plotter

## Slide 2

## Slide 3

D:\Github\WPTMotor\Test-Result\2022.12.01

t_1

t_2

Zoom

Zoom

## Slide 4

t_1

t_2

Zoom

Zoom

## Slide 5

D:\Github\WPTMotor\Test-Result\2022.12.01

t_1

t_2

Zoom

Zoom

data_plotter_transient_v2

## Slide 6

t_1

t_2

## Slide 7

t_1

t_2

## Slide 8

D:\Github\WPTMotor\Test-Result\2022.12.01

t_1

t_2

data_plotter_transient_tx_v2

## Slide 9

## Slide 10

D:\Github\WPTMotor\Test-Result\2022.12.01

data_plotter_v2

## Slide 11

D:\Github\WPTMotor\Test-Result\2021.11.29

Plotter_all_WPT_motor

a)

b)

c)

## Slide 12

D:\Github\WPTMotor\Test-Result\2021.11.29

a)

b)

c)

Plotter_all_WPT_motor_v2

## Slide 13

D:\Github\WPTMotor\Test-Result\2021.11.29

Plotter_all_WPT_motor_v2

a)

b)

c)

## Slide 14

D:\Github\WPTMotor\Test-Result\2021.11.29

Plotter_all_WPT_motor_v2

a)

b)

c)

## Slide 15

D:\Github\WPTMotor\Test-Result\2021.11.29

## Slide 16

D:\Github\WPTMotor\Test-Result\2021.11.29

## Slide 17

D:\Github\WPTMotor\Test-Result\2021.11.29

## Slide 18

D:\Github\WPTMotor\Test-Result\2022.12.01

data_plotter_v2
