EnesAyaz/WPTMotor/Test-Result/2021.04.15/WPT-motor.pptx

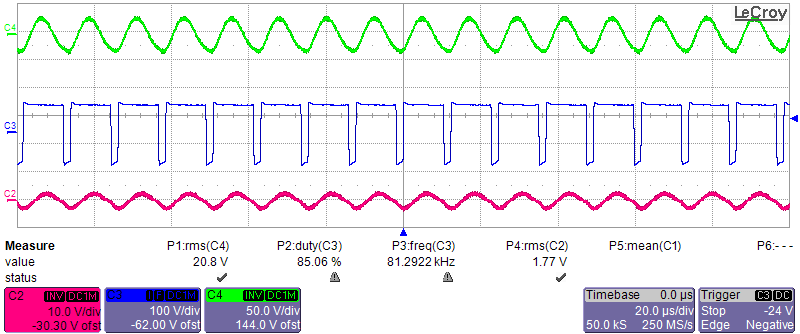
[picture p301: figure]

V_(RX)

V_O

I_(TX)

## Slide 2

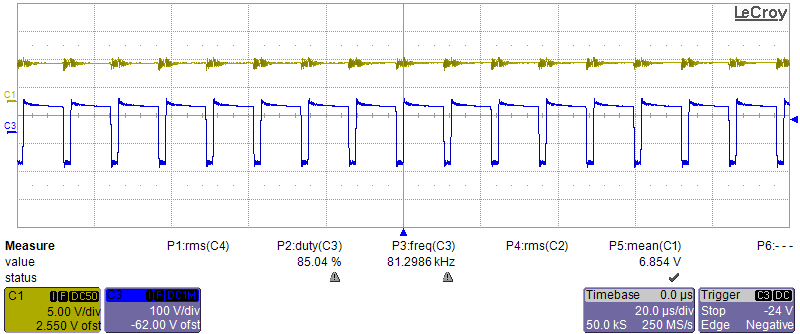
[picture p302: figure]

I_M

V_O

## Slide 3

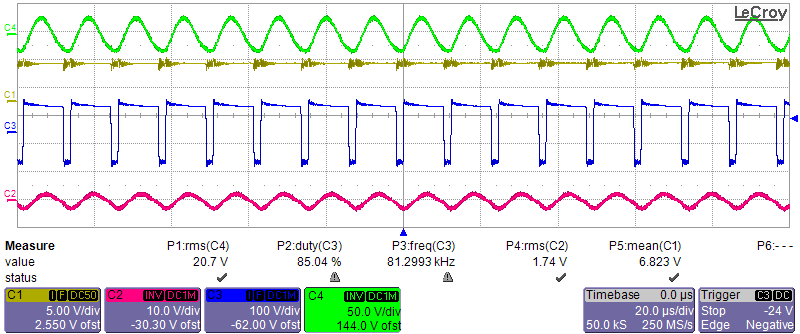
[picture p303: figure]

V_(RX)

V_O

I_M

I_(TX)

## Slide 4

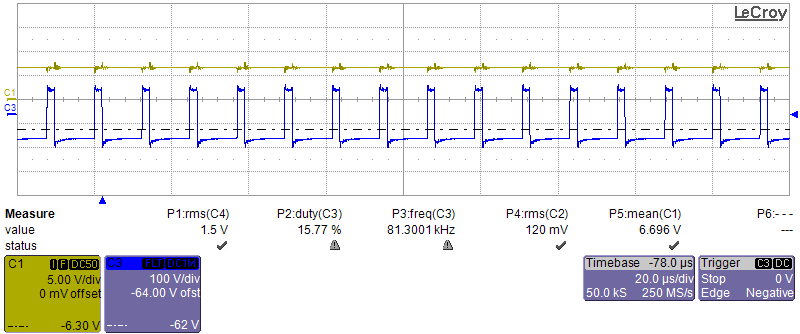
[picture p304: figure]

## Slide 5

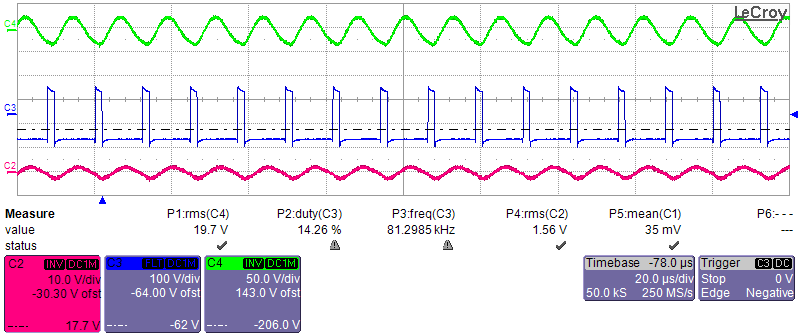
[picture p305: figure]

## Slide 6

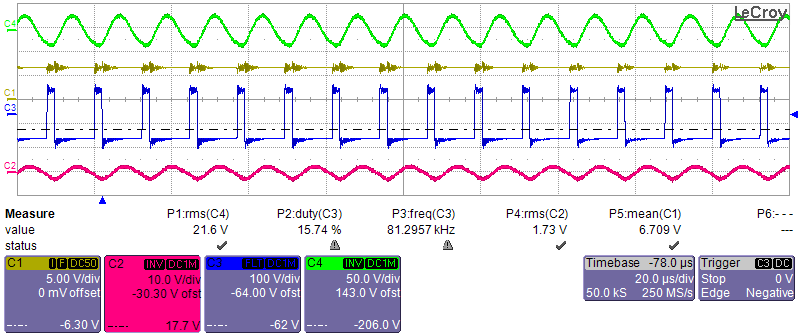
[picture p306: figure]

## Slide 7

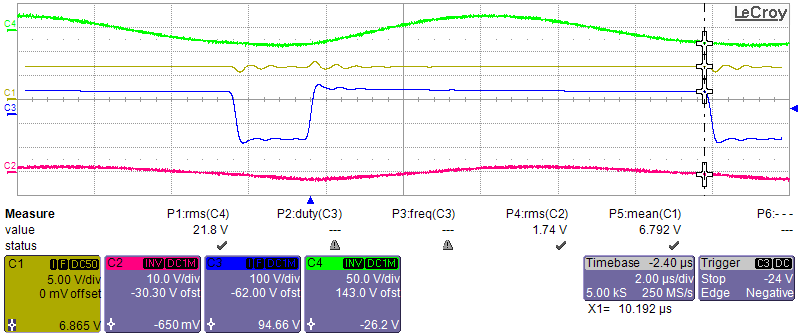
[picture p307: figure]
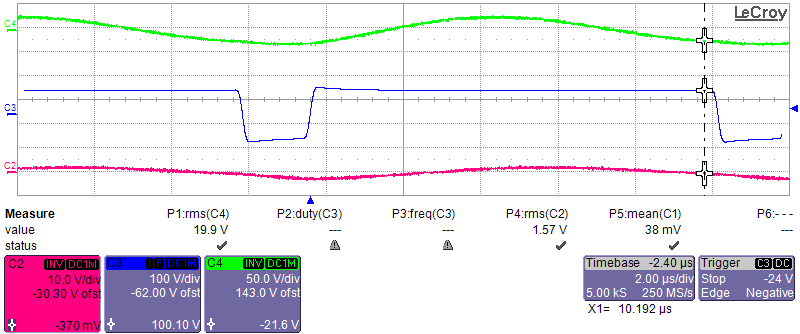
[picture p308: figure]
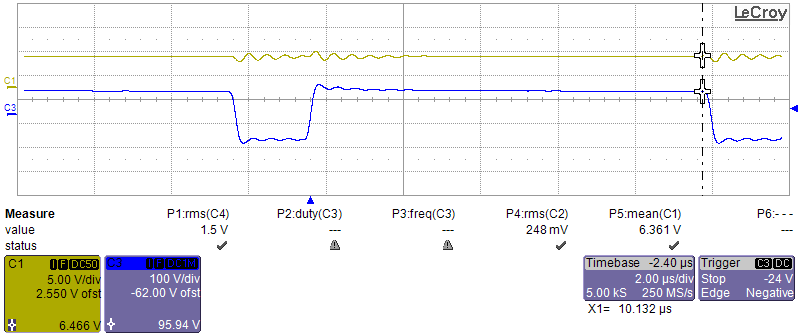
[picture p309: figure]
