EnesAyaz/WPTMotor/Test-Result/2021.02.25/figure_creator.pptx

## Slide 2

Zoom

Zoom

## Slide 3

D=0.6
F=80
L1

Zoom

Zoom

## Slide 4

D=0.6
F=80
L1

Zoom

Zoom

## Slide 5

D=0.6
F=80
L2

Zoom

Zoom

## Slide 6

D=0.6
F=86
L1

Zoom

Zoom

## Slide 7

D=0.6
F=86
L2

Zoom

Zoom

## Slide 8

D=0.75
F=77
L1

Zoom

Zoom

## Slide 9

D=0.75
F=77
L2

Zoom

Zoom
