EnesAyaz/WPTMotor/Test-Result/2021.02.23/Figure_creator.pptx

a)

b)

d)

c)

e)

## Slide 2

a)

b)

d)

c)

e)

## Slide 3

a)

b)

d)

c)

e)

## Slide 4

a)

b)

d)

c)

e)

## Slide 5

a)

b)

d)

c)

e)

## Slide 6
