EnesAyaz/WPTMotor/Thesis/Experimental/Frequency_carrier_phase_shift/Figures.pptx

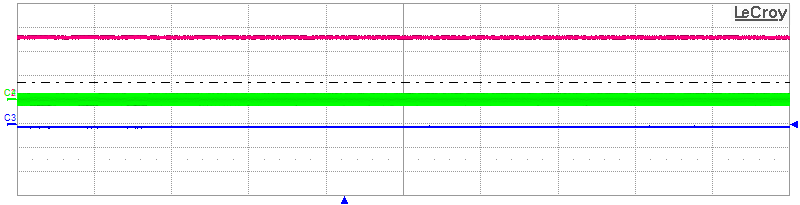
[picture p310: figure]

I_f =5.18 A

I_(inv) = 0.4 A_(RMS)

I_(phA) = 0 A_(RMS)

## Slide 2

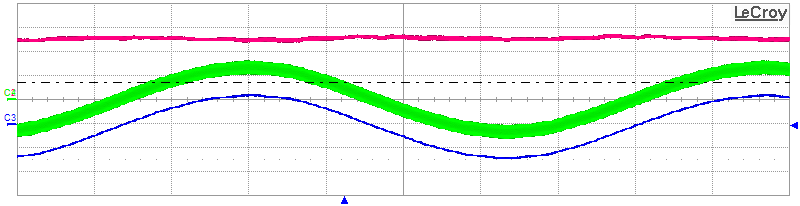
[picture p311: figure]

I_f =5.1 A

I_(inv) = 1.9 A_(RMS)

I_(phA) = 1.8 A_(RMS)

## Slide 3

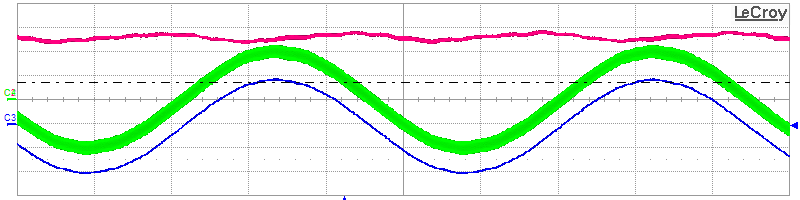
[picture p312: figure]

I_f =5.2 A

I_(inv) = 2.8 A_(RMS)

I_(phA) = 2.7 A_(RMS)

## Slide 4

I_f =5.2 A

I_(inv) = 0.4 A_(RMS)

I_(phA) = 0 A_(RMS)

I_f =5.1 A

I_(inv) = 1.9 A_(RMS)

I_(phA) = 1.8 A_(RMS)

I_f =5.2 A

I_(inv) = 2.8 A_(RMS)

I_(phA) = 2.7 A_(RMS)

Time=50(ms)/(div)

(a)

Time=50(ms)/(div)

(b)

Time=50(ms)/(div)

(c)

## Slide 5

## Slide 6

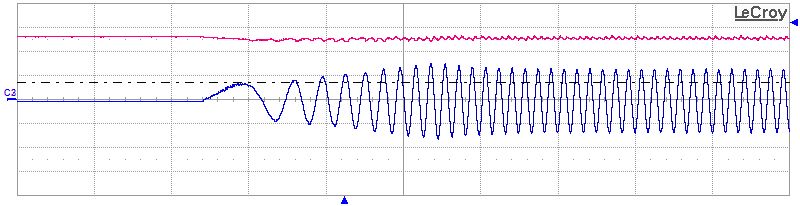
[picture p313: figure]

I_f =5.2A

I_f =5.1A

Time=2s/(div)

I_(phA) = 1.8 A_(RMS)

(a)

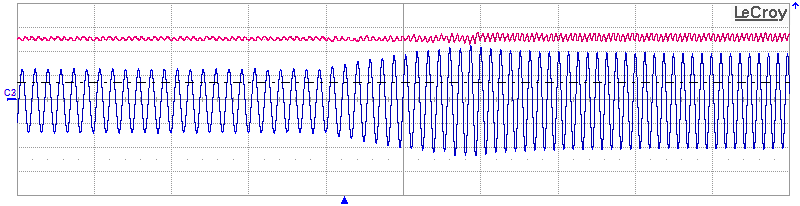
[picture p314: figure]

I_f =5.1A

I_f =5.2A

I_(phA) = 1.5 A_(RMS)

Time=2s/(div)

I_(phA) = 2.7 A_(RMS)

(b)

## Slide 7

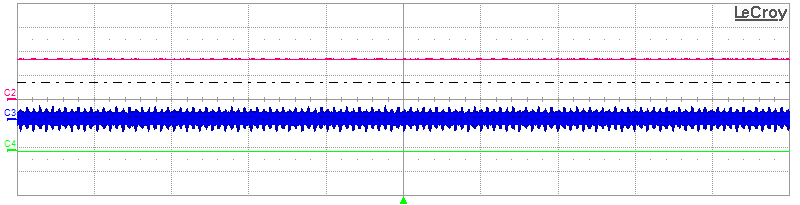
[picture p315: figure]

I_f =3.3A

I_(inv) =0.85A

I_(phA) =0 A

Time=100(ms)/(div)

## Slide 8

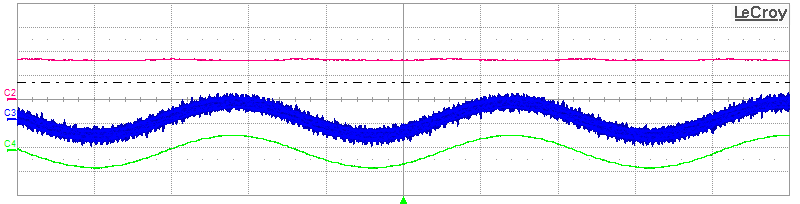
[picture p316: figure]

I_f =3.3A

I_(inv) =2.6A

Time=100(ms)/(div)

I_(phA) =2.4 A

## Slide 9

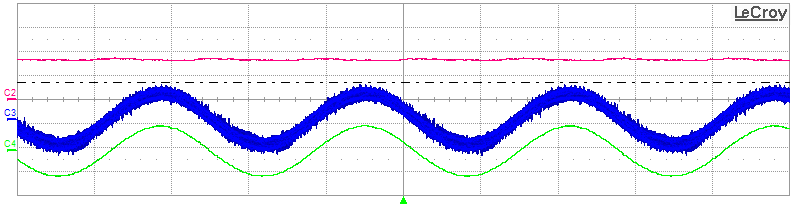
[picture p317: figure]

I_f =3.3A

I_(inv) =3.9A

I_(phA) =3.7 A

Time=100(ms)/(div)

## Slide 10

I_f =3.3A

I_(inv) =0.85A

I_(phA) =0 A

Time=100(ms)/(div)

(a)

I_f =3.3A

I_(inv) =2.6A

I_(phA) =2.4 A

Time=100(ms)/(div)

(b)

I_f =3.3A

I_(inv) =3.9A

Time=100(ms)/(div)

I_(phA) =3.7 A

(c)
