EnesAyaz/WPTMotor/Synhronous motor/TPEL-major-revision/Figures/Experiment/New Microsoft PowerPoint Presentation.pptx

m_a =0

U_i

m_a =0.2

m_a =0.3

Controllable Region

m_a =0.4

m_a =0.5

m_a =0.6

m_a =0.7

m_a =0.8

Uncontrollable Region

m_a =0.9

m_a =1

U_i / U_i^f (p.u)

U_i^f

Time (ms)

## Slide 2

m_a =0

U_i

m_a =0.2

m_a =0.3

Controllable Region

m_a =0.4

m_a =0.5

m_a =0.6

m_a =0.7

m_a =0.8

Uncontrollable Region

m_a =0.9

m_a =1

U_i / U_i^f (p.u)

U_i^f

Time (ms)

## Slide 3

m_a =0

U_i

m_a =0.2

m_a =0.3

Controllable Region

m_a =0.4

m_a =0.5

m_a =0.6

m_a =0.7

m_a =0.8

Uncontrollable Region

m_a =0.9

m_a =1

U_i / U_i^f (p.u)

U_i^f

Time (ms)

U_i / U_i^f (p.u)

U_i / U_i^f (p.u)

Time (ms)

Time (ms)

## Slide 4

Controllable Region

Uncontrollable
Region

m_a =

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
U_i^f
