EnesAyaz/WPTMotor/Test-Result/2021.02.18/IPT-Duty-Cycle.xlsx

 |  | Experiment
Duty Cycle | Simulation | Pirmer Akım | Seconder Akım | Input Current | Input Voltage
 | Gain
0 | 0 |  |  |  | 40
0.05 | 0.2 | 230 | 430 | 0 | 40
0.1 | 0.39 | 458 | 720 | 0.11 | 40
0.15 | 0.58 | 675 | 1040 | 0.24 | 40
0.2 | 0.75 | 872 | 1350 | 0.41 | 40
0.25 | 0.9 | 1054 | 1630 | 0.6 | 40
0.3 | 1.03 | 1212 | 1870 | 0.79 | 40
0.35 | 1.13 | 1342 | 2080 | 0.97 | 40
0.4 | 1.21 | 1437 | 2230 | 1.11 | 40
0.45 | 1.26 | 1496 | 2330 | 1.2 | 40
0.5 | 1.27 | 1517 | 2360 | 1.24 | 40
0.55 | 1.26 | 1496 | 2330 | 1.2 | 40
0.6 | 1.21 | 1437 | 2230 | 1.11 | 40
0.65 | 1.13 | 1342 | 2080 | 0.97 | 40
0.7 | 1.03 | 1212 | 1870 | 0.79 | 40
0.75 | 0.9 | 1054 | 1630 | 0.6 | 40
0.8 | 0.75 | 872 | 1350 | 0.41 | 40
0.85 | 0.58 | 675 | 1040 | 0.24 | 40
0.9 | 0.39 | 458 | 720 | 0.11 | 40
0.95 | 0.2 | 230 | 430 | 0 | 40
1 | 0 |  |  |  | 40
