EnesAyaz/WPTMotor/Test-Result/2021.02.18/IPT-freq.xlsx

 |  | Experiment
Frequency (kHz) | Simulation Gain | Primer Akım | Sekonder Akım | Sekonder Voltaj | Input Akım | input voltaj
40 | 0.044 |  |  |  |  | 40
42.5 | 0.061 | 527 | 390 |  | 0 | 40
45 | 0.085 | 620 | 460 |  | 0 | 40
47.5 | 0.124 | 741 | 600 |  | 0.08 | 40
50 | 0.184 | 930 | 850 |  | 0.16 | 40
52.5 | 0.277 | 1188 | 1300 |  | 0.37 | 40
55 | 0.414 | 1477 | 1880 |  | 0.78 | 40
57.5 | 0.538 | 1588 | 2280 |  | 1.17 | 40
60 | 0.569 | 1398 | 2330 |  | 1.19 | 40
62.5 | 0.542 | 1201 | 2200 |  | 1.06 | 40
65 | 0.512 | 1107 | 2100 |  | 0.97 | 40
67.5 | 0.499 | 1075 | 2100 |  | 0.96 | 40
70 | 0.5 | 1132 | 2130 |  | 1 | 40
72.5 | 0.512 | 1223 | 2190 |  | 1.08 | 40
75 | 0.53 | 1344 | 2310 |  | 1.18 | 40
77.5 | 0.544 | 1470 | 2380 |  | 1.26 | 40
80 | 0.547 | 1516 | 2360 |  | 1.24 | 40
82.5 | 0.531 | 1492 | 2240 |  | 1.1 | 40
85 | 0.489 | 1404 | 1980 |  | 0.88 | 40
87.5 | 0.441 | 1265 | 1710 |  | 0.67 | 40
90 | 0.389 | 1145 | 1480 |  | 0.51 | 40
92.5 | 0.342 | 1033 | 1280 |  | 0.38 | 40
95 | 0.301 | 924 | 1120 |  | 0.29 | 40
97.5 | 0.265 | 847 | 1000 |  | 0.22 | 40
100 | 0.236 | 770 | 890 |  | 0.17 | 40
