EnesAyaz/WPTMotor/Simulations/MATLAB-SIMULINK/3-Phase-Modelling/New_models/Simulation_results_VAB.xlsx

Sheet: Sheet1
Vdc=100V | fsw=80kHz | fm=500 Hz | ölçümler VAB (line-to-line)
carrier phase yok
ma | fo | fsw-2fm | fsw | fsw+2fm
0 | 0 | 0 | 0 | 0
0.1 | 8.403 | 0.3057 | 0.002 | 0.3178
0.2 | 17.04 | 1.289 | 0.00215 | 1.293
0.3 | 25.69 | 2.924 | 0.00483 | 2.932
0.4 | 34.32 | 5.154 | 0.00547 | 5.164
0.5 | 42.94 | 7.928 | 0.0049 | 7.945
0.6 | 51.55 | 11.19 | 0.008 | 11.2
0.7 | 60.18 | 14.88 | 0.006 | 14.86
0.8 | 68.8 | 18.84 | 0.006 | 18.84
0.9 | 77.41 | 23 | 0.007 | 23.01
1 | 86.04 | 27.3 | 0.006 | 27.31

Sheet: Sheet2
Vdc=100V | fsw=80kHz | fm=500 Hz | ölçümler VAB (line-to-line)
carrier 120 shifted
ma | fo | fsw-2fm | fsw | fsw+2fm
0 | 0 | 0 | 110.3 | 0
0.1 | 8.41 | 0.2727 | 109.6 | 0
0.2 | 17.05 | 1.277 | 107.6 | 0
0.3 | 25.68 | 2.91 | 104.3 | 0
0.4 | 34.32 | 5.151 | 99.7 | 0
0.5 | 42.93 | 7.932 | 93.97 | 0
0.6 | 51.56 | 11.2 | 87.19 | 0
0.7 | 60.18 | 14.86 | 79.48 | 0
0.8 | 68.81 | 18.84 | 70.96 | 0
0.9 | 77.41 | 23.01 | 61.81 | 0
1 | 86.05 | 27.31 | 52.17 | 0
0.6366197724 | 0.6326988333 | 0.6210084385 | 0.6017643686 | 0.5753213365 | 0.542165715 | 0.5029055777 | 0.458258264 | 0.4090357391 | 0.3561280604 | 0.3004853065
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
