EnesAyaz/WPTMotor/Synhronous motor/TPEL-Journal/Experimental-Results/ExperimentalResult.pptx

m_a =0, f_(sw) =10kHz, f_o =100Hz

m_a =0.3, f_(sw) =10kHz, f_o =100Hz

5V/div 2ms/div

(a)

5V/div 2ms/div

(b)

m_a =0.6, f_(sw) =10kHz, f_o =100Hz

m_a =0.86, f_(sw) =10kHz, f_o =100Hz

5V/div 2ms/div

(c)

5V/div 2ms/div

(d)

## Slide 2

5V/div 2ms/div

(a)

5V/div 2ms/div

(b)

5V/div 2ms/div

(c)

5V/div 2ms/div

(d)

## Slide 3

Switching frequency and its sidebands

5V/div 2ms/div

Fundamental frequency

## Slide 4

Switching frequency and its sidebands

5V/div 2ms/div

Fundamental frequency

## Slide 5

Switching frequency and its sidebands

5V/div 2ms/div

Fundamental frequency

## Slide 6

5V/div 2ms/div

## Slide 7

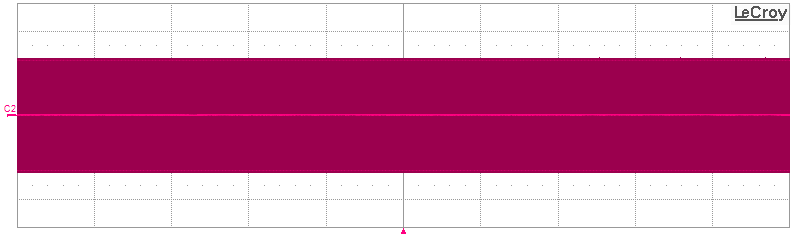
[picture p318: figure]

Switching frequency and its sidebands

Fundamental frequency

5V/div 2ms/div

## Slide 8

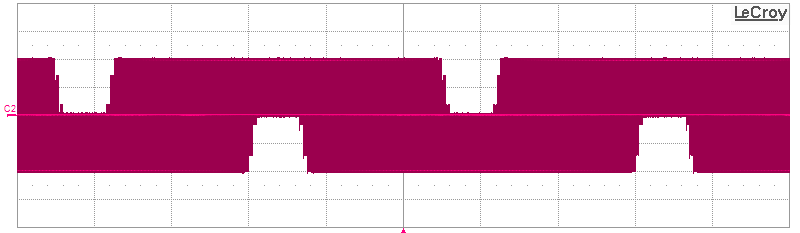
[picture p319: figure]

Switching frequency and its sidebands

Fundamental frequency

5V/div 2ms/div

## Slide 9

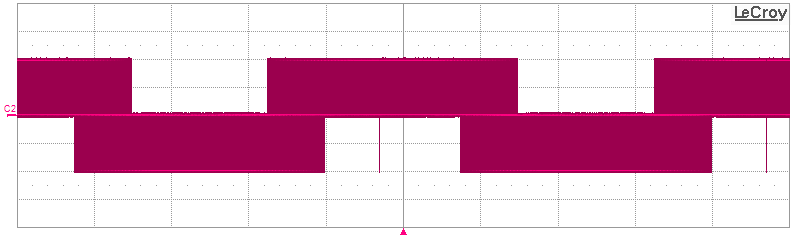
[picture p320: figure]

Switching frequency and its sidebands

Fundamental frequency

5V/div 2ms/div

## Slide 10

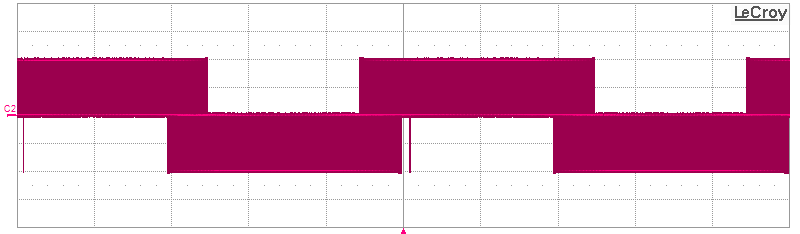
[picture p321: figure]

Switching frequency and its sidebands

Fundamental frequency

5V/div 2ms/div

## Slide 11

## Slide 12

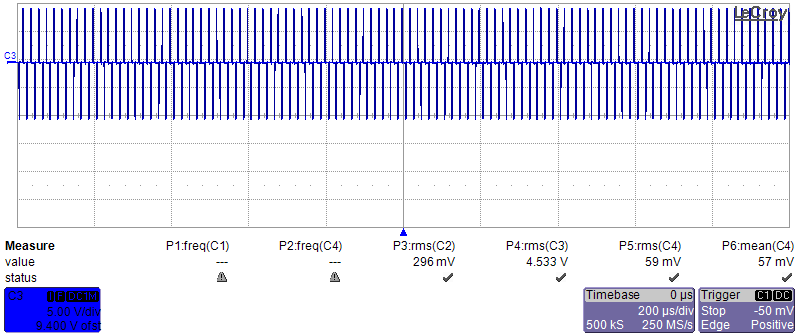
[picture p322: figure]

0.43

## Slide 13

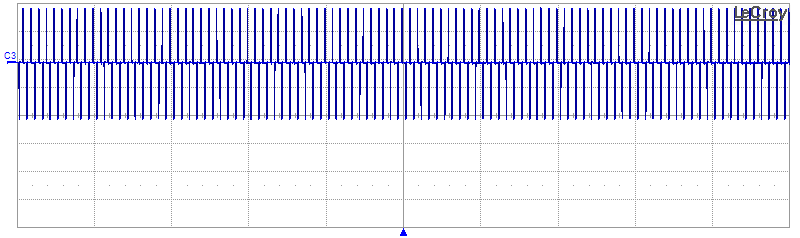
[picture p323: figure]

0.43

5 V/div
200 μs/div

## Slide 14

0.43

5 V/div
200 μs/div

## Slide 15

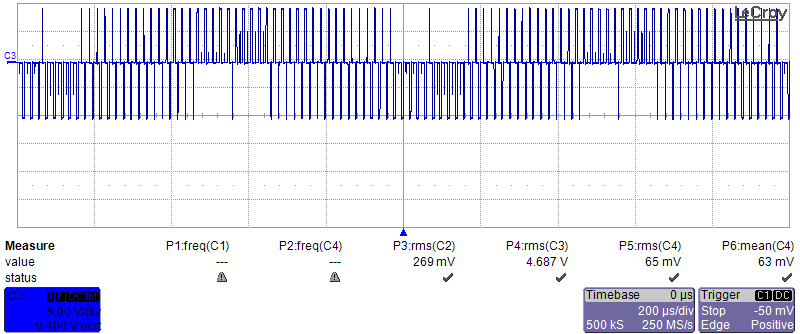
[picture p324: figure]

0.23

0.42

0.02

0.02

## Slide 16

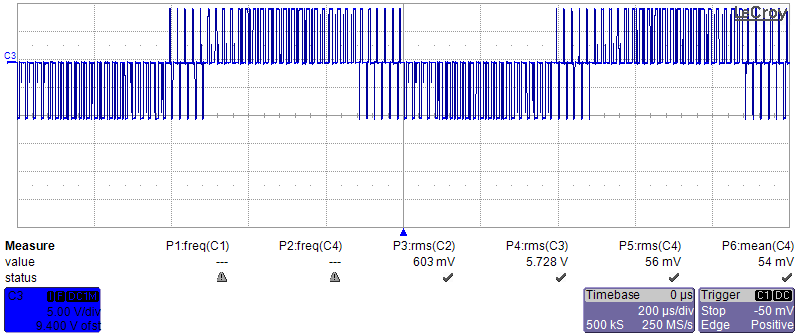
[picture p325: figure]

0.48

0.40

S0.10

0.10

## Slide 17

## Slide 18
