EnesAyaz/WPTMotor/Test-Result/2021.09.02/New Microsoft Excel Worksheet.xlsx

Vin=200V |  |  | RL=7.1 |  |  |  | Vin=200V |  |  | RL=10.2
ma | 0 | 0.2 | 0.4 | 0.6 | 0.8 | 1 | ma | 0 | 0.2 | 0.4 | 0.6 | 0.8 | 1
IphA | 0 | 0.875 | 1.53 | 2.3 | 3.13 | 3.95 | IphA | 0 | 0.88 | 1.5 | 2.13 | 2.81 | 3.55
Vout | 45 | 44.5 | 42.4 | 40.85 | 41.2 | 45.1 | Vout | 44.9 | 44.3 | 42.3 | 40.9 | 41.1 | 45.2
Iin | 0.44 | 0.54 | 0.74 | 1.1 | 1.66 | 2.43 | Iin | 0.44 | 0.54 | 0.77 | 1.18 | 1.8 | 2.65
Itx | 2.19 | 2.17 | 2.03 | 1.91 | 1.93 | 2.13 | Itx | 2.19 | 2.16 | 2.03 | 1.91 | 1.93 | 2.13
Vin=200V |  |  | RL=7.9 |  |  |  | Vin=200V |  |  | RL=14.4
ma | 0 | 0.2 | 0.4 | 0.6 | 0.8 | 1 | ma | 0 | 0.2 | 0.4 | 0.6 | 0.8 | 1
IphA | 0 | 0.93 | 1.59 | 2.27 | 3.02 | 3.85 | IphA | 0 | 0.81 | 1.53 | 1.89 | 2.45 | 3.07
Vout | 45 | 44.5 | 42.4 | 40.9 | 41.1 | 45.2 | Vout | 45.1 | 44.2 | 42.3 | 40.7 | 41 | 45.1
Iin | 0.44 | 0.54 | 0.75 | 1.15 | 1.71 | 2.51 | Iin | 0.44 | 0.55 | 0.78 | 1.2 | 1.82 | 2.7
Itx | 2.19 | 2.17 | 2.03 | 1.91 | 1.93 | 2.14 | Itx | 2.2 | 2.15 | 2.02 | 1.91 | 1.93 | 2.13
Vin=200V |  |  | RL=8.9
ma | 0 | 0.2 | 0.4 | 0.6 | 0.8 | 1
IphA | 0 | 0.91 | 1.55 | 2.2 | 2.92 | 3.72
Vout | 45 | 44.5 | 42.4 | 40.8 | 41 | 45.2
Iin | 0.44 | 0.54 | 0.76 | 1.16 | 1.75 | 2.6
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
