EnesAyaz/WPTMotor/Journal-DC-Motor/v5.0/Experimental Result/WPT-motor.pptx

V_(RX)


V_(RX) =20.8 A_(RMS)

V_O

V_o =200 V_(pp)

D=0.85

I_(TX)

I_(TX) =1.77 A_(rms)

f=81.3 kHz

## Slide 2


I_M

V_O

I_M =6.85 A_(rms)

V_o =200 V_(pp)

D=0.85

f=81.3 kHz

## Slide 3


V_(RX)

V_(RX) =20.7 A_(RMS)

I_M =6.82 A

V_O

I_M

V_o =200 V_(pp)

D=0.85

I_(TX)

I_(TX) =1.74 A_(Rms)

f=81.3 kHz

## Slide 4

V_(RX)

V_O

D

I_(TX)

V_(RX) =20.8 A_(RMS)

V_o =200 V_(pp)

D=0.85

I_(TX) =1.77 A_(Rms)

f=81.3 kHz

## Slide 5

I_M

V_O

D

I_M =6.82 A

V_o =200 V_(pp)

D=0.85

f=81.3 kHz

## Slide 6

V_(RX)

V_O

I_M

D

I_(TX)

D=0.85

I_(TX) =1.74 A_(Rms)

f=81.3 kHz

V_(RX) =20.7 A_(RMS)

I_M =6.82 A

V_o =200 V_(pp)

## Slide 7

## Slide 8

## Slide 9
