EnesAyaz/WPTMotor/Synhronous motor/TPEL-major-revision/Figures/Experiment/2023.02.03/testB14.png

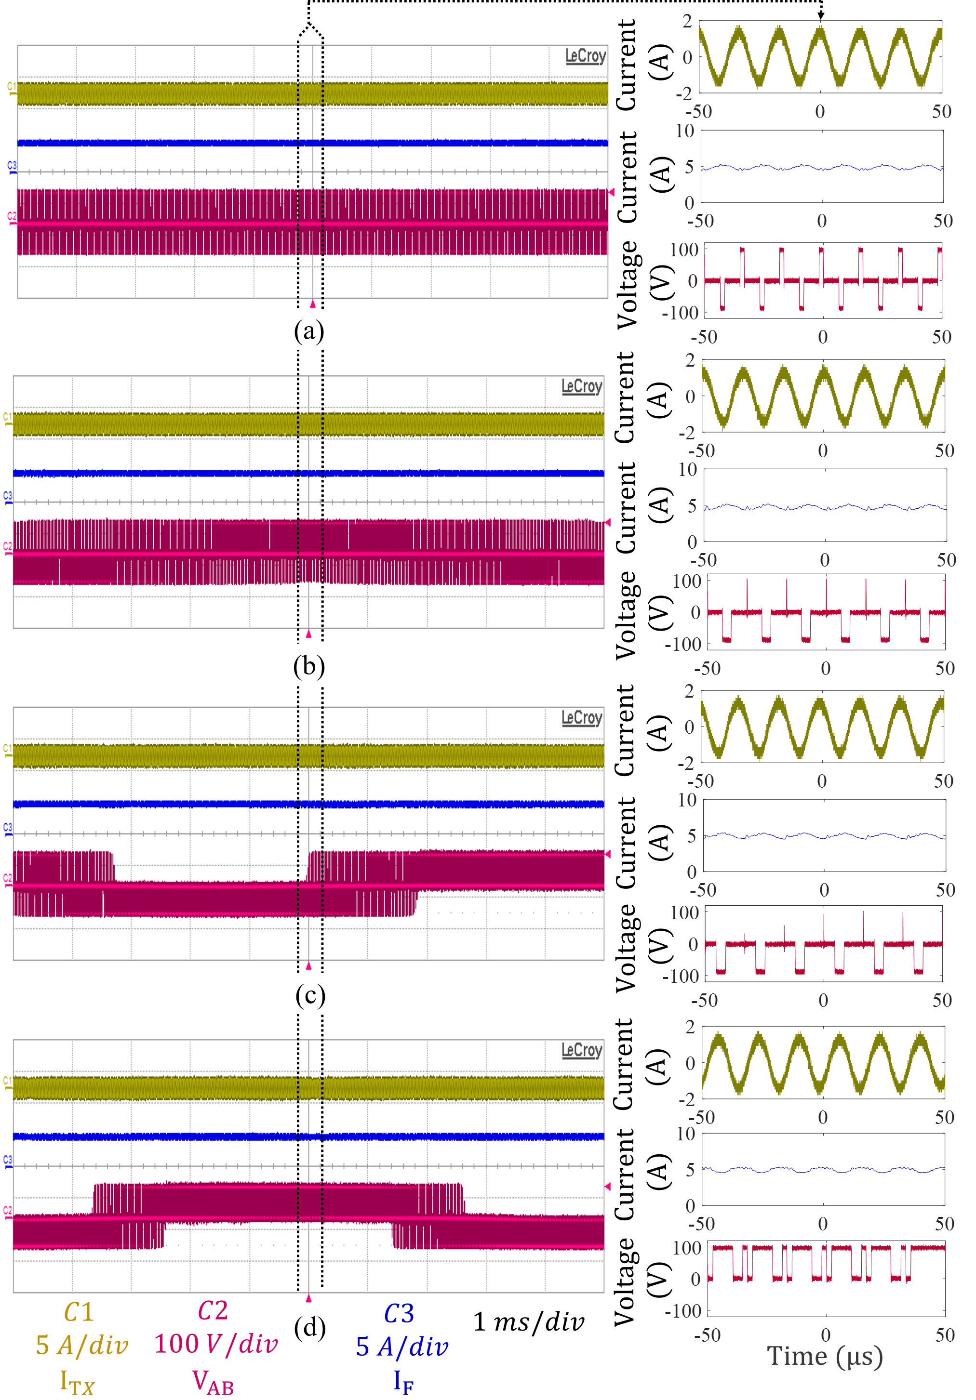
Synhronous motor/TPEL-major-revision/Figures/Experiment/2023.02.03/testB14.png
