EnesAyaz/WPTMotor/Synhronous motor/TPEL-major-revision/Figures/Experiment/2023.05.01/dynamic_control.png

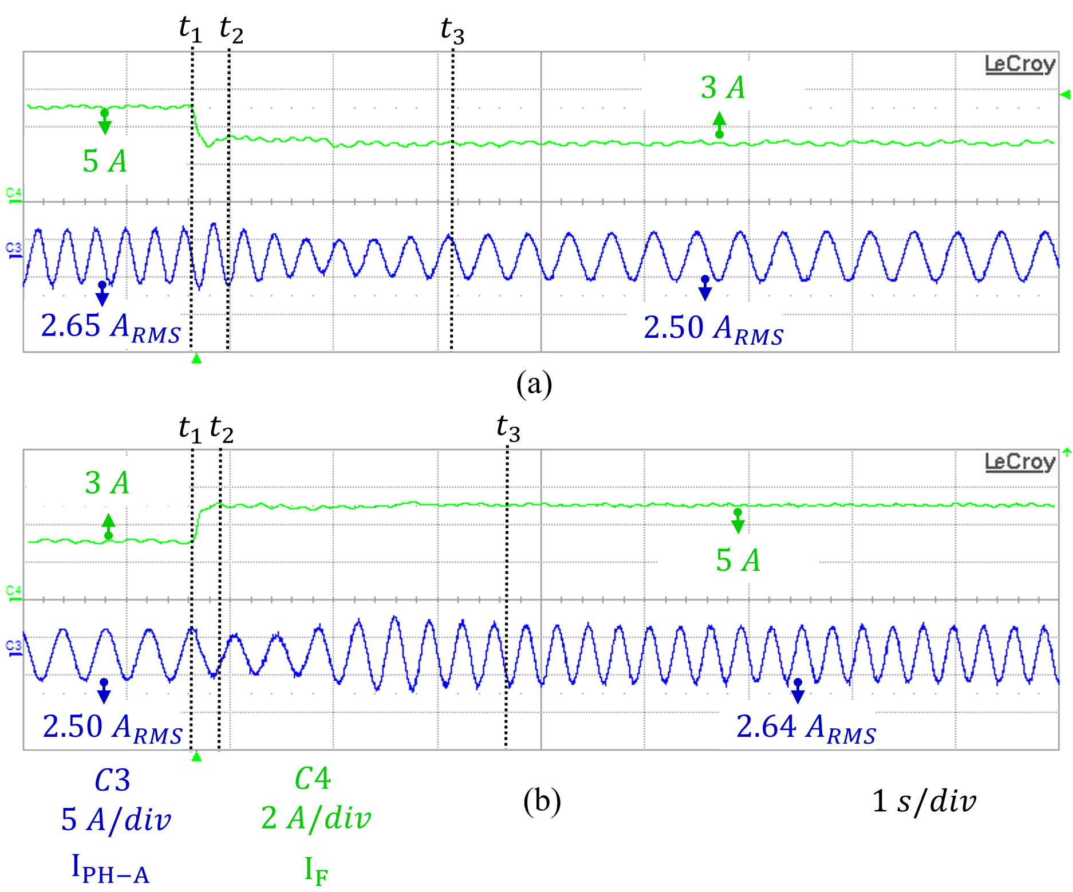
Synhronous motor/TPEL-major-revision/Figures/Experiment/2023.05.01/dynamic_control.png
