EnesAyaz/WPTMotor/Synhronous motor/TPEL-major-revision/Figures/Experiment/2023.05.01/Stator_Current_Effect.png

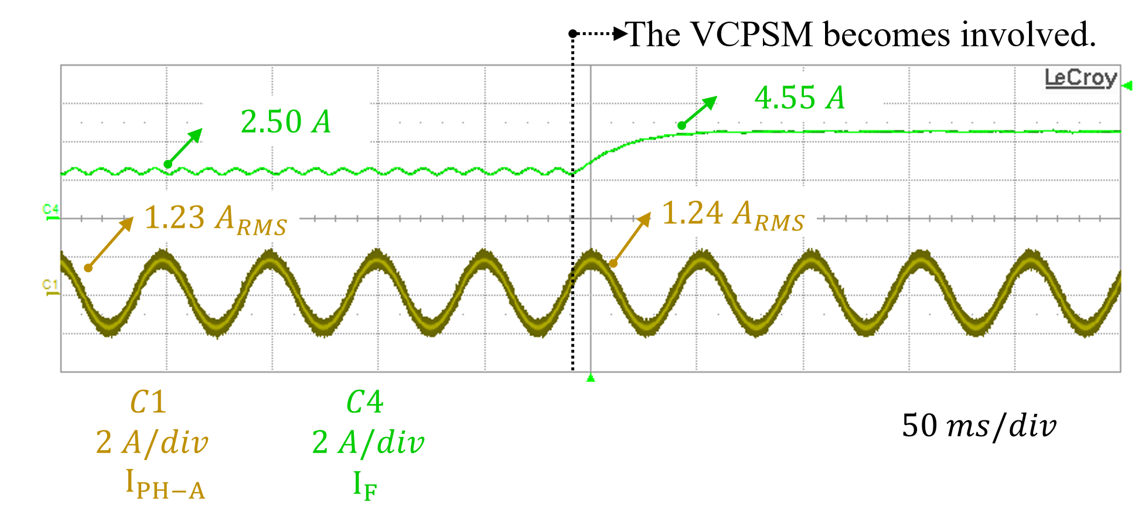
Synhronous motor/TPEL-major-revision/Figures/Experiment/2023.05.01/Stator_Current_Effect.png
