EnesAyaz/WPTMotor/Synhronous motor/TPEL-major-revision/Figures/Experiment/experiment_VCPSM.png

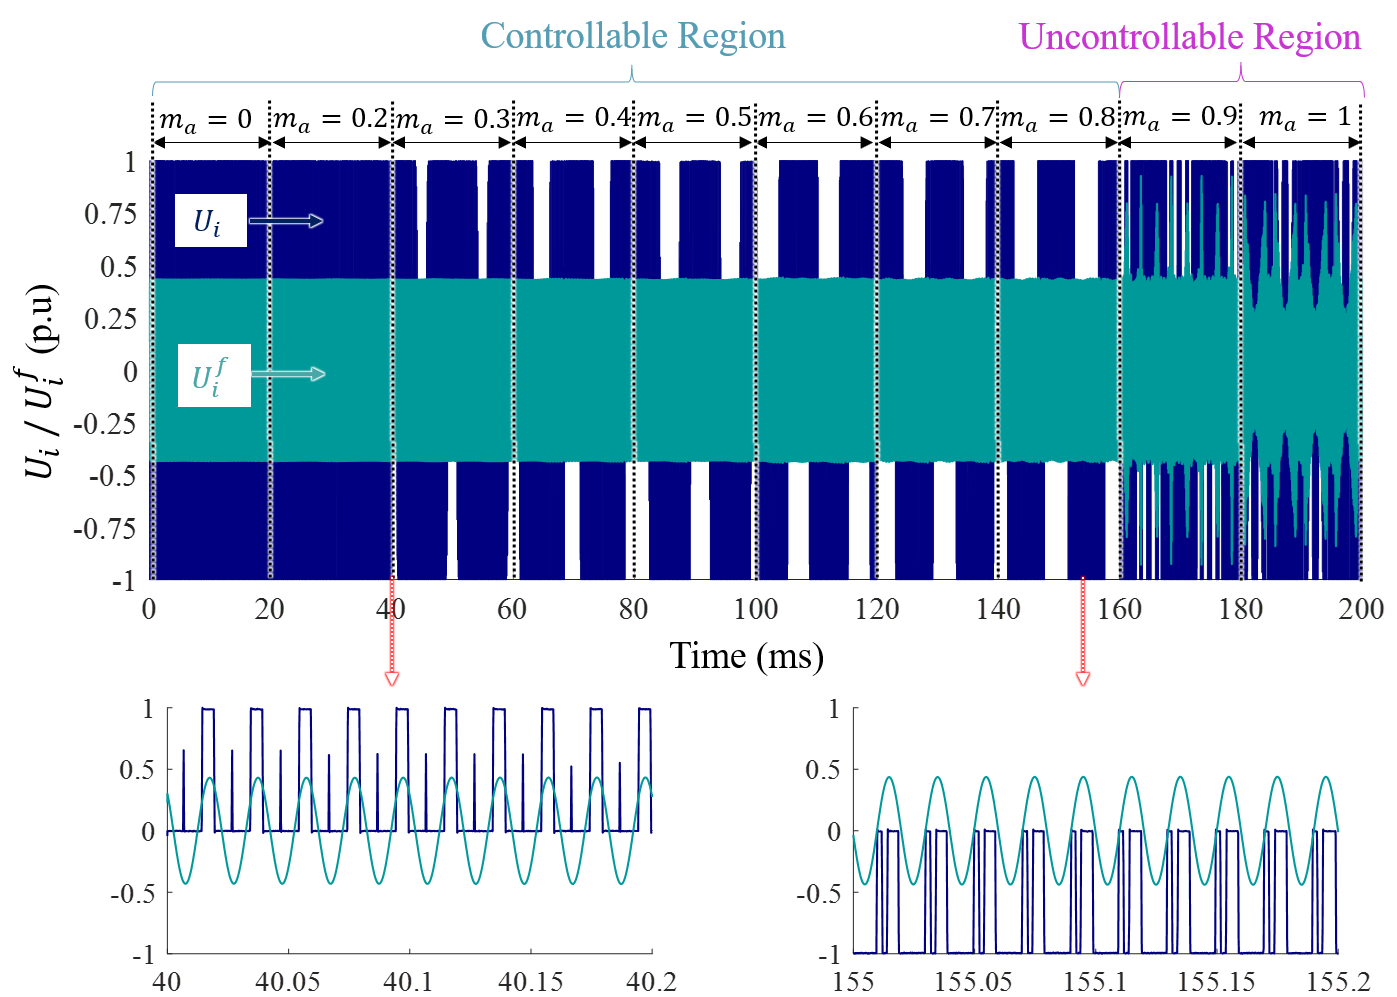
Synhronous motor/TPEL-major-revision/Figures/Experiment/experiment_VCPSM.png
