EnesAyaz/WPTMotor/Synhronous motor/TPEL-major-revision/Figures/Experiment/experiment_VCPSM_v2.png

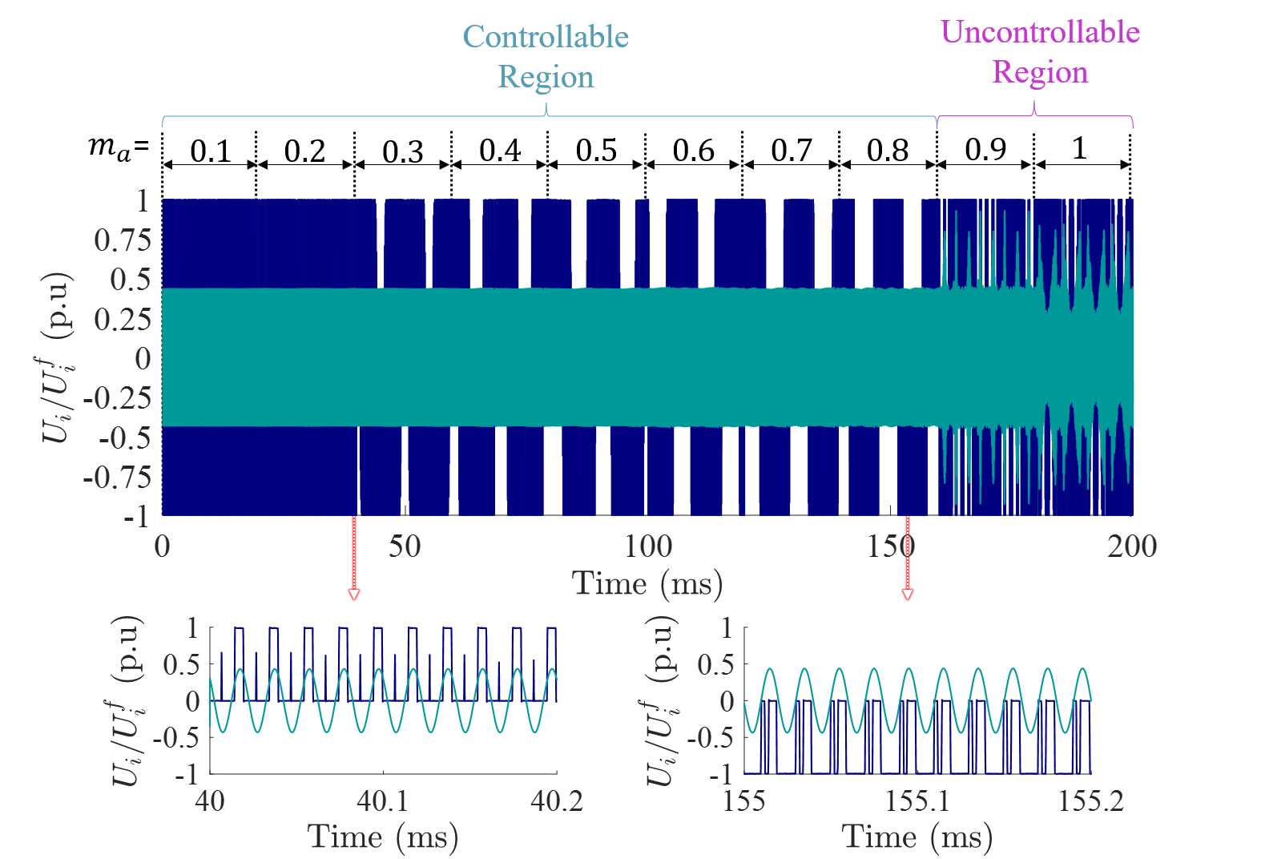
Synhronous motor/TPEL-major-revision/Figures/Experiment/experiment_VCPSM_v2.png
