EnesAyaz/WPTMotor/Test-Result/2021.02.18/1.png

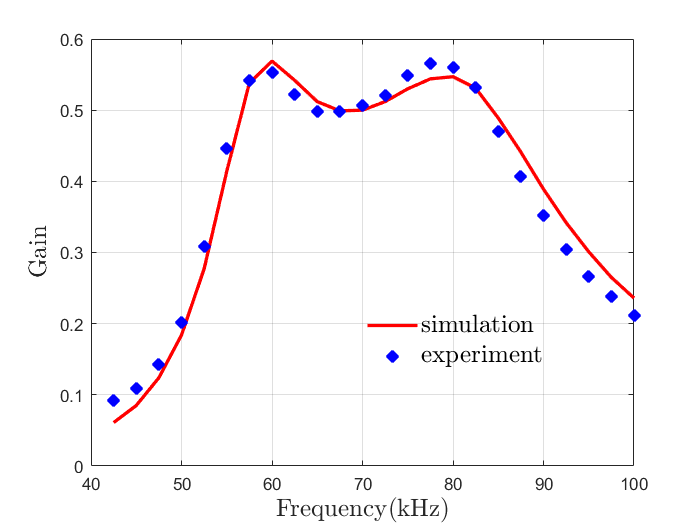
Test-Result/2021.02.18/1.png
