EnesAyaz/WPTMotor/Test-Result/2021.02.18/2.png

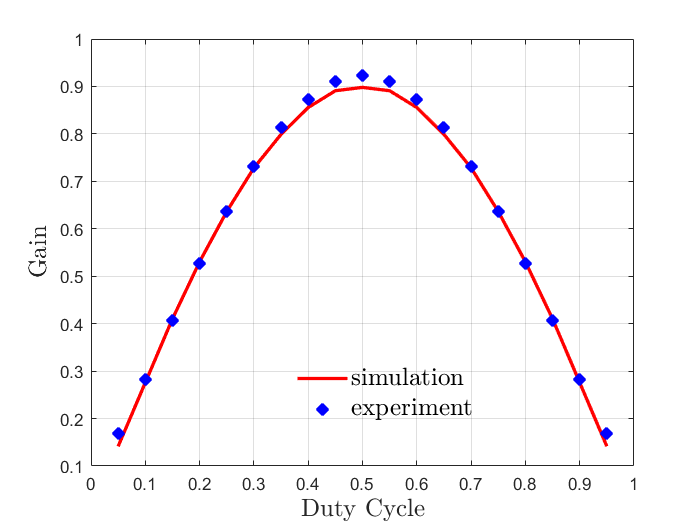
Test-Result/2021.02.18/2.png
