EnesAyaz/WPTMotor/Test-Result/2021.02.25/caseA.png

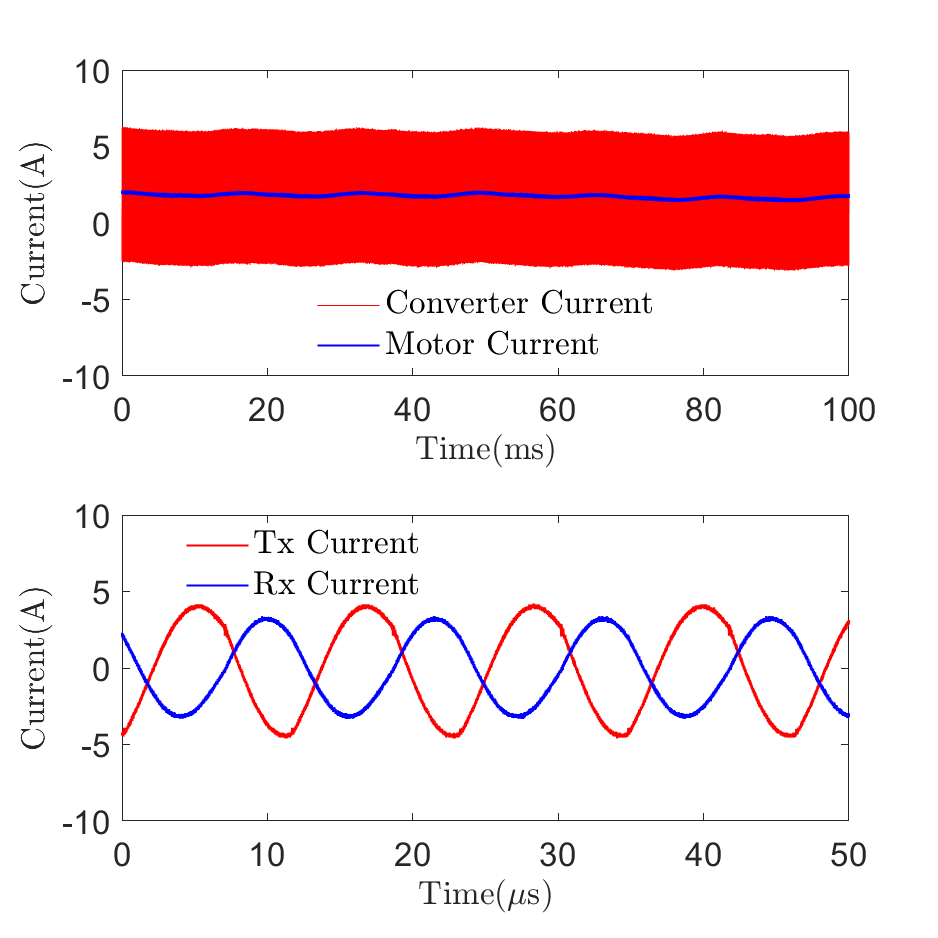
Test-Result/2021.02.25/caseA.png
