EnesAyaz/WPTMotor/Test-Result/2021.02.25/caseB.png

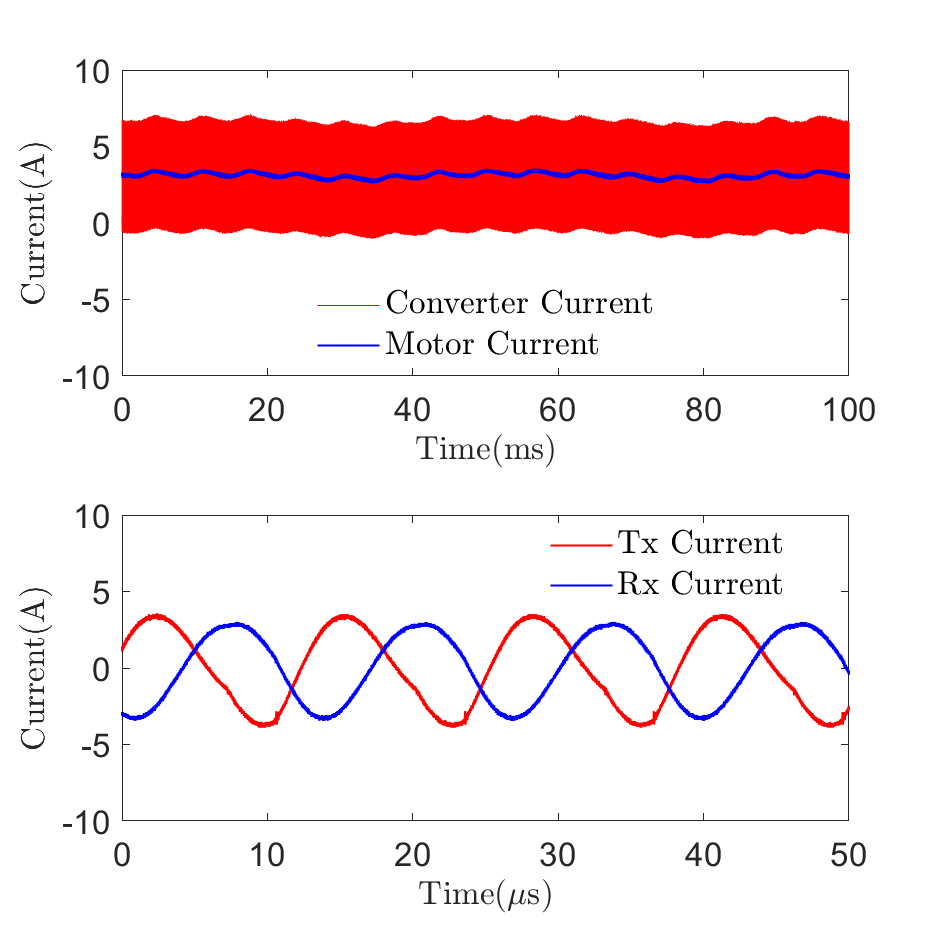
Test-Result/2021.02.25/caseB.png
