EnesAyaz/WPTMotor/Test-Result/2021.02.25/caseC.png

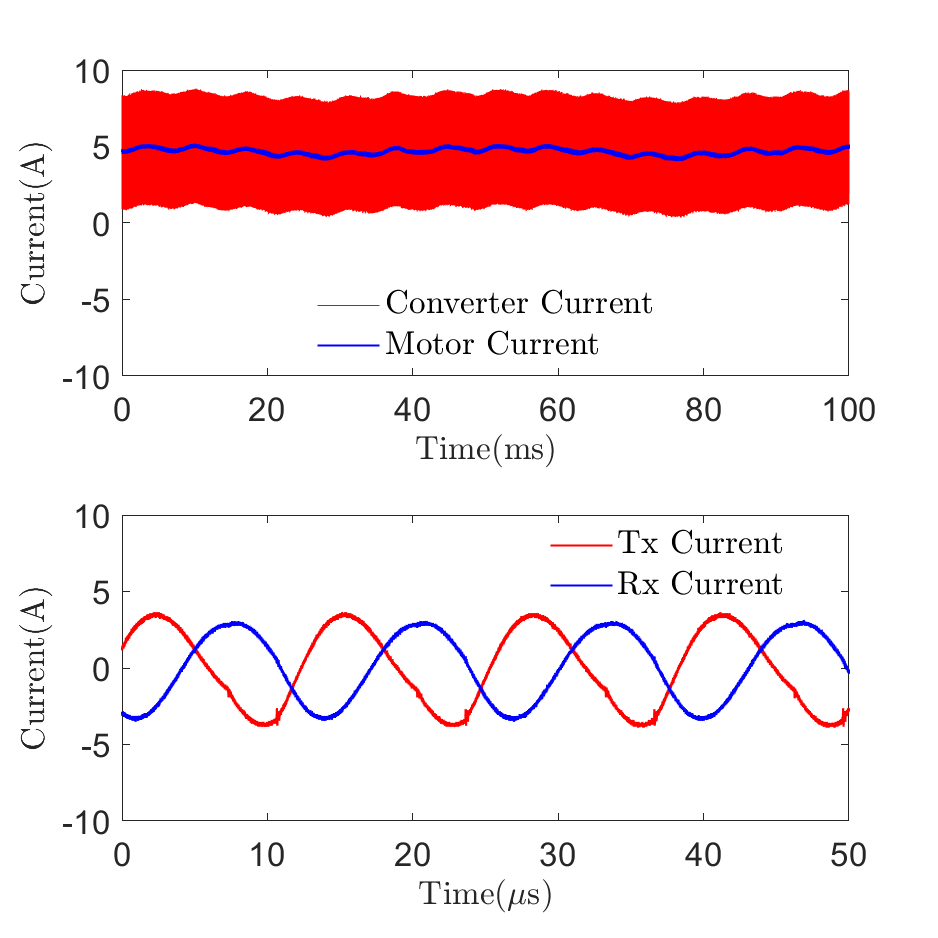
Test-Result/2021.02.25/caseC.png
