EnesAyaz/WPTMotor/Test-Result/2021.02.25/caseD.png

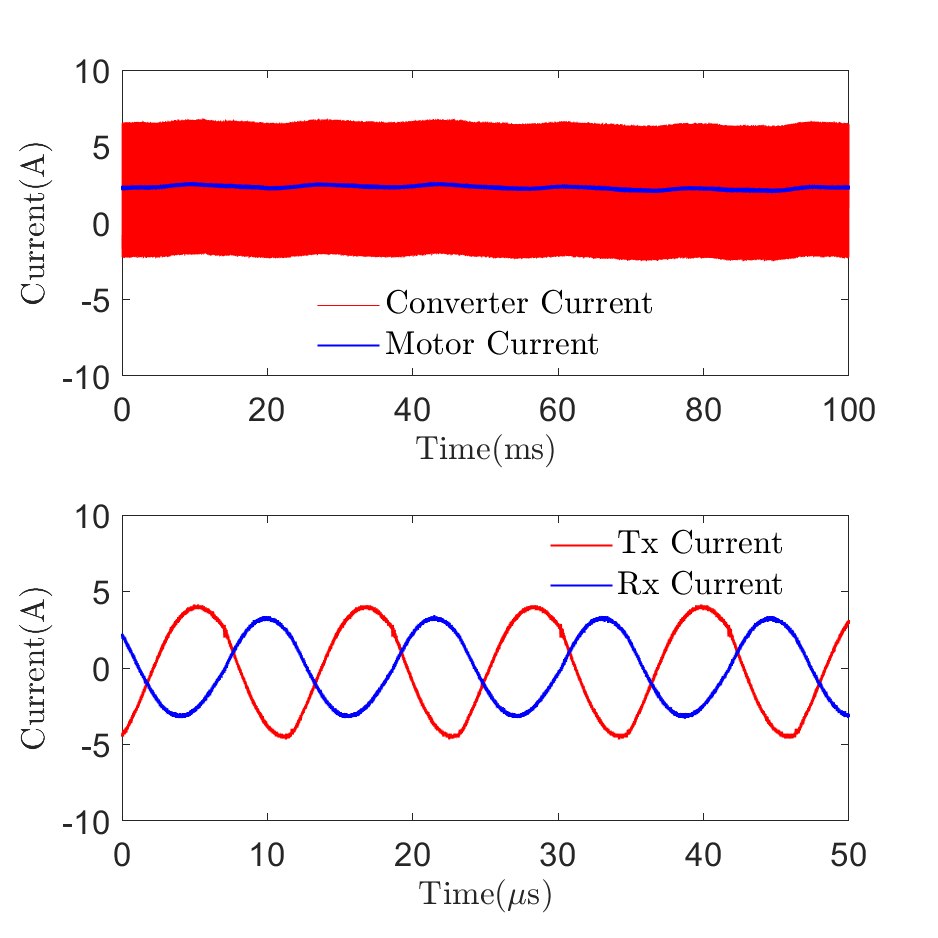
Test-Result/2021.02.25/caseD.png
