EnesAyaz/WPTMotor/Test-Result/2021.02.25/caseE.png

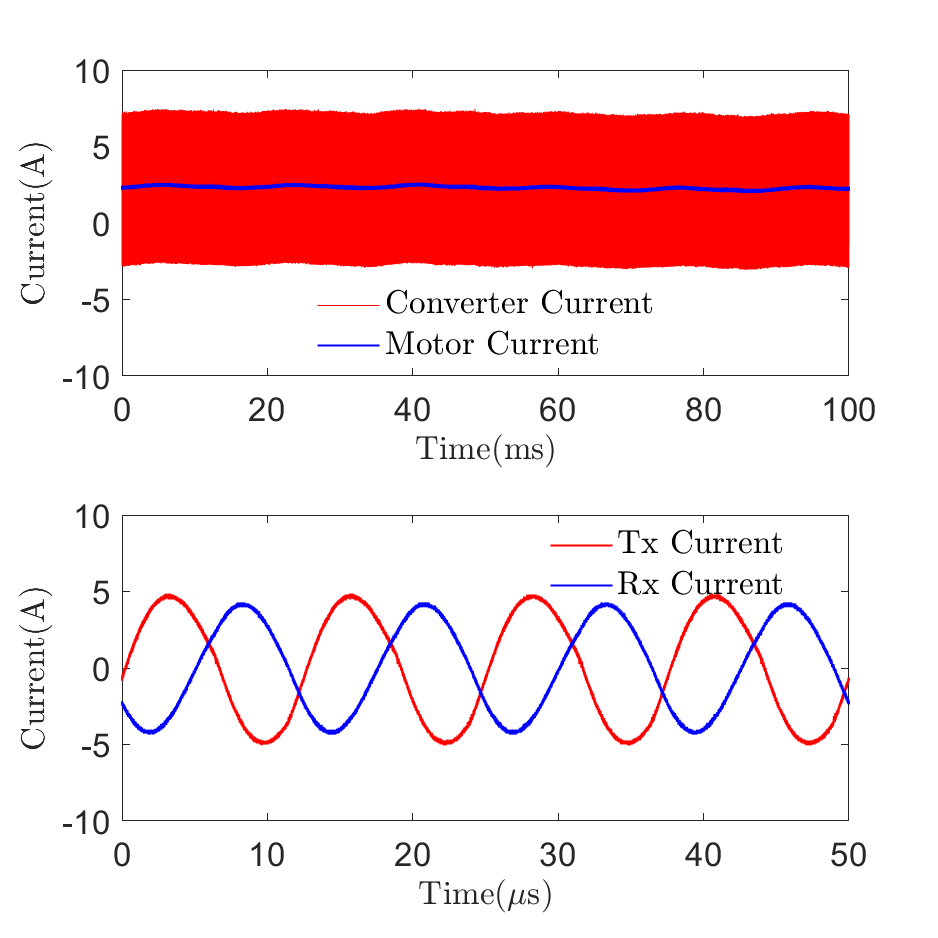
Test-Result/2021.02.25/caseE.png
