EnesAyaz/WPTMotor/Test-Result/2021.02.25/caseF.png

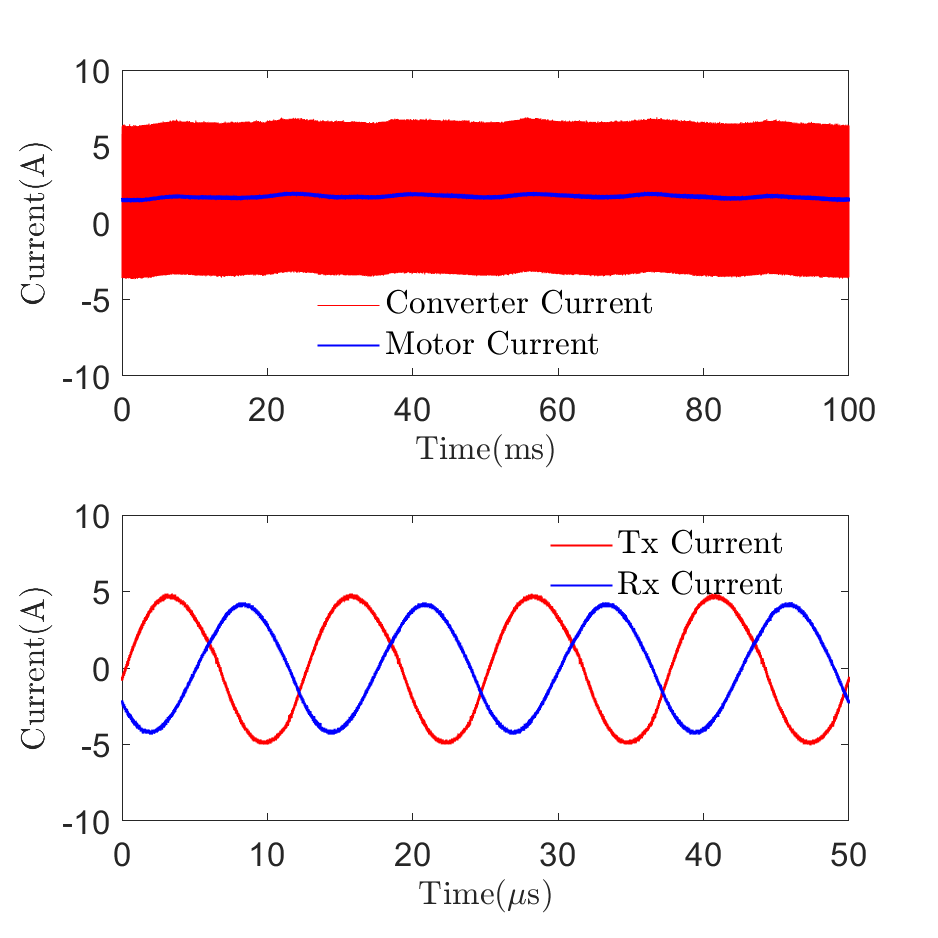
Test-Result/2021.02.25/caseF.png
