EnesAyaz/WPTMotor/Test-Result/2021.02.25/eski-case/caseA.png

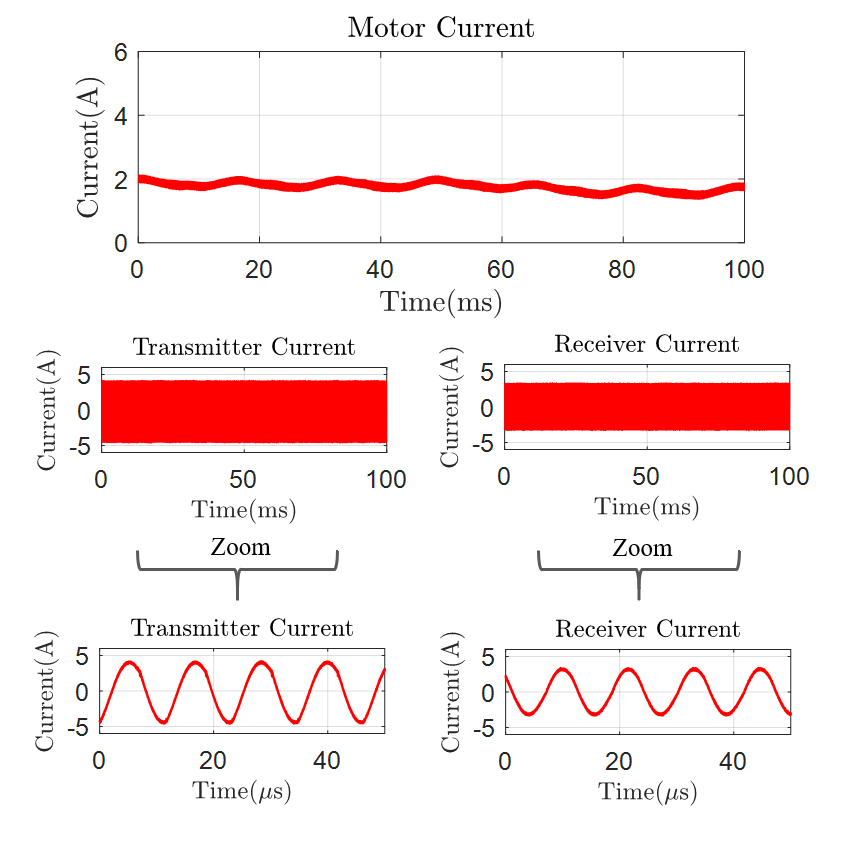
Test-Result/2021.02.25/eski-case/caseA.png
