EnesAyaz/WPTMotor/Test-Result/2021.02.25/eski-case/caseC.png

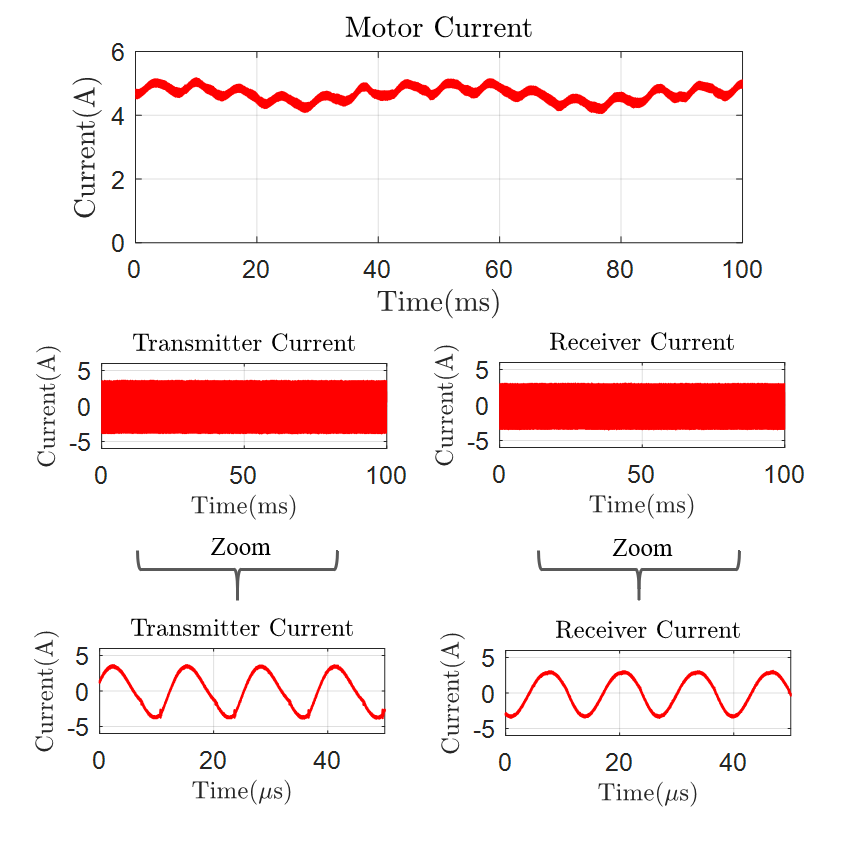
Test-Result/2021.02.25/eski-case/caseC.png
