EnesAyaz/WPTMotor/Test-Result/2021.02.25/Flow-Chart.png

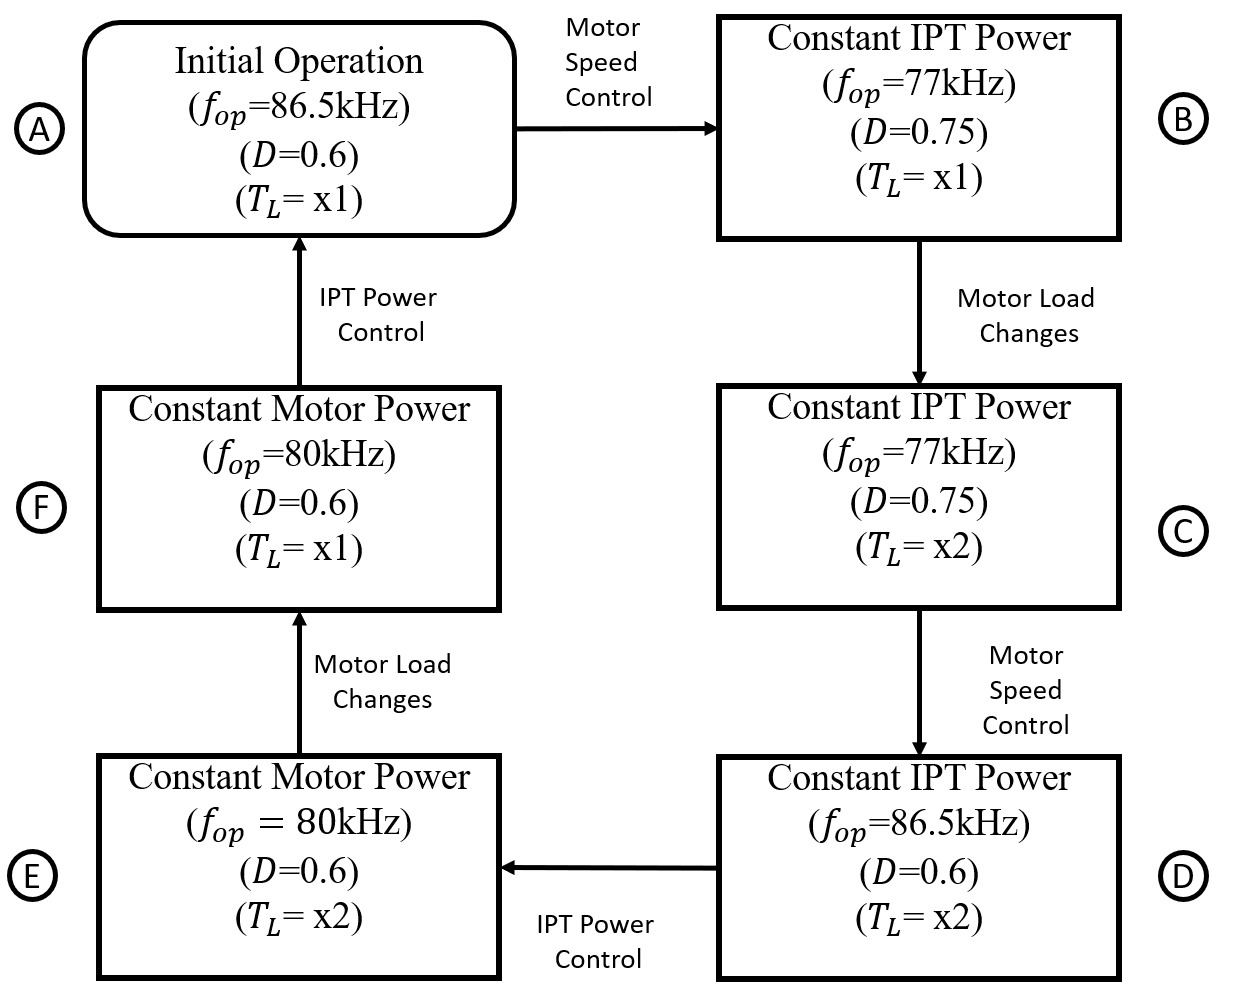
Test-Result/2021.02.25/Flow-Chart.png
