EnesAyaz/WPTMotor/Test-Result/2021.04.15/onlymotor.png

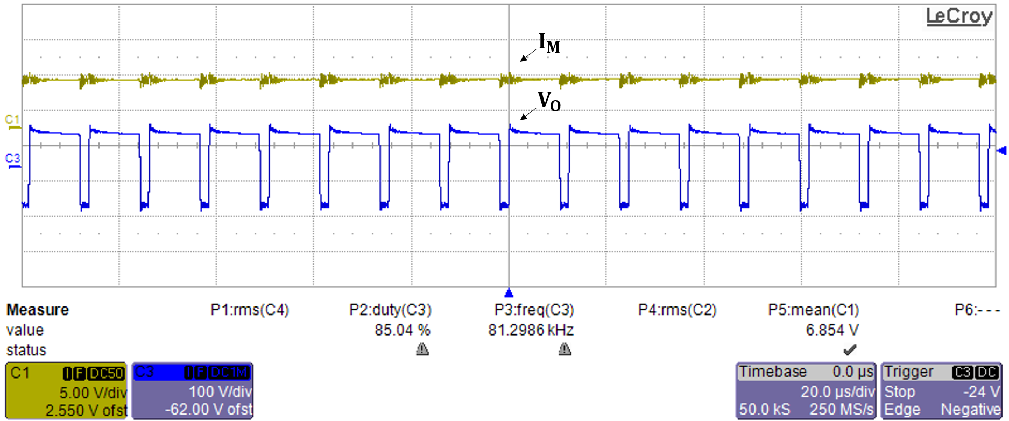
Test-Result/2021.04.15/onlymotor.png
