EnesAyaz/WPTMotor/Test-Result/2021.04.15/onlyWPT.png

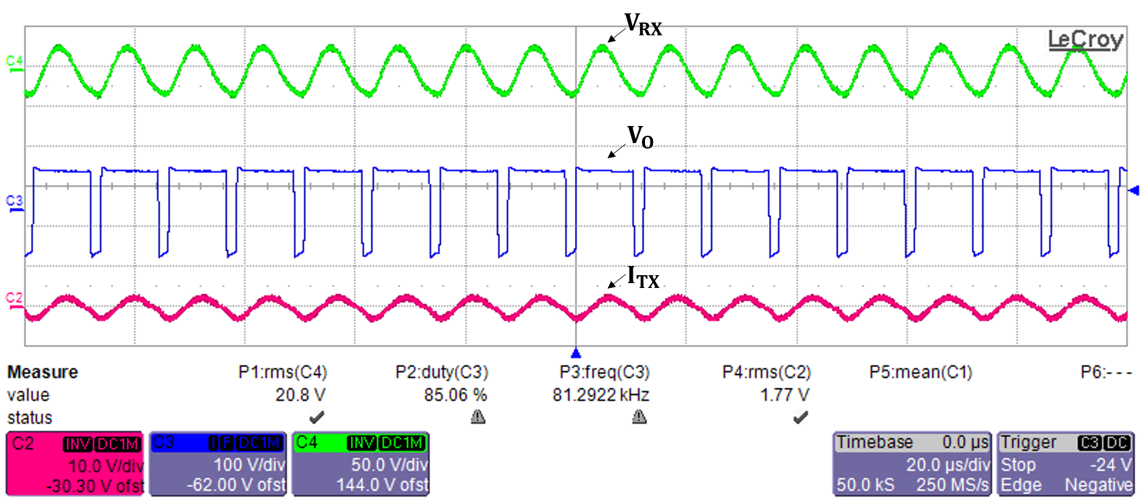
Test-Result/2021.04.15/onlyWPT.png
