EnesAyaz/WPTMotor/Test-Result/2021.04.15/WPT-motor.png

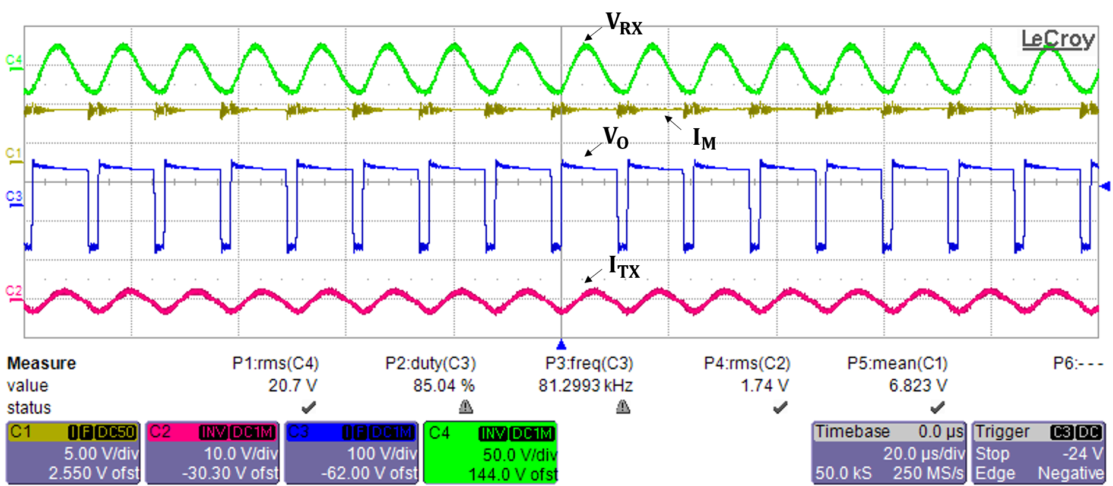
Test-Result/2021.04.15/WPT-motor.png
