EnesAyaz/WPTMotor/Test-Result/2021.11.29/Figures/VCPS_control.png

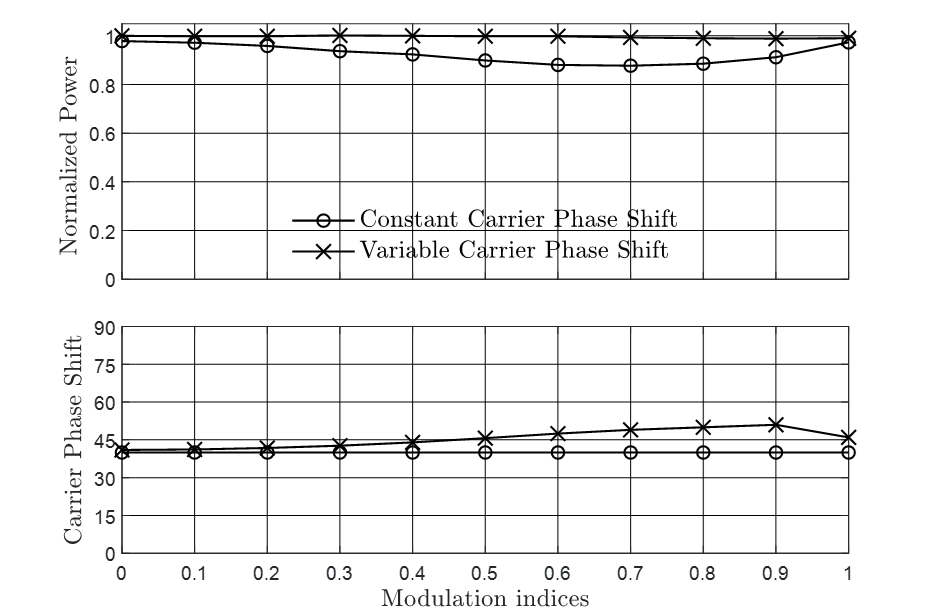
Test-Result/2021.11.29/Figures/VCPS_control.png
