EnesAyaz/WPTMotor/Test-Result/2021.12.01/Figures/carrier-phase-shift.png

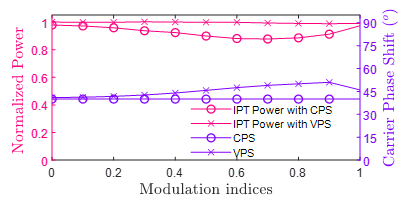
Test-Result/2021.12.01/Figures/carrier-phase-shift.png
