EnesAyaz/WPTMotor/Test-Result/2021.12.01/Figures/m0.6phase0.png

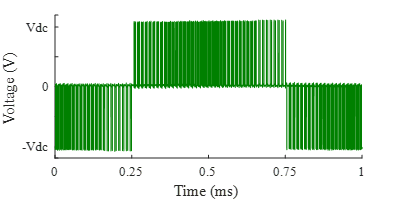
Test-Result/2021.12.01/Figures/m0.6phase0.png
