EnesAyaz/WPTMotor/Test-Result/2021.12.01/Figures/motor_transients_v2.png

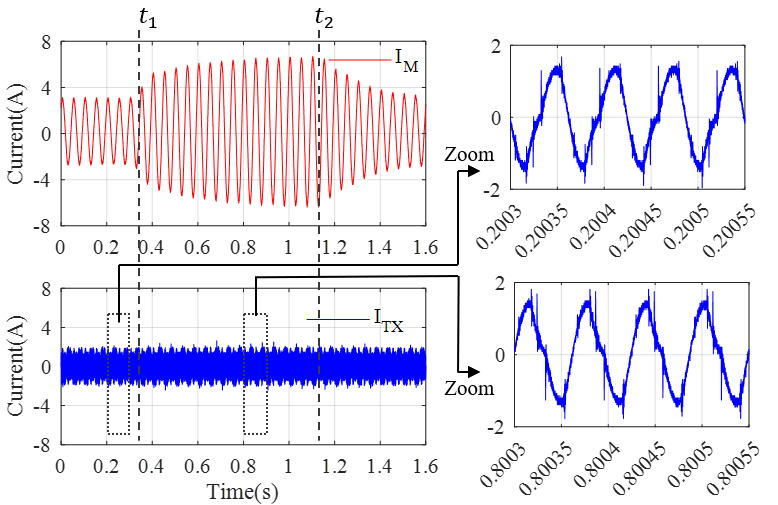
Test-Result/2021.12.01/Figures/motor_transients_v2.png
