EnesAyaz/WPTMotor/Test-Result/2021.12.01/Figures/simultaneous.png

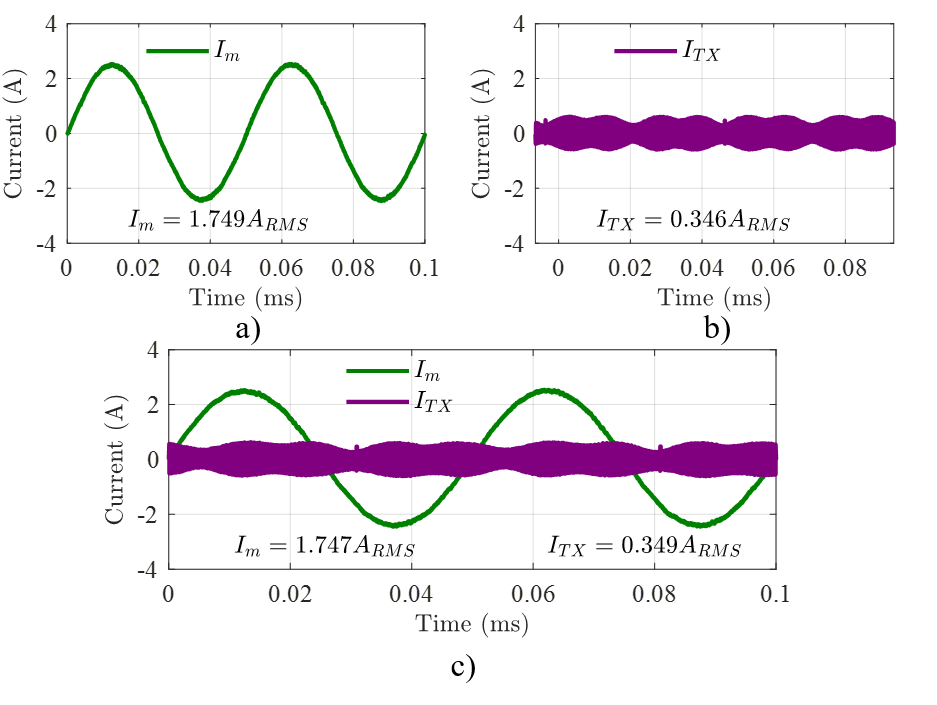
Test-Result/2021.12.01/Figures/simultaneous.png
