EnesAyaz/WPTMotor/Test-Result/2021.12.01/Figures/simultaneous_v3.png

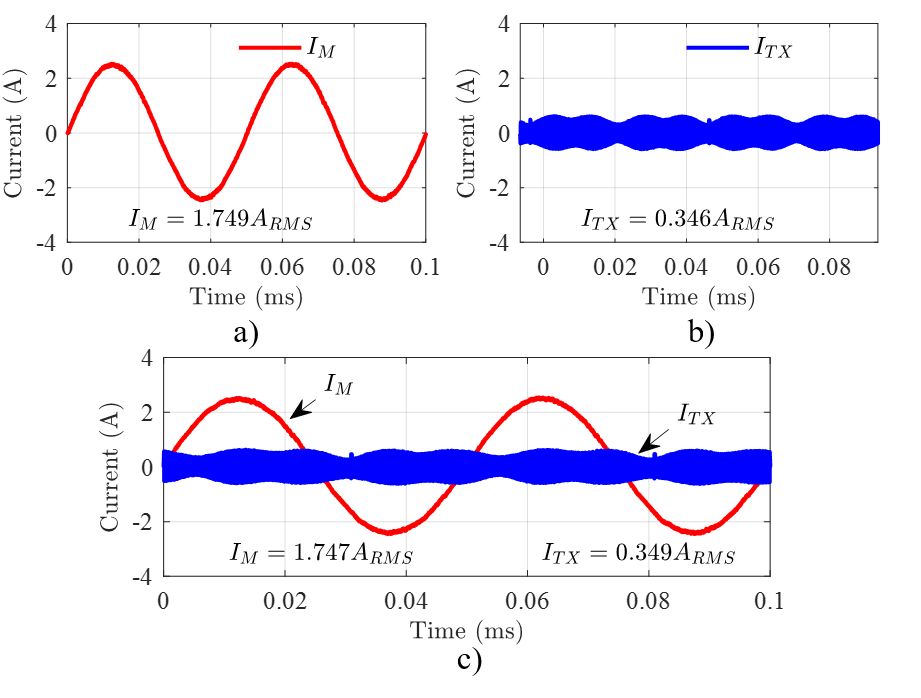
Test-Result/2021.12.01/Figures/simultaneous_v3.png
