EnesAyaz/WPTMotor/Test-Result/2021.12.01/Figures/WPT_transients.png

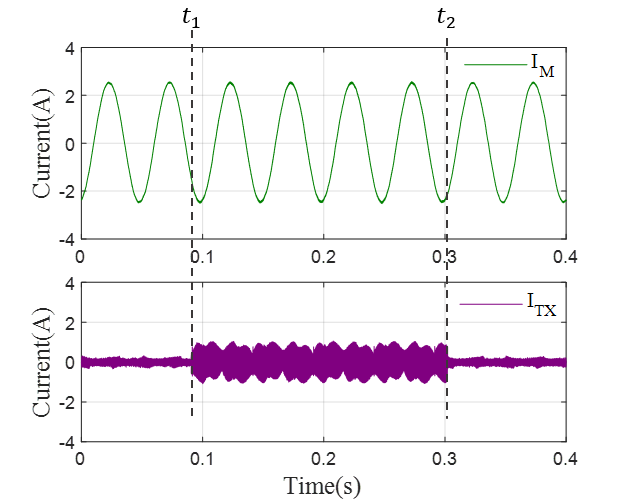
Test-Result/2021.12.01/Figures/WPT_transients.png
