EnesAyaz/WPTMotor/Thesis/Experimental/Frequency_carrier_phase_shift/constant_CPS.png

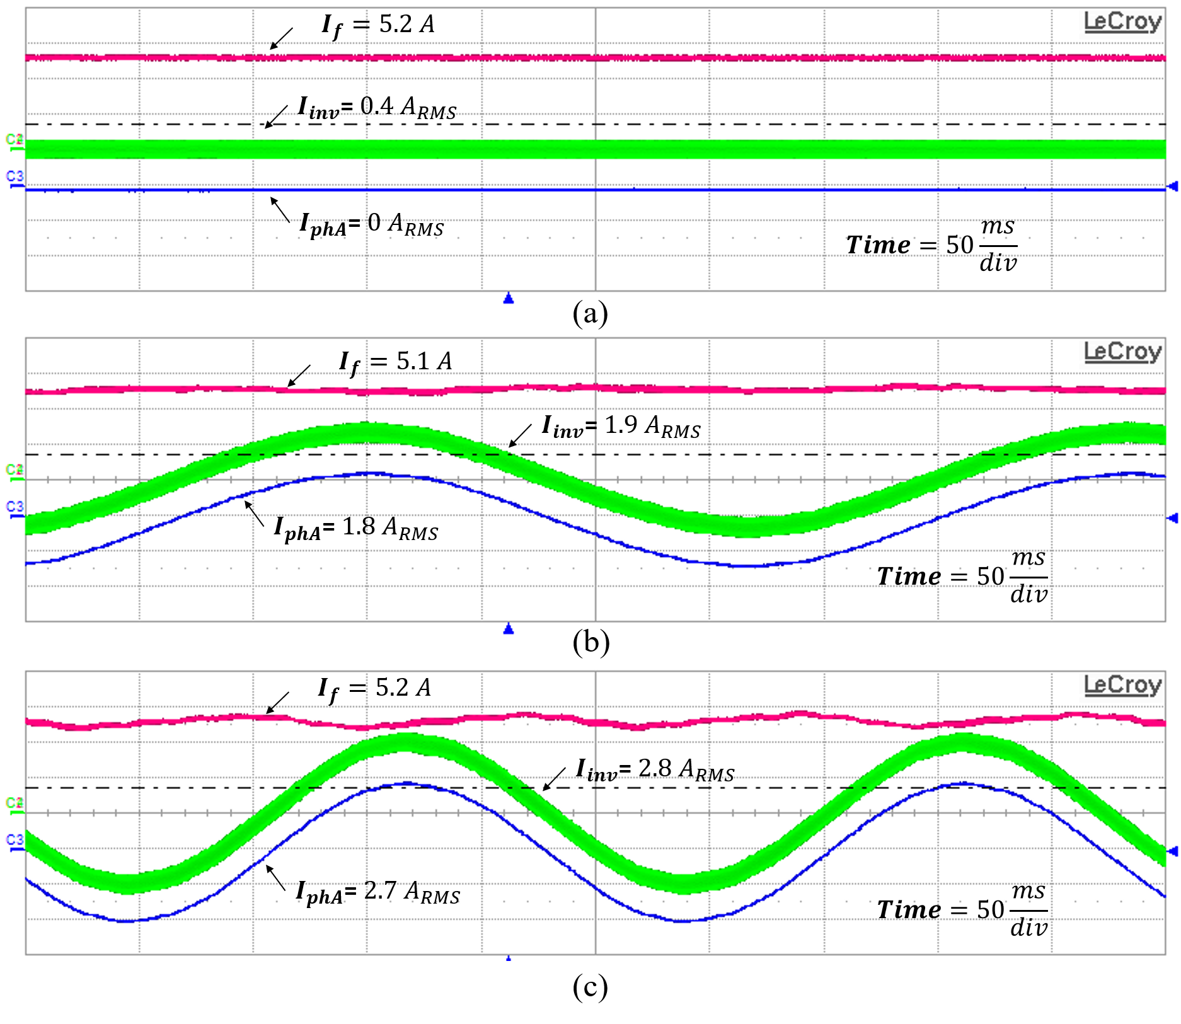
Thesis/Experimental/Frequency_carrier_phase_shift/constant_CPS.png
