EnesAyaz/WPTMotor/Thesis/Experimental/Frequency_carrier_phase_shift/constant_CPS_transient.png

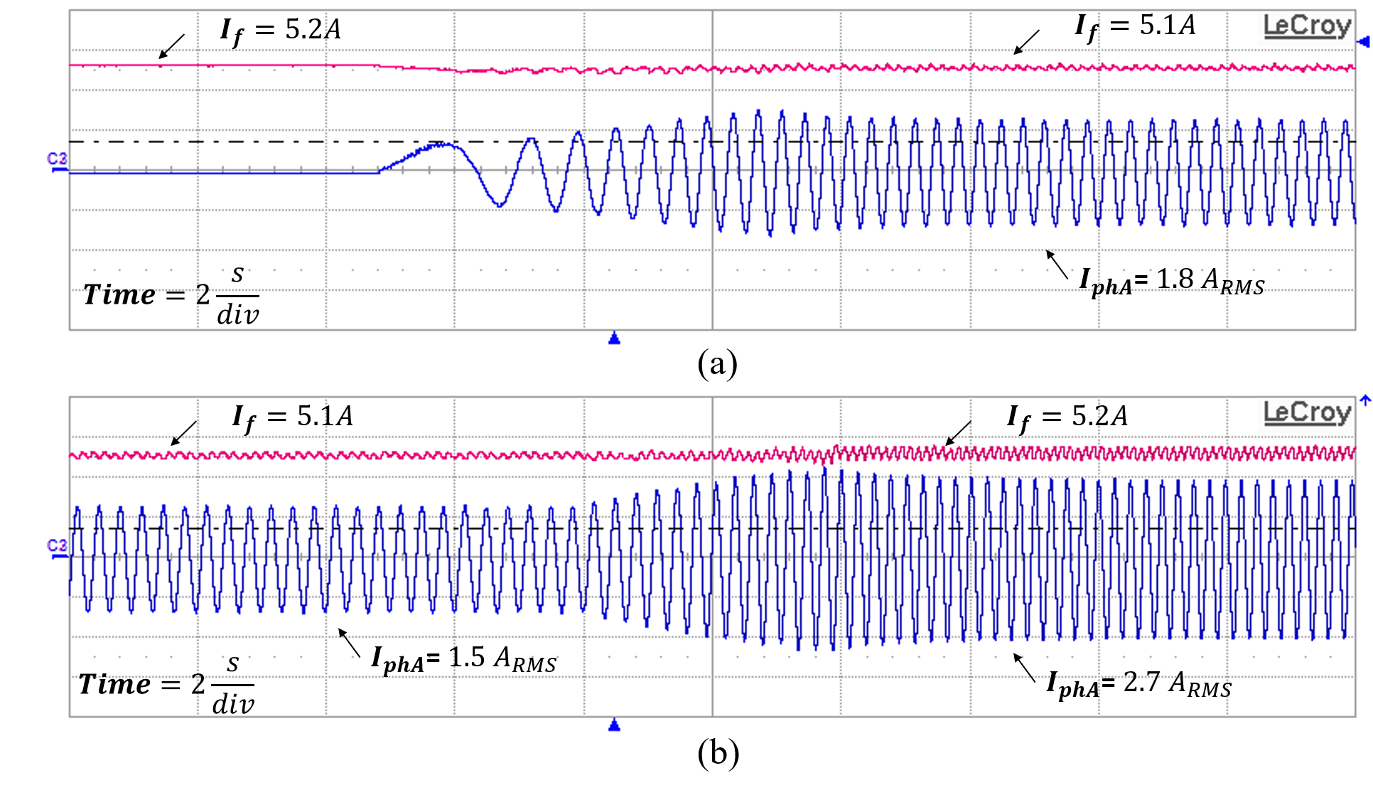
Thesis/Experimental/Frequency_carrier_phase_shift/constant_CPS_transient.png
