EnesAyaz/WPTMotor/Thesis/Experimental/Frequency_carrier_phase_shift/Fluctuation_constant_carrier_phase_shift.png

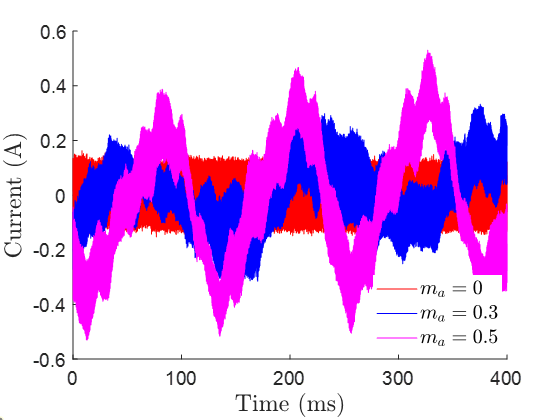
Thesis/Experimental/Frequency_carrier_phase_shift/Fluctuation_constant_carrier_phase_shift.png
