EnesAyaz/WPTMotor/Thesis/Experimental/Frequency_carrier_phase_shift/variable_CPS.png

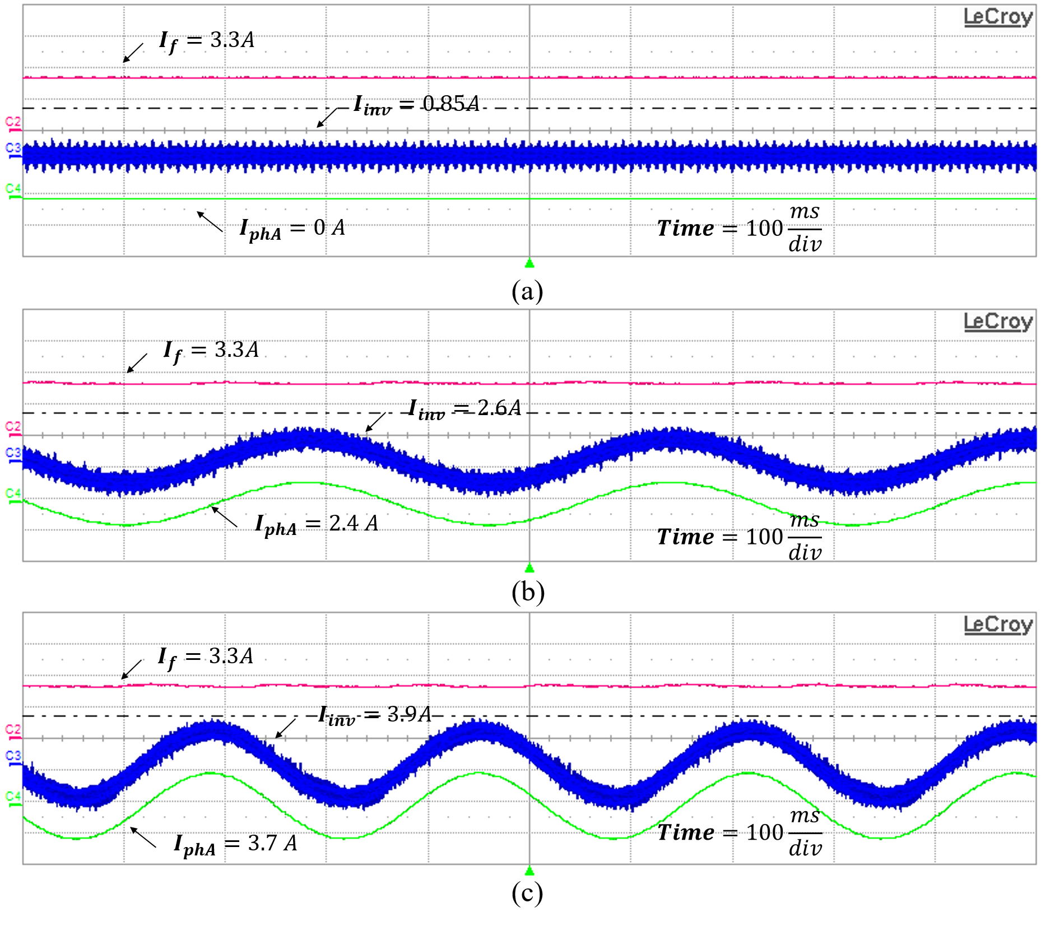
Thesis/Experimental/Frequency_carrier_phase_shift/variable_CPS.png
