EnesAyaz/WPTMotor/Thesis/Visio/chapter5a/experimental_SM.png

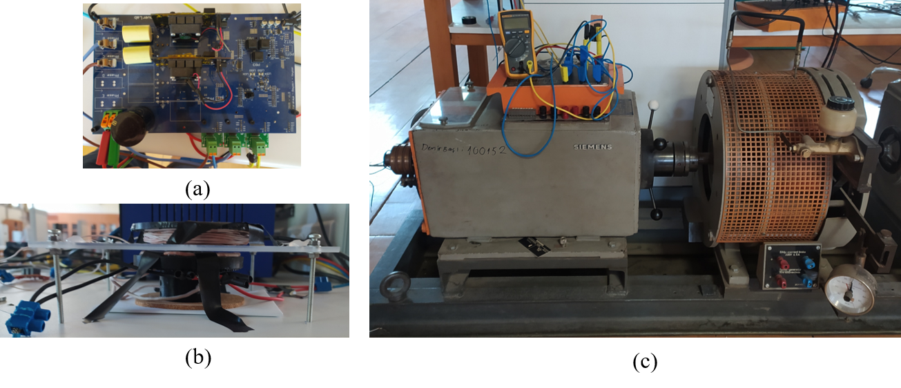
Thesis/Visio/chapter5a/experimental_SM.png
