EnesAyaz/WPTMotor/BLDC-whatever/Journal-Image/Journal Images.pptx

D:\Github\WPTMotor\Journal-3-phase\System Proposal\system_proposal_3VSC

## Slide 2

Key waveforms

D:\Github\WPTMotor\BLDC-whatever\time_domain.m

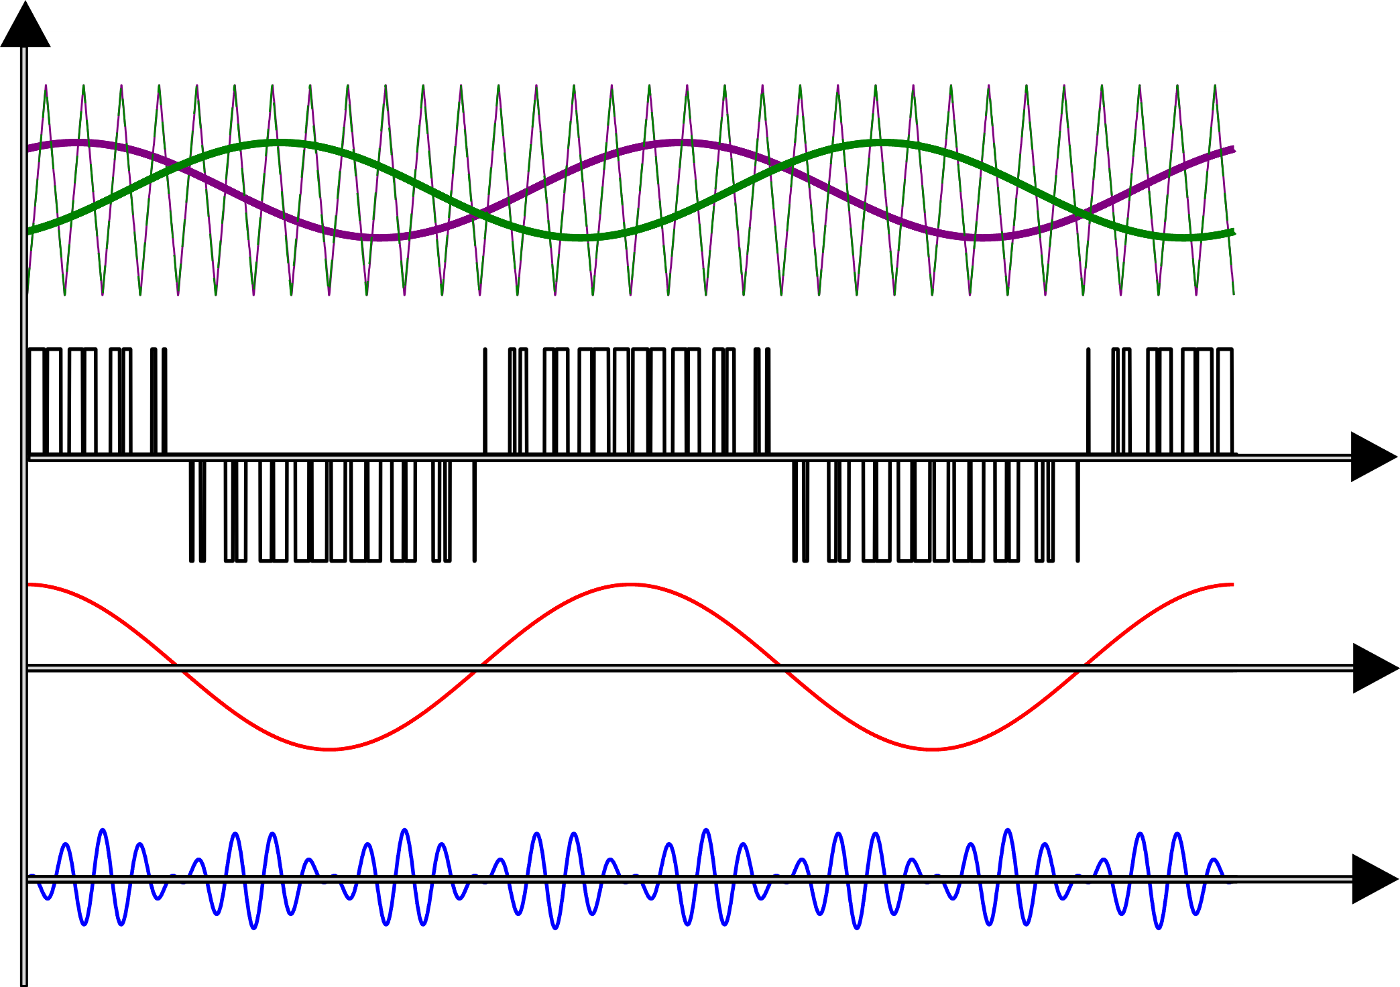
[picture p377: figure]

w/o carrier phase shift

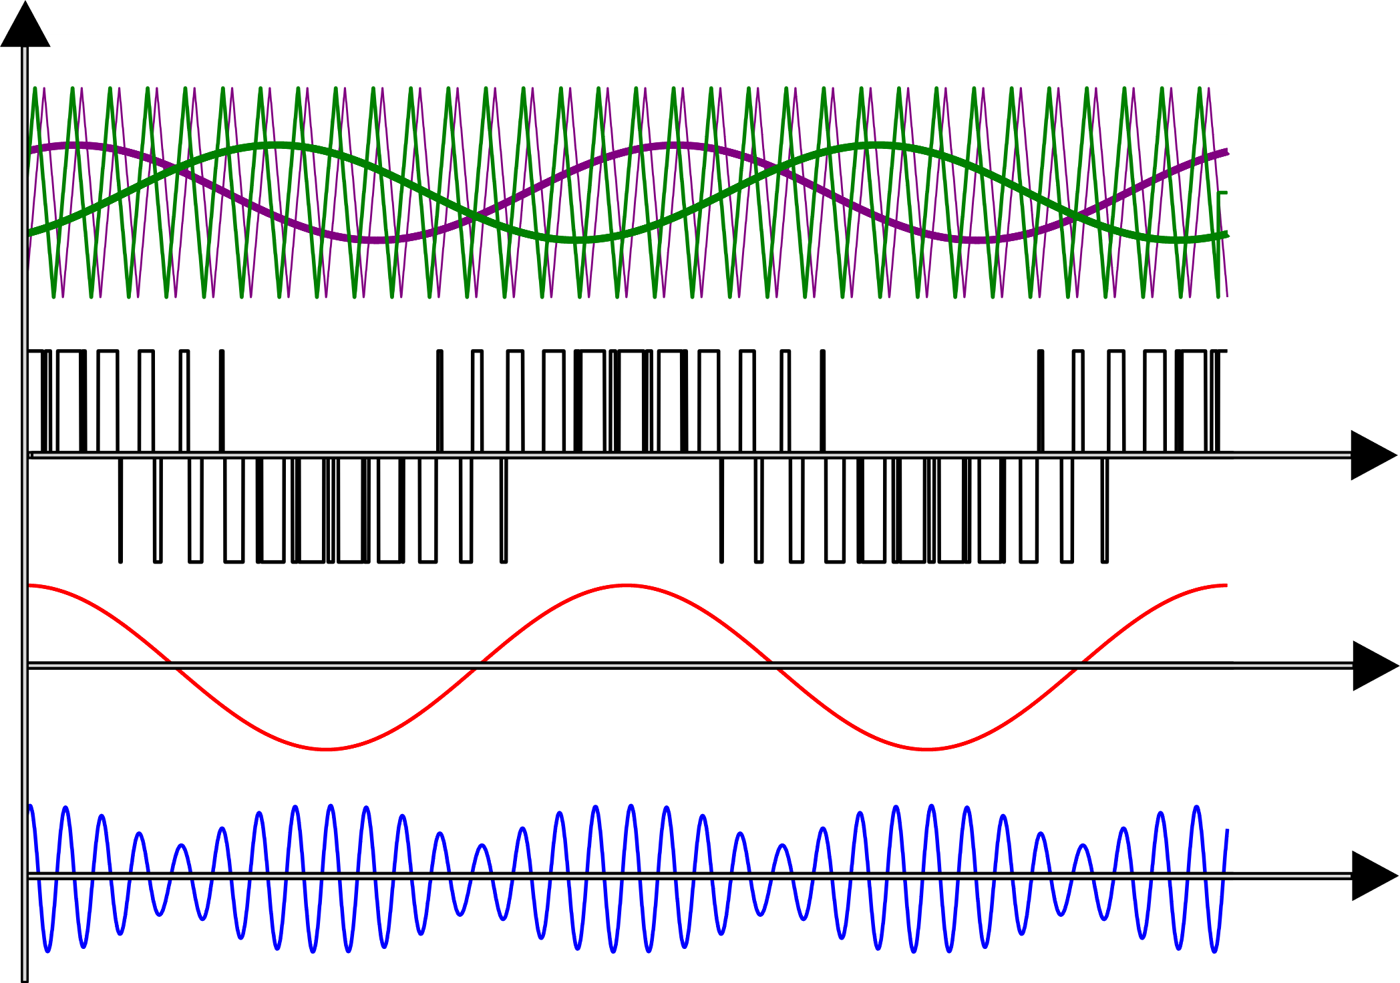
[picture p378: figure]

w/ carrier phase shift

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
a. Phases A (purple) and B(green) carrier triangles and sinusoidal references
b. Line-to-line voltage of phases A and B ( V_(AB) )
c. The waveform of fundamental frequency of V_(AB)
d. The waveform of the switching frequency and its sidebands of V_(AB)

a. Phases A (purple) and B(green) carrier triangles and sinusoidal references
b. Line-to-line voltage of phases A and B ( V_(AB) )
c. The waveform of fundamental frequency of V_(AB)
d. The waveform of the switching frequency and its sidebands of V_(AB)

## Slide 3

Carrier Phase Shift

D:\Github\WPTMotor\BLDC-whatever\control_space.m

Switching frequency of inverter normalized output voltage | (V_(AB))/(V_(DC))|

Fundamental frequency of inverter normalized output voltage | (V_(AB))/(V_(DC))|

## Slide 4

Low sideband at switching frequency of inverter normalized output voltage | (V_(AB))/(V_(DC))|

High sideband at switching frequency of inverter normalized output voltage | (V_(AB))/(V_(DC))|

## Slide 5

Switching frequency and its sidebands of inverter normalized output voltage | (V_(AB))/(V_(DC))|

Equivalent centered harmonics approach

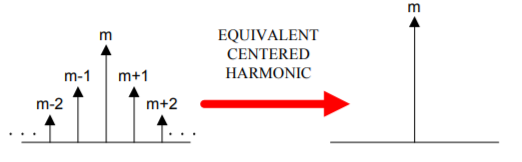
[picture p379: figure]

[1]

[1] Analysis and Characterization of DC Bus Ripple Current of Two-Level Inverters Using The Equivalent Centered Harmonic Approach

## Slide 6

Rectification of switching frequency and its side bands

Symmetric sidebands, which means that low and high sidebands have equal magnitude, can be fitted into closed-form.
cos(α)cos(β)=1/2[cos(α+β)+cos⁡(α−β)] → (1) trigonometric identities- product formula
α=w_s t and β=2w_o t
k_l cos(α−β)+k_c cos(α)+k_h cos⁡(α+β) → (2) switching harmonics and its sidebands
k_l =k_h =k (3) symmetric sidebands
Using (1) and (3)→ k_l cos(α−β)+k_h cos(α+β)=2kcos(α)cos⁡(β) (4)
Using (2) and (4) k_c cos(α)+2kcos(α)cos(β)=k_c cos(α)[1+(2k)/(k_c)cos⁡(β)] (5)

## Slide 7

abs(a.b)=abs(a).abs(b)
abs ( k_c cos(α)[1+(2k)/(k_c)cos(β)] )=k_C abs(cos(α))abs(1+(2k)/(k_c)cos(β))
1+(2k)/(k_c)cos(β)>0 and abs(cos(α))=2/π+∑_(p=1)^(∞) 4/(π(1−4p^2 ))cos⁡(pα)
k_c [1+(2k)/(k_c)cos(β) ] [ 2/π+∑_(p=1)^(∞) 4/(π(1−4p^2 ))cos⁡(pα)]

## Slide 8

(a)

(b)

t

(c)

t

(d)

t
