EnesAyaz/WPTMotor/Synhronous motor/TPEL-Journal-version-2/Mathematical Modelling/New Microsoft PowerPoint Presentation.pptx

T_s D_A

References

φ_A =0

T_s ((φ_B)/(2π))

A

B

T_s D_B

PWMs

Carrier

C

A

B

C

A

B

T_s ((φ_C)/(2π))

T_s D_C

C
