EnesAyaz/WPTMotor/Journal-3-phase/Major-Revision/Phasor diagran/New Microsoft PowerPoint Presentation.pptx

φ_(CPS)

|Leg A,B,C|= 2/πJ_2 (m_a π/2)

|Leg A,B,C|= 2/πJ_o (m_a π/2)

V_(sw) (ma)

Leg A

|Leg A,B,C|= 2/πJ_2 (m_a π/2)

Leg C

V_(sh) (ma)

Leg B

Leg C

Leg B

Leg A

φ_(CPS)

Leg A

Leg C

V_(sl) (ma)

Leg B

φ_(CPS)
