EnesAyaz/WPTMotor/Journal-3-phase/TIE/manuscript2.pdf

# Carrier Phase Shift Method of SPWM for Concurrent Wired and Wireless Power Transfer Systems

Enes Ayaz, Ogun Altun, and Ozan Keysan ¨

Abstract—This paper presents an approach for concurrent power transfer to wired and wireless systems using just a single inverter. The approach utilizes a novel carrier phase-shift (CPS) method that independently controls the inverter output voltages at the fundamental and the switching frequencies. This proposed method can be a cost-effective solution to wireless power transfer (WPT) systems used in contactless slip rings (CSR), which transfer power to auxiliary loads such as sensors, radars, and IoT devices. There are two separate converters in conventional CSR systems: one is for the motor drive, and the other is for the WPT system. It is proposed that the switching harmonics of the motor drive can also be utilized to excite the WPT system while the low-frequency component can still be used to drive the motor. In order to control these independently, the CPS method is introduced. The proposed method is investigated analytically for sinusoidal-PWM (SPWM). Then, an experimental setup consisting of a 3-phase 3-wire GaN-based inverter and a 3-phase motor is built. Experimental results show that the WPT and motor systems are operated concurrently, and their powers are controlled independently. The experimental results are compared with theoretical calculations to validate the proposed method, and they are in good agreement below 4% error.

Index Terms—Wireless power transfer, inductive power transfer, motor drive, concurrent power transfer, dual-band power transfer, carrier phase shift.

LIST OF ABBREVIATIONS
ωrl | Lower resonant frequency of WPT. [rad/sec].
ω | Operation frequency of WPT. [rad/sec].
ωc | Carrier frequency. [rad/sec].
ωrh | Higher resonant frequency of WPT. [rad/sec].
ωr | Resonant frequency of WPT. [rad/sec].
ϕc(A,B,C) Carrier phases [o
| ].
ϕCP S | The amount of carrier phase shift. (o )
ϕo | Fundamental phases [o ].
AINV | Inverter line-to-line voltage gain to DC-link.
AW P T WPT AC-AC voltage gain.
CRx | Rx capacitance [F].
CT x | Tx capacitance [F].
CV | Constant voltage.
fo | Fundamental frequency [Hz].
fs | Switching frequency [Hz].
fsh | Higher sideband (fs − 2fo) [Hz].
fsl | Lower sideband (fs − 2fo) [Hz].
Jk | kth order Bessel function.
Jo | Zeroth order Bessel function.

Enes Ayaz, Ogun Altun, and Ozan Keysan are with the Department of ¨ Electrical and Electronics Engineering, Middle East Technical University, Ankara, Turkey

k | Coupling factor.
LRx | Rx inductance [H].
LT x | Tx inductance [H].
M | Mutual inductance [H].
ma | Modulation index.
Prated | Output power of WPT system [W].
QRX | Quality factor of receiver side including load.
RL | Load resistance [Ω].
S | Switching function.
VDC | DC-link voltage [V ].
VD | Equivalent centered harmonic drive (input) voltage of
| WPT system [VRMS].
VOUT | Output voltage of WPT system [VRMS].
Vsh(ma) Line-to-line voltage at the higher sideband fre-
| quency for modulation index [VRMS].
Vsl(ma)RMS Line-to-line voltage at the lower sideband fre-
| quency for modulation index [VRMS].
Vs(ma) Line-to-line voltage at the switching frequency for
| modulation index [VRMS].
ZRX | Receiver side impedance of WPT [Ω].
ZTX | Transmitter side impedance of WPT [Ω].
I. INTRODUCTION

Wireless power transfer (WPT) systems have been commonly used in many applications such as EV chargers [1], consumer electronics [2], wearable devices [3], and contactless slip rings [4]. They provide several advantages like operation under harsh environments, increased mobility, etc. Compared to other WPT methods such as capacitive power transfer (CPT), WPT in radio frequency (RF), and WPT in ultrasonic; inductive power transfer (IPT) is the most common technique, which provides a moderate transfer distance, high power, and better efficiency [5]. IPT systems are primarily composed of a high-frequency converter, a set of transmitter (Tx), and receiver (Rx) coils with compensation elements and rectifier circuits. The compensation circuits create a resonant structure that amplifies the frequencies near the resonant frequency and attenuates the other frequencies, which means that they provide a power transfer at a single frequency, although high-frequency converters generate a square wave with high order harmonics.
Multi-frequency operation rather than single frequency to increase the power of single-load [6] or transfer power concurrently to multiple loads [7]–[14] are studied in the literature. Thus, the number of switches decreases with the same VA ratings, transmitted power increases, and the utilization rate of DC-link voltage increases. In [6], a single inverter is used with multi-resonant circuits amplifying the fundamental and the third harmonic of the square wave. The third harmonic component increases the transmitted power without increasing the VA rating of the semiconductor devices. However, it is not possible to independently regulate the third harmonic component in such a system. In [7], a dual-band WPT system is introduced to make Tx compatible with two different WPT standards. However, in these systems two separate sets of coils and drivers are used, allowing design flexibility but increasing system complexity and cost. In [8], a single-inverter-based dual-frequency WPT system is proposed using the programmed PWM method. The system can regulate the output voltage for multiple receivers. The programmed PWM provides that one WPT frequency is equal to the effective switching frequency, which reduces the switching losses. Nevertheless, the programmed PWM is computationally complex since it requires switching angle calculation using offline algorithms. Hence, such a method is not feasible in dynamic systems. In [10], multi-frequencies are achieved by comparing superimposed sinusoidal reference signals with the high-frequency triangular carrier signals. In addition, a phase shift can be given between the superimposed reference signals to increase the utilization rate of the DC-link voltage [11]. However, in these methods, the switching frequency is higher than the operating frequencies of the WPT system, which increases the switching losses.
Apart from the aforementioned studies, multi-frequency systems can also be implemented to combine wireless and wired power transfer concurrently since they could co-exist in dynamic applications [15], [16]. One of these applications is a contactless slip ring (CSR) used in many areas, such as the field excitation of wound rotor synchronous motor, radar systems, robotic arms, and IoT devices [17]–[19]. In conventional CSR systems, an inverter is readily available to drive the actuator, and the power transfer to moving frames is granted via a WPT system, consisting of a high-frequency converter and a set of Tx-Rx coils.
In this study, a motor and an auxiliary system are driven concurrently by a single converter as shown in Fig. 1.a. It is proposed that the already existing inverter of the drive can be used as a multi-frequency inverter; thus, the high-frequency converter of the WPT system can be eliminated, reducing the cost and complexity. Since the power of WPT is smaller than the motor, the motor drive can be used without increasing VA ratings. Conventional motor drives use several modulation techniques (such as SPWM, SVPWM, DPWM) to adjust the speed and torque of the motor. However, independent control of the WPT system cannot be achieved only using these techniques. Therefore, the carrier phase shift (CPS) method is proposed, which provides independent control of the dual-band output voltage.
The rest of the paper is organized as follows. Section II presents the modulation methods and the proposed CPS method. Section III delivers the design stage of the WPT system. Section IV gives experimental results to validate the theoretical calculations. Section IV compares the proposed system with existing studies in the literature. Section V discusses the implementation of the proposed system to conventional industrial drives.

II. SYSTEM PROPOSAL AND MODULATION METHOD
A 3-phase 3-wire (3Φ-3W) motor and a WPT system for auxiliary rotating loads are driven by a single inverter with sinusoidal pulse width modulation (SPWM) as a proof-ofconcept. The circuit diagram of the system and the expected voltage and current waveforms are shown in Fig. 1.b. In this section, firstly, the analytical modeling of applied SPWM will be investigated. Secondly, the carrier phase shift (CPS) method is proposed, and the effect of this method on the magnitude of the dual-band output will be argued. Finally, the equivalent centered harmonic approach to control the amount of CPS is presented. .
A. Analytical analysis of SPWM
SPWM is established by comparing a high-frequency triangular carrier signal and a fundamental (modulating) signal. This fundamental signal is the reference signal of the motor, and the operating frequency of WPT is cultivated using the first harmonic of the carrier signal. The analytical model of SPWM can be obtained as given in (1), using double Fourier analysis.

S =

1
2

+

ma
2

cos
ωot + θo

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
i(ωct + θc)

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
k=−∞ | 1 i
Jk
i

π
2 ma

sin
(i + k)

pi
2

cos
i(wct + θc) + k(wot + θo)

!

(1)

There are four main components for each leg: DC, fundamental, switching harmonics, and sidebands. The switching harmonics and their sidebands cannot be adjusted independently, and they change along with the modulation index, which is used to control the magnitude of the fundamental frequency.

TABLE I
THE SEQUENCES OF FUNDAMENTAL FREQUENCIES, SWITCHING, AND ITS SIDEBAND HARMONICS FOR INVERTER LEGS.
Frequency | Leg A | Leg B | Leg C | Sequence
fo | 0
| o | 120o | −120o | Positive
fs − 2fo | 0
| o | 120o | −120o | Positive
fs | 0
| o | 0
| | o | 0
| | | o | Zero
fs + 2fo | 0
| o | −120o | 120o | Negative

Moreover, the phases of these components vary for each leg of the inverter, and they have positive, negative, or zero sequences, as shown in Table II-A. The normalized line-to-line voltage harmonics are given in Fig. 3. Since the switching harmonic is zero-sequence, it is eliminated in a line-to-line connection, which means that the line-to-line connected WPT system is excited only by the sideband components. Additionally, the magnitude of these sideband components cannot be

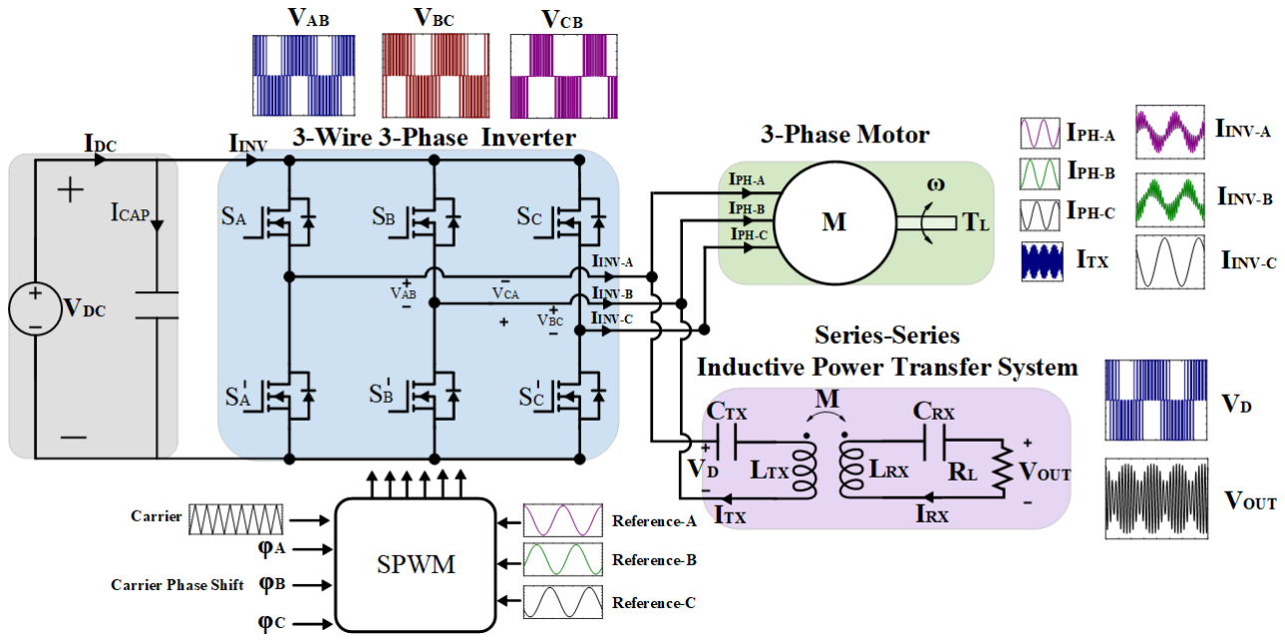
[picture p383: figure]
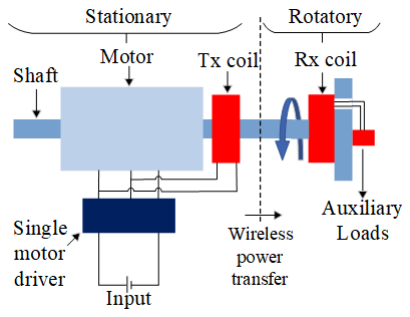
[picture p384: figure]

(a) (b)

Fig. 1. a) The proposed single-inverter multi-frequency motor drive and WPT system to energize IoT devices or sensors on the rotating frames. b) The circuit diagram of a single inverter system, which drives concurrently 3W-3Φ motor and WPT system.

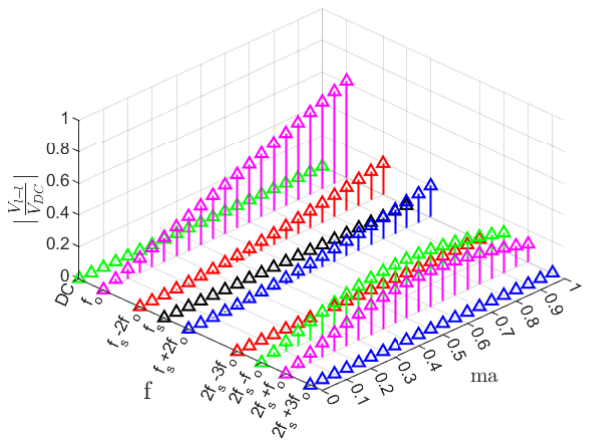
[picture p385: figure]

Fig. 3. The harmonic distribution of a line-to-line voltage among different modulation indices without carrier phase shift.

controlled independently. Therefore, in order to regulate the WPT power, a DC-DC converter can be added to the receiver for post-regulation, which increases cost and complexity, or frequency detuning can be applied, worsening the power factor and hence efficiency. However, these regulation methods cannot guarantee to transfer of power under each modulation index (ma) since sideband components converge to zero as ma comes up to zero. In other words, the transferred power of the WPT system is decreasing while ma is nearing zero. This diminished power is undesirable since the auxiliary loads may require the rated power for each operating condition of the motor.

B. The Proposed Carrier Phase Shift (CPS) Method

Normally, the power transmitted to the WPT system cannot controlled independently for every ma value due to the noncontrollable magnitude of sidebands and the disappearance of the switching frequency in the line-to-line connection. It is proposed that these problems can be solved by giving a phase shift between carrier signals of two legs. As can be seen from the double Fourier analysis in (1), phases of switching frequency and its sidebands change as a function of the phase of the carrier signal. In this study, for the coherency, the WPT system will be connected between legs A and B, and a carrier phase shift will be given to leg B, as given in (2).

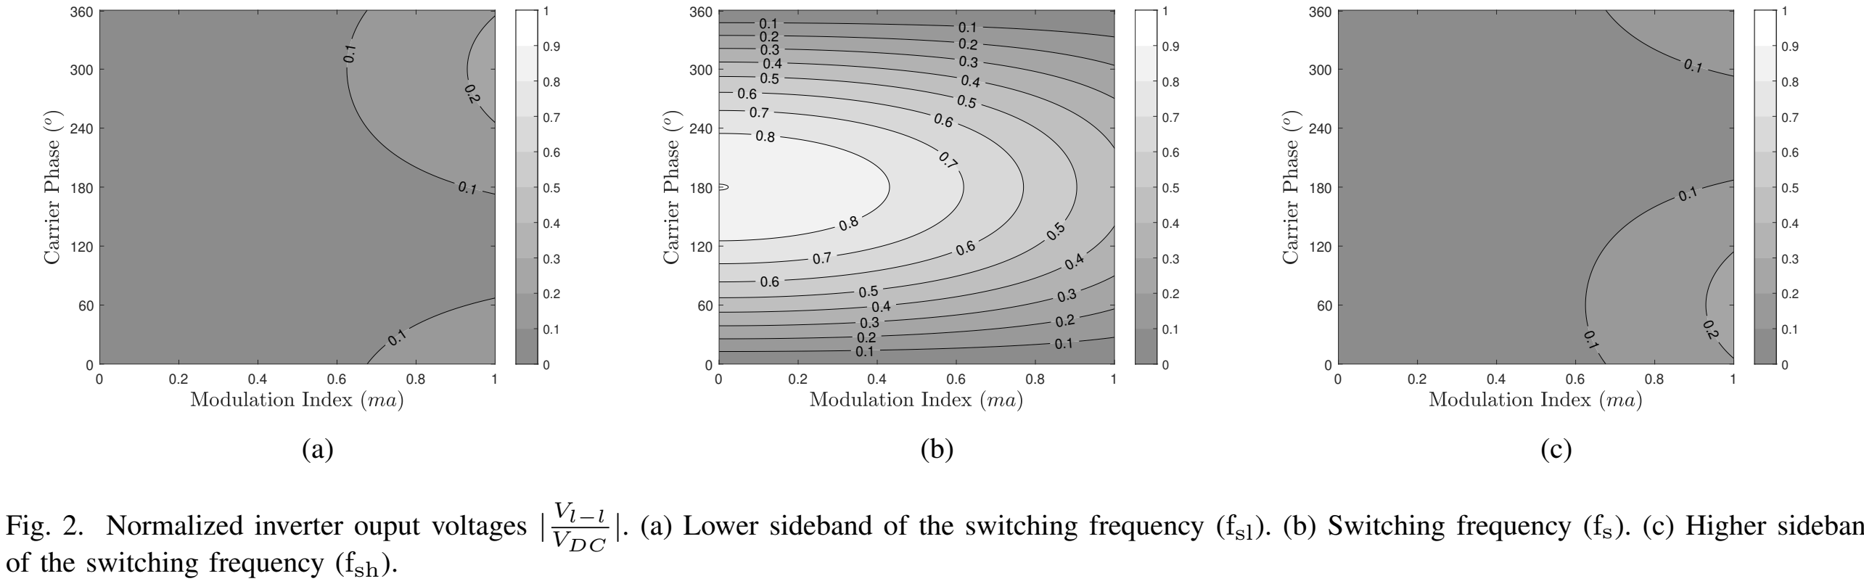
[picture p386: figure]
VDC; of the switching frequency (fsh).

Fig. 2. Normalized inverter ouput voltages |

|. (a) Lower sideband of the switching frequency (fsl). (b) Switching frequency (fs). (c) Higher sideband

Carrier phases

ϕcA = 0
ϕcB = ϕCP S

(2)

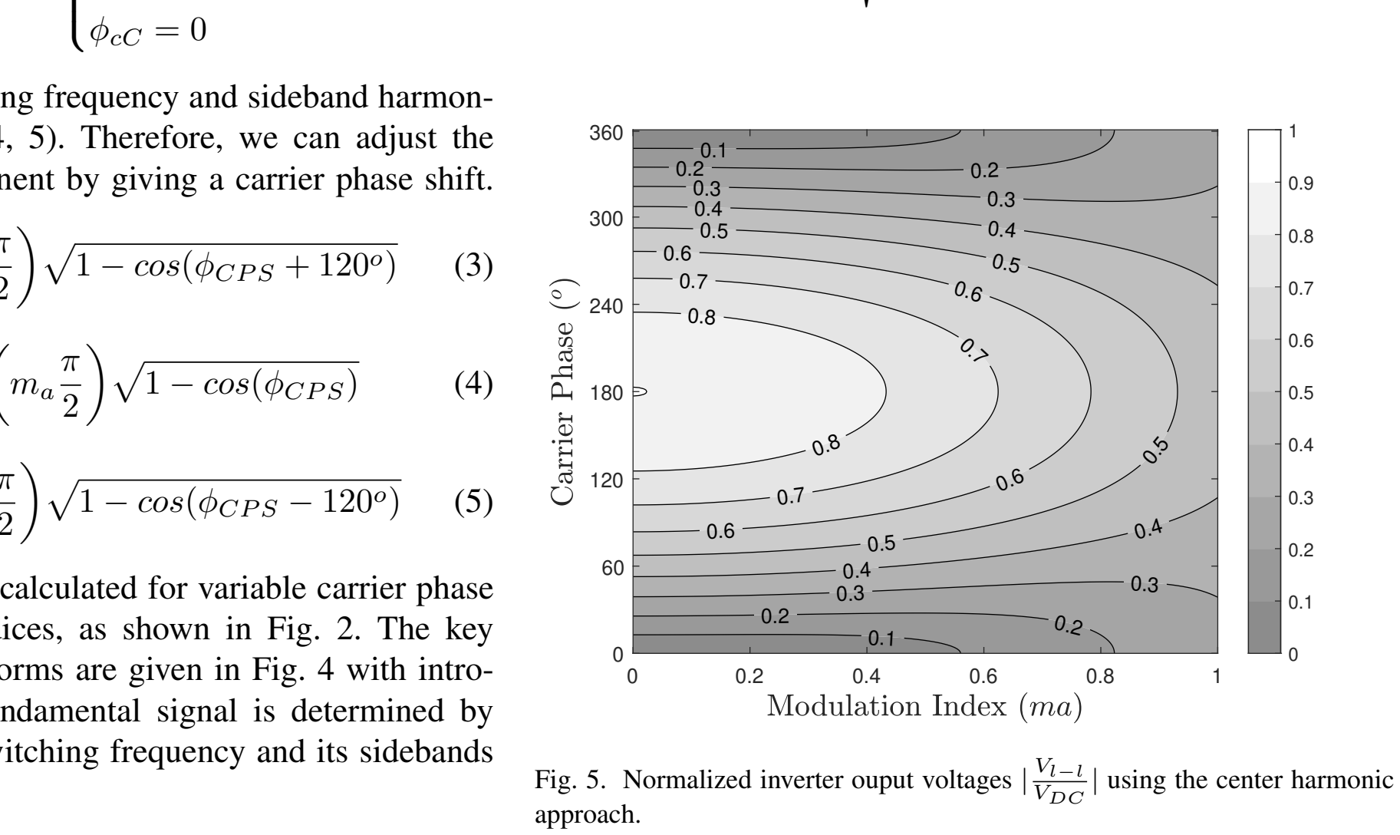
[picture p387: figure]
ϕcC = 0; 1 − cos(ϕCP S + 120o); 1 − cos(ϕCP S); 1 − cos(ϕCP S − 120o); VDC; | using the center harmonic; approach.

The magnitudes of switching frequency and sideband harmonics vary as given in (3, 4, 5). Therefore, we can adjust the magnitude of each component by giving a carrier phase shift.

Vsl(ma) = 2
π

J2

ma

π
2

p

Vs(ma) = 2
π

Jo

Vsh(ma) = 2
π

J2

ma

π
2

The magnitudes can be calculated for variable carrier phase shifts and modulation indices, as shown in Fig. 2. The key voltage and current waveforms are given in Fig. 4 with introduced CPS. While the fundamental signal is determined by modulating signals, the switching frequency and its sidebands are controlled by CPS.

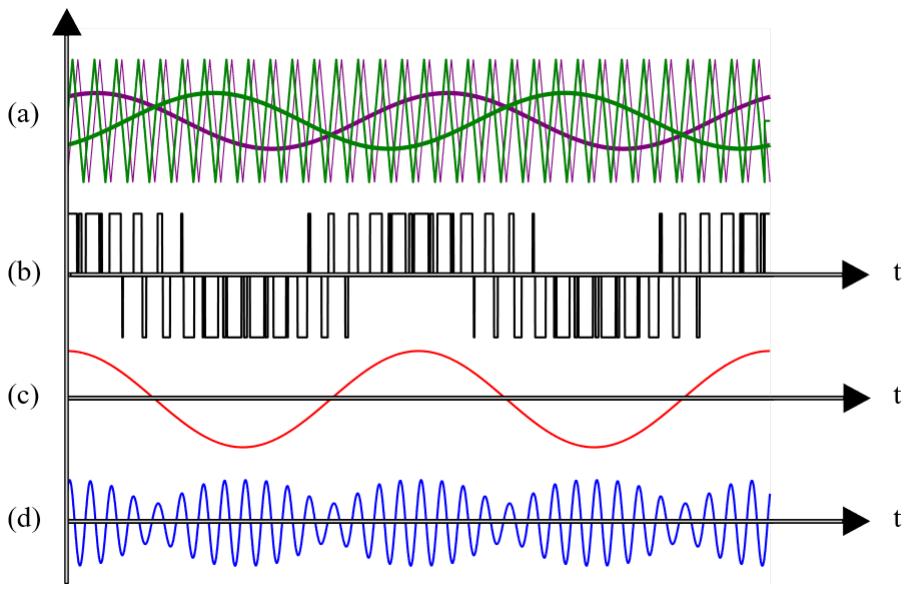
[picture p388: figure]

Fig. 4. Key Waveforms. (a) Ph-A (purple) and Ph-B(green) carrier triangles and sinusoidal references. (b) Line-to-line voltage of ph-A and ph-B (VAB).
(c) The waveform of fundamental frequency of (VAB). ak (d) The waveform of the switching frequency and its sidebands of (VAB).

A challenge is to determine the amount of the phase shift, which must guarantee a constant power transfer for any modulation indices. As shown in Fig. 2, while the magnitude of the switching frequency harmonic increases by increasing CPS, the magnitude of the sidebands decreases. Therefore, a combined equivalent magnitude value is required to select the range of phase shift.

C. Equivalent centered harmonics approach

Considering the quality factor of WPT systems, the gain of the switching frequency and its sideband harmonics are nearly equal since their frequencies are close enough. Instead of investigating each component in the time domain, we can build an equivalent drive voltage assuming all components to have the same frequency. The RMS equivalent drive voltage (VD) can be calculated using (6) since all these frequencies are orthogonal to each other.

VD =

s
V

2
sl + V ²
sw + V

2

sh
(6)

Fig. 5. Normalized inverter ouput voltages |

Using the equivalent center harmonic approach, a normalized drive voltage is shown for various carrier phase shifts and modulation indices in Fig. 5. As can be seen, for each modulation index, we can guarantee the normalized gain between 0.25 and 0.45 by keeping the carrier phase shift between 30o and 60o

. While the carrier phase shift is approaching 180o
, the
normalized drive voltage increases. However, at this point, we cannot fully control the voltage level; for example, the drive voltage acquired at ma = 0 cannot be reached at ma = 1.

III. WPT SYSTEM PARAMETERS SPECIFICATION

A WPT system is established as a proof of concept. The input-output specifications of these system are given in Table II. The effective drive voltage is selected as 0.3 times VDC , which means that the input voltage of WPT is kept constant at 30 VRMS.

TABLE II
THE INPUT-OUTPUT SPECIFICATIONS OF THE WPT SYSTEM

Ratings
DC-link Voltage (VDC ) | 100 V
WPT Input Voltage (VD) | 30 VRMS
Output Voltage (VOUT ) | 15 VRMS
Rated Power (Prated) | 24 W

The system is series-series (SS) compensated, the circuit diagram of which is shown in Fig. 6, and the operating frequency is selected between 80 kHz and 90 kHz.
In general, auxiliary systems such as sensors and IoT devices have varying loads, and it is desired to achieve constant voltage (CV) output for any load conditions. Thus, the WPT system is designed to supply CV output in this study. For SS compensation, the frequency of the load-independent voltage is different from the resonant frequency (wr), and there are two

R | VOUT V | L D | jωMIRx

CTx

ITx

LTx

jωMITx

CRx

IRx

V | LRx D-fsl

VD-fs

VD-fsh

Fig. 6. The first harmonic approach circuit diagram of the WPT system.

operating frequencies (ωrl, ωrh) that satisfies load independent output voltage. The output voltage (VOUT ) and voltage gain (AW P T ) of the SS compensated system are given in (7) and (8).

VOUT =

jωMIT x

ZRx

RL

=

jωM

ZRx
VIN

ω²M²

ZRx

+ ZT x

RL

=

jωMVIN
ω²M² + ZT xZRx

RL

(7)

AW P T =

VOUT

VIN

=

ωM
ω²M² + ZTXZRX

RL

(8)

In order to calculate the frequencies providing load-independent voltage gain, the differential equation of

dAW P T
dRL

= 0 should be solved [20]. The load-independent voltage operating frequencies are found as in (9) according to selected coupling factor (k) and angular resonant frequency wr.

ωrl =ωr

r
1
1 + k

ωrh =ωr

r
1
1 − k

(9)

The minimum load resistance that delivers the rated power can be calculated as in (10).

RL =

V

2
OUT
Prated

(10)

Receiver inductance is calculated using the load resistance, operating frequency that is selected as wrh, and the chosen quality factor of Rx (QRx) as provided in (11).

QRx =

ωrhLRx
RL

LRx =

QRxRL

ωrh

(11)

The voltage gain of WPT should be 0.5 to achieve the desired output voltage of 15 VRMS. The load-independent voltage gain is presented in (12), and the Tx inductance is found using (13).

AW P T(ωrh) =

r
LRx

LT x

(12)

LT x =

LRx
A²
W P T(ωrh)

(13)

Then, the mutual inductance is calculated as in (14).

M = k

p
LT xLRx | (14)

Finally, the compensation capacitances are adjusted as in (15).

CT x =

1
ω²
rLT x

CRx =

1 ω² rLRx | (15)

The initial parameters and the derived parameters are given in Table III. The voltage gain-frequency graphs of the designed WPT system for different load resistances are shown in Fig. 7.

TABLE III
WPT SYSTEM PARAMETERS

Initial/Choosen

Parameters | Values | Derived
| | Parameters | Values
Prated | 24 W | AWPT | 0.5
VD | 30 VRMS | RL | 9.3 Ω
Vout | 15 VRMS | LRx | 50 µH
frh | 85 kHz | LTx | 200 µH
QRx | 2.9 | M | 40 µH
k | 0.4 | fr | 65.85 kHz
| | CTx | 29.2 nF
| | CRx | 117 nF

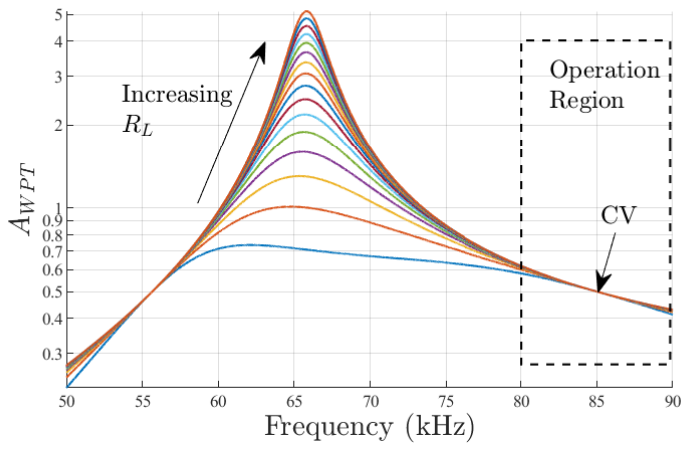
[picture p389: figure]

Fig. 7. The voltage gain of WPT system for different load resistances.

IV. EXPERIMENTAL VALIDATION
An experimental setup is established consisting of a GaN-based 3Φ-3W inverter and an AC motor to validate the proposed method. The experimental setup is shown in Fig. 8. The AC motor is loaded using a DC generator, and the WPT system is connected to its shaft.
A. Multi-frequency Inverter Test
In this part, the inverter is driven by the SPWM modulation technique with and without the proposed CPS method. Thus, the variation in the magnitudes of the fundamental frequency, switching frequency, and its sidebands are investigated.

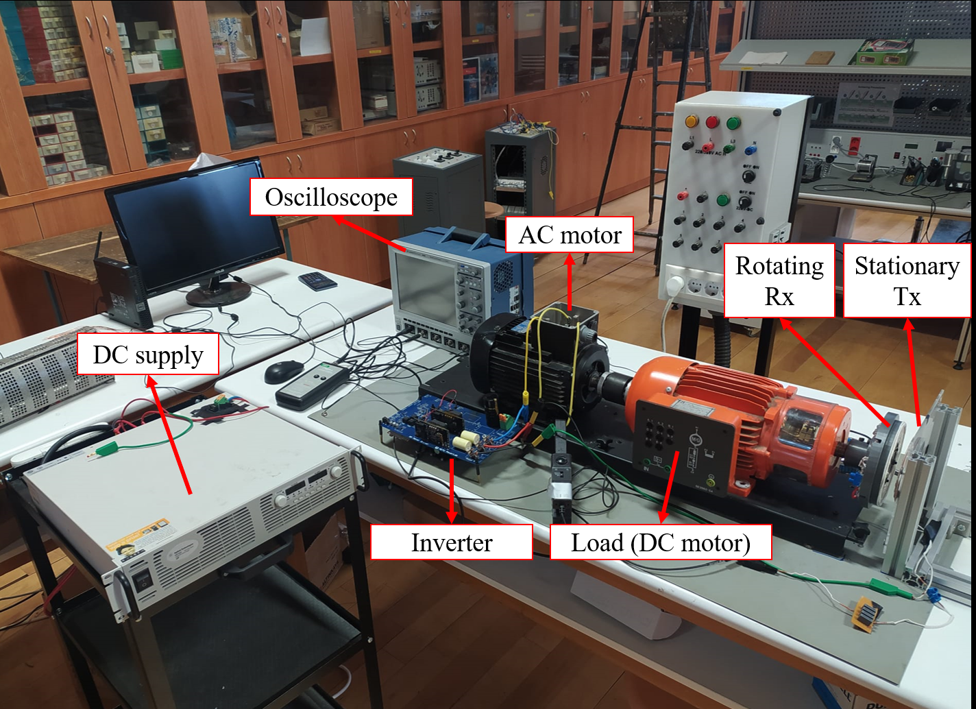
[picture p390: figure]

Fig. 8. Experimental Setup.

The inverter output voltages are shown in Fig. 9 for the phase shift of ϕB = 0o
and ϕB = 47.5

o
. The harmonic
distributions of the normalized inverter output voltage are compared in Table V for analytical and experimental results, which have a good agreement with an error band of less than

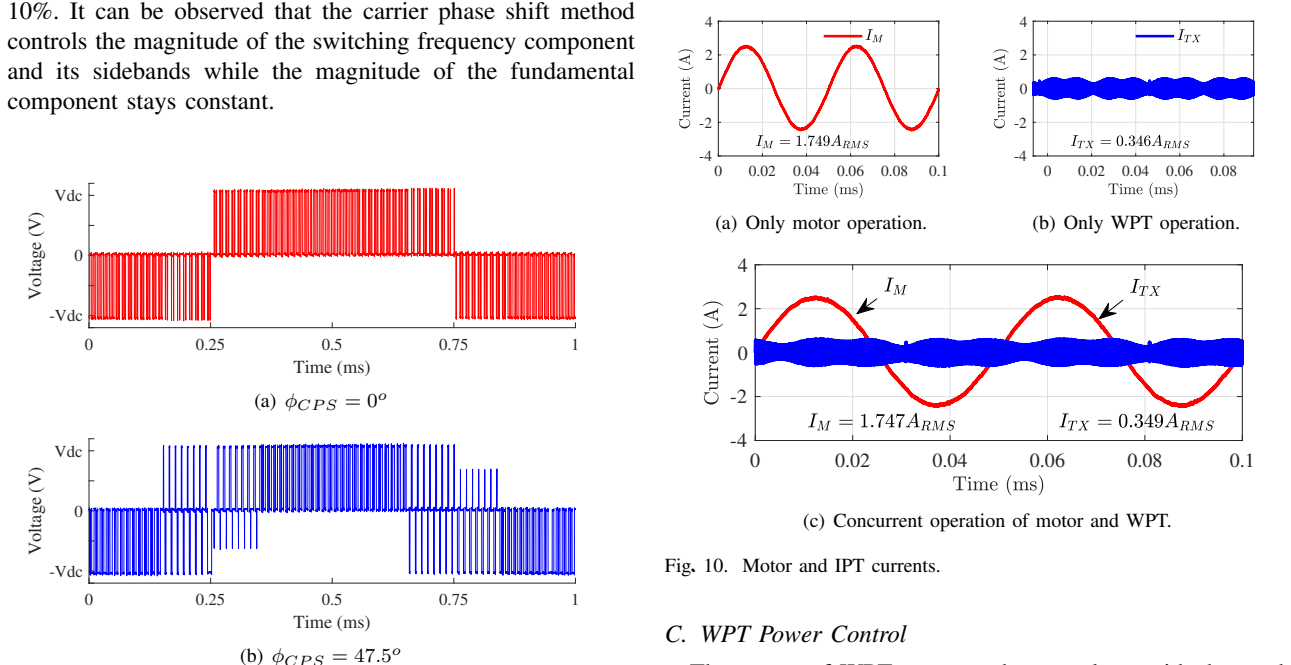
[picture p391: figure]
component stays constant.; Time (ms); -Vdc; Vdc; Voltage (V); (a) ϕCP S = 0o; (a) Only motor operation.; (b) Only WPT operation.; Fig. 10. Motor and IPT currents. .; C. WPT Power Control

10%. It can be observed that the carrier phase shift method controls the magnitude of the switching frequency component and its sidebands while the magnitude of the fundamental

(b) ϕCP S = 47.5

Fig. 9. Inverter output voltage (Vl−l

) (or called as drive voltage VD ) at ma = 0.6 for ϕCP S = 0o
and ϕCP S = 47.5

o

TABLE V
THEORETICAL AND EXPERIMENTAL RESULTS OF INVERTER OUTPUT HARMONIC DISTRIBUTION FOR ϕCP S = 0o AND ϕCP S = 47.5

o

AINV (Vˆ
ll/Vdc)
| at fo | at fl | at fs | at fh

ma = 0.6
ϕCPS = 0
Theoretical | 0.519 | 0.113 | 0 | 0.113
Experimental | 0.532 | 0.110 | 0.011 | 0.115
Error | 2.5% | 2.6% | - | 1.7%

ma = 0.6
ϕCPS = 47.5

o

Theoretical | 0.519 | 0.130 | 0.405 | 0.077
Experimental | 0.537 | 0.127 | 0.414 | 0.084
Error | 3.4% | 2.3% | 2.2% | 9.1%
B. Concurrent Operation of motor and WPT
Carrier phase shift is adjusted to 40o with ma = 0.8. First, the WPT system and the motor are driven individually and then concurrently. Fig. 10. shows the motor-only operation, and the motor current is ∼ 1.75 A. Then, only the WPT system is connected, and it draws ∼ 0.35 A. Finally, the inverter drives the motor and WPT system concurrently, and it is observed that the systems draw almost the same current for the identical modulation index and carrier phase shift.
(c) Concurrent operation of motor and WPT.

The power of WPT systems changes along with the modulation indices if a constant carrier phase shift is employed. In order to keep the WPT power constant, a variable carrier phase shift should be applied. The normalized power was

TABLE IV
CARRIER PHASE SHIFT REQUIREMENTS FOR DIFFERENT MODULATION INDEX.

Modulation index
(ma)
| 0 | 0.1 | 0.2 | 0.3 | 0.4 | 0.5 | 0.6 | 0.7 | 0.8 | 0.9 | 1

Phase shift (θan)
(Theoretical) | 41 | 41 | 41.2 | 42.4 | 44.1 | 46.0 | 48.2 | 50.3 | 51.9 | 52.0 | 46

Phase shift (θexp)
(Experimental) | 41 | 41.2 | 41.8 | 42.7 | 44 | 45.7 | 47.5 | 49 | 50 | 51 | 46

Error |

θan − θexp

θan

100| | 0% | 0.5% | 1.4% | 0.7% | 0.2% | 0.6% | 1.4% | 2.5% | 3.6% | 1.92% | 0%

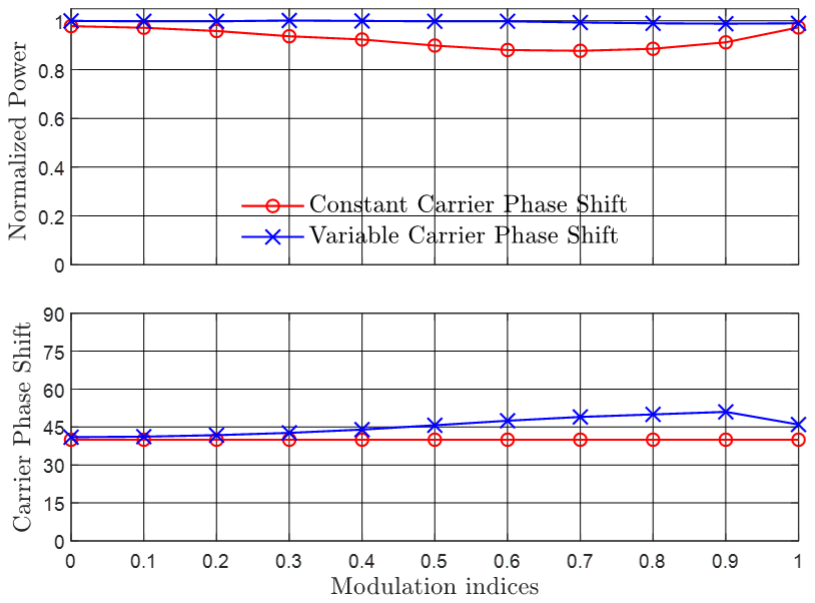
[picture p392: figure]

Fig. 11. Powers of the WPT system for constant and variable carrier phase shift.

experimentally obtained for constant and variable phase shifts, which are shown in Fig. 11. In the modulation indices where normalized power reduces, the carrier phase shift is increased to compensate for the diminished power. Phase shift values used in the experimental setup to keep constant power are also compared with theoretical calculations in Table IV, and the error stays below 4%.

D. Transients of Motor and WPT on Load Changes
In this part, the effect of the load changes on the WPT system and motor is investigated. Firstly, the mechanical load of the AC motor is varied, while other parameters such as switching frequency and modulation index are kept constant. It is observed that the WPT system is not disturbed by the load changes, as shown in Fig 12.a. Then, the load of the WPT system is altered using the same procedure. As expected, currents of the AC motor do not change, as shown in Fig. 12.b. Unless the modulation index or switching frequency changes, a system’s load changes do not affect the operation of the other system.
V. COMPARISON WITH EXISTING STUDIES
Existing multi-frequency WPT systems in the literature are given in Table VI. The proposed method provides independent control of the dual-band output voltage. Unlike [8], it is not required offline calculations where it is not possible to apply dynamic applications like motor drive systems. In addition, the operating frequency of the WPT system is matched with the switching frequency compared to [10], [11]. If WPT operates at the modulated frequency rather than the switching frequency, the switching losses increase to achieve the same coil sizes. Thus, directly utilizing the switching frequency is significant to make the system feasible. Furthermore, a single converter is presented rather than using two separate converters as in [7], which helps to reduce the system cost and complexity.
VI. DISCUSSION
In this section, the feasibility of implementing the proposed system on conventional industrial motor drives is discussed.
A. Wide-bandgap Semiconductors based Motor Drives
The operating frequency of WPT systems has a direct impact on their size; the higher frequency is the smaller coil [21]. The switching frequency of conventional motor

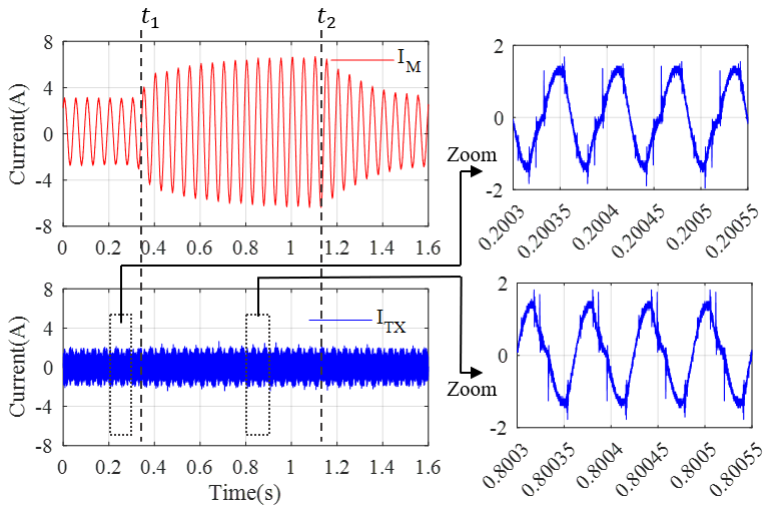
[picture p393: figure]

(a) At t1, the motor load torque is increased, and at t2, the motor load torque returns to the former value.

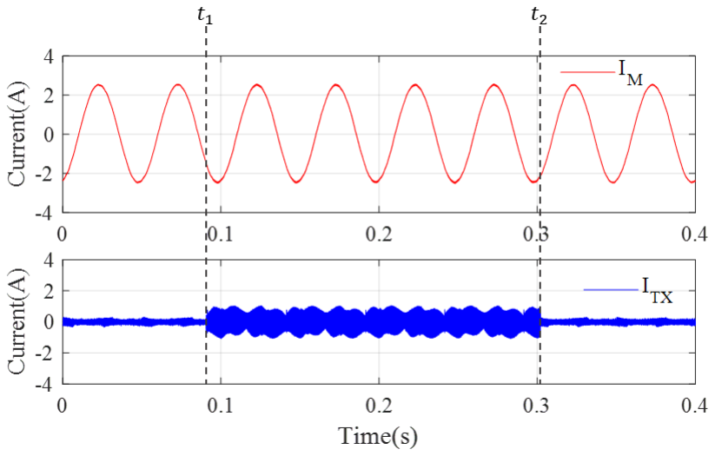
[picture p394: figure]

(b) At t1, The WPT load resistance is decreased, and at t2, WPT load resistance returns to the former value.

Fig. 12. Transient load changes. a) Motor load changes. b) IPT load changes.

TABLE VI
COMPARISON WITH EXISTING STUDIES IN THE LITERATURE.

Transfer
Channels

Converter
Numbers (Tx)

Offline
Algortihm

Operating
Frequency
[6] | 1 | 1 | Not Required | ≥ fs
[7] | 2 | 2 | Not Required | fs
[8] | 2 | 1 | Required | ≤ fs
[11] | 4 | 1 | Not Required | < fs
This work | 2 | 1 | Not Required | = fs

drives has traditionally been around 20 kHz due to the switching losses of silicon (Si)-based transistors [22]. IPT systems are not feasible in this frequency range since the Tx-Rx coils get bulky. However, with recent advancements in semiconductor technology, higher switching frequencies (up to several hundred kHz) can be achieved with wide-bandgap semiconductors such as silicon carbide (SiC) or gallium nitride (GaN) based motor drives without sacrificing efficiency [23], [24]. These advancements make the proposed method feasible, and it is considered that just an algorithm update would be enough to implement it.

B. Current Modulation Techniques of Conventional Drives Many modulation techniques such as Sinusoidal PWM (SPWM), Space Vector PWM (SVPWM), and Discontinuous PWM (DPWM) are used in industrial motor drives. Each modulation technique has its advantages. For example, while SVPWM effectively utilizes the DC link voltage, DPWM provides reduced switching losses. Although the proposed system is implemented with SPWM, it can also be applied with other modulation techniques. The change in the magnitude of the switching frequency over modulation indices is presented in Fig. 13 for SPWM and SVPWM. It is observed that the tendency of the magnitude of the switching harmonic of SVPWM is similar to SPWM, and it can be controlled in lineto-line connection via the proposed CPS as presented before.

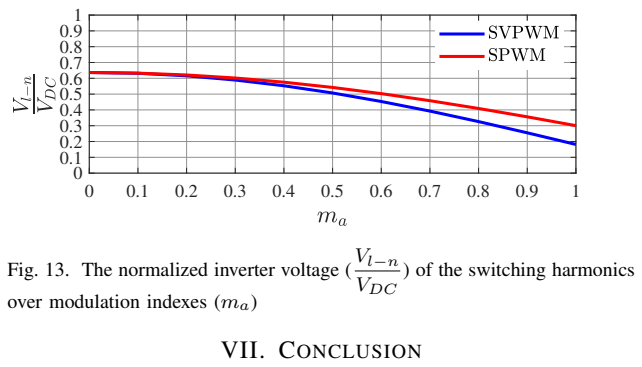
[picture p395: figure]
VDC; ) of the switching harmonics; over modulation indexes (ma); VII. CONCLUSION

Fig. 13. The normalized inverter voltage (

This paper proposes a concurrent dual-frequency power transfer method for wired and wireless systems using just a single inverter. The proposed method can reduce the system cost and size for applications that require power transfer to rotating frames, such as rotating sensors, radars, and auxiliary systems. This study also presents a novel carrier phase shift (CPS) method to regulate the power transferred to the WPT systems. Therefore, active converters on the Rx side are not required, which reduces the complexity and weight of the system on the rotating frame. The system can be implemented in conventional industrial motor drives, which are on the trend of passing wide-bandgap semiconductors that enable higher switching frequencies. Thus, a sweet operating frequency is achieved considering the switching losses and the size of the WPT system. In order to validate the proposed system, an experimental setup with a GaN-based drive was established. It was acquired that the switching harmonic and the fundamental frequency is controlled independently by the proposed CPS method. It was observed that the experimental results are coherent with analytical calculations.

REFERENCES

[1] H. Chen, Z. Qian, R. Zhang, Z. Zhang, J. Wu, H. Ma, and X. He, “Modular four-channel 50 kw wpt system with decoupled coil design for fast ev charging,” IEEE Access, vol. 9, pp. 136 083–136 093, 2021.
[2] Y. Zhang, S. Chen, X. Li, and Y. Tang, “Design methodology of freepositioning nonoverlapping wireless charging for consumer electronics based on antiparallel windings,” IEEE Transactions on Industrial Electronics, vol. 69, no. 1, pp. 825–834, 2022.
[3] S. H. Kang, J. H. Choi, F. J. Harackiewicz, and C. W. Jung, “Magnetic resonant three-coil wpt system between off/in-body for remote energy harvest,” IEEE Microwave and Wireless Components Letters, vol. 26, no. 9, pp. 741–743, 2016.
[4] X. Zhu, L. Liu, and H. Qi, “Performances of a contactless energy transfer system for rotary ultrasonic machining applications,” IEEE Access, vol. 8, pp. 51 981–51 990, 2020.
[5] M. Etemadrezaei, “22 - wireless power transfer,” in Power Electronics Handbook (Fourth Edition), fourth edition ed., M. H. Rashid, Ed. Butterworth-Heinemann, 2018, pp. 711–722. [Online]. Available: https://www.sciencedirect.com/science/article/pii/B9780128114070000246
[6] Z. Pantic, K. Lee, and S. M. Lukic, “Multifrequency inductive power transfer,” IEEE Transactions on Power Electronics, vol. 29, no. 11, pp. 5995–6005, 2014.
[7] D. Ahn and P. P. Mercier, “Wireless power transfer with concurrent 200-khz and 6.78-mhz operation in a single-transmitter device,” IEEE Transactions on Power Electronics, vol. 31, no. 7, pp. 5018–5029, 2016.
[8] C. Zhao and D. Costinett, “Gan-based dual-mode wireless power transfer using multifrequency programmed pulse width modulation,” IEEE Transactions on Industrial Electronics, vol. 64, no. 11, pp. 9165–9176, 2017.
[9] C. Qi, H. Miao, Z. Lang, and X. Chen, “A generalized methodology to generate, amplify and compensate multi-frequency power for a single-inverter-based mf-mr-s-wpt system,” IEEE Access, vol. 8, pp. 181 513– 181 525, 2020.
[10] C. Xia, N. Wei, H. Zhang, S. Zhao, Z. Li, and Z. Liao, “Multifrequency and multiload mcr-wpt system using hybrid modulation waves spwm control method,” IEEE Transactions on Power Electronics, vol. 36, no. 11, pp. 12 400–12 412, 2021.
[11] J. Wu, L. Bie, W. Kong, P. Gao, and Y. Wang, “Multi-frequency multi-amplitude superposition modulation method with phase shift optimization for single inverter of wireless power transfer system,” IEEE Transactions on Circuits and Systems I: Regular Papers, vol. 68, no. 5, pp. 2271–2279, 2021.
[12] Y. Xiao, C. Liu, Y. Huang, and S. Liu, “Concurrent wireless power transfer to multiple receivers with additional resonant frequencies and reduced power switches,” IEEE Transactions on Industrial Electronics, vol. 67, no. 11, pp. 9292–9301, 2020.
[13] F. Liu, Y. Yang, Z. Ding, X. Chen, and R. M. Kennel, “A multifrequency superposition methodology to achieve high efficiency and targeted power distribution for a multiload mcr wpt system,” IEEE Transactions on Power Electronics, vol. 33, no. 10, pp. 9005–9016, 2018.
[14] W. Jin, A. T. L. Lee, S.-C. Tan, and S. Y. Hui, “A gallium nitride (gan)-based single-inductor multiple-output (simo) inverter with multifrequency ac outputs,” IEEE Transactions on Power Electronics, vol. 34, no. 11, pp. 10 856–10 873, 2019.
[15] Y. Cao and J. A. A. Qahouq, “Analysis and evaluation of a dual-variable closed-loop control of power converter with wireless and nonwireless power transfer,” IEEE Transactions on Industrial Electronics, vol. 66, no. 4, pp. 2668–2679, 2019.
[16] Q. Deng, Y. Cheng, F. Chen, D. Czarkowski, M. K. Kazimierczuk,
H. Zhou, and W. Hu, “Wired/wireless hybrid charging system for electrical vehicles with minimum rated power requirement for dc module,” IEEE Transactions on Vehicular Technology, vol. 69, no. 10, pp. 10 889– 10 898, 2020.
[17] M. Maier and N. Parspour, “Operation of an electrical excited synchronous machine by contactless energy transfer to the rotor,” IEEE Transactions on Industry Applications, vol. 54, no. 4, pp. 3217–3225, 2018.
[18] K. D. Papastergiou and D. E. Macpherson, “An airborne radar power supply with contactless transfer of energy—part i: Rotating transformer,” IEEE Transactions on Industrial Electronics, vol. 54, no. 5, pp. 2874– 2884, 2007.
[19] G. Lee and G. Ahn, “Wireless power transfer of daisy chain structure on rotating spindle,” in 2020 IEEE Wireless Power Transfer Conference (WPTC), 2020, pp. 384–3876.
[20] W. Zhang, S.-C. Wong, C. K. Tse, and Q. Chen, “Analysis and comparison of secondary series- and parallel-compensated inductive power transfer systems operating for optimal efficiency and load-independent voltage-transfer ratio,” IEEE Transactions on Power Electronics, vol. 29, no. 6, pp. 2979–2990, 2014.
[21] V. Shevchenko, O. Husev, R. Strzelecki, B. Pakhaliuk, N. Poliakov, and N. Strzelecka, “Compensation topologies in ipt systems: Standards, requirements, classification, analysis, comparison and application,” IEEE Access, vol. 7, pp. 120 559–120 580, 2019.
[22] S. Tiwari, O. . Midtgard, and T. M. Undeland, “Sic mosfets for future ˚ motor drive applications,” in 2016 18th European Conference on Power Electronics and Applications (EPE’16 ECCE Europe), 2016, pp. 1–10.
[23] A. K. Morya, M. C. Gardner, B. Anvari, L. Liu, A. G. Yepes, J. Doval-Gandoy, and H. A. Toliyat, “Wide bandgap devices in ac electric drives: Opportunities and challenges,” IEEE Transactions on Transportation Electrification, vol. 5, no. 1, pp. 3–20, 2019.
[24] W. Lee, S. Li, D. Han, B. Sarlioglu, T. A. Minav, and M. Pietola, “A review of integrated motor drive and wide-bandgap power electronics for high-performance electro-hydrostatic actuators,” IEEE Transactions on Transportation Electrification, vol. 4, no. 3, pp. 684–693, 2018.
