EnesAyaz/WPTMotor/Journal-3-phase/Submission/Submission Files/WPT- 3- phase- Motor-Final Files/new.pdf

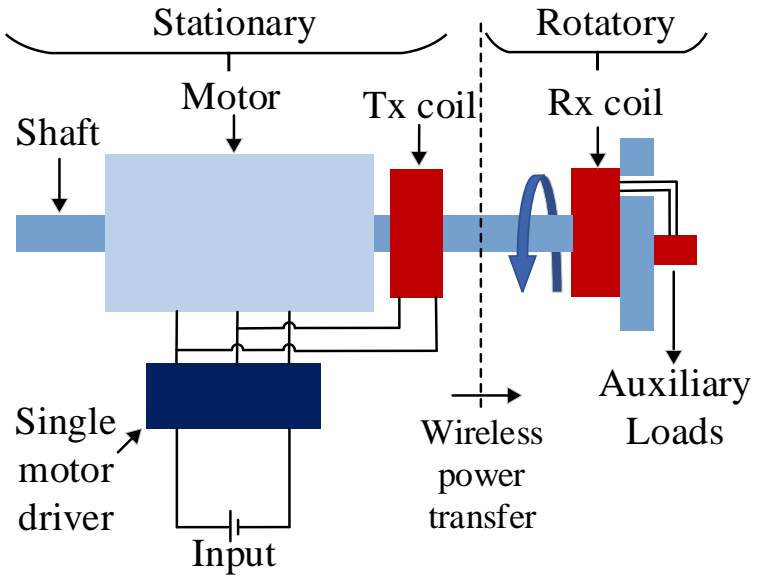
[picture p427: figure]
Motor; Shaft; Tx coil; Auxiliary; Single; Loads; motor driver; Input; Stationary; Rotatory; Rx coil; Wireless power transfer
