EnesAyaz/WPTMotor/Journal-3-phase/eski/Draft.docx

[^1]

# Preparation of Papers for IEEE Trans on Industrial Electronics

# (Apr. 2021)

First A. Author1, Membership, Second B. Author2, Membership,
and Third C. Author3, Membership

Abstract—These instructions give you guidelines for preparing papers for IEEE TRANSACTIONS ON INDUSTRIAL ELECTRONICS. Use this document as a template. The electronic file of your paper will be formatted further at IEEE. Paper titles should be written in uppercase and lowercase letters, not all uppercase. Avoid writing long formulas with subscripts in the title; short formulas that identify the elements are fine (e.g., "Nd–Fe–B"). Do not write “(Invited)” in the title. Write full names of authors in the author field. Define all symbols used in the abstract. Do not cite references in the abstract. Do not delete the blank line immediately above the abstract; it sets the footnote at the bottom of this column.

Index Terms—Enter key words or phrases in alphabetical order, separated by commas. For a list of suggested keywords, send a blank e-mail to keywords@ieee.org or visit http://www.ieee.org/documents/taxonomy_v101.pdf.

# I. Introduction

# II. MOTOR and MOTOR DRİVER

# III. Pulse Width Modulation TeCHNİQUES

# IV. HARMONİC ANALYSİS and CARRIER PHASE SELECTION

# V. IPT PaRAMETERS

[^1] Manuscript received Month xx, 2xxx; revised Month xx, xxxx; accepted Month x, xxxx. This work was supported in part by the … Department of xxx under Grant (sponsor and financial support acknowledgment goes here). (Authors’ names and affiliation) F. A. Author1 and S. B. Author2 are with the xxx Department, University of xxx, City, Zip code, Postcode, Country, on leave from the National Institute for xxx, City, Zip code, Country (e-mail: author@domain.com). T. C. Author3 is with the National Institute of xxx, City, Zip code, Postcode, Country (corresponding author to provide phone: xxx-xxx-xxxx; fax: xxx-xxx-xxxx; e-mail: author@ domain.gov).

IEEE TRANSACTIONS ON INDUSTRIAL ELECTRONICS
