EnesAyaz/WPTMotor/Synhronous motor/TPEL-Journal-version-2/Restriction/New Microsoft PowerPoint Presentation.pptx

1.2

m_a =0

m_a =0.25

m_a =0.5

Fundamental phase (rad)

m_a =0.75

m_a =1

Maximum

Minimum

S_(AB) _(fs) (p.u)

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
## Slide 2

1.2

m_a =0

m_a =0.25

m_a =0.5

Fundamental phase (rad)

m_a =0.75

m_a =1

Maximum

Minimum

0.8

S_(AB) _(fs)

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
## Slide 3

## Slide 4

## Slide 5

Modulation index ( m_a )

Controllable
Region

Uncontrollable
Region

Maximum

S_(AB) _(fs) (p.u)

0.44

Minimum

0.88

## Slide 6

Modulation index ( m_a )

Controllable
Region

Uncontrollable
Region

Maximum

S_(AB) _(fs) (p.u)

0.44

Minimum

0.88

## Slide 7

Modulation index ( m_a )

Controllable
Region

Uncontrollable
Region

Maximum

S_(AB) _(fs)

0.44

Minimum

0.88
