EnesAyaz/WPTMotor/Journal-DC-Motor/v8.0/Switching_pattern/Switching_Graphs.pptx

## Slide 2

## Slide 3

T_S

DT_S

S_A

t

I_M

t

I_(TX)

t

I_(INV)

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
## Slide 4

T_S

DT_S

S_A

t

I_(TX)

t

I_M

I_(INV)

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
## Slide 5

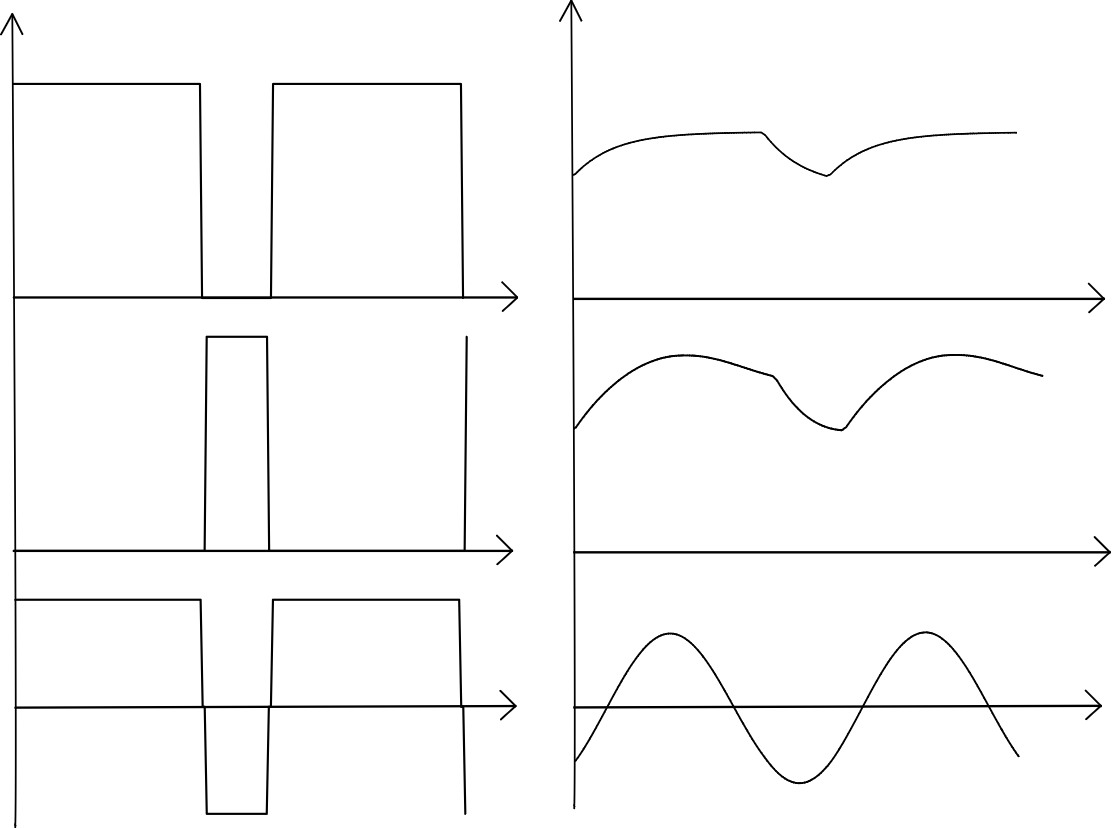
[picture p428: figure]

## Slide 6

T_S

DT_S

T_S

DT_S

S_A

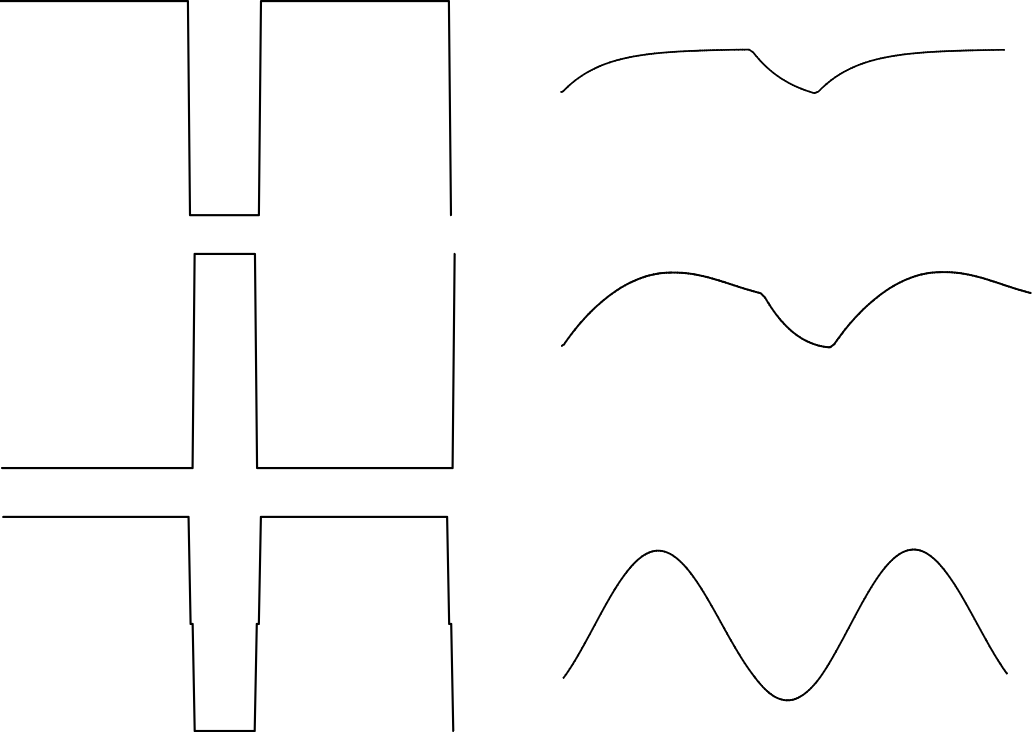
[picture p429: figure]

I_M

t

t

S_B

I_(INV)

t

t

V_O

t

I_(TX)

t

## Slide 7

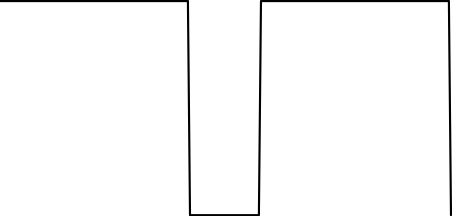
[picture p430: figure]
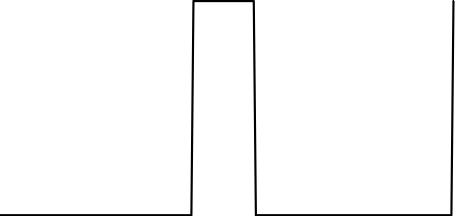
[picture p431: figure]
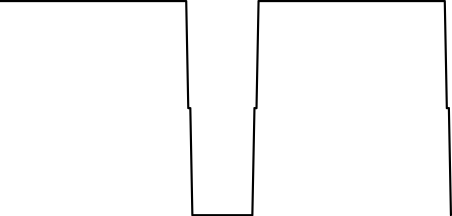
[picture p432: figure]
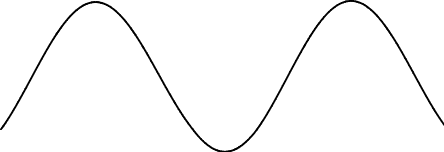
[picture p433: figure]

## Slide 8

T_S

T_S

S_A

DT_S

DT_S

I_M

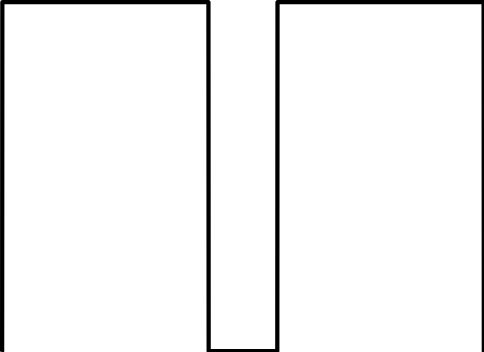
[picture p434: figure]

S_B

t

I_(INV)

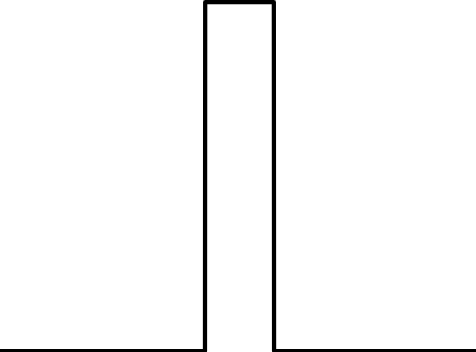
[picture p435: figure]

t

V_O

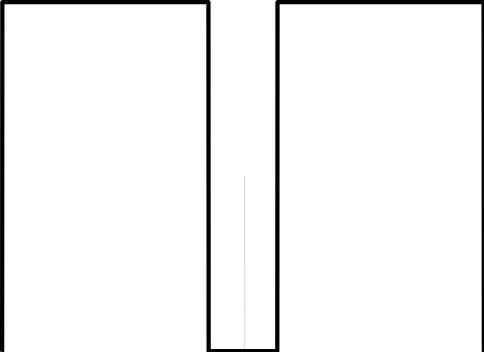
[picture p436: figure]
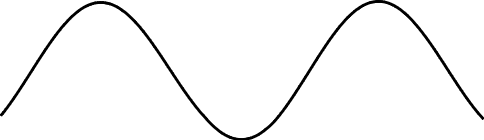
[picture p437: figure]

I_(TX)

t

## Slide 9

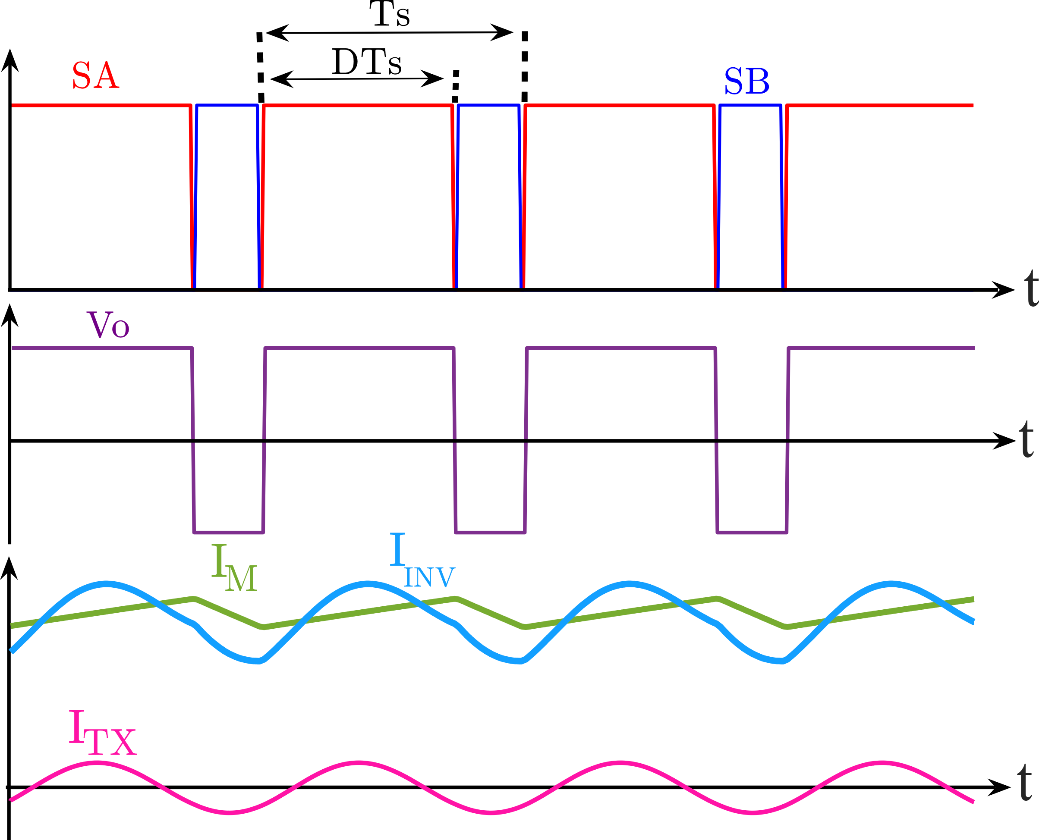
[picture p438: figure]
