EnesAyaz/WPTMotor/Journal-3-phase/eski/Switching_Pattern/New Microsoft PowerPoint Presentation.pptx

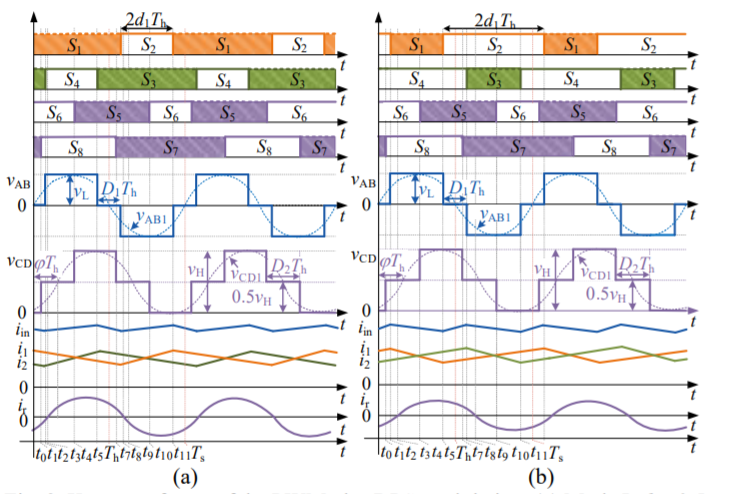
[picture p439: figure]
