EnesAyaz/WPTMotor/Journal-DC-Motor/v8.0/Soft-Switch/Spice-files/New Microsoft PowerPoint Presentation.pptx

Ts

DTs

(a) SA

ZVS

(b) SA

ZVS

## Slide 2

Ts

DTs

ZVS

ZVS

(a) SA

(b) SA

ZVS

ZVS
