EnesAyaz/WPTMotor/Journal-DC-Motor/v8.0/Soft-Switch/visio/pdf/Soft_Switch2.pdf

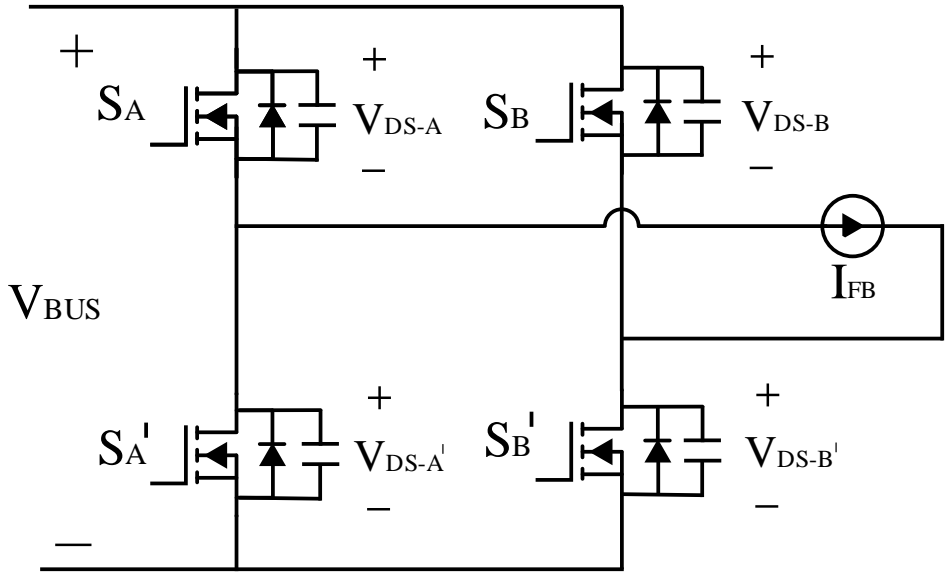
[picture p440: figure]
IFB; VDS-A; VBUS; VDS-B
