EnesAyaz/WPTMotor/Journal-DC-Motor/v8.0/Soft-Switch/visio/pdf/Soft_Switch.pdf

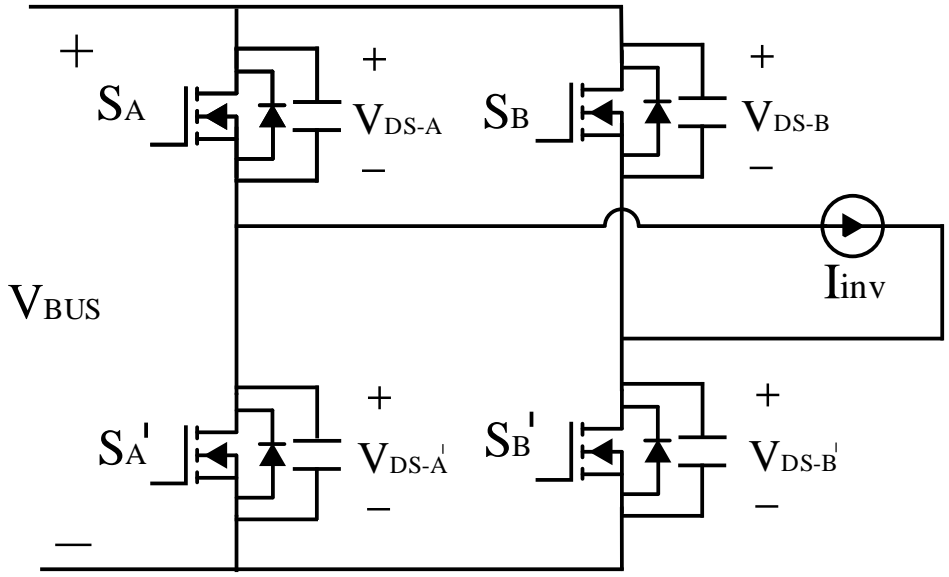
[picture p441: figure]
Iinv; VDS-A; VDS-B; VBUS
