EnesAyaz/WPTMotor/Journal-3-phase/Major-Revision/Control Schemes/Controller3AC_v2.pdf

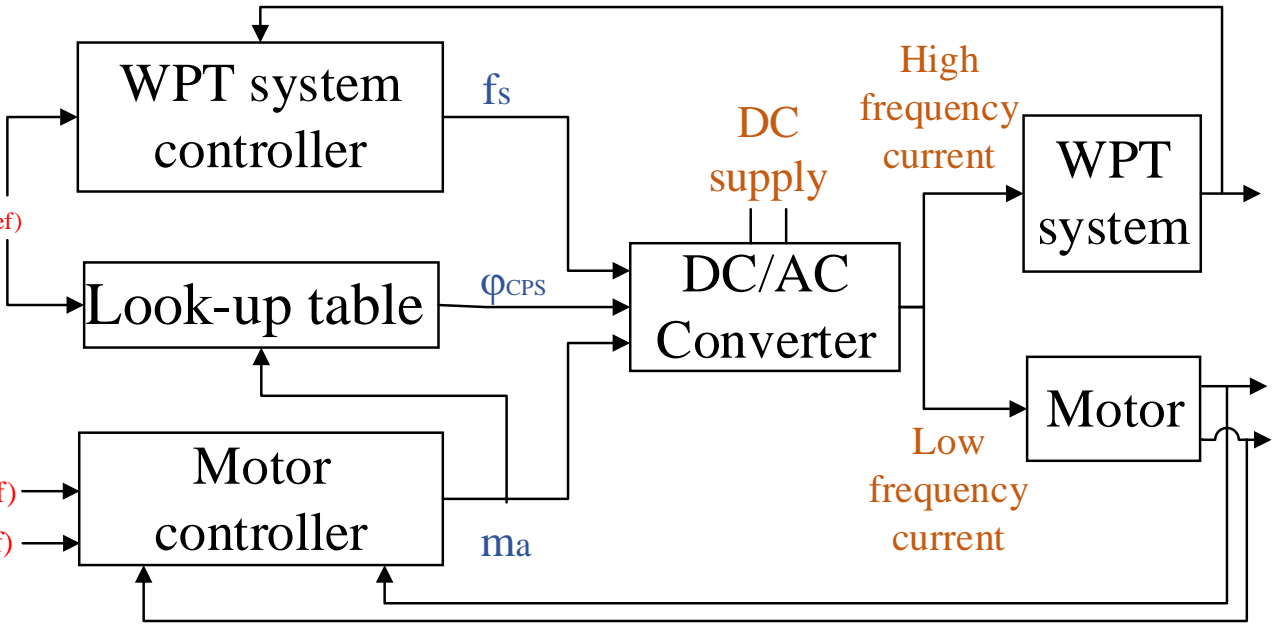
[picture p442: figure]
WPT system controller; Motor controller; DC/AC Converter; WPT; system; Motor; High frequency current; Low frequency current; φCPS fs; DC supply; Look; -up table

# VOUT(ref) ω(ref) T(ref)

# VOUT ωT
