EnesAyaz/WPTMotor/Journal-DC-Motor/v7.0/Switching_pattern/controller.pdf

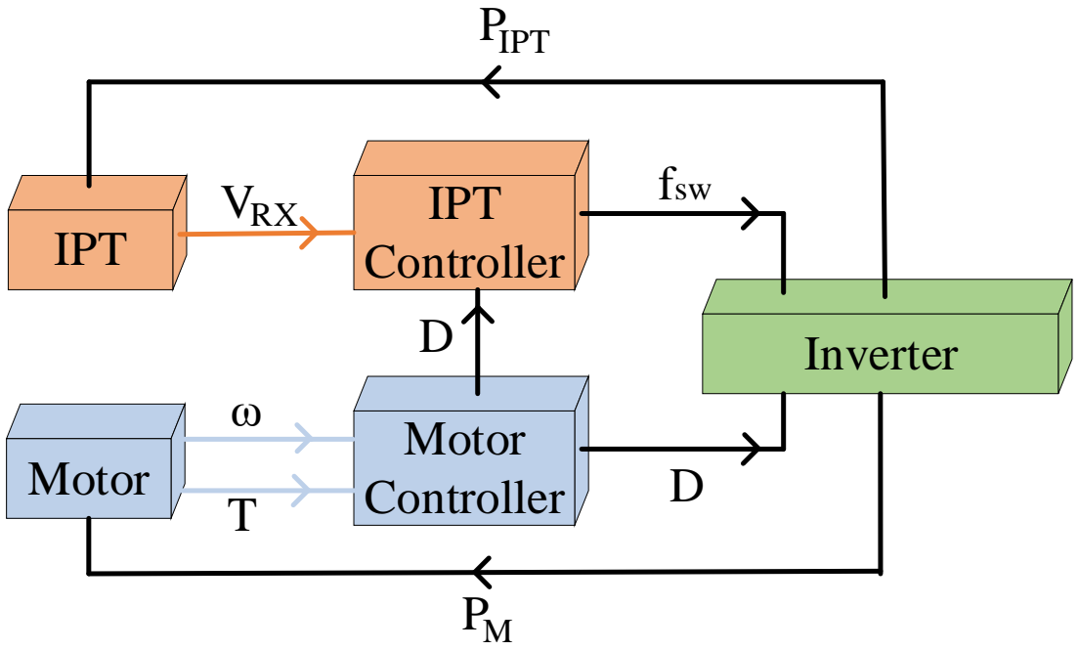
[picture p443: figure]
IPT; Motor; IPT Controller; Motor Controller; Inverter; fsw; PIPT
