EnesAyaz/WPTMotor/Journal-DC-Motor/v1.0/Introduction-figures/Proposed_IPT_v2_Block_Diagram.pdf

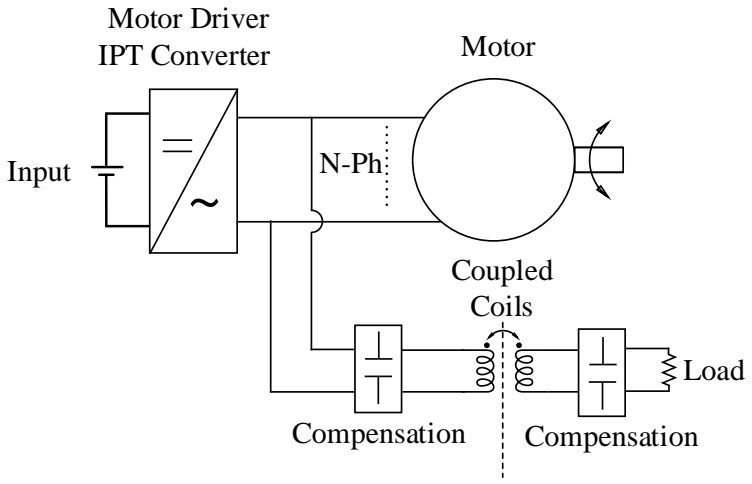
[picture p444: figure]
Input; Motor Driver; IPT Converter; Motor; Coupled Coils; Compensation; Load
