EnesAyaz/WPTMotor/Journal-DC-Motor/v3.0/Introduction-figures/Visio Drawings/Proposed_IPT_v2_Block_Diagram.pdf

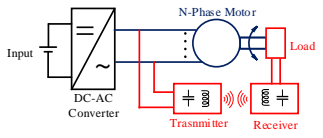
[picture p445: figure]
Input; DC-AC Converter; Trasnmitter; Receiver; Load; N-Phase Motor
