EnesAyaz/WPTMotor/Journal-DC-Motor/v6.0/Introduction-figures/Visio Drawings/pdf/Conventional_IPT_v4.pdf

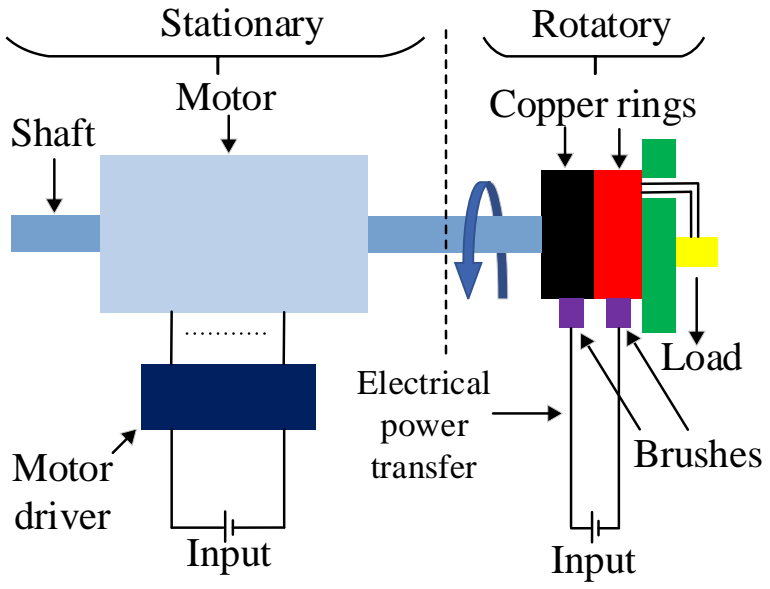
[picture p446: figure]
Motor; Shaft; Load; Motor driver; Input; Stationary; Rotatory; Copper rings; Brushes; Electrical power transfer
