EnesAyaz/WPTMotor/Journal-DC-Motor/v6.0/Introduction-figures/Visio Drawings/pdf/Conventional_IPT_v4_IPT.pdf

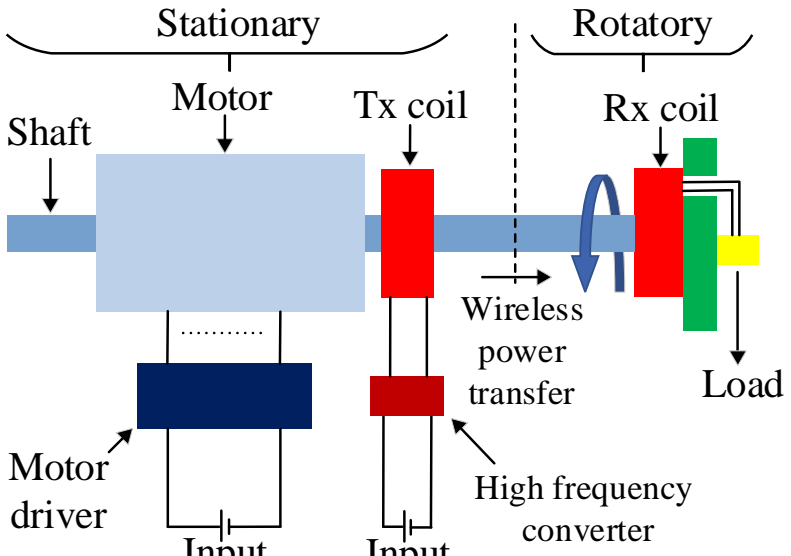
[picture p447: figure]
Motor; Shaft; Tx coil; Load; Motor driver; Stationary; Rotatory; High frequency converter; Rx coil; Wireless power transfer

### Input Input
