EnesAyaz/WPTMotor/Journal-DC-Motor/v4.0/Introduction-figures/Visio Drawings/pdf/Conventional_IPT_v4.pdf

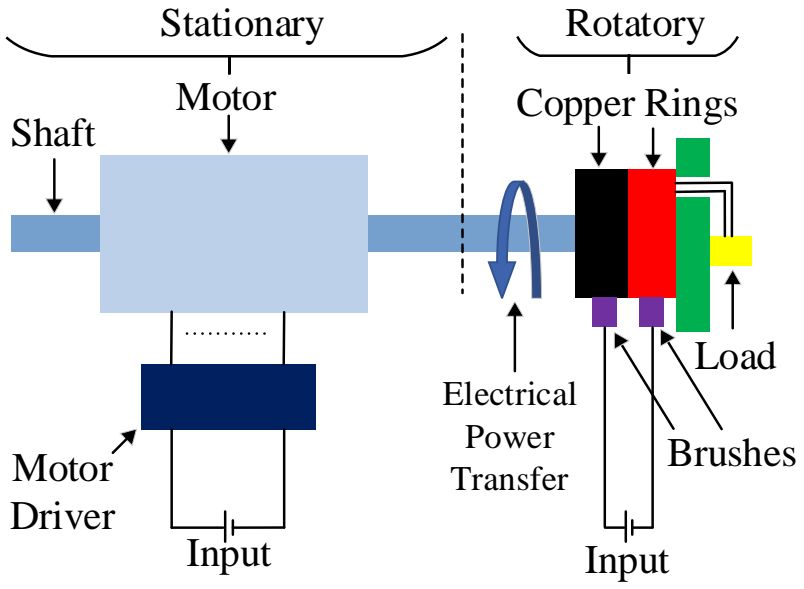
[picture p448: figure]
Motor; Shaft; Load; Motor Driver; Input; Stationary; Rotatory; Copper Rings; Brushes; Electrical Power Transfer
