EnesAyaz/WPTMotor/Journal-DC-Motor/v4.0/Introduction-figures/Visio Drawings/pdf/Conventional_IPT_v4_IPT.pdf

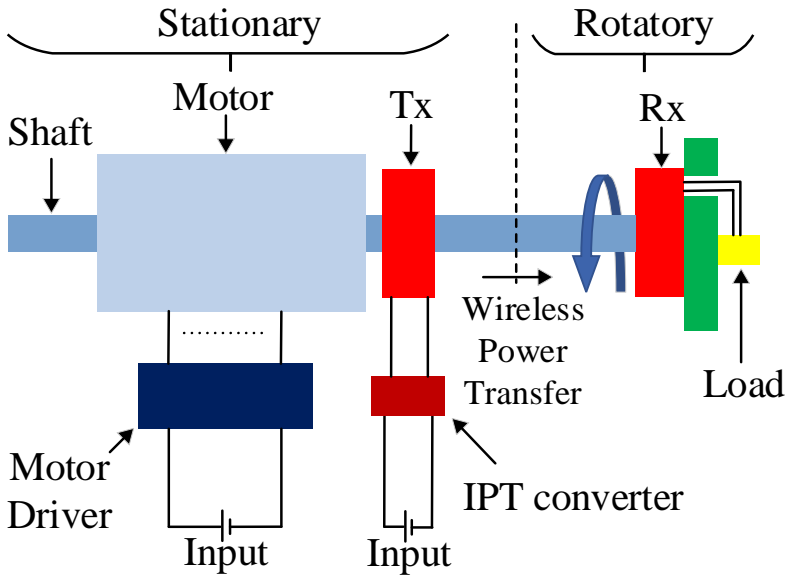
[picture p449: figure]
Motor; Shaft; Load; Motor Driver; Input; Stationary; Rotatory; IPT converter; Wireless Power Transfer
