EnesAyaz/WPTMotor/Journal-DC-Motor/v3.0/Introduction-figures/Visio Drawings/pdf/Conventional_IPT_v2.pdf

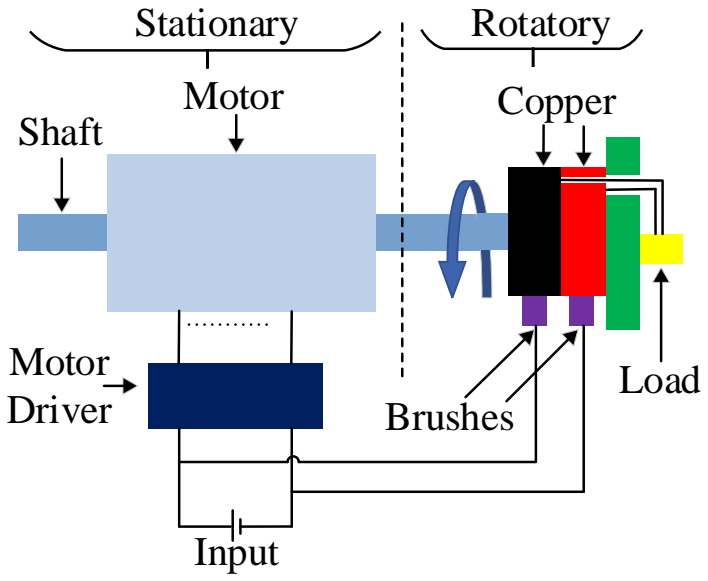
[picture p450: figure]
Motor; Shaft; Copper; Load Motor Driver; Input; Stationary; Rotatory; Brushes
