EnesAyaz/WPTMotor/Journal-DC-Motor/v3.0/Introduction-figures/Visio Drawings/pdf/Conventional_IPT_v2_IPT.pdf

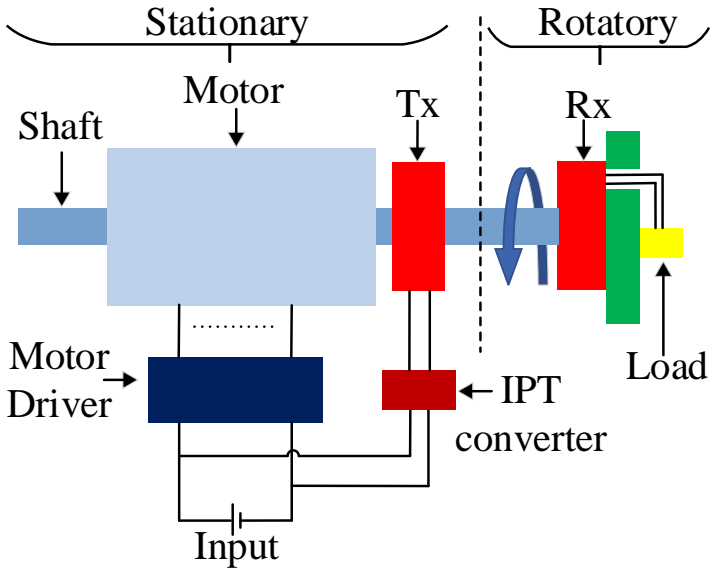
[picture p451: figure]
Motor; Shaft; Load; Driver; Input; Stationary; Rotatory; IPT converter
