EnesAyaz/WPTMotor/Journal-3-phase/Major-Revision/Transients/New Microsoft PowerPoint Presentation.pptx

t_1

t_2

Zoom

Zoom

data_plotter_transient_v2

## Slide 2

t_1

t_2

data_plotter_transient_tx_v2
