EnesAyaz/WPTMotor/BLDC-whatever/Journal-Image/control_space_fall.png

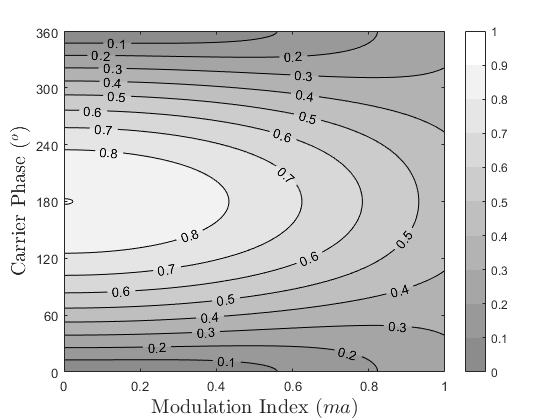
BLDC-whatever/Journal-Image/control_space_fall.png
