EnesAyaz/WPTMotor/BLDC-whatever/Journal-Image/control_space_fh.png

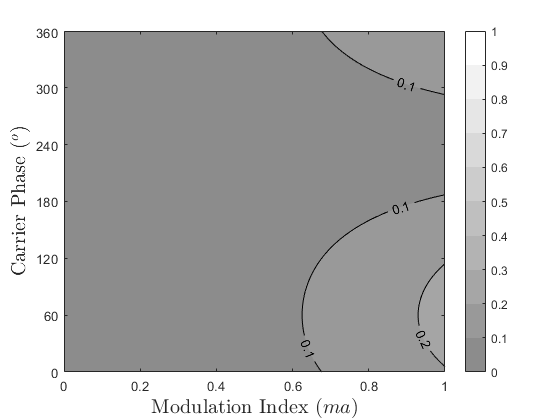
BLDC-whatever/Journal-Image/control_space_fh.png
