EnesAyaz/WPTMotor/BLDC-whatever/Journal-Image/control_space_fl.png

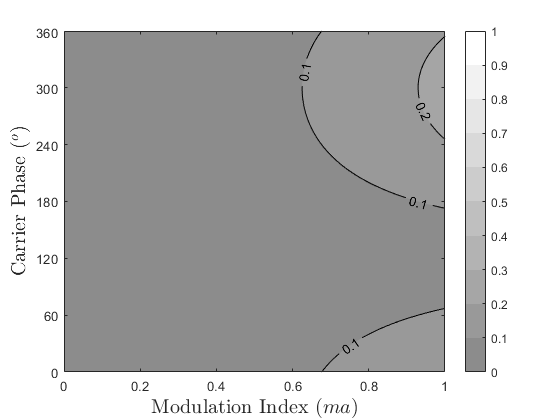
BLDC-whatever/Journal-Image/control_space_fl.png
