EnesAyaz/WPTMotor/BLDC-whatever/Journal-Image/control_space_fo.png

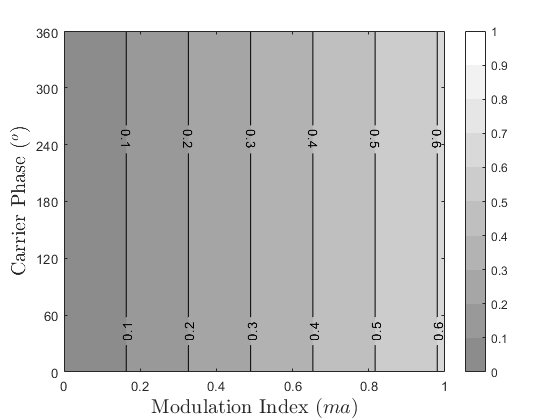
BLDC-whatever/Journal-Image/control_space_fo.png
