EnesAyaz/WPTMotor/BLDC-whatever/Journal-Image/control_space_fsw.png

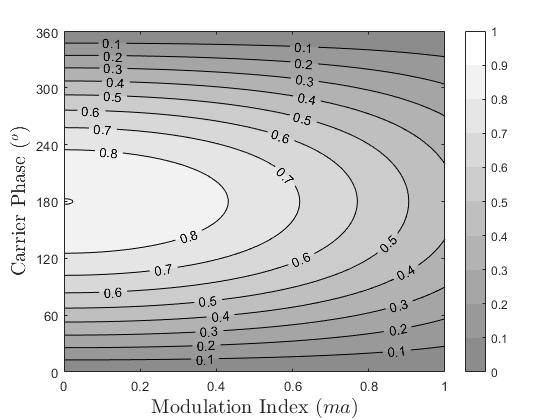
BLDC-whatever/Journal-Image/control_space_fsw.png
