EnesAyaz/WPTMotor/Journal-3-phase/Journal-Image/key_waveforms_with.png

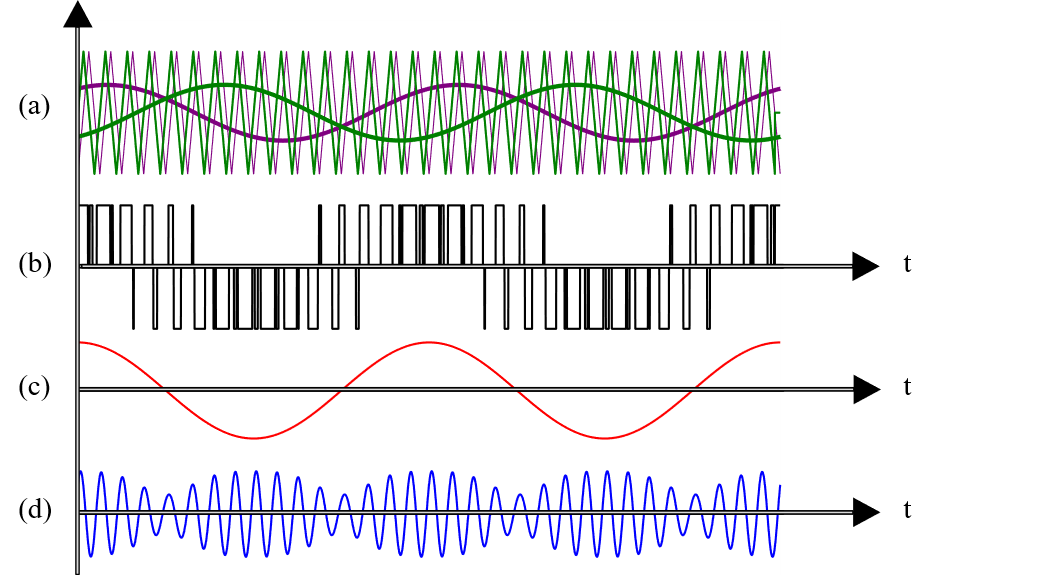
Journal-3-phase/Journal-Image/key_waveforms_with.png
