EnesAyaz/WPTMotor/Journal-3-phase/Journal-Image/key_waveforms_wout.png

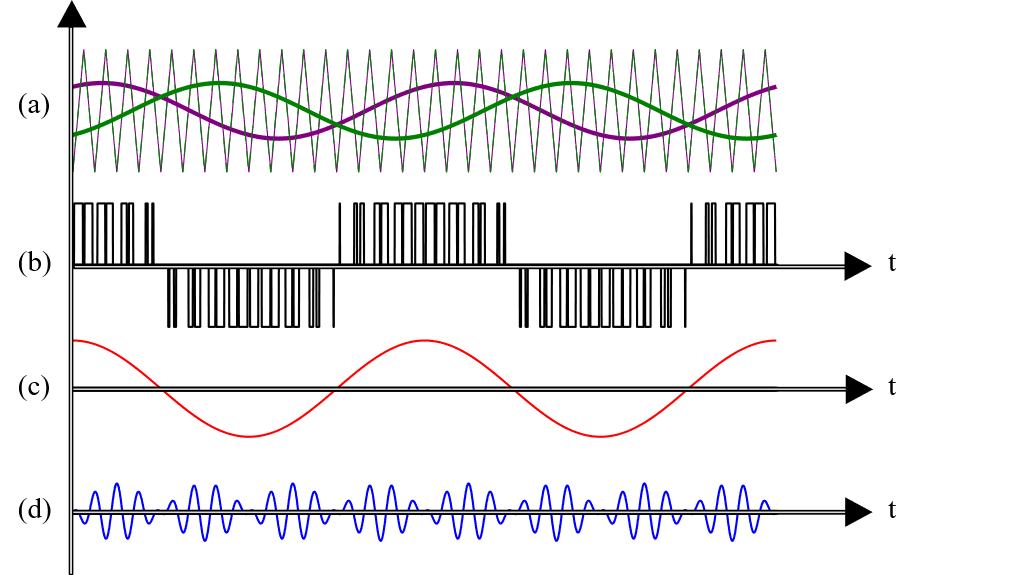
Journal-3-phase/Journal-Image/key_waveforms_wout.png
