EnesAyaz/WPTMotor/Journal-DC-Motor/v8.0/Soft-Switch/Spice-files/IPT-motor.png

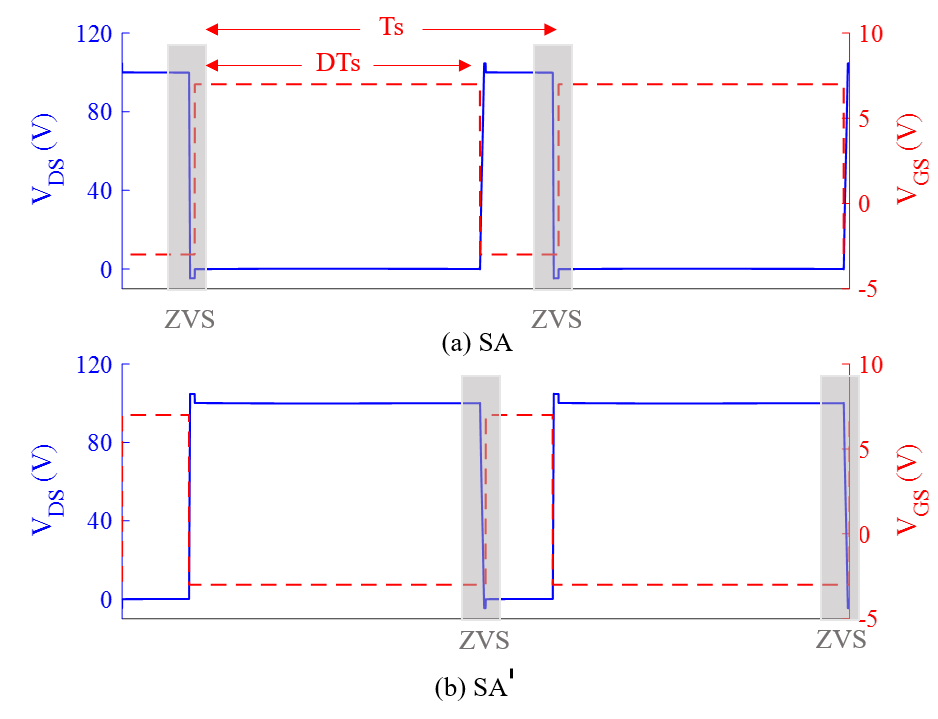
Journal-DC-Motor/v8.0/Soft-Switch/Spice-files/IPT-motor.png
