EnesAyaz/WPTMotor/Journal-DC-Motor/v8.0/Soft-Switch/Spice-files/motor-IPT.png

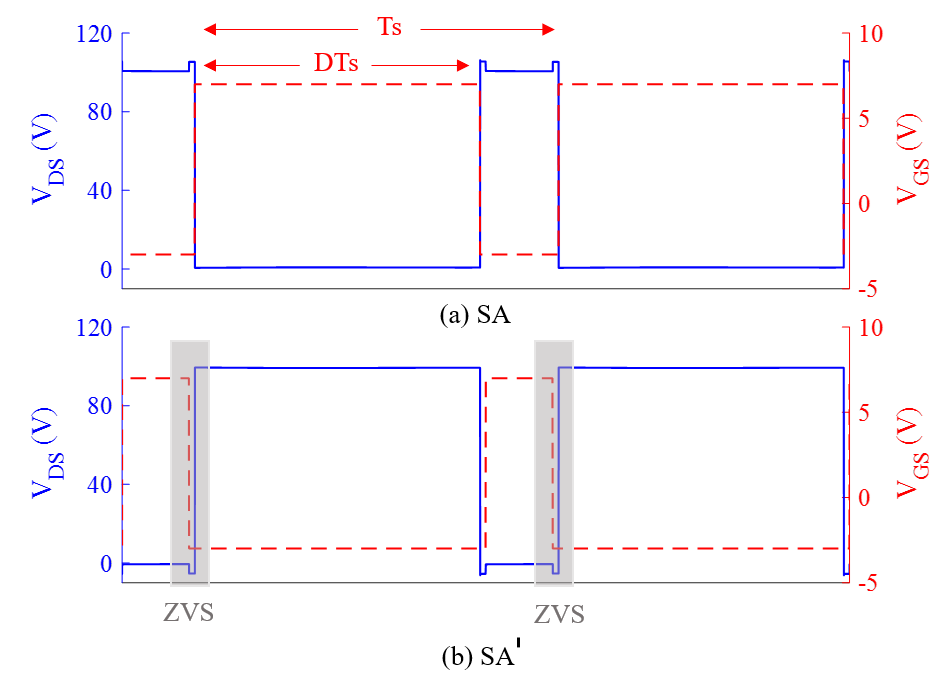
Journal-DC-Motor/v8.0/Soft-Switch/Spice-files/motor-IPT.png
