EnesAyaz/WPTMotor/Synhronous motor/TPEL-Journal-version-2/Mathematical Modelling/SPWM_carrier.png

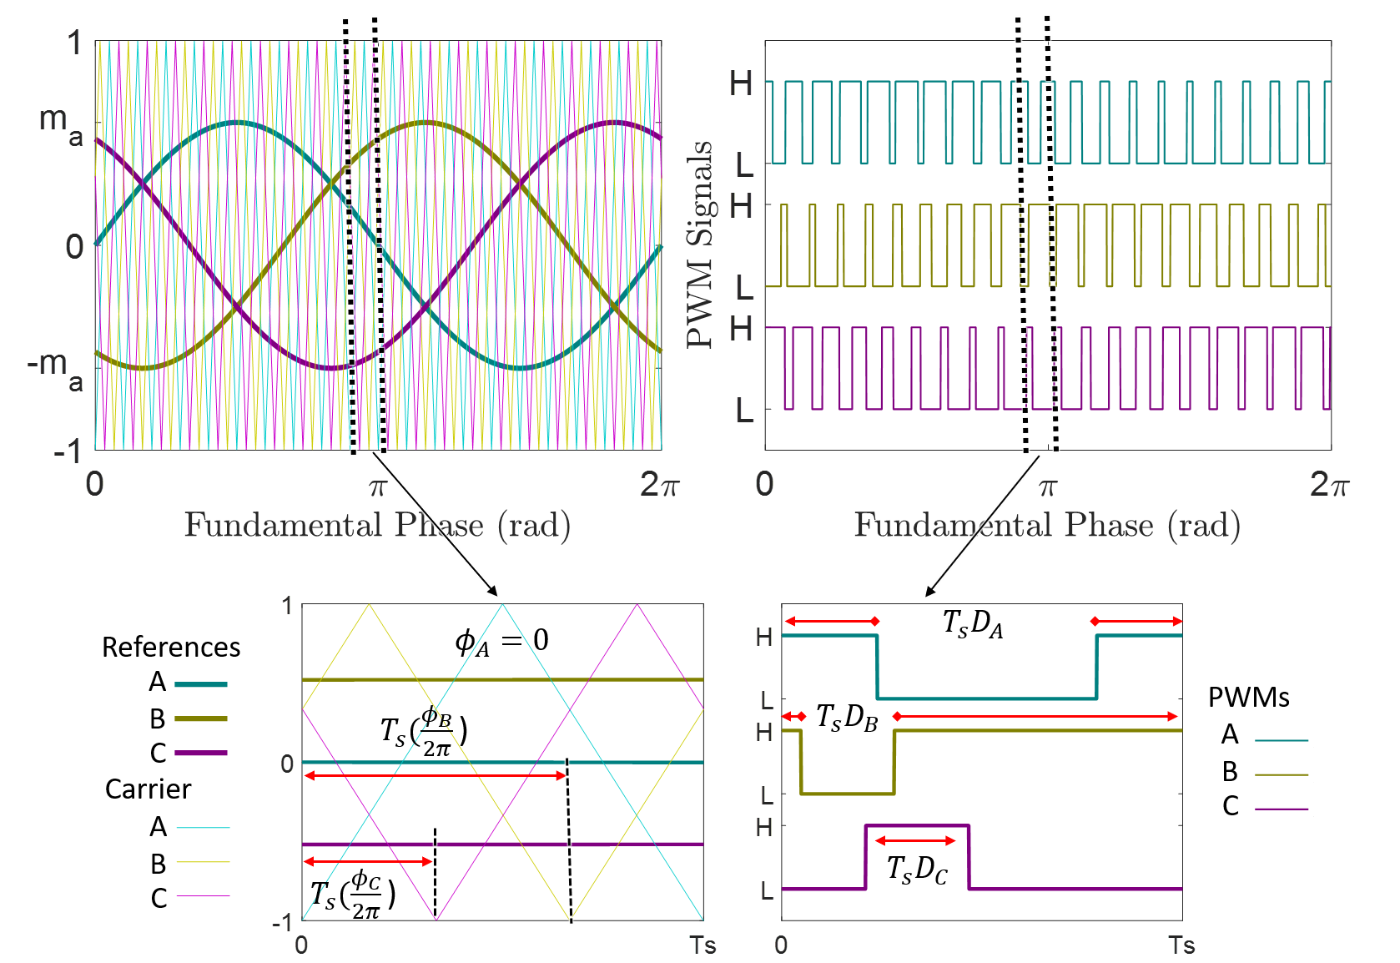
Synhronous motor/TPEL-Journal-version-2/Mathematical Modelling/SPWM_carrier.png
