EnesAyaz/WPTMotor/Synhronous motor/TPEL-Journal-version-2/Restriction/restriction.png

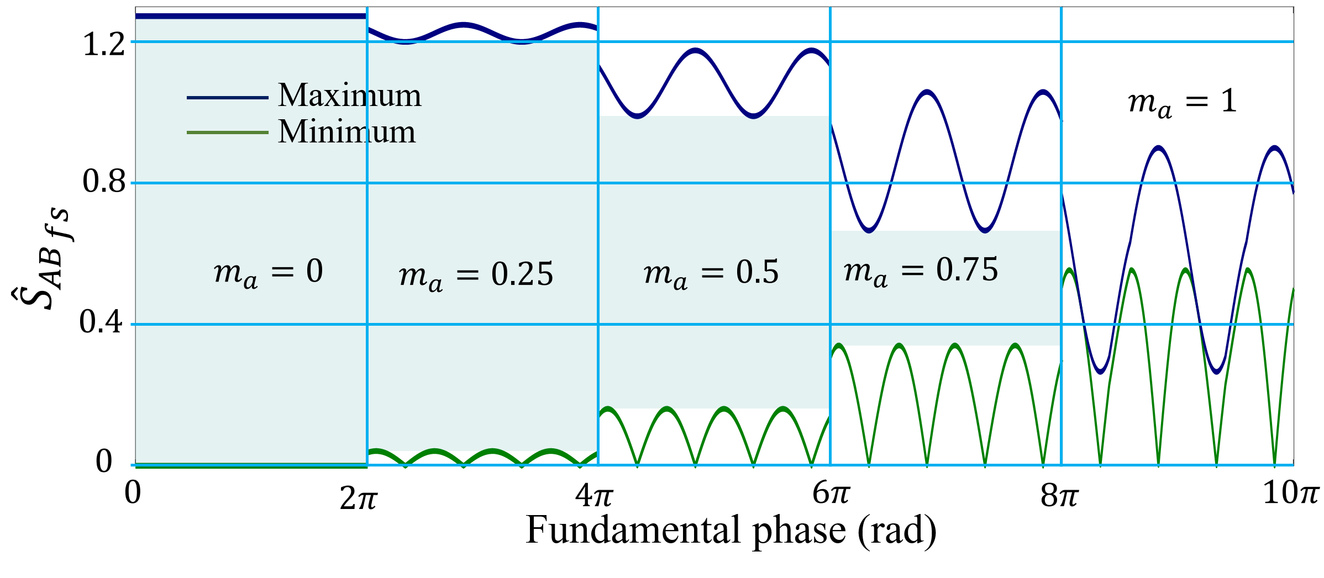
Synhronous motor/TPEL-Journal-version-2/Restriction/restriction.png
