EnesAyaz/WPTMotor/Synhronous motor/TPEL-Journal-version-2/Field Control/Controller3AC_v2.pdf

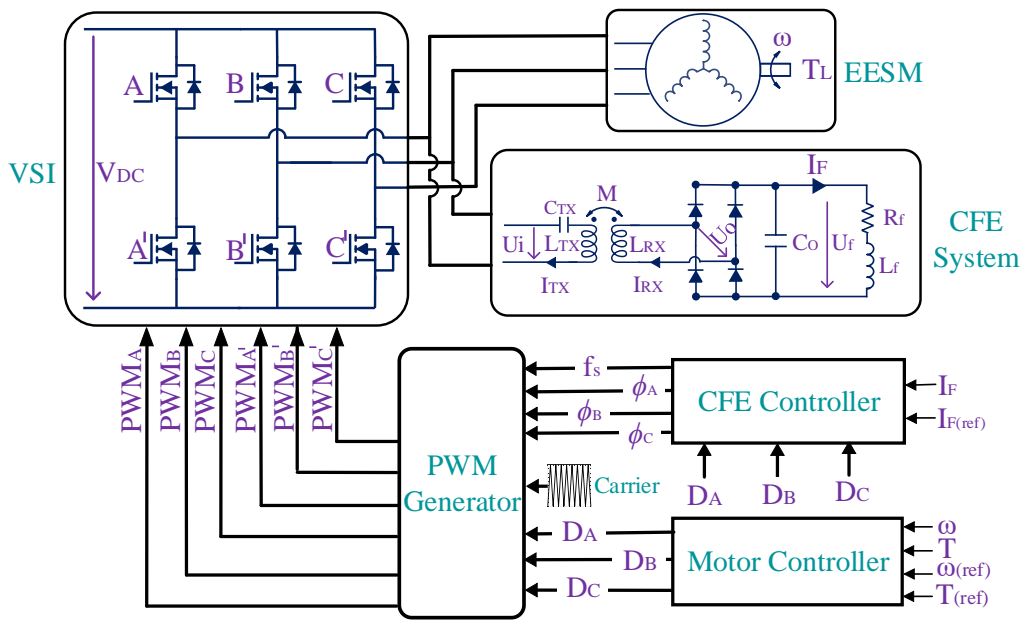
[picture p464: page 1]
PWM; TL EESM; VDC; CTX; IRX; LTX; LRX; ITX; CFE System; VSI; Motor Controller; IF(ref); ω(ref); T(ref); CFE Controller; PWM Generator; Carrier
