EnesAyaz/WPTMotor/Synhronous motor/TPEL-Journal-version-2/Introduction/combined_v2.pdf

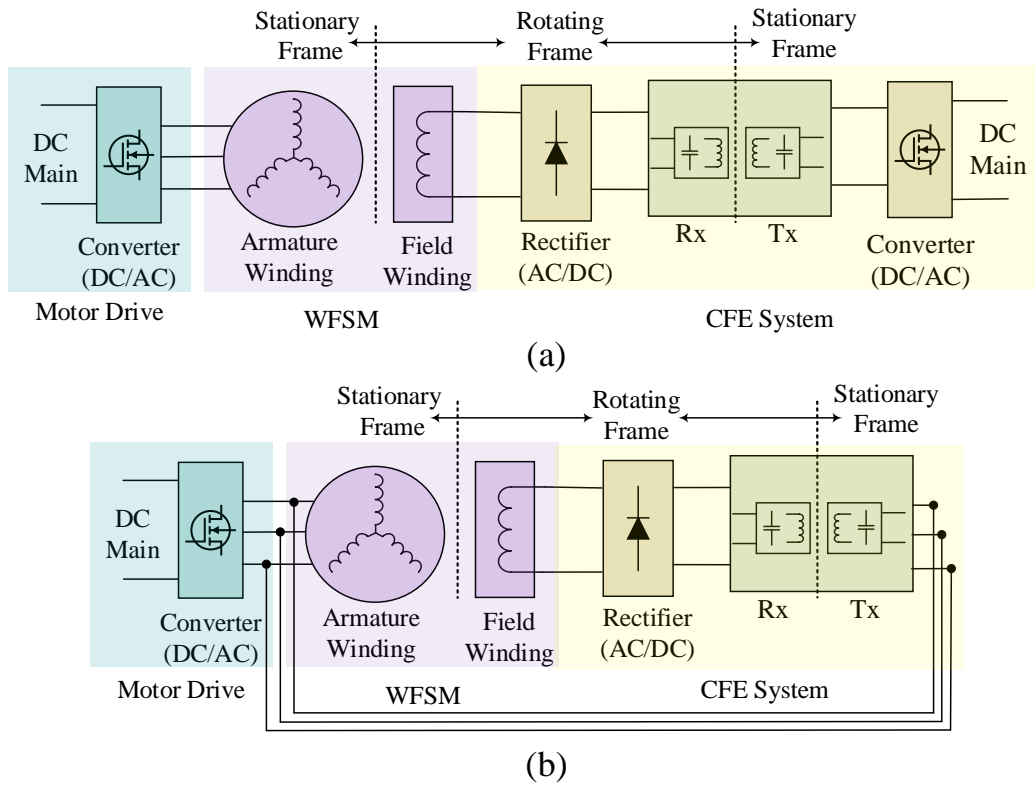
[picture p465: page 1]
Converter (DC/AC); CFE System; Field Winding; Rectifier (AC/DC); DC Main; WFSM; Armature Winding; Motor Drive; Stationary Frame; Rotating Frame
