EnesAyaz/WPTMotor/Synhronous motor/TPEL-Journal-version-2/System Structure/system_structure_v2.pdf

## EESM

TL

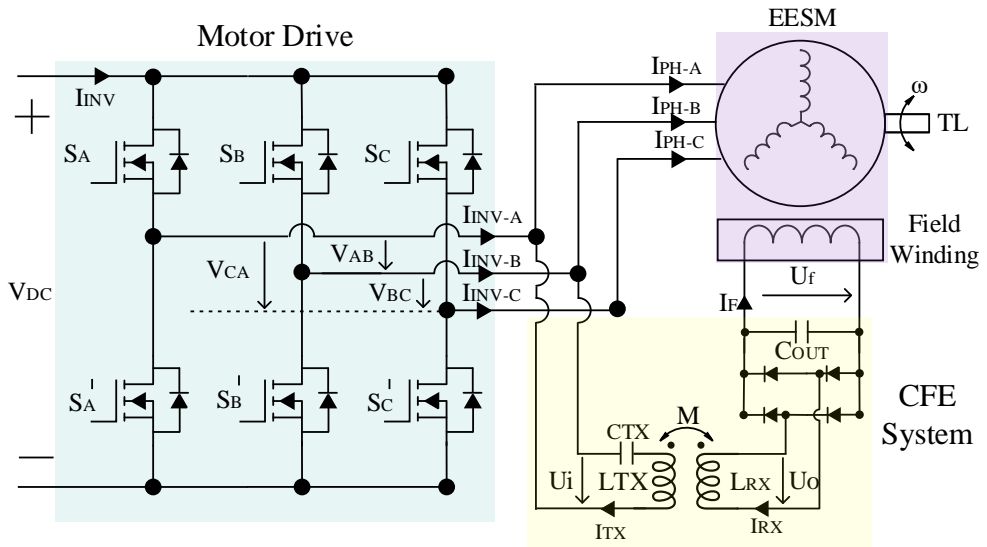
[picture p466: page 1]
VCA; IPH-A; IPH-C; IPH-B; VDC; VAB; VBC; IINV; IINV-A; IINV-B; IINV-C; COUT; CTX; IRX; LTX; LRX; ITX; CFE System; Motor Drive; Field Winding
