EnesAyaz/WPTMotor/Journal-3-phase/Major-Revision/Control Schemes/Controller3AC_v4.pdf

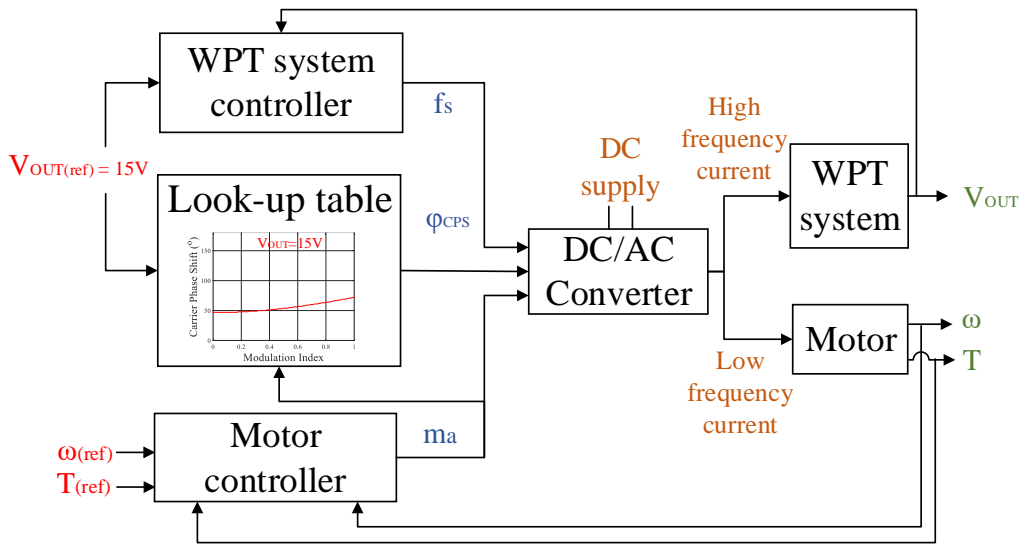
[picture p467: page 1]
WPT system controller; Motor controller; DC/AC Converter; WPT system; Motor; VOUT(ref) = 15V; ω(ref); T(ref); High frequency current; Low frequency current; φCPS; supply; VOUT; VOUT=15V

Look-up table
