EnesAyaz/WPTMotor/Journal-3-phase/Submission/Submission Files/WPT- 3- phase- Motor-Final Files/Controller3AC_v3.pdf

## φCPS fs

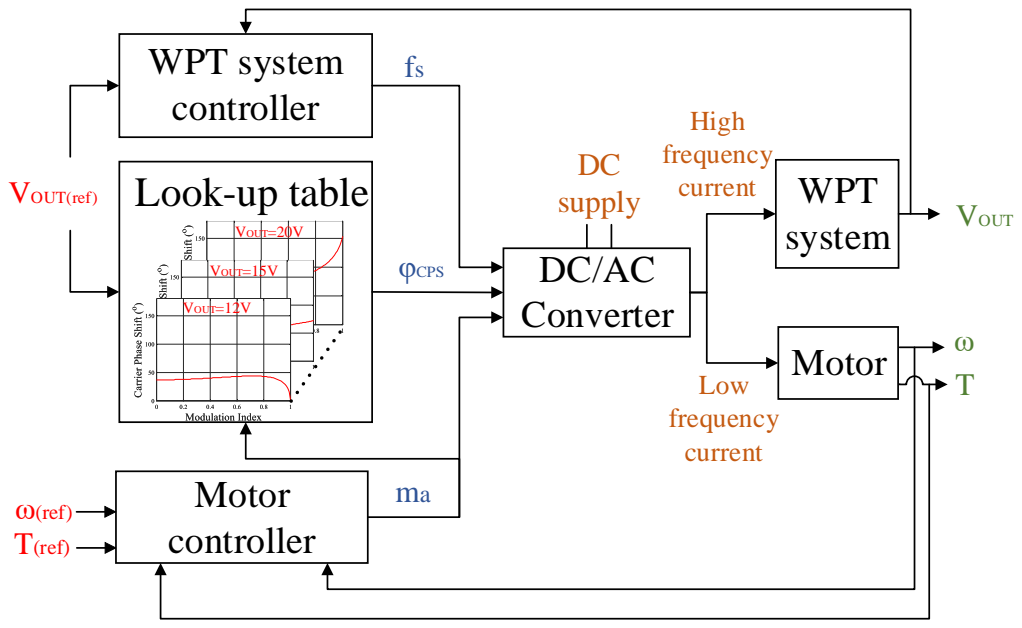
[picture p468: page 1]
Motor controller; DC/AC Converter; WPT system; Motor; High frequency current; Low frequency current; DC supply; VOUT ωT; VOUT=20V; VOUT=15V; Look; -up table

WPT system
controller
VOUT(ref) ω(ref) T(ref)

VOUT=12VVOUT=20V VOUT=15V VOUT=12V
