EnesAyaz/WPTMotor/Narrowband-Wideband/Drawings/system_proposal.pdf

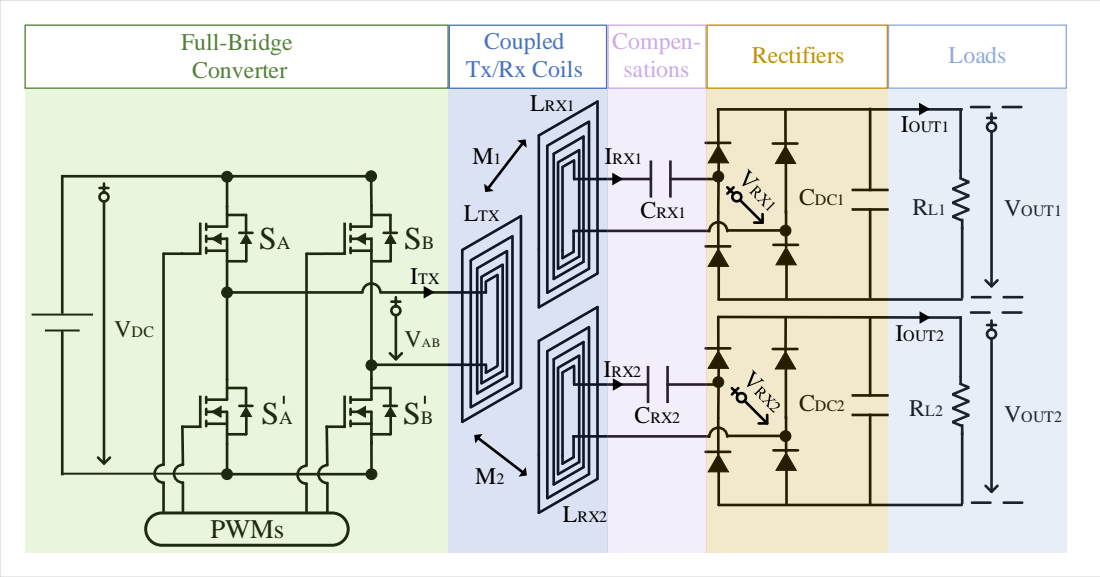
[picture p469: page 1]
VDC; VAB; PWMs; VOUT1; CDC1; VOUT2; CDC2; CRX1; CRX2; ITX; IRX1; IRX2; LRX1; LRX2; LTX; IOUT1; IOUT2; Full-Bridge Converter; Compen-; sations; Rectifiers; Loads

Coupled
Tx/Rx Coils
