EnesAyaz/WPTMotor/Journal-3-phase/Major-Revision/System Propossal/system_proposal_3VSC.pdf

## 3-Wire 3-Phase Inverter

## 3-Phase Motor

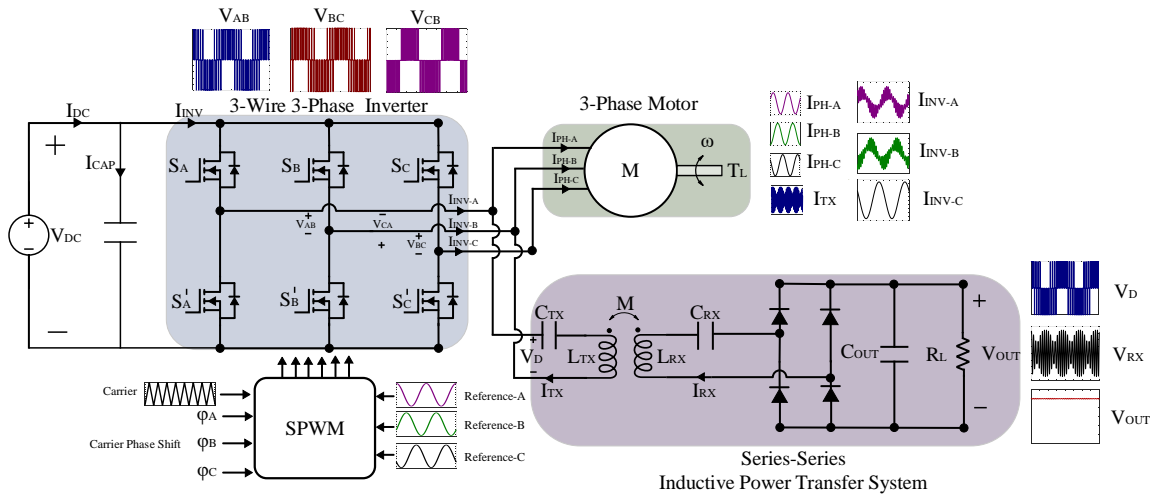
[picture p470: page 1]
VCA; Series-Series; CTX; CRX; LTX; LRX; IPH-A; IPH-C; IPH-B; ICAP; IDC; VDC; VAB; VBC; IINV; VOUT; ITX; IRX; SPWM; VRX; VCB; Reference-A; Reference-B; Reference-C; IINV-A; IINV-B; IINV-C; Carrier; COUT

Carrier Phase Shift

Inductive Power Transfer System
