EnesAyaz/WPTMotor/Thesis/Visio/chapter4/system_proposal_FB_v2.pdf

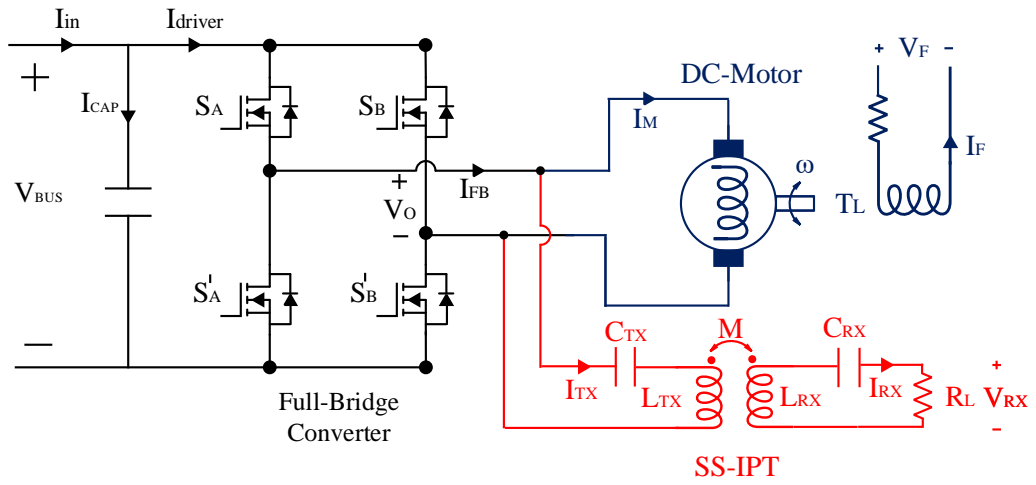
[picture p471: page 1]
DC-Motor; Full-Bridge Converter; SS-IPT; CTX; CRX; LTX; LRX; Idriver; IFB; ITX; ICAP; Iin; VBUS; IRX; VRX
