EnesAyaz/WPTMotor/Journal-3-phase/eski/System Proposal/system_proposal_3VSC2.pdf

# 3-Wire 3-Phase Inverter

# 3-Phase Motor

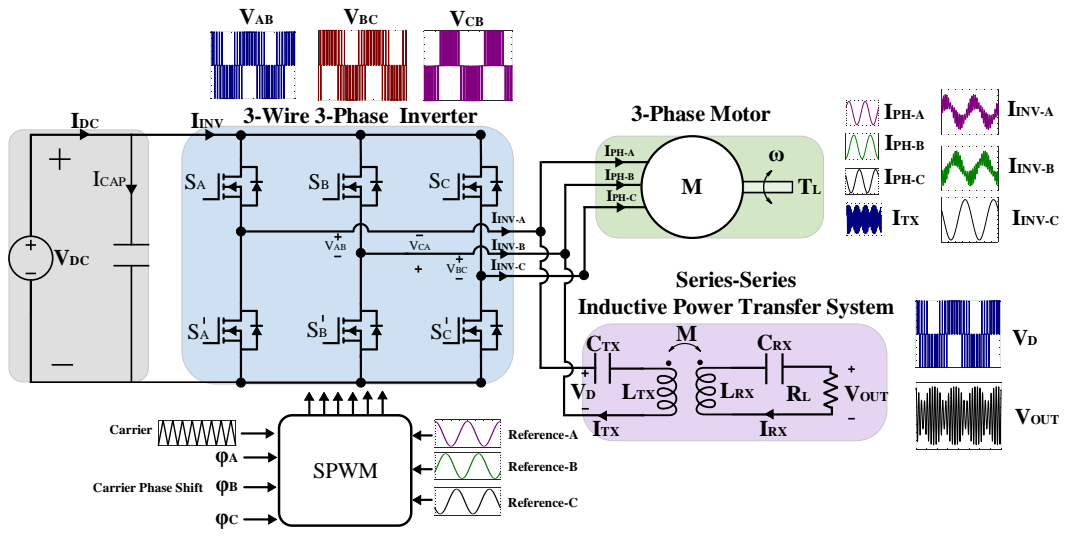
[picture p472: page 1]
VCA; Series-Series; CTX; CRX; LTX; LRX; IPH-A; IPH-C; IPH-B; ICAP; IDC; VDC; VAB; VBC; IINV; VOUT; ITX; IRX; SPWM; VCB; Reference-A; Reference-B; Reference-C; IINV-A; IINV-B; IINV-C; Carrier

Inductive Power Transfer System

Carrier Phase Shift
