EnesAyaz/WPTMotor/Journal-3-phase/eski/System Proposal/system_proposal_3VSC.pdf

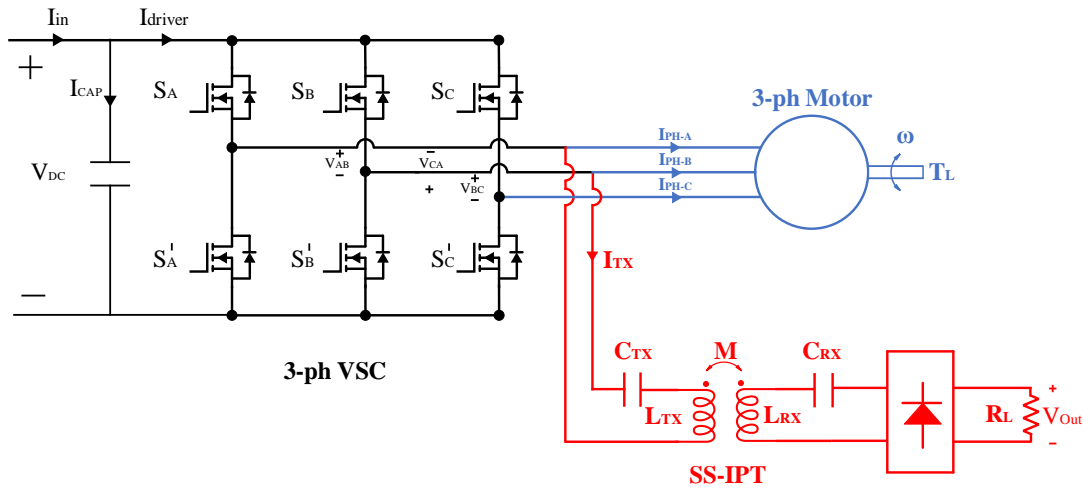
[picture p473: page 1]
VCA; 3-ph VSC; SS-IPT; CTX; CRX; LTX; LRX; 3-ph Motor; IPH-A; ITX; IPH-C; IPH-B; ICAP; Iin; VDC; VAB; VBC; Idriver; VOut
