EnesAyaz/WPTMotor/Journal-3-phase/Submission/Submission Files/WPT- 3- phase- Motor-Final Files/system_proposal_3VSC_v2.pdf

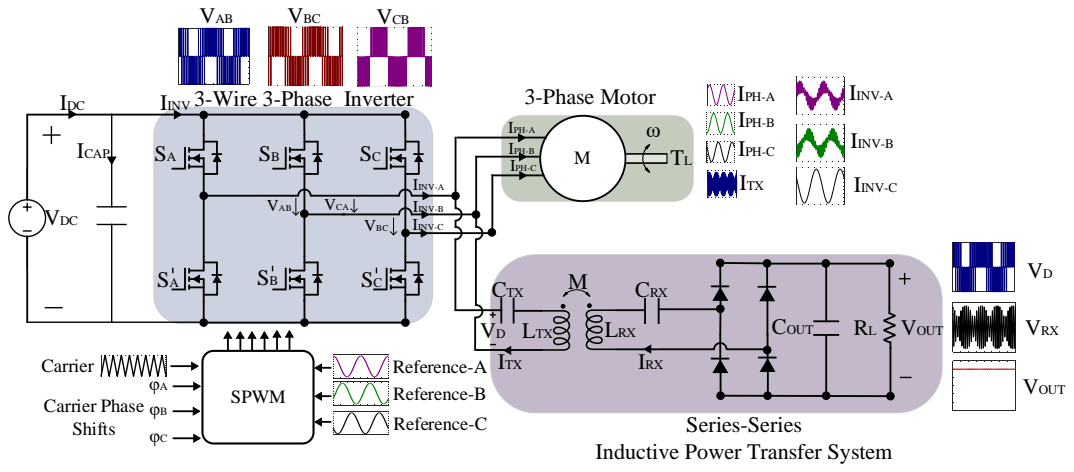
[picture p474: page 1]
VCA; Series-Series; CTX; CRX; LTX; LRX; 3-Phase Motor; IPH-A; IPH-C; IPH-B; ICAP; IDC; VDC; VAB; VBC; VOUT; ITX; IRX; SPWM; VRX; VCB; Carrier Phase Shifts; Reference-A; Reference-B; Reference-C; IINV-A; IINV-B; IINV-C; Carrier; COUT

3-Wire 3-Phase Inverter
IINV

Inductive Power Transfer System
