EnesAyaz/WPTMotor/Narrowband-Wideband/Drawings/SPWM.pdf

S

S

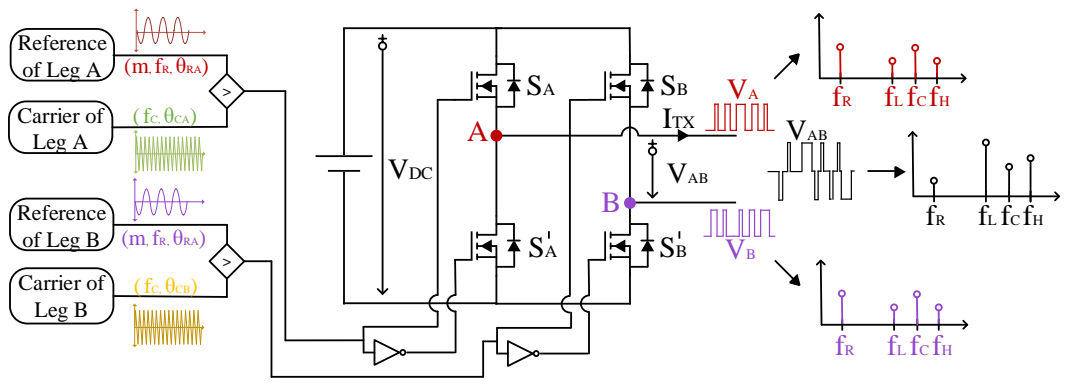
[picture p475: page 1]
VDC; VAB ITX; Reference of Leg A; Carrier of Leg A; θRA ); θCA ); Reference of Leg B; Carrier of Leg B; θCB; θRA; VAB
