EnesAyaz/WPTMotor/Synhronous motor/Visio/block_conventional_v2.pdf

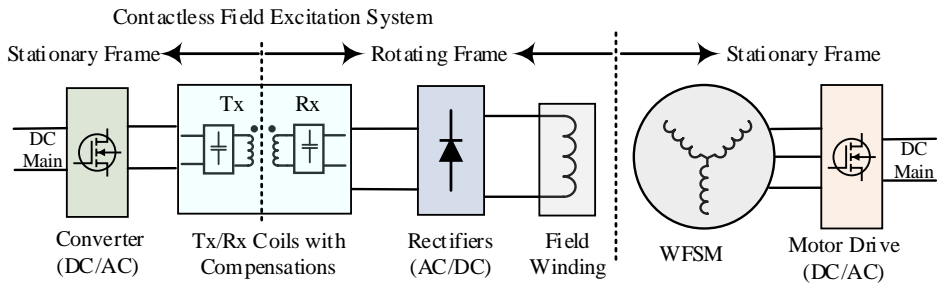
[picture p476: page 1]
Motor Drive (DC/AC); WFSM Field Winding; DC Main; Converter (DC/AC); Rectifiers (AC/DC); Stationary Frame; Rotating Frame

Contactless Field Excitation System

Tx/Rx Coils with
Compensations
