EnesAyaz/WPTMotor/Synhronous motor/Visio/Configurations.pdf

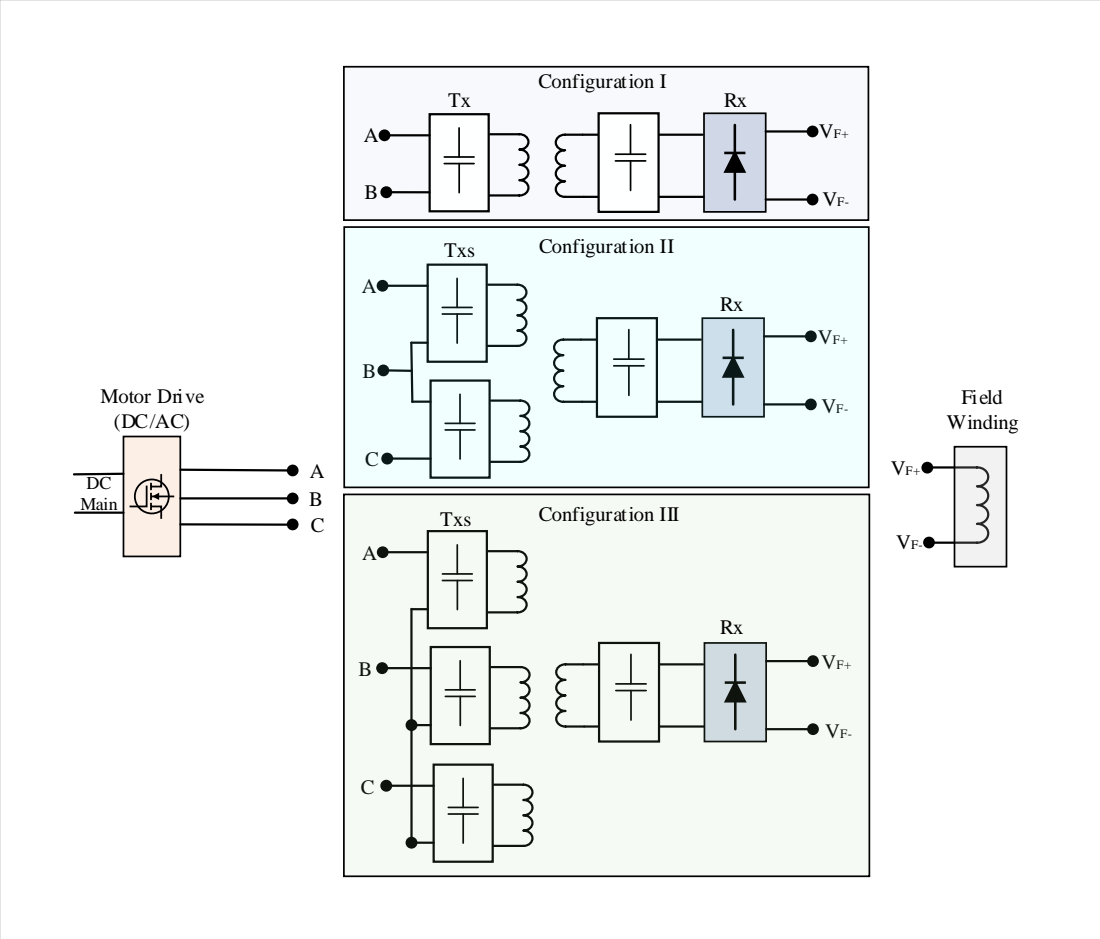
[picture p477: page 1]
Motor Drive (DC/AC); DC Main; Field Winding; Configuration I; Configuration II; Configuration III; Txs
