EnesAyaz/WPTMotor/Synhronous motor/Visio/block_conventional_combined.pdf

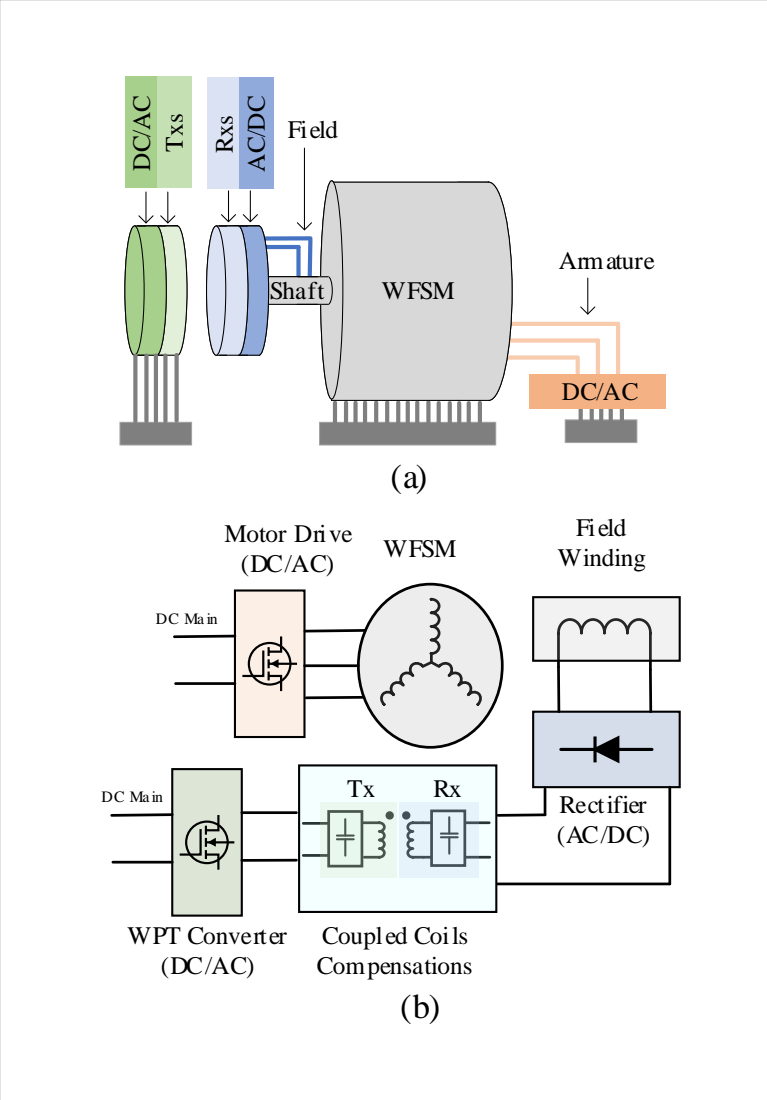
[picture p478: page 1]
Motor Drive; WFSM; Field Winding; WPT Converter (DC/AC); Coupled Coils Compensations; Rectifier (AC/DC); Txs; Rxs; Field; Armature; Shaft
