EnesAyaz/WPTMotor/Synhronous motor/Visio/proposed_block.pdf

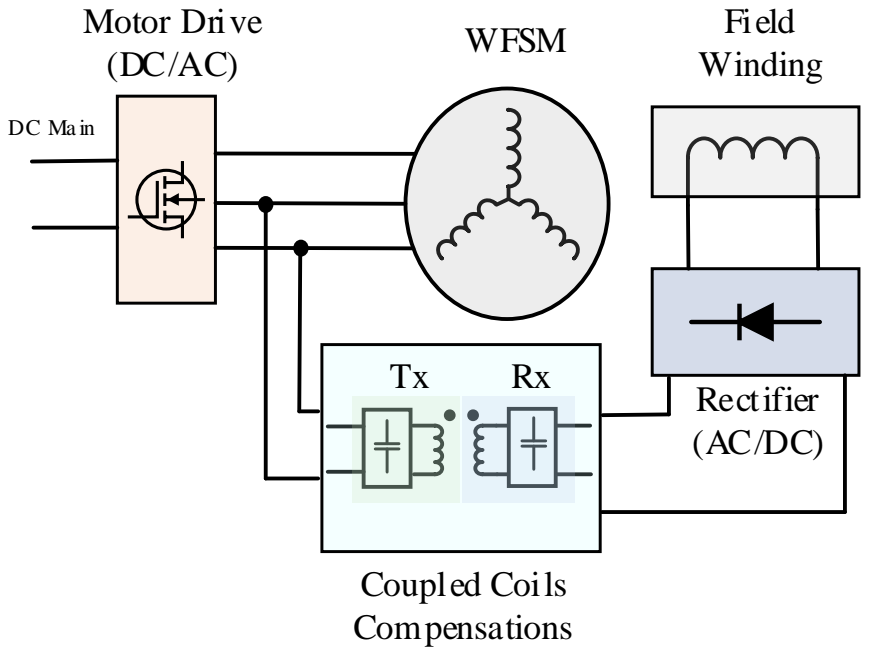
[picture p479: page 1]
Motor Drive; WFSM; Field; Winding; Coupled Coils Compensations; Rectifier (AC/DC)
