EnesAyaz/WPTMotor/Synhronous motor/Visio/WFSM_rep.pdf

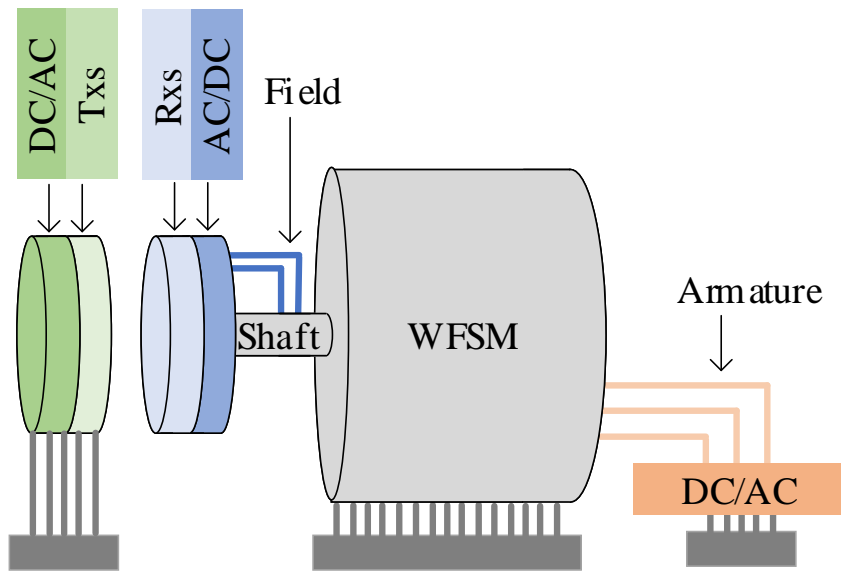
[picture p480: page 1]
Txs; Rxs; Field; Armature; Shaft; WFSM
