EnesAyaz/WPTMotor/Synhronous motor/TPEL-major-revision/Figures/Introduction/system_structure.pdf

### EESM

TL

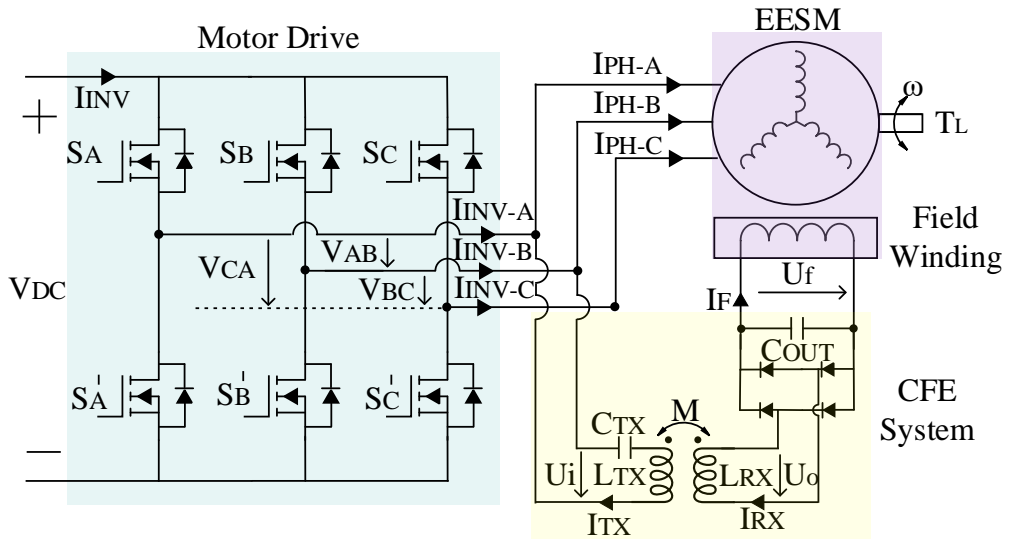
[picture p481: page 1]
VCA; IPH-A; IPH-C; IPH-B; VDC; VAB; VBC; IINV; IINV-A; COUT; CTX; IRX; LTX; LRX; ITX; CFE System; Motor Drive; Field Winding; IINV-B; IINV-C
