EnesAyaz/WPTMotor/Journal-3-phase/Submission/Submission Files/WPT- 3- phase- Motor-Final Files/FHA.pdf

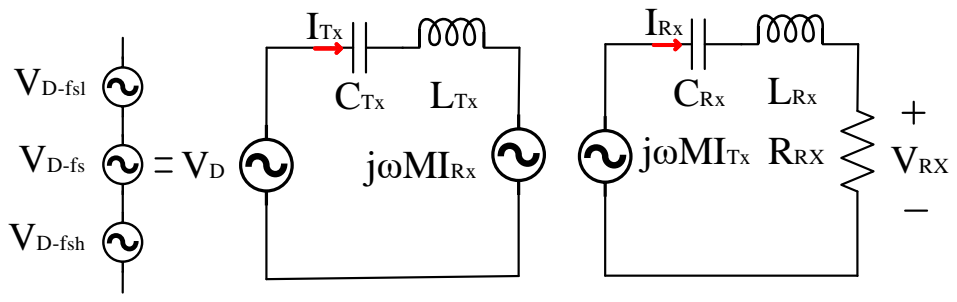
[picture p482: page 1]
VRX; jωMIRx CTx ITx; LTx; jωMITx CRx IRx; LRx; fsl; fsh
