EnesAyaz/WPTMotor/Journal-3-phase/v2/Visio/Figures/FHA2.pdf

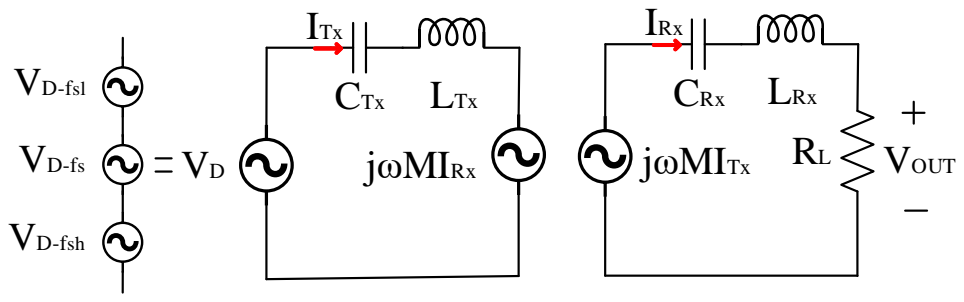
[picture p483: page 1]
VOUT; ωMIRx; CTx; ITx; LTx; LRx; fsl; fsh

ωMITx CRx IRx
