EnesAyaz/WPTMotor/Journal-3-phase/v2/Visio/Figures/FHA.pdf

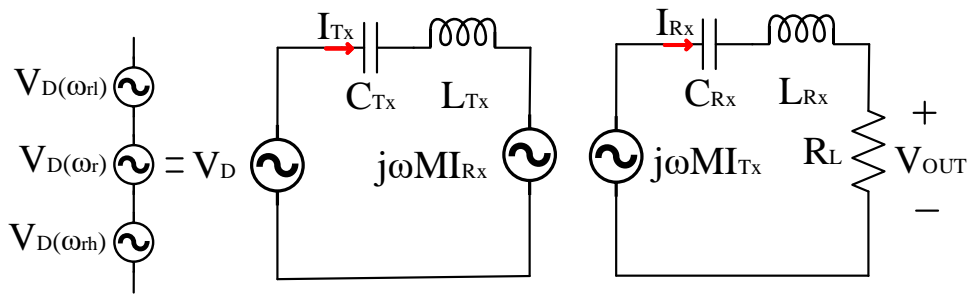
[picture p484: page 1]
VOUT; ωMIRx; CTx; ITx; LTx; LRx; ωrl ); ωrh )

ωMITx CRx IRx
