EnesAyaz/WPTMotor/Synhronous motor/TPEL-Journal-version-2/WPT-Design/FHA -SN - Copy.pdf

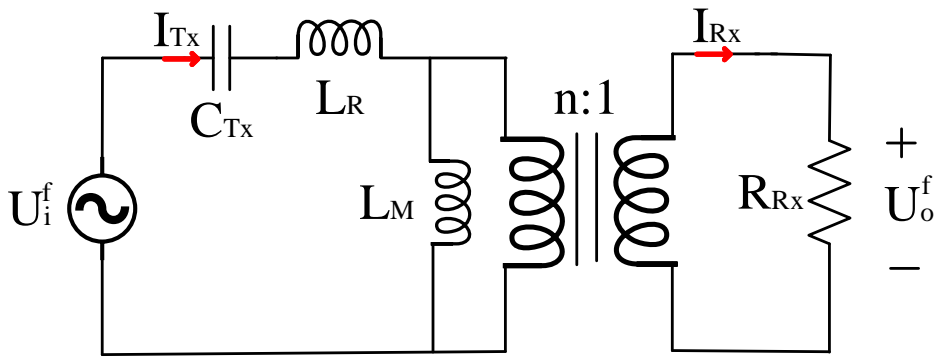
[picture p485: page 1]
CTx ITx; IRx LM
