EnesAyaz/WPTMotor/Thesis/Visio/chapter-2/FHA_SSIPT.pdf

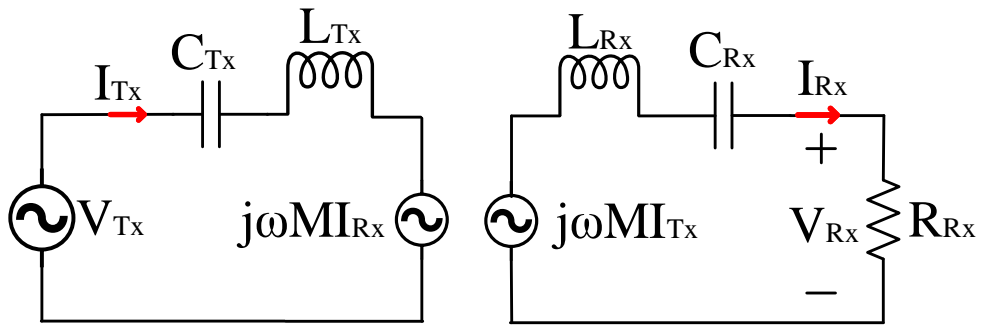
[picture p486: page 1]
jωMIRx; CTx ITx; LTx; jωMITx; RRx; LRx; CRx; IRx; VTx; VRx
