EnesAyaz/WPTMotor/Synhronous motor/TPEL-major-revision/Figures/control diagram/control_diagram.pdf

ω

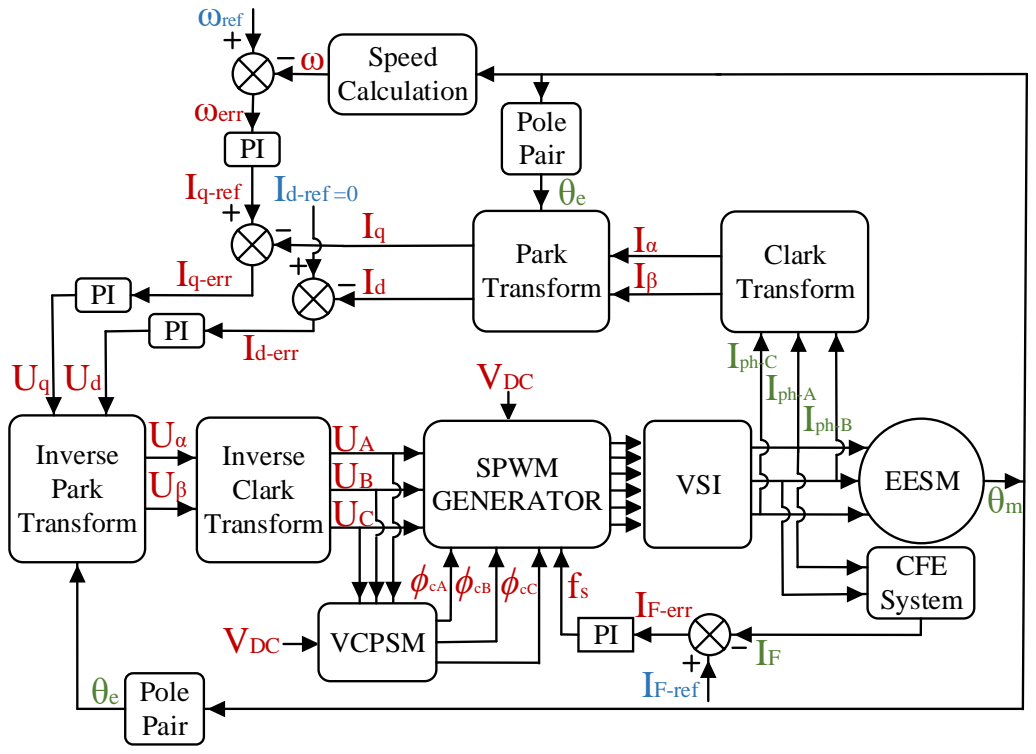
[picture p487: page 1]
Inverse Park Transform; Inverse Clark Transform; IF-ref; VCPSM; ϕcA; ϕcB; ϕcC; VSI; EESM; CFE System; Iph-A; Iph-C; Clark Transform; Park Transform; Id-ref =0; Speed Calculation; ωref; Iq-ref; VDC; ωerr; IF-err; Iq-err; Id-err; SPWM GENERATOR; Iph-B; Pole Pair; Pole Pair θe
