EnesAyaz/WPTMotor/Synhronous motor/TPEL-major-revision/Figures/WPT-diagram/FHA.pdf

k

LF

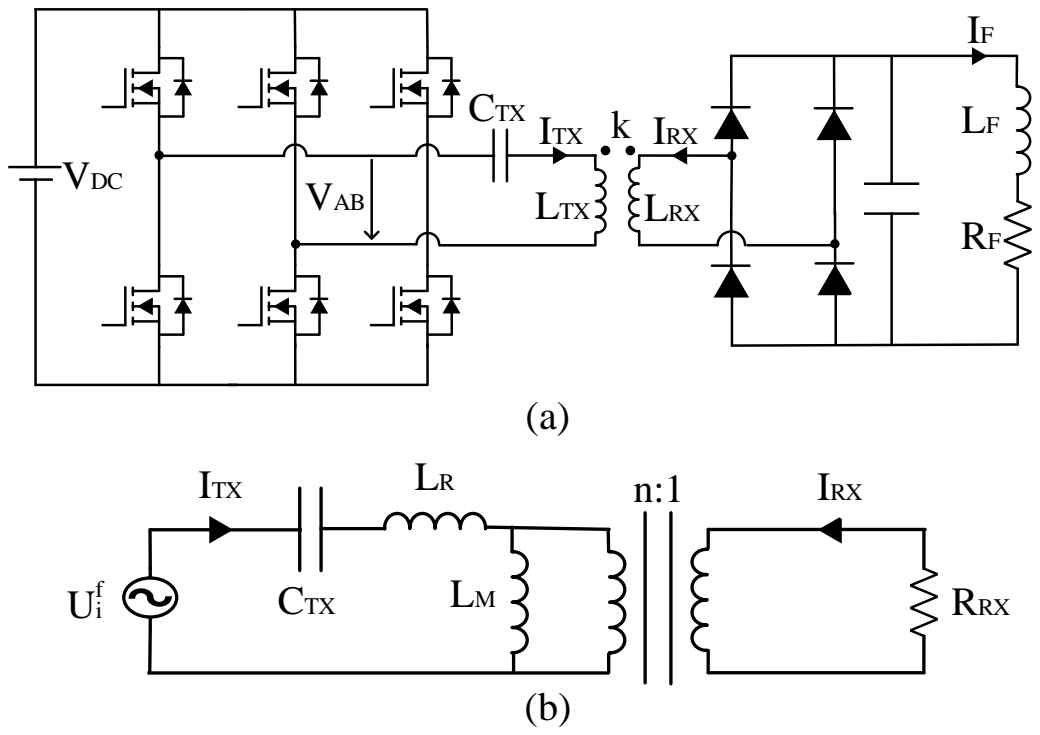
[picture p488: page 1]
VDC; VAB; CTX; LTX; LRX; ITX; IRX; RRX
