EnesAyaz/WPTMotor/Synhronous motor/TPEL-Journal/Introduction/block_conventional_v2.pdf

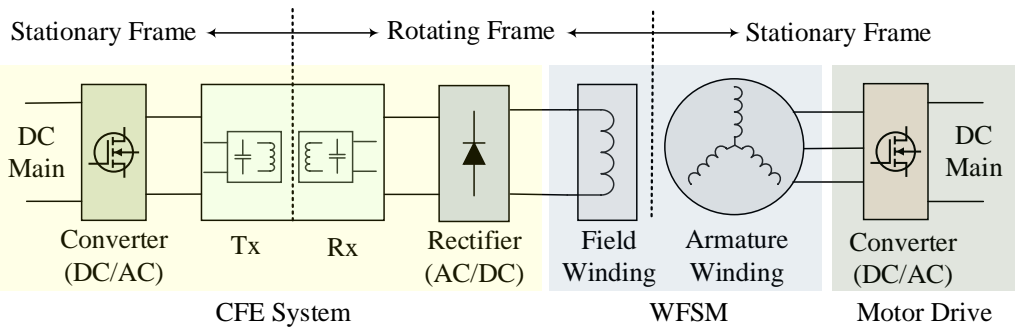
[picture p489: page 1]
Converter (DC/AC); CFE System; Field Winding; Rectifier (AC/DC); DC Main; Rotating Frame; Stationary Frame; WFSM; Armature Winding; Motor Drive
