EnesAyaz/WPTMotor/Synhronous motor/TPEL-Journal/Field Control/Controller3AC_v2.pdf

# IF(ref) ω(ref) T(ref)

## A DB DC ϕC-A ϕC-B ϕC-Cfs

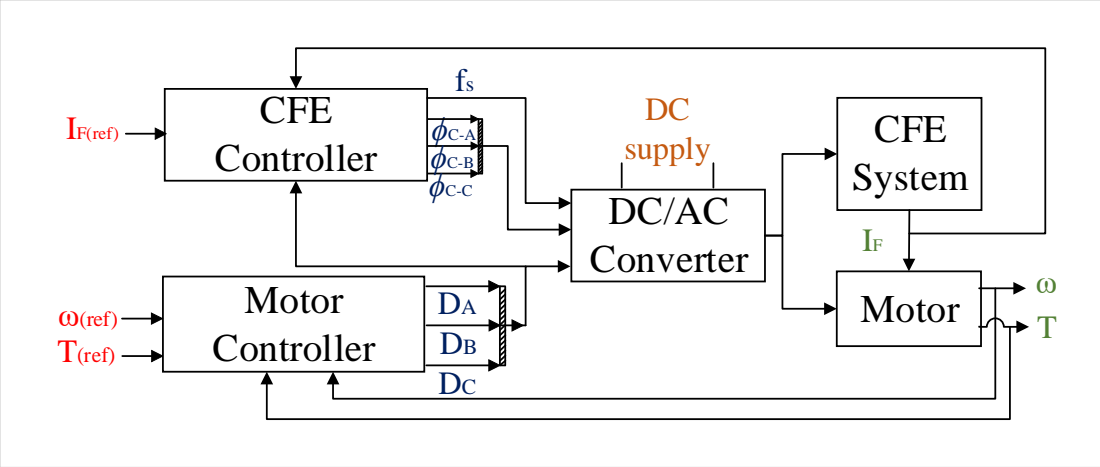
[picture p490: page 1]
Motor Controller; DC/AC Converter; CFE System; Motor; DC supply; CFE Controller
