EnesAyaz/WPTMotor/Journal-DC-Motor/v1.0/Introduction-figures/Conventional_IPT.pdf

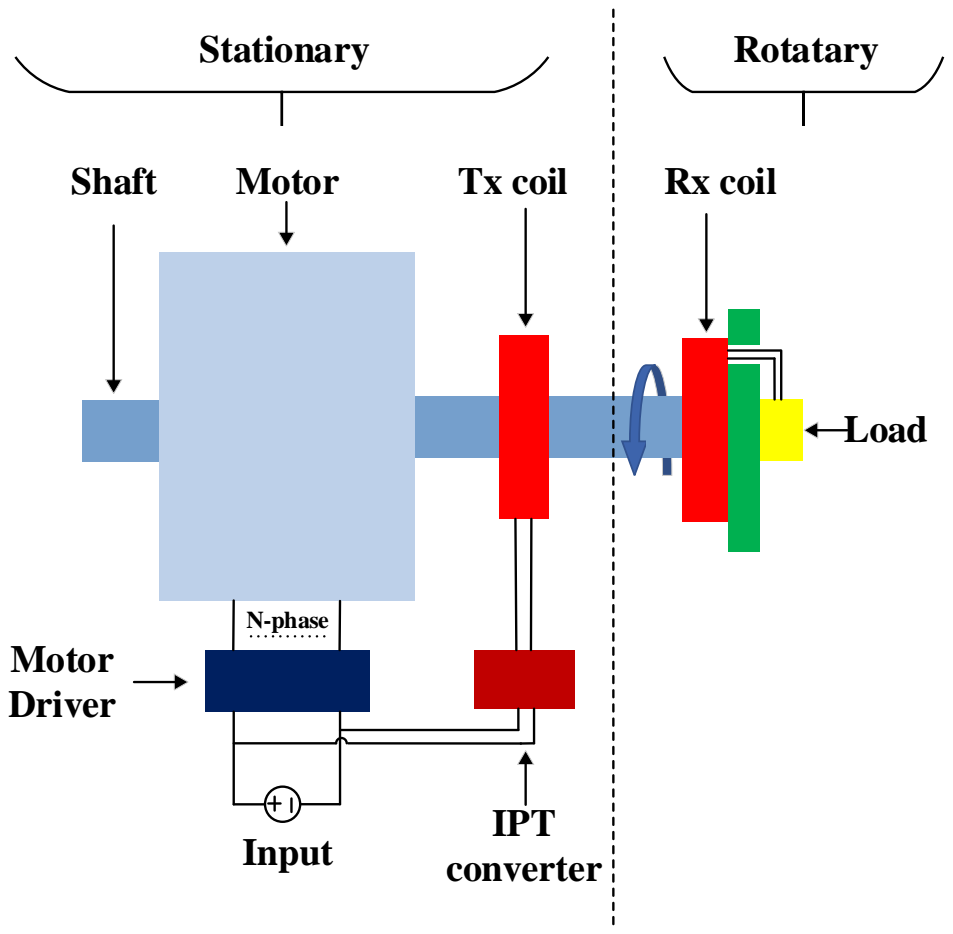
[picture p491: page 1]
Shaft; Motor; Tx coil; Rx coil; Load; IPT converter; Motor Driver; Input; Stationary; Rotatary; N-phase
