EnesAyaz/WPTMotor/Journal-DC-Motor/v1.0/Introduction-figures/Proposed_IPT.pdf

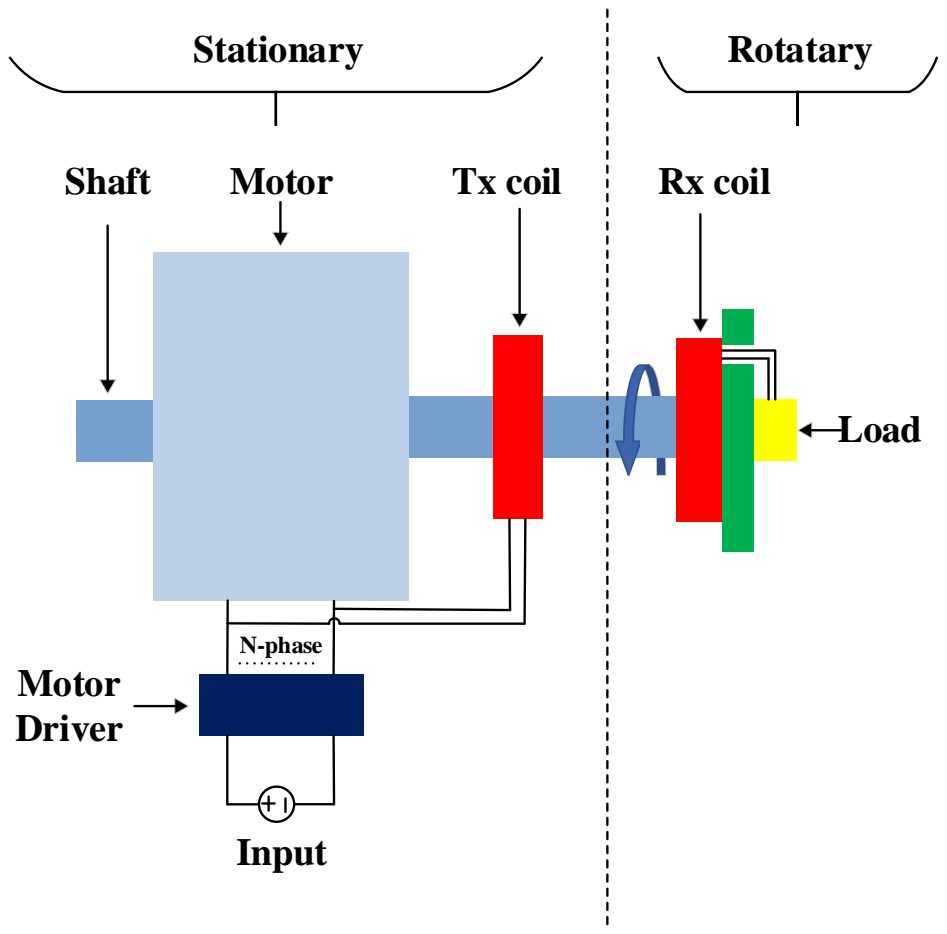
[picture p492: page 1]
Shaft; Motor; Tx coil; Rx coil; Load; Motor Driver; Input; Stationary; Rotatary; N-phase
