EnesAyaz/WPTMotor/Journal-DC-Motor/v1.0/Discussion/General-Structure_Embedded - Copy.pdf

# 3-Phase

SA

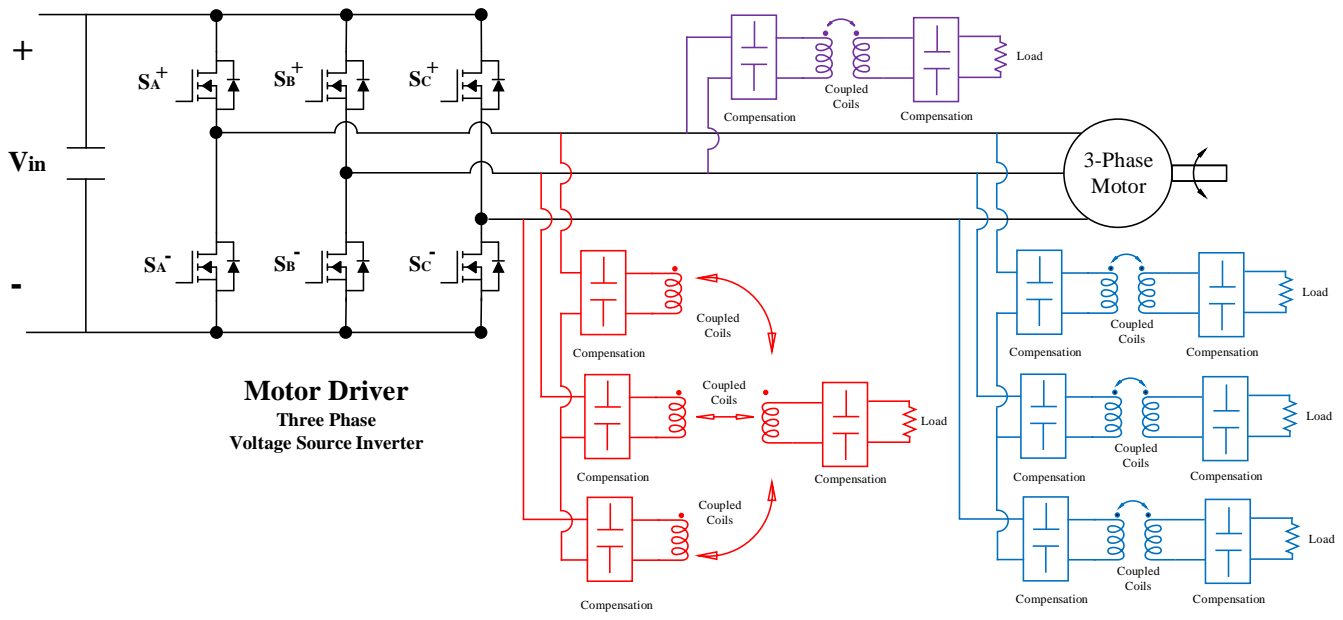
[picture p493: page 1]
Motor; Coupled Coils; Compensation; Load; Motor Driver; Vin

Three Phase
Voltage Source Inverter
