EnesAyaz/WPTMotor/Journal-DC-Motor/v1.0/Introduction-figures/Version-1/General-Structure.pdf

Motor | Motor

# Driver

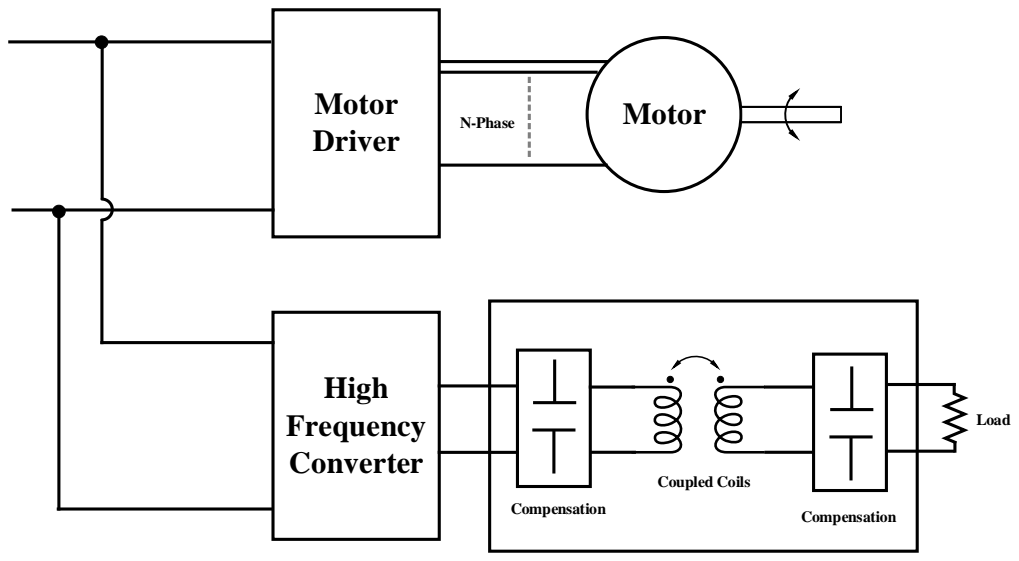
[picture p494: page 1]
High Frequency Converter; N-Phase; Coupled Coils; Compensation; Load
