EnesAyaz/WPTMotor/Journal-DC-Motor/v1.0/Introduction-figures/Version-1/General-Structure_Embedded.pdf

Motor | Motor

# Driver

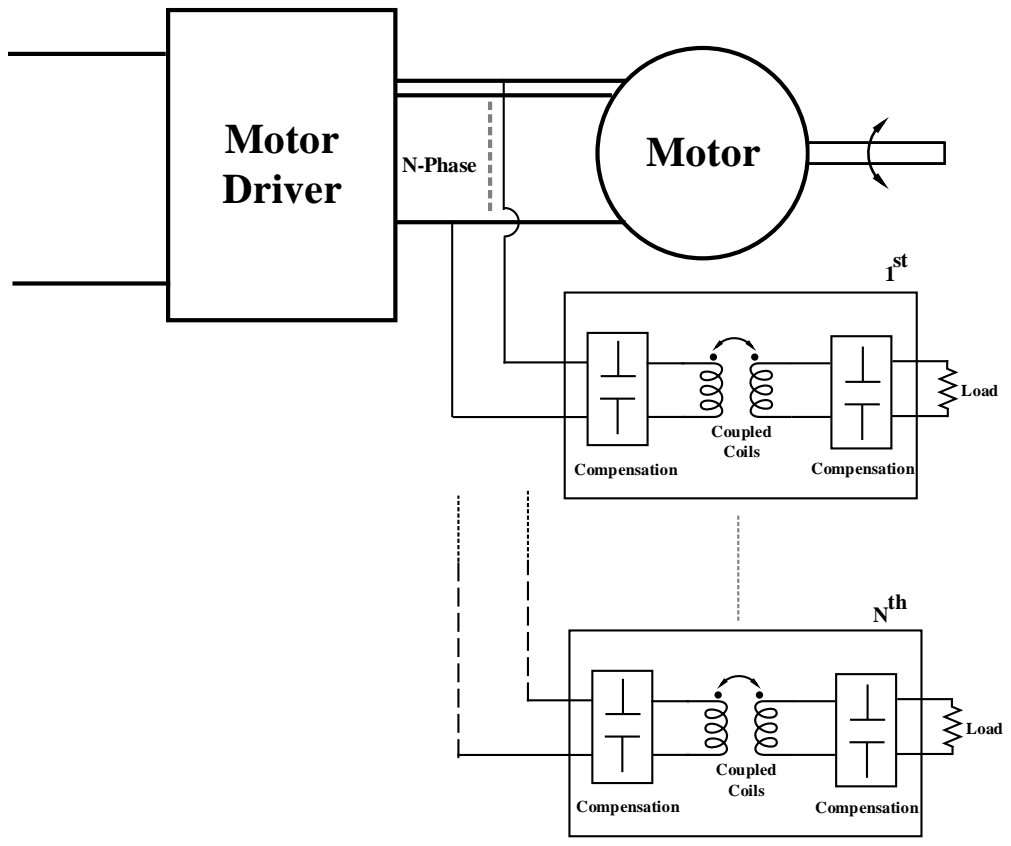
[picture p495: page 1]
N-Phase; Coupled Coils; Compensation; Load
