EnesAyaz/WPTMotor/Journal-DC-Motor/v6.0/Introduction-figures/Visio Drawings/pdf/Proposed_IPT_v4_IPT.pdf

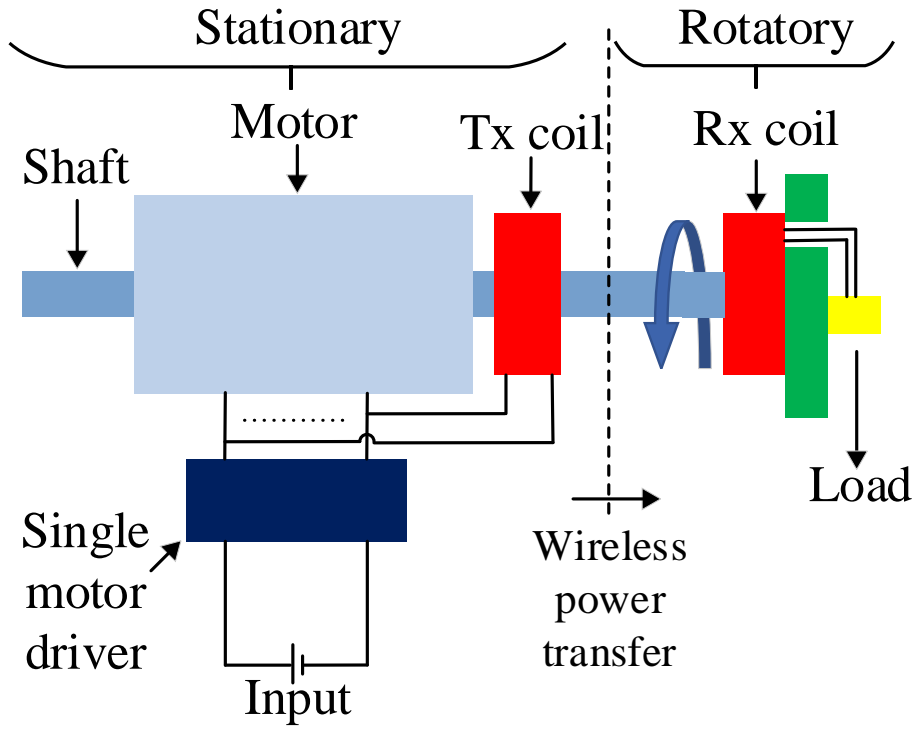
[picture p496: page 1]
Motor; Shaft; Tx coil; Load; Single motor driver; Input; Stationary; Rotatory; Rx coil; Wireless power transfer
