EnesAyaz/WPTMotor/Journal-DC-Motor/v4.0/Introduction-figures/Visio Drawings/pdf/Proposed_IPT_v4_IPT.pdf

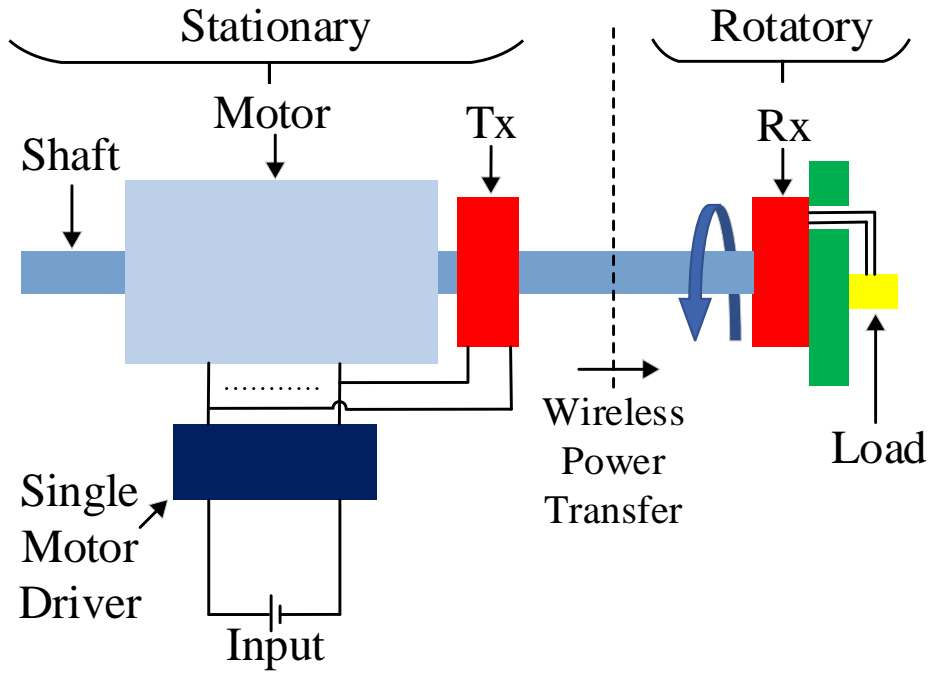
[picture p497: page 1]
Motor; Shaft; Load; Single Motor Driver; Input; Stationary; Rotatory; Wireless Power Transfer
