EnesAyaz/WPTMotor/Journal-DC-Motor/v3.0/Introduction-figures/Visio Drawings/pdf/Proposed_IPT_v2_Block_Diagram.pdf

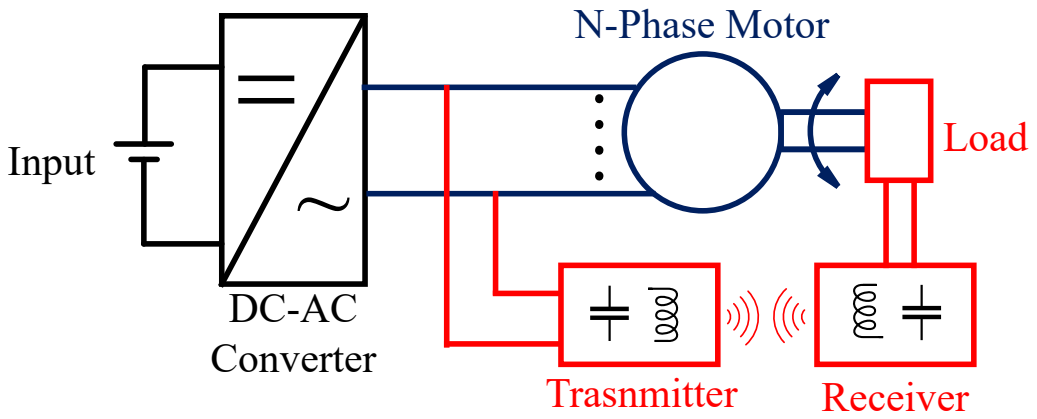
[picture p498: page 1]
Input; DC-AC Converter; Trasnmitter; Receiver; Load; N-Phase Motor
