EnesAyaz/WPTMotor/Test-Result/Experiment-Diary/frequency_domain.asc

C3: cap; {Cp}
C4: cap; {Cs}
Lp1: ind2; {Lp}
Ls1: ind2; {Ls}
R1: res; {R}
R2: res; 0.2
R3: res; 0.2
V1: voltage_us; SINE(0 18 {f}); AC 1
Named nets: 0
.param f=65k  
.param Lp=205u
.param Ls=51u
.param Cp 28n
.param Cs 115.6n
.param k= 0.396
.ac lin 24 42500 100000
.options gmin=1e-10   
.options abstol=1e-10  
.options reltol=0.003  
.options cshunt=1e-15
.param R 8.554
K1 Lp1 Ls1 {k}
