EnesAyaz/WPTMotor/Journal-3-phase/Major-Revision/Ltspice/Diode.asc

C8: cap; 5m
Cp: cap; {Cp}
Cs: cap; {Cs}
D1: diode
D2: diode
D3: diode
D4: diode
Lp: ind2; {Lp}
Ls: ind2; {Ls}
R1: res; 100k
R2: res; {RL}
R3: res; 0.1
R6: res; 0.2
Vin1: voltage_us; SINE(0 {mag_side} {fop1} 0 0 0); AC 1
Vin2: voltage_us; SINE(0 {mag_side} {fop2} 0 0 0); AC 1
Vin3: voltage_us; SINE(0 {mag_fsw} {fop} 0 0 {CPS}); AC 1
Vin4: voltage_us; SINE(0 {mag_side} {fop1} 0 0 {CPS1}); AC 1
Vin5: voltage_us; SINE(0 {mag_side} {fop2} 0 0 {CPS2}); AC 1
Vin: voltage_us; SINE(0 {mag_fsw} {fop}); AC 1
Named nets: 0, Vout+, Vout-
.tran 0 40m 10m 1e-7
.param Lp=200u
.param Ls=50u
.param Cp 29n
.param Cs 117n
.param RL 7.5
;ac lin 1000 100000 200000
.options gmin=1e-10   
.options abstol=1e-10  
.options reltol=0.003  
.options cshunt=1e-15
K1 Lp Ls 0.4
.param fop=82k
.param fop1=fop-100;
.param fop2=fop+100;
.param mag_side= 15;
.param mag_fsw = 30;
.param CPS =-58;
.param CPS1 = 120+CPS;
.param CPS2 = -120+CPS;
.ic V(C8)=18;
