EnesAyaz/WPTMotor/Journal-DC-Motor/v8.0/Soft-Switch/Spice-files/ZVS.asc

C1: cap; 80n
C2: cap; 20n
L1: ind; 0.001
L2: ind; 10µ
L3: ind; 160µ
L4: ind; 40µ
R1: res; 5
R2: res; 8
R3: res; 0.001
U1: GaN_LTspice_GS66506T_L1V4P2
U2: GaN_LTspice_GS66506T_L1V4P2
U3: GaN_LTspice_GS66506T_L1V4P2
U4: GaN_LTspice_GS66506T_L1V4P2
V1: voltage_us; PULSE(-3 7 0.0000025 1e-9 1e-9 0.0000098 0.0000125)
V2: voltage_us; PULSE(-3 7 0 1e-9 1e-9 0.0000023 0.0000125)
V3: voltage; 100
V4: voltage_us; PULSE(-3 7 0 1e-9 1e-9 0.0000023 0.0000125)
V5: voltage_us; PULSE(-3 7 0.0000025 1e-9 1e-9 0.0000098 0.0000125)
Named nets: 0, VGAp, VGA, VSA, VDA
.tran 0 0.002 0 1e-8
