EnesAyaz/WPTMotor/Synhronous motor/System-Design/LTspice/Frequency_domain_SN.asc

Cp: cap; {Cp}
Lp: ind2; {Lp}
Ls: ind2; {Ls}
R1: res; 100k
R2: res; {RL}
R3: res; 0.2
R4: res; 0.2
Vin: voltage_us; SINE(0 44 {fop}); AC 1
Named nets: 0, Vout+, Vout-
;tran 0 1.1m 1m 1e-7
.param Lp=1500u
.param Ls=7.5u
.param Cp=6n
.param RL 1
;step param RL 0.6 4 0.2
;step param k 0.5 0.8  0.1
.param k 0.58
.ac lin 1000 4000 120000
.options gmin=1e-10   
.options abstol=1e-10  
.options reltol=0.003  
.options cshunt=1e-15
K1 Lp Ls {k}
.param fop=49k
