EnesAyaz/WPTMotor/Synhronous motor/System-Design/LTspice/Diode_SN.asc

C8: cap; 20µ
Cp: cap; {Cp}
D1: diode
D2: diode
D3: diode
D4: diode
L1: ind; 1e-3
Lp: ind2; {Lp}
Ls: ind2; {Ls}
R1: res; 100k
R2: res; {RL}
R3: res; 0.1
R6: res; 0.2
Vin: voltage_us; SINE(0 56.5 {fop}); AC 1
Named nets: 0, Vout+, Vout-
.tran 0 20.5m 20m 1e-7
.param Lp=1530u
.param Ls=8.5u
.param Cp 5.2n
.param RL 1.2
;ac lin 1000 100000 200000
.options gmin=1e-10   
.options abstol=1e-10  
.options reltol=0.003  
.options cshunt=1e-15
K1 Lp Ls 0.37
.param fop=60k
