EnesAyaz/WPTMotor/Synhronous motor/System-Design/LTspice/Frequency_domain.asc

Cp: cap; {Cp}
Cs: cap; {Cs}
Lp: ind2; {Lp}
Ls: ind2; {Ls}
R1: res; 100k
R2: res; {RL}
R3: res; 0.1
R6: res; 0.2
Vin: voltage_us; SINE(0 200 {fop}); AC 1
Named nets: 0, Vout+, Vout-
;tran 0 1.1m 1m 1e-7
.param Lp=763u
.param Ls=14u
.param Cp 0.0241u
.param Cs 1.32u
.param RL 0.81
.ac lin 1000 30000 70000
.options gmin=1e-10   
.options abstol=1e-10  
.options reltol=0.003  
.options cshunt=1e-15
K1 Lp Ls 0.45
.param fop=49k
