EnesAyaz/WPTMotor/Synhronous motor/System-Design/LTspice/three_coil_frequency.asc

C1: cap; {Cr}
C2: cap; {Cp}
C3: cap; {Cs}
C4: cap; {Cs}
C5: cap; {Cs}
C6: cap; {Cp}
C7: cap; {Cs}
Lp1: ind2; {Lp}
Lp2: ind2; {Lp}
LR: ind2; {Lr}
Ls1: ind2; {Ls}
Ls2: ind2; {Ls}
Ls3: ind2; {Ls}
Ls4: ind2; {Ls}
R1: res; 10000
R2: res; {RL}
R3: res; 0.1
R4: res; 0.1
R5: res; 0.2
R6: res; 0.2
R7: res; 10000
R8: res; 10000
R9: res; 0.1
R10: res; {RL}
R11: res; 10000
R12: res; 0.1
R13: res; {RL}
R14: res; 10000
R15: res; 0.1
R16: res; {RL}
R17: res; 10000
V1: voltage_us; SINE(0 127 {fop1}); AC 1
V2: voltage_us; SINE(0 127 {fop1}); AC 1
Named nets: 0
;tran 0 2m 0 1e-7
.param f1=150k
.param f2=150k
.param Lp=74.5u
.param Lr=74u
.param Ls=25.5u
.param Cr 14n
.param Cp14n
.param Cs 1/(4*pi*pi*f2*f2*Ls)
.param RL 32
.ac lin 1000 100000 200000
.param fop1 150k
.options gmin=1e-10   
.options abstol=1e-10  
.options reltol=0.003  
.options cshunt=1e-15
K1 Lp2 LR 0.23
K2 Lp1 LR 0.23
K4 LR Ls1 0.41
K6 LR Ls2 0.41
K7 LR Ls3 0.41
K8 LR Ls4 0.41
