EnesAyaz/WPTMotor/Thesis/Simulation/matlab-CH2/ZVS/1P1S_PulseExcited_ZVS_Realistic.asc

C1: cap; .1µ
C2: cap; .1µ
C3: cap; 11n
C4: cap; 11n
D1: schottky; 1N5819
D2: diode
D3: diode
D4: schottky; 1N5819
D5: diode
D6: diode
L1: ind2; 50µ
L2: ind2; 50µ
Q1: nmos; BSC320N20NS3
Q2: nmos; BSC320N20NS3
Q3: nmos; BSC320N20NS3
Q4: nmos; BSC320N20NS3
R1: res; 10
R2: res; 1
R3: res; 10
R4: res; 1
R5: res; 10
R6: res; 10
R7: res; 10
R8: res; 10
R9: res; 1
R10: res; 20
R13: res; 10000
R14: res; 5
R15: res; 5
R16: res; 5
R17: res; 5
R18: res; 0.001
R19: res; 0.001
U1: LTC4444
U2: LTC4444
V1: voltage; PULSE(0 5 2.5u 10n 10n 2.45u 5u)
V2: voltage; PULSE(0 5 0 10n 10n 2.45u 5u)
V3: voltage; PULSE(0 5 0 10n 10n 2.45u 5u)
V4: voltage; PULSE(0 5 2.5u 10n 10n 2.45u 5u)
V5: voltage; 15
V6: voltage; 100
V7: voltage; PULSE(0 15 2.5u 10n 10n 2u 5u)
V8: voltage; PULSE(0 15 0 10n 10n 2u 5u)
V9: voltage; PULSE(0 15 0 10n 10n 2u 5u)
V10: voltage; PULSE(0 15 2.5u 10n 10n 2u 5u)
Named nets: 0, 15V, Vin
.tran 200u startup
K1 L1 L2 0.1
