EnesAyaz/WPTMotor/Thesis/Simulation/matlab-CH2/Bifurcation/Frequency_domain.asc

Cp: cap; {Cp}
Cs: cap; {Cs}
Lp: ind2; {Lp}
Ls: ind2; {Ls}
R1: res; 100k
R2: res; {RL}
R3: res; 0.1
R6: res; 0.2
Vin: voltage_us; SINE(0 200 {fop}); AC 1
Named nets: 0, Vout+, Vout-
;tran 0 1.1m 1m 1e-7
.param Lp=82u
.param Ls=68u
.param Cp 13.7n
.param Cs 16.55n
.ac lin 1000 100000 300000
.options gmin=1e-10   
.options abstol=1e-10  
.options reltol=0.003  
.options cshunt=1e-15
K1 Lp Ls {k}
.param fop=49k
.step param RL 4 16 2
;param RL 16
;step param k 0.1 0.3 0.05
.param k 0.10
