EnesAyaz/WPTMotor/Simulations/MATLAB-SIMULINK/Series-none design/LTspice/frequency_domain.asc

C3: cap; {Cp}
Lp1: ind2; {Lp}
Ls1: ind2; {Ls}
R1: res; {R}
R2: res; 0.2
R3: res; 0.2
V1: voltage_us; SINE(0 18 {f}); AC 1
Named nets: 0
.param f=80k  
.param Lp=317u
.param Ls=30u
.param Cp 35n
.param k= 0.80
.ac lin 1000 70000 90000
.options gmin=1e-10   
.options abstol=1e-10  
.options reltol=0.003  
.options cshunt=1e-15
.step param R  51 201 150
K1 Lp1 Ls1 {k}
.param R = 14.8
