EnesAyaz/WPTMotor/Simulations/MATLAB-SIMULINK/Series-none design/LTspice/time_domain.asc

C3: cap; {Cp}
Lp1: ind2; {Lp}
Ls1: ind2; {Ls}
R1: res; {R}
V1: voltage_us; SINE(0 100 {fop}); AC 1
Named nets: 0
.param f=80k  
.param Lp=160u
.param Ls=100u
.param Cp 70n
.param k= 0.80
.param fop=79k
.options gmin=1e-10   
.options abstol=1e-10  
.options reltol=0.003  
.options cshunt=1e-15
.param R=50
K1 Lp1 Ls1 {k}
.tran 0.01
