EnesAyaz/WPTMotor/Simulations/MATLAB-SIMULINK/3-Phase-Modelling/New_models/Spice/1p2s-design.asc

C3: cap; {Cp}
Lp1: ind2; {Lp}
Ls1: ind2; {Ls}
R1: res; {R}
V1: voltage_us; SINE(0 18 {f}); AC 1
Named nets: 0
.param f=80k  
.param Lp=60u
.param Ls= 60u
.param Cp 65n
.param Cs 16n
.param k= 0.4
.ac lin 1000 60000 100000
.options gmin=1e-10   
.options abstol=1e-10  
.options reltol=0.003  
.options cshunt=1e-15
.param R  10
K1 Lp1 Ls1 {k}
