EnesAyaz/WPTMotor/Field-Excitation/LTSpice/1Tx-1RX.asc

C1: cap; {Cs}
C2: cap; {Cp}
D1: diode
D2: diode
D3: diode
D4: diode
L1: ind; {Lr}
Lp1: ind2; {Lp}
Ls1: ind2; {Ls}
R1: res; 0.1
R2: res; {R}
R3: res; 10k
R: res; {R}
V2: voltage_us; SINE(0 200 {fop1}); AC 1
Named nets: 0
;tran 0 2m 0 1e-8
.param f1=80k  
.param Ls=60u
.param Lp=1m
.param Lr=1m
.param Cp  1/(4*pi*pi*f1*f1*Lp)
.param Cs  1/(4*pi*pi*f1*f1*Ls)
.param k=0.27
.param R 100
.ac lin 1000 10000 600000
.param fop1= {f1}
.options gmin=1e-10   
.options abstol=1e-10  
.options reltol=0.003  
.options cshunt=1e-15
K1 Lp1 Ls1 {k}
