EnesAyaz/WPTMotor/Narrowband-Wideband/LTSpice-Simulation/1Tx2Rx_sine.asc

C1: cap; {Cs2}
C4: cap; {Cs1}
Lp1: ind2; {Lp}
Ls1: ind2; {Ls}
Ls2: ind2; {Ls}
R1: res; 0.1
R2: res; 5
R5: res; 5
V1: voltage_us; SINE(0 25.72 {fop1}); AC 1
Named nets: 0
;tran 0 2m 0 1e-8
.param f1=80k  
.param f2=160k  
.param Ls=50u
.param Lp=50u
.param Cp1  1/(4*pi*pi*f1*f1*Lp)
.param Cs1  1/(4*pi*pi*f1*f1*Ls)
.param Cs2  1/(4*pi*pi*f2*f2*Ls)
.param k1=0.22
.param k2=0.21
.ac lin 1000 40000 300000
.param fop1= {f1}
.options gmin=1e-10   
.options abstol=1e-10  
.options reltol=0.003  
.options cshunt=1e-15
K1 Lp1 Ls1 {k1}
K2 Lp1 Ls2 {k2}
