EnesAyaz/WPTMotor/Simulations/LTSPICE/Bifurcation/frequency - Copy.asc

Cp: cap; {Cp}
Cs: cap; {Cs}
Lp: ind2; {Lp}
Ls: ind2; {Ls}
R1: res; 100k
R2: res; {RL}
R3: res; 0.1
R6: res; 0.2
Vin: voltage_us; SINE(0 67 {fop}); AC 1
Named nets: 0, Vout+, Vout-
;tran 0 5.1m 5m 1e-7
.param Lp=196.9u
.param Ls=46.8u
.param Cp 27.5n
.param Cs 122.2n
.ac lin 1000 10000 200000
.options gmin=1e-10   
.options abstol=1e-10  
.options reltol=0.003  
.options cshunt=1e-15
K1 Lp Ls 0.8
.param fop=82k
.param fop1=fop-100;
.param fop2=fop+100;
.step param RL 5 25 5
