EnesAyaz/WPTMotor/Simulations/MATLAB-SIMULINK/3-Phase-Modelling/New_models/Spice/time_domain.asc

C1: cap; 2m
C3: cap; {Cp}
C4: cap; {Cs}
D1: diode
D2: diode
D3: diode
D4: diode
L1: ind; 30m
Lp1: ind2; {Lp}
Ls1: ind2; {Ls}
R1: res; {R}
R2: res; 0.2
R3: res; 0.2
R4: res; 24
V1: voltage_us; SINE(0 {Vfsw} {fsw})
V2: voltage; SINE(0 {Vfo} {fo})
V3: voltage; SINE(0 {Vsl} {fsw-2*fo})
V4: voltage; SINE(0 {Vsh} {fsw+2*fo})
Named nets: 0
.param f=65k  
.param Lp=205u
.param Ls=51u
.param Cp 28.5n
.param Cs 115.6n
.param k= 0.40
.param fsw=80k
.param fo= 50
.options gmin=1e-10   
.options abstol=1e-10  
.options reltol=0.003  
.options cshunt=1e-15
.param R=9.5
K1 Lp1 Ls1 {k}
.tran 0 200m 50m
.param Vfsw   40
.param Vfo     78
.param  Vsl    10
.param  Vsh   10
