EnesAyaz/WPTMotor/Simulations/MATLAB-SIMULINK/3-Phase-Modelling/New_models/Spice/frequency_domain.asc

C3: cap; {Cp}
C4: cap; {Cs}
Lp1: ind2; {Lp}
Ls1: ind2; {Ls}
R1: res; {R}
R2: res; 0.2
R3: res; 0.2
V1: voltage_us; SINE(0 18 {f}); AC 1
Named nets: 0
.param f=65k  
.param Lp=205u
.param Ls=51u
.param Cp 27n
.param Cs 115.6n
.param k= 0.40
.ac lin 1000 75000 85000
.options gmin=1e-10   
.options abstol=1e-10  
.options reltol=0.003  
.options cshunt=1e-15
.step param R  10 1000 10
K1 Lp1 Ls1 {k}
