EnesAyaz/WPTMotor/(commit log)

2021-01-26 In design part, I create a 1Tx-1Rx Series-Series WPT design. For the design, to avoid overvoltage at capacitor the coupling is adjusted above the critical coupling. After the design, in the simulatio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
2021-02-04 A DC motor is added rather than RL-Load. The motor parameters are taken from the motor that we use in the lab.
2021-02-07 Impedance model of WPT-motor is created, I observe parallel resonance. However, it is not observed in simulation in 27kHz(parallel resonance). Also, transients are investigated. A presentation is add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
2021-02-15 For WPT-Motor Journal, the source file for all figures are created. The simulation also added to the folder to keep all simulations.
2021-02-18 Test results are plotted for frequency and duty cycle effect on gain. The results are as expected and comparison between simulation and experiment will be made.
    [IPT-Duty-Cycle.xlsx, IPT-freq.xlsx]
2021-02-24 Test will be repeated, the cases are created. Flow chart of test are made.
2021-03-04 Journal Figures updated
    [Capacitor_current.xlsx]
2021-03-14 presentation is added. Positive,negative and zero sequences are invesitagted.
    [DSS_Utils.obj, rtGetInf.obj, rtGetNaN.obj, rt_logging.obj, rt_main.obj, rt_matrx.obj, rt_nonfinite.obj, rt_printf.obj]
2021-03-28 journal figures versiyon 2
    [Capacitor_current.xlsx]
2021-04-05 Current-sensor band-width's problem are revealed, the blue board and Infenion motor drive will be compared. Do we control both motor and IPT?
2021-07-08 Dc-motor journal
2021-08-09 For three-phase WPT-motor topologies, some plot for positive,negative and zero sequences are taken.
2021-08-12 test results for three phase inverter- IPT are taken. A simulation is made to compare the test results. Analitic, simulation and test results are compatible. a new idea came up , we can control the I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
    [Simulation_results_VAB.xlsx]
2021-08-13 excel updated, a carrier phase shift is added and simulation results are taken.
    [Simulation_results_VAB.xlsx]
2021-08-17 For a single carrier phase shift value (40 degree), we obtain the almost constant output voltage along the all modulation index. We also validate the results experimentally.
    [Simulation_results_VAB.xlsx]
2021-08-24 Switching pattern of WPT-motor are created
2021-09-08 test results are taken for 3-phase RL load with CV of IPT.. For DC motor, transients of load changes are invesitgated.
    [New Microsoft Excel Worksheet.xlsx]
2021-09-27 calorimeter results, the loss is lower than expected.
    we think that Low current switch
2021-09-27 3-phase drawings
    [New Microsoft Excel Worksheet.xlsx]
2021-10-04 a switching diagram is created to summarized key waveforms
2021-10-11 the mathemetical modelling of BLDC
2021-10-13 For journal, figures are created and inserted in presentation
2021-10-19 for concurrent WPT, an example of she-pwm is created.
    the switching frequency is doubled, it will be investigated. if elimination of sidebands is present, a new concurrent WPT with 6.78 Mhz and 200 Khz could be investigated.
2021-11-02 mechnanical drawings for IPT is created.
    [Assembly.SLDASM, FerriteAndLoad.SLDPRT, coupling.SLDPRT, coupling.STEP, coupling.STL, coupling_erdem.STL, slice_1o4.SLDPRT, slice_load.SLDPRT]
2021-11-17 ansys update
    [loadAndcapacitor.SLDPRT, loadAndcapacitor_erdem.STL, slice_1o4.SLDPRT, winding_erdem.STL]
2021-12-02 test resukts are drawn. FFT results has been improved by taking data
    with passive probe
2021-12-11 data kurtarmaca
    [coupling_v2.SLDPRT, slip_ring_2.SLDDRW, slip_ring_2.SLDPRT]
2022-02-02 Dc motor figures
2022-02-24 DC-DC journal switching waveforms
2022-02-24 DC-DC journal switching waveforms part 2
2022-03-30 synchronous motor, Simulink files
2022-04-07 For synchronous machine, the ansys model, matlab and ltspice simulations
    also mechanic drawings
    [part1_v1.SLDPRT]
2022-04-14 Dc motor soft switching model is created
2022-04-14 DC motor journal update source files
2022-04-14 BLDC time domain analysis
2022-04-18 DC motor figure update, solid works drawing is added for SM
    [part1_v2_deneme.SLDPRT]
2022-04-20 mechanic drawings of the CSR are added
    [Assembly.SLDASM, FerriteAndLoad.SLDPRT, coupling.SLDPRT, coupling.STEP, coupling.STL, coupling_erdem.STL, coupling_v2.SLDPRT, coupling_v2.STL]
2022-04-23 switching functions is added, SVPWM analytical modelling is created
2022-04-23 solid works manufacturing files
    [coil_former_Tx.SLDPRT, coupling_v4.SLDPRT]
2022-04-23 other drawing files
    [coil_former.SLDPRT, coil_former_Tx.SLDPRT, coupling_v3.SLDPRT, denemeler.SLDPRT]
2022-05-16 DC motor revised version is added, and upload to JESTIE
2022-05-16 synchronous motor design files, SVPWM model is added
2022-07-09 Ansys DC motor windings
2022-07-09 synchronous motor WPT design
2022-08-08 power point for SM journal
2022-08-17 Thesis presentation is prepared, it should be cut in half...
2022-09-23 synchornous motor journal images and codes
2022-10-07 WPT three phase motor- old major submisson files
2022-10-07 TPEL- synchoronous motor simulink-matlab files
2022-10-19 monthly presentation and synchoronous motor experiment
    for different modulation indices, VAB is taken
    [Book1.xlsx]
2022-10-31 figures of synchronous motor journal version 2
2022-11-02 for the synchronous motor journal, figures are updated and
    source files are added
2023-02-16 synchronous motor files are added.
2023-03-10 synchronous motor submission files
2023-05-04 WPT synhronous motor major submission files
